Fawziya25/AGV_Project/电控代码/改动记录.md

# AGV 工程改动记录

> 工程不是 git 仓库，本文件代替提交记录。每次改完在下面按日期追加一节。
>
> 编译命令：
> ```bash
> PATH="C:/Users/Dawn/AppData/Local/stm32cube/bundles/cmake/4.3.1+st.1/bin:$PATH" \
>   "C:/Users/Dawn/AppData/Local/stm32cube/bundles/cmake/4.3.1+st.1/bin/cmake.exe" \
>   --build "d:/Projects/stm32/AGV_Project/build/Debug"
> ```

---

## 2026-09-14（晚）

编译验证：通过。FLASH 51304 B（9.79% / 512 KB），RAM 4400 B（3.36% / 128 KB）。
**以上均未上实车验证。**

### 1. CAN 等待函数统一（Emm_V5）

原来全工程有 7 处手写的等待，写法各不一样（有 5 处是 `while(can.rxFrameFlag == false){};`
死等，电机堵转就永久卡死）。统一成 3 个显式函数：

`HARDWARE/Inc/Emm_V5.h`
- `EMM_V5_ARRIVE_TMO_MS 5000`：等到位帧超时，需覆盖最长一段移动（GoStraight 1865mm@150RPM≈3s）
- `EMM_V5_ACK_TMO_MS 200`：等命令回帧超时，只用于确认命令已被电机接收
- 声明 `Emm_V5_ClearRxFrame()` / `Emm_V5_WaitArrive(tmo)` / `Emm_V5_WaitRxFrame(tmo)`

`HARDWARE/Src/Emm_V5.c`
- `Emm_V5_ClearRxFrame()`：发送命令前清掉历史回帧，保证等的是本次动作新到的帧
- `Emm_V5_WaitArrive(tmo)`：逐帧消费回帧，认 `FD 9F`（到位），1=到位 / 0=超时
- `Emm_V5_WaitRxFrame(tmo)`：保持原来"标志已置位→立即返回"的语义，加超时兜底
- **不做发送方地址校验**（`can.CAN_RxMsg.ExtId >> 8`），按需求省略

调用点替换：

| 文件 | 位置 | 换成 |
| --- | --- | --- |
| `UserCode/Src/chassis.c` | 直行 / 平移 | `ClearRxFrame()` + `WaitArrive(EMM_V5_ARRIVE_TMO_MS)` |
| `UserCode/Src/chassis.c` | 转弯 ×2 | `WaitRxFrame(EMM_V5_ACK_TMO_MS)` |
| `UserCode/Src/positionPIDcontroller.c` | 111、143 | 同上 |
| `UserCode/Src/yawPIDcontroller.c` | 374、397 | 同上 |
| `HARDWARE/Src/pick.c` | `Pick_StepperMove` | `ClearRxFrame()` + `WaitArrive(PICK_MOTOR_DONE_TMO)` |

**行为变化**：底盘直行/平移现在是真阻塞——等到位帧才返回（最长等 5s）；
原来 5 处死等有了 200ms 超时，堵转/未使能不再永久卡死。
地址 5/6（机械臂两个电机）的速度/加速度本来就是独立宏，不受影响。

### 2. 坐标宏导航移植（chassis / yawPIDcontroller）

从导入的 `chassis(1)` / `yawPIDcontroller(1)` 里把"坐标宏导航"这套搬进正式文件，然后
删掉了那两个 `(1)` 文件（另有 2 个 `(1)` 文件一并删除）。

`UserCode/Inc/chassis.h`
- 场地坐标宏块（逗号元组风格）：`#define Raw 1200, 300`，用法 `AGV_Position_Go(Raw, 0);`
  → `AGV_Position_Go(1200, 300, 0);`。只能整体当实参用，不能出现在赋值/运算里
- `Origin_X/Y`、`Vel 150`；新增 `AGV_Position_Set()` / `AGV_Position_Go()` 声明

`UserCode/Src/chassis.c`
- `AGV_Position_X/Y`：跟踪小车当前坐标，按 `AGV_Direction`（0:X+ 1:Y+ 2:X- 3:Y-）
  把 dx/dy 拆成"直行 + 平移"两段
- `AGV_Position_Set(x, y)`：重新锚定小车当前坐标
- 5 个路径函数（Depart_1 / Qcode_to_Raw / Raw_to_Rough / Rough_to_Temp / Temp_to_Raw /
  GoBack_1）改成调坐标宏；`Depart_2` / `GoBack_2` 未动（还是硬编码）

`UserCode/Src/yawPIDcontroller.c` / `.h`
- 新增 `uint8_t AGV_Direction`（初值 3），`AGV_TurnLeft` 里 `+1`、`AGV_TurnRight` 里 `+3`（模 4）
- `Yaw_MovingOffsetEnd()`：`MovingOffset = ...` 改成 `+= ...`
  （新的 Go() 每次转向之前会走两段位移，`=` 会把前一段的航向漂移丢掉；
  累加值在转弯消费时清零）

### 3. 取放顺序改成 A→B→C

原来是 C→B→A 倒序放置，改成先放 A 再 B 再 C。

- `UserCode/Src/pick_task.c` `PlaceToRing()`：索引约定改成 `0=POS_A, 1=POS_B, 2=POS_C`
- `Place_ROUGH()` 循环改成 `PlaceToRing(i, Place_Color[i])`
- `Place_TEMP()` 重排成 `POS_A / POS_B / POS_C` 顺序
- 槽位↔颜色配对关系不变（A↔`Place_Color[0]`、B↔`[1]`、C↔`[2]`），只是执行顺序反过来

### 4. 从 POS_B 取料时的绕行

**问题**：A→B→C 顺序下取 B 时，C 槽还装着料。夹着物块直接转向会扫到 C 上的物块。
根因是 `Pick_MoveTo` 是门字形——半径只发指令不等回执，同时就开始转 Z；
Z 以 0.8°/2ms 转，约 0.12s 就扫过 C 的 44°，此时半径才出去不到 1/4，必然撞。

**做法**：先将物块移到车外过渡位（半径伸出去、转过 C 的角度），再按普通门字形走到圆环。

`HARDWARE/Inc/pick.h`
- `POS_C_OUT (60.0f, 7.0f, 50.0f)`：车外过渡位。60° 已转过 C 的 44°，
  半径 50 时物块径向在 35~65，C 上的物块在半径 4 附近（-11~19），径向不重叠
- 声明 `Pick_Safe_MoveTo(float servoZ, float motorZ_mm, float motorR_mm)`

`HARDWARE/Src/pick.c`
- 新增 `Pick_Safe_MoveTo()`：**依次** 高度 → 半径 → Z 旋转，每步都等到位再走下一步
  （与 `Pick_MoveTo` 的区别就是半径"等到位"这一步）
- 新增静态 `Pick_MotorR_MoveToMM_Wait()`：带等到位的半径移动
- `Pick_MoveTo()` / `Pick_MotorR_MoveToMM_Issue()` 一行未改

`UserCode/Inc/pick_task.h`（这几个宏在下面的第 5 节里已经改成静态函数，名字见第 5 节的对照表）
- `MOVE_TO_RING_BYPASS(ring)` / `MOVE_TO_RING_HIGH_BYPASS(ring)`：
  `Pick_Safe_MoveTo POS_C_OUT;` 然后按 ring 选 `POS_x` / `POS_x_HIGE`
- `GRAB_AND_PLACE_TO_RING_EX_BYPASS(grab_pos, ring, is_high)`

调用点：只有"取 B 那一趟"用绕行版
- `PlaceToRing()` 里 `if(index == 1) MOVE_TO_RING_BYPASS(ring); else MOVE_TO_RING(ring);`
- `Place_TEMP()` 里 `GRAB_AND_PLACE_TO_RING_EX_BYPASS(POS_B, Place_Color[1], is_high);`

取 A 是反向路径（326°→230/184/138 角度递减，不经过 B、C），取 C 时 A、B 已空，
这两趟都走普通 `MOVE_TO_RING`。

耗时：绕行只多一次串行等待（高度 + 半径，合计约 0.55s），之后转向（226° 约 1.1s）
仍是单独的 Z 舵机转动，每趟总时长与非绕行路径基本一样（约 2.7s）。

### 5. 夹取逻辑的动作宏改成静态函数

`pick_task.h` 里原来有 9 个 `do{...}while(0)` 动作宏，把"移到环→夹→移到槽→松手"
这类含多次阻塞等待的动作序列藏在宏名后面：调试器没法单步进去、参数传不进函数、
`GRAB_AND_PLACE_TO_RING(grab_pos, ring)` 与 `GRAB_FROM_RING_AND_PLACE(ring, place_pos)`
参数顺序还相反。全部删掉，换成 `pick_task.c` 里的 5 个静态函数：

| 新静态函数 | 替掉的宏 |
| --- | --- |
| `GotoSlot(slot)` | 三处重复的 `switch(index)` |
| `MoveToRing(ring, high, bypass)` | `MOVE_TO_RING` / `_HIGH` / `_BYPASS` / `_HIGH_BYPASS` |
| `GrabSlotToRing(slot, ring, high)` | `GRAB_AND_PLACE_TO_RING` / `_EX` / `_EX_BYPASS` |
| `GrabRingToSlot(ring, slot)` | `GRAB_FROM_RING_AND_PLACE` |
| `GrabRawToSlot(slot, color)` | `GrabToPosition` + `Pick_RAW_PLUS` 里的 switch |

约定写进 `pick_task.h` 头注释：**槽位 slot = 0(A)/1(B)/2(C)**，与 `Place_Color[]`/`Pick_Color[]`
下标一致；**圆环 ring = 1/2/3**。绕行判断从调用点收进 `GrabSlotToRing`（`slot == 1` 自动绕行）。

调用点变成一行一件事：

```c
for (int i = 0; i < 3; i++) GrabSlotToRing(i, Place_Color[i], 0);   /* Place_ROUGH */
for (int i = 0; i < 3; i++) GrabRingToSlot(Place_Color1[i], i);     /* Pick_ROUGH  */
```

`task.c` 与底盘代码一行未动（公共函数名 `Pick_RAW`/`Place_ROUGH`/`Pick_ROUGH`/`Place_TEMP` 不变）。
编译：FLASH 50484 B（比改动前少 820 B，宏展开的重复代码没了），RAM 4400 B。

`pick.h` 里的 24 个位置宏（`POS_A` 等）**没动**——它们是"逗号元组当参数表"的写法，
`Pick_MoveTo POS_A;` 这样用是清楚的；现在 `Pick_MoveTo POS_x;` 只出现在 `GotoSlot()`/`MoveToRing()`
两个函数里，等于被隔离在一处。代价是位置不能当函数参数传（想改成
`typedef struct { float z, h, r; } PickPos;` + `Pick_Goto(&POS_A)` 的话约 50 处调用点要动，
含 `task.c`/`main.c`，暂不做）。

### 7. B 取料绕行改成两次普通 Pick_MoveTo（去掉专用函数）

用户的决定：不要专用函数，B 那一趟就是两次普通 `Pick_MoveTo`。

```c
/* pick_task.c : MoveToRing() */
if(bypass) Pick_MoveTo POS_C_OUT;   /* 先到车外过渡位 */
if(ring == 1) Pick_MoveTo POS_1;    /* 再到目标圆环 */
...
```

删掉的东西：
- `HARDWARE/Src/pick.c` 的 `Pick_Safe_MoveTo()`（"高度→半径→转向，每步等到位"那版）
- `HARDWARE/Src/pick.c` 的 `static Pick_MotorR_MoveToMM_Wait()`（带等到位的半径移动）
- `HARDWARE/Inc/pick.h` 里 `Pick_Safe_MoveTo()` 的声明

**注意两点**（改完的行为）：
1. 半径从此**没有任何等待**：`Pick_MoveTo` 走门字形，半径只发指令不等，同时就转 Z。
   `POS_C_OUT` 的"先伸半径再转向"语义没了 —— 转向开始时半径还没伸出去。
   实车若在绕行时扫到 C 槽的物块，就得回到"半径等到位再转"的做法。
2. 第 6 节那套"按运动时间估算超时"(`Pick_MoveTimeMs` + 三个裕量宏)已经被移除，
   `Pick_StepperMove()` 又用回固定的 `PICK_MOTOR_DONE_TMO 2500ms`。
   高度电机(5 号)回帧正常，帧一到就返回，所以实际不会等满；
   6 号半径电机不回帧这件事现在不影响主流程（半径不再等人）。

编译：FLASH 50240 B、RAM 4400 B。

---

## 2026-09-15 —— 修「放到 A 位时不下降、超时后放下」

> **本节改动已被用户整体回退（2026-09-16）**：下面提到的 `Pick_WaitArrive()`、超时重试、
> 四个诊断变量、`pick_motorZPos` 的"只有真到位才推进"在当前代码里都不存在了。
> 本节仅作分析记录保留，别照它去核代码。

**症状**：每次 `Pick_MoveTo POS_A`（326°, 31mm, 4mm），臂停在安全高度不下降，
烧掉 `PICK_MOTOR_DONE_TMO 2500ms` 超时后夹爪松开；B/C 正常。

**已排除**（代码层面）：A/B/C 三个宏的高度/半径完全一样（31mm / 4mm），
高度这一路的脉冲数、方向、速度、加速度字节也完全一样，
所以不是"高度代码对 A 特殊"，是 A 的**姿态**(326° 是整个程序里最大的角度，
且 A 永远是正向转过去)把某一步弄坏了。

**改动**（`HARDWARE/Src/pick.c`，正常路径不增加任何耗时）：

1. 新增 `static uint8_t Pick_WaitArrive(tmo)`，替代直接调 `Emm_V5_WaitArrive()`：
   同样是逐帧消费、**不校验地址**（没动 Emm_V5.c，四轮不受影响），
   区别是把三种回帧分开：`0xFD 0x9F`=到位 / `0xFD 0xE2`=电机拒收本命令 / 超时。
2. `Pick_StepperMove()` 返回值从"本次脉冲数"改成等待结果；**只有在被拒(0xE2)时
   隔 `PICK_RETRY_GAP_MS 50ms` 原样重发一次**。被拒说明电机没动，重发不会走过头；
   超时**不**重发 —— 相对位置模式(raF=2)下无法判断电机到底走没走，盲目重发会多走一段。
3. `Pick_MotorZ_MoveToMM()`：**只有真到位才推进 `pick_motorZPos`**。
   原来不管到没到位都写目标值，A 位超时一次跟踪值就偏 24mm
   （MCU 以为在 31mm、实际停在 7mm），下一步"升到安全高度"会多顶 24mm 撞上限，
   又是一次 2.5s 超时 —— 这是让症状"每次都出现"的放大器。
   改完 A 这一趟失败不会污染后面的 B/C。
4. 新增诊断变量（`pick.c` 定义 / `pick.h` 声明）：
   `Pick_Diag_RejectCnt`（被拒次数）、`Pick_Diag_TimeoutCnt`（超时次数）、
   `Pick_Diag_LastRx0/1`（最近一帧前两字节，正常=Fd 9F）、`Pick_Diag_LastAddr`（回帧电机地址）。
   调试器 watch 或 OLED 显示，跑一趟就能判断属于哪一类：
   - 被拒计数↑ → 命令发下去时电机还在上一次运动里（时序问题，重发已兜住）
   - 超时↑ 且回帧是 `FD 02` → 命令被接收了但没走到位 → 机械卡住/负载大
   - 超时↑ 且完全没有回帧 → 命令没到电机 → CAN 丢帧 / 供电瞬时跌落
     （326° 上 Z 舵机顶住时堵转电流拉低 5V 是重点怀疑对象）

编译：FLASH 50516 B、RAM 4408 B。

**未实车验证。**

**下一步实车测**：跑一趟 `Pick_ROUGH`/`Pick_RAW`，看上面 4 个变量。
若"超时↑ 且回帧 FD 02" → 是机械/负载问题，量一下 326° 处 Z 舵机是不是顶住了；
若"被拒计数↑ 但 A 降下去了" → 就是时序，本节的改动已经修好。

---

## 2026-09-16 —— pick_task.h 宏恢复、A 槽过渡位、暂存区码垛映射、取料顺序 A→B→C

本节四件事都做在 `UserCode/Src/pick_task.c` / `UserCode/Inc/pick_task.h` /
`HARDWARE/Inc/pick.h` 上，是 9-14 那套静态函数重构**回退之后**、在宏版本上做的。

### 1. `pick_task.h` 宏块恢复（编译修复）

回退时 `pick_task.h` 退多了一代：只剩函数声明，`MOVE_TO_RING` / `MOVE_TO_RING_HIGH` /
`GRAB_AND_PLACE_TO_RING` / `GRAB_AND_PLACE_TO_RING_EX` / `GRAB_FROM_RING_AND_PLACE`
五个宏没了，而 `pick_task.c` 还在用 → `implicit declaration of function 'MOVE_TO_RING'`。
从文件历史 v6 原样恢复这 5 个宏，`pick_task.c` 没动，编译通过。

### 2. A 槽取料的车外过渡位 `POS_A_OUT`

`pick.h` 新增 `#define POS_A_OUT (30.0f, 7.0f, 58.0f)`（30° / 7mm / 半径 58mm）：
A 槽在 4°，转去圆环(138~230°)要经过 B 槽(44°)，先把半径伸到车外再转，避开 B 槽。
只在"从 A 拿"那一趟多插一句，A 之外的 B/C 两趟完全不变：

- `PlaceToRing()`（`Place_ROUGH` 用）：`if(index == 2) { Pick_MoveTo POS_A_OUT; HAL_Delay(1000); }`
- `Place_TEMP()`：A 那趟**长写**（宏里插不进这一句，所以没走 `GRAB_AND_PLACE_TO_RING_EX`）：
  `Pick_MoveTo POS_A; Pick_Gripper_Grab(); Pick_MoveTo POS_A_OUT; HAL_Delay(1000); ...`
  —— 以后改 `GRAB_AND_PLACE_TO_RING_EX` 时别忘了这处不同步。

### 3. 暂存区第二轮：按第一轮「颜色→环位」同色同环码垛

第二轮 `Place_TEMP` 的环号不再用第二轮任务码 `Place_Color2[]`，改成按颜色反查第一轮
（例：第一轮 4 号色放在 2 号环 → 第二轮 4 号色也放 2 号环的高位）：

```c
static uint8_t Place_RingSameAsLastRound(uint8_t slot)   /* pick_task.c 里的静态小函数 */
{
    for (uint8_t j = 0; j < 3; j++)
        if (Pick_Color1[j] == Pick_Color2[slot]) return Place_Color1[j];
    return Place_Color2[slot];      /* 兜底：两轮颜色种类一致，正常不会到 */
}
/* Place_TEMP 里 */
uint8_t ring_reuse[3];
for (int i = 0; i < 3; i++) ring_reuse[i] = Place_RingSameAsLastRound(i);
uint8_t *Place_Color = (RerunFlag == 0) ? Place_Color1 : ring_reuse;
```

第一轮那支路不变；高位仍由已有的 `is_high = (RerunFlag == 1)` 管，没动；
三趟放置的调用一行没改。`Place_ROUGH`（粗加工区）第二轮照旧用 `Place_Color2`，**按用户要求不动**。
前提：两轮任务码的颜色种类一致（用户确认），且每轮三色互不相同 → `ring_reuse` 必是 1/2/3
的一个排列，不会两块物块抢同一个环。

### 4. `Place_ROUGH` / `Place_TEMP` 取料顺序改回 A→B→C

原来是 C→B→A（`Place_Color[2-i]`）。现在：

```c
/* Place_ROUGH：只有 PlaceToRing 的 index 带 2-i（2=A,1=B,0=C），环号下标 i 始终是槽位下标 */
for (int i = 0; i < 3; i++) {
    PlaceToRing(2 - i, Place_Color[i]);
}
/* Place_TEMP：A 那趟(带 POS_A_OUT)提到最前，然后 B、C */
```

配对是"槽位下标 i ↔ `Place_Color[i]`"（与 `Pick_ROUGH` / `Place_TEMP` / `Pick_Color[]` 同一套约定），
A→B→C 的遍历顺序等于把原代码 `PlaceToRing(i, Place_Color[2-i])` 里的 `2-i` 从环号挪到 index 上。
第 3 节的匹配按下标取，不受影响；每个环只落一块，环上的叠放结果与顺序无关。

> **中途返工（当天）**：第一次改时把 `2-i` 用在了环号上（`PlaceToRing(slot, Place_Color[slot])`），
> 等于 A 槽配到 `Place_Color[2]`、C 槽配到 `Place_Color[0]`，A/C 互换 —— 实车表现为
> "一次 place 再一次 pick 之后，物块装进了对方的槽位"。已改回上式，`Pick_ROUGH` 未动。

编译：FLASH 51124 B、RAM 4400 B（比上一条大是因为 `task.c` 的 `STANDALONE_TEST`
已由用户改成 0、整个状态机编入，与本节改动无关）。

**未实车验证。**

### 遗留（本次看到但没动）

- ~~`Pick_ROUGH()` 写死用 `Place_Color1[]` 当环号~~ —— **已修（2026-09-18）**，见下节。
- 反方向（`Pick_ROUGH` 从圆环放回 A 槽）同样要经过 B 槽(44°)，没加过渡位。

---

## 2026-09-18 —— `Pick_ROUGH` 按轮次选数组（修第二轮暂存区不同色）

只改 `UserCode/Src/pick_task.c` 的 `Pick_ROUGH()` 一个函数体。

### 问题链条

第二轮（`RerunFlag == 1`）三个函数用的数组原本是：

| 步骤 | 数组 | 说明 |
| --- | --- | --- |
| `Pick_RAW` | `Pick_Color2` ✓ | 槽 i = `Pick_Color2[i]`（本来就是按轮次选的） |
| `Place_ROUGH` | `Place_Color2` ✓ | 槽 j 的料 → 环 `Place_Color2[j]` |
| **`Pick_ROUGH`** | **`Place_Color1` ✗** | 环 `Place_Color1[i]` → 槽 i |
| `Place_TEMP` | `ring_reuse[i]` =「颜色 `Pick_Color2[i]` 第一轮在哪个环」 | 前提是槽 i 里真是 `Pick_Color2[i]` |

`Pick_ROUGH` 这一环错位以后，槽里的**颜色被置换**：两轮的放置数字都是 1/2/3 的一个排列时，
三个环仍都会被取空（不会夹空、也没环剩下料），但颜色和槽位对不上，
于是 `Place_TEMP` 按"槽 i 是 `Pick_Color2[i]`"算出来的 `ring_reuse[i]` 就是错的
→ 第二轮码垛和第一轮**不同色同环**。

举例（`Pick_Color1={4,5,6}`、`Place_Color1={2,3,1}`；`Pick_Color2={6,4,5}`、`Place_Color2={1,2,3}`）：
第二轮 `Place_ROUGH` 是 A 槽 6 号→环1、B 槽 4 号→环2、C 槽 5 号→环3，
可 `Pick_ROUGH` 取的是 环2→A、环3→B、环1→C，结果 A 槽拿到 4 号、B 槽 5 号、C 槽 6 号。
接着 `Place_TEMP` 让 A 槽去环1高位（6 号第一轮的位置），可 A 槽手里是 4 号
→ 放到环1，而第一轮 4 号在环2，**同色同环失败**。

### 改动

```c
void Pick_ROUGH(void)
{
    extern uint8_t Place_Color1[3];
    extern uint8_t Place_Color2[3];
    extern uint8_t RerunFlag;
    uint8_t *Place_Color = (RerunFlag == 0) ? Place_Color1 : Place_Color2;

    GRAB_FROM_RING_AND_PLACE(Place_Color[0], POS_A);
    GRAB_FROM_RING_AND_PLACE(Place_Color[1], POS_B);
    GRAB_FROM_RING_AND_PLACE(Place_Color[2], POS_C);

    Pick_MoveTo POS_RUN;
}
```

和 `Place_ROUGH` 同一套三目写法——"放置用哪个数组、拾取就用哪个数组"是取放配对的**不变量**
（一次 place + 一次 pick 后槽位内容不变，才谈得上后面按颜色同环码垛）。
配对（环 `Place_Color[i]` ↔ 槽 i）与遍历顺序（A→B→C）都没变；第一轮 `RerunFlag==0`
走 `Place_Color1`，行为与改前完全一致；`STANDALONE_TEST==1` 那条测试路径 `RerunFlag=0` 也不受影响。

改完链条闭合：第二轮 `Pick_ROUGH` 取环 `Place_Color2[i]` → 槽 i 重新等于 `Pick_Color2[i]` →
`Place_TEMP` 查到的就是槽里真实的颜色 → 同色同环、高位。

编译：FLASH 51192 B（改前 51124 B，多 68 B，是多进来一个 `Place_Color2` 的外部引用和一次三目），
RAM 4400 B。

**未实车验证。**

---

## 2026-09-18（二）—— 视觉等待窗口改成只卡 y 下界

改 `UserCode/Src/camera.c`（+ `camera.h` 注释）。**判稳逻辑一行没动**：盒子/穿盒/QUIET/
超时、`requireMotion` 的"先看到在动再停稳"边沿语义都原样，只有"接近可抓区"窗口的条件变了。

### 改动

原来是 `|dx|,|dy| <= 45` 的对称方框（`CAM_NEAR_WIN_PX 45`），现在按用户要求
改成**单边**：只要 `target_dy > -55`，**dx 不再限制**。

`camera.c`
- `#define CAM_NEAR_WIN_PX 45` → `#define CAM_NEAR_WIN_Y_MIN (-55)`
- `Cam_WaitSettle()` 第一个参数从 `int16_t winPx`（0=不限位置）改成 `uint8_t nearWin`
  （1=用上面那个窗口），判断从四边比较变成一句：

```c
if(nearWin && target_dy <= CAM_NEAR_WIN_Y_MIN)   /* 还在窗下界之外 → 不算稳, 等它进窗 */
{
    quietSince = HAL_GetTick();
    continue;
}
```

- 三个调用点：`WaitForStill(0,1)`（不变）、`WaitForMoveNearStill(1,1)`、`WaitForNearStill(1,0)`
  —— 后两个（`Pick_RAW` 和 `GrabToPosition` 用的）窗口一致。

`camera.h`：两个函数的注释从"落在中央窗口内"改成"y 进窗(target_dy > CAM_NEAR_WIN_Y_MIN)"。

### 副作用（有意为之 / 需留意）

- 抓取前那一步**不再要求 x 居中**。`Pick_RAW_PLUS`（pick_task.c:99-101）本来就是拿 `target_dx`
  的正负选 `POS_RAW` / `POS_RAW_LEFT` / `POS_RAW_RIGHT`，x 不限制与那套分支是一致的。
- `GrabToPosition()`（pick_task.c:15-30）在这之后直接去 `POS_RAW` 抓，没有按 dx 分支，
  x 偏差大时靠机械容差兜；如果实车发现偏着抓不到，说明这里要补和 `Pick_RAW_PLUS` 一样的分支。
- `target_dy == -999`（无目标）在进窗口判断之前就被"目标丢失"那一支处理掉了，不受影响。

编译：FLASH 51140 B（比上一条少 52 B，窗口判断从四条比较缩成一条），RAM 4400 B。

**未实车验证。**

---

## 2026-09-18（三）—— 重写 `Pick_RAW_PLUS`：修正基准改成"追第一块从运动到静止的物块"

只改 `UserCode/Src/pick_task.c`（`camera.c` / `camera.h` / `pick_task.h` / `pick.*` /
`task.c` 一行未动，也没加 include —— `Pick_RAW_PLUS` 的声明本来就在 `pick_task.h:71`）。

### 为什么改

`Pick_RAW`（当前主流程用的）**固定切到 `Pick_Color[2]`** 再等它"进窗+停稳"才修正：
那块要是没进窗，`Cam_WaitForMoveNearStill` 会白等（内部 30s 超时）。PLUS 的思路是
**不看颜色**，追"视野里第一块从运动到静止的物块"来做那一次位置修正 —— 反正三块料都
由同一个转盘送到同一个抓取位，用哪块做的修正等价。

### 修正阶段（两部分）

```c
t_start = now;
步骤1(快路径): target = ScanNearestColor();           /* 问一次"现在最近的是哪一色" */
              SwitchTo(target) 成功 → TrackOneColor()
                == TRK_ARRIVED → AGV_Correct() → corrected = target
步骤2(兜底):   while (没修正 && now - t_start < PICK_ARRIVE_TMO_MS) {
                   target = WaitNearestChange(target);   /* 反复扫描, 等"最近色换人" */
                   SwitchTo(target); TrackStillInWindow();  /* 新色只判"进窗+静止" */
                   成立 → AGV_Correct() → corrected = target
               }
```

- **步骤1 的判据是"边沿"**：必须"看到过在动 → 连续 300ms 没再动 → 且 `dy > -58`"才算到站
  （`TRK_ARRIVED`）。看到在动却 `dy` 掉出窗口区 = 出窗跟丢了（`TRK_LEFT_WINDOW`）；
  进来 400ms 一次都没动 = 本来就静止的旧料（`TRK_WAS_STILL`）→ 两者都进步骤2 换下一块。
- **步骤2 的新色只判稳态**（`TrackStillInWindow`，等于 camera.c 的 `Cam_WaitForNearStill`：
  "窗口区内 + 连续静置 300ms"，**不要求先看到运动**）——因为它可能已经停好了，
  要求运动边沿会让它白等，这是本次专门按用户要求做的区分。
- **总预算 `PICK_ARRIVE_TMO_MS 20000` 是硬超时**：三个等待循环（`WaitNearestChange` /
  `TrackOneColor` / `TrackStillInWindow`）都带同一个 deadline，到点必退 —— 所以没有直接
  用 `Cam_WaitForNearStill()`（它内部自带 30s 且不可打断，会把 20s 预算顶穿）。
  到点没修成也照常进抓取阶段，每块由 `GrabToPosition` 自己等。

### 抓取阶段

顺序仍是按任务码 `Pick_Color[0]→[1]→[2]` 放进 A/B/C 槽。唯一的区别：**若修正用的
正是 `Pick_Color[0]`，它此刻就在窗内静止 → 直接 `POS_RAW` 抓**，不再回观察位等一次；
其余每一块都走现成的 `GrabToPosition(i, Pick_Color[i])`（一行未改）。
老 PLUS 里那套按 `target_dx` 选 `POS_RAW`/`POS_RAW_LEFT`/`POS_RAW_RIGHT` 的分支**去掉**了
（`AGV_Correct` 的退出判据是连续 4 拍 `|dx|,|dy| <= 1px`，修完 dx 已经≈0）。

### 新增（都是 `pick_task.c` 文件内的 static，不导出）

| 名字 | 作用 |
| --- | --- |
| `Pick_Color_List()` | 返回本轮 `Pick_Color1/2` 指针（省掉 4 处 `RerunFlag` 三目） |
| `ScanNearestColor()` | 扫一次三色，返回"最近的色号"或 `PICK_COLOR_NONE` |
| `WaitNearestChange(cur, t_start)` | 反复扫描直到"有效色且 != cur" |
| `TrackOneColor(t_start)` | 追踪当前色，返回 `TRK_ARRIVED`/`TRK_LEFT_WINDOW`/`TRK_WAS_STILL` |
| `TrackStillInWindow(t_start)` | 等"当前色进窗+静止"（只判稳态），带 deadline |

文件内新宏：`PICK_ARRIVE_TMO_MS 20000` / `PICK_TRACK_TMO_MS 3000` /
`PICK_TRACK_STILLOBS_MS 400` / `PICK_TRACK_SCAN_GAP_MS 100` / `PICK_TRACK_BOX_PX 2` /
`PICK_TRACK_QUIET_MS 300` / `PICK_WIN_Y_MIN (-58)` / `PICK_COLOR_NONE` / 三个 `TRK_*`。
`PICK_TRACK_BOX_PX`、`PICK_TRACK_QUIET_MS`、`PICK_WIN_Y_MIN` 与 camera.c 里的
`CAM_STILL_BOX_PX`、`CAM_STILL_QUIET_MS`、`CAM_NEAR_WIN_Y_MIN` **取同值**
（那几个宏是 camera.c 文件内的，这里用不到），**改一边要同步另一边**。

### 几个刻意为之的坑（别当成 bug 改掉）

1. `ScanNearestColor()` 扫之前**先清 `Cam_RxFlag`，扫完还是 0 就返回"没料"** ——
   `Cam_SwitchCloseColor()` 在"三色全切换失败"时会提前返回（不做最后那次切换），
   此时 `openmv_cmd` 和 `target_dx/dy` 都是**冻结的旧值**，看着完全合法。
2. **三色都不可见时 `Cam_SwitchCloseColor()` 仍会切到 `Pick_Color[0]` 并回显它**，
   所以"回显色 0"有歧义，只有 `target_dy == -999` 能识破 → 这一步不能省。
3. `TrackOneColor` 里"出窗"的判据是 **`wasInWin && dy <= -58`**（进过窗又出去）。
   只写 `dy <= -58` 会把"从窗外正在进窗"的物块误判成出窗。
4. 停在窗口区**之外**的物块不算到站，会走满 `PICK_TRACK_TMO_MS 3000` 后按"跟丢"换新色。

### 顺带

`Cam_WaitForStill()`（只判稳态、不限位置）原本只有老 `Pick_RAW_PLUS` 调用，
现在无人调用 → 被 `--gc-sections` 回收，`camera.c` 里函数本体保留、未删。

编译：FLASH 51132 B（改前 51140 B，反而少 8 B —— 新代码多，但 `Cam_WaitForStill`
被回收 + 老 PLUS 的 `POS_RAW_LEFT/RIGHT` 分支没了）、RAM 4400 B。无警告。

**未实车验证。** 实车重点看：`ScanNearestColor` 返回的色号和 OLED 上 `openmv_cmd`
是否一致；`TRK_ARRIVED`/`TRK_WAS_STILL` 哪一条常触发（决定要不要调
`PICK_TRACK_STILLOBS_MS`）；转盘一个停顿窗口有多长（决定 20s 够不够、扫描一遍
~0.3s 的节奏跟不跟得上）。

---

## 2026-09-18（四）—— `HWT101_ManualCal()` 加 OLED 倒计时、时长 40s 改回 20s

文件：`HARDWARE/Src/hwt101.c`（另加 `#include "oled.h"`）。

### 原来的三个问题

```c
HAL_Delay(20000);
for(int i=0;i<20;i++)
{
    HAL_Delay(1000);
    OLED_ShowString(0, 0, "%d",  "零偏校准中...",i);
}
```

1. **参数错位**：`OLED_ShowString(u8 x, u8 y, u8 *chr, u8 size1, u8 mode)`。
   上面把 `"%d"` 当字符串、把汉字指针截成 `size1`、把 `i` 当 `mode`。
2. **没有刷新**：`OLED_ShowString` 只写 `OLED_GRAM` 显存，必须配 `OLED_Refresh()`
   才推到屏上；另外 `OLED_ShowString` 内部按 `*chr>=' ' && *chr<='~'` 过滤，
   **画不了汉字**（要汉字得用 `OLED_ShowChinese(字模序号)`）。
3. **时长是 40s**：`HAL_Delay(20000)` + `20×HAL_Delay(1000)`，比标定窗口多一倍。

### 改动

新增文件内宏 `HWT101_MANCAL_SEC 20U`，函数体改成：

```c
ZeroBias_Start();
HWT101_ManualCalStart();

OLED_Clear();
OLED_ShowString(0, 0, (uint8_t *)"Calibrating", 16, 1);
/* 16号字宽8px, 两位数字共16px, 居中放在第2行: x=(128-16)/2=56 */
for(uint8_t sec = HWT101_MANCAL_SEC; sec > 0U; sec--)
{
    OLED_ShowNum(56, 16, (uint32_t)sec, 2U, 16U, 1);
    OLED_Refresh();
    HAL_Delay(1000);
}
OLED_ShowNum(56, 16, 0U, 2U, 16U, 1);   /* 收尾显示 00, 表示窗口走完 */
OLED_Refresh();

HWT101_ManualCalStop();
ZeroBias_End();
```

- 第 1 行 `Calibrating`，第 2 行居中两位倒计时 20→01，结束显示 `00`。
- 静态字只画一次、每秒只重画数字，不用整屏 `OLED_Clear`（否则每秒闪一次）。
- `ZeroBias_Start/ManualCalStart` 在最前、`ManualCalStop/ZeroBias_End` 在最后不变；
  窗口 20s 在 100Hz 下约 2000 个样本，远超 `ZB_MIN_SAMPLES`。
- `OLED_Refresh()` 是软件 I2C 推 1KB，本身几十毫秒，所以这 20 秒实际会略长一点，
  对零偏窗口无害。
- 调用时机没问题：`AGV_Init()` 里 `OLED_Init()` 在最前，`HWT101_Init()` 在其后。

编译：FLASH 53008 B（10.11%）、RAM 4400 B，无警告。
（比上次 51132 B 大，主要因为 `task.c:95` 已经改成调 `Pick_RAW_PLUS()`，
PLUS 整块代码被链进来了。）

**未实车验证。**

---

## 2026-09-18（五）—— `AGV_QRcode_WaitForScan()` 加 15s 倒计时 + 保底串

文件：`HARDWARE/Src/QRcode.c`（只改这一个函数 + 顶部两个宏/常量，`QRcode_Task()` 没动）。

### 为什么

原来 `HAL_UART_Receive(&huart2, QRcode_Buffer, 15, HAL_MAX_DELAY)` 是**无限等**：
扫码枪没响应（没插、没对上、纸面脏）时主流程就永远卡在这一句，后面全部不动。
另外一次要 15 字节也没法"等一半就走人"。

### 改动

```c
#define QRC_WAIT_SEC  15U
static const uint8_t QRC_FALLBACK[16] = "123+123+123+123";
```

`AGV_QRcode_WaitForScan()` 改成逐字节收 + 每秒倒计时：

```c
for(uint8_t sec = QRC_WAIT_SEC; (sec > 0U) && (got < 15U); sec--)
{
    OLED_ShowString(0, 0, (uint8_t *)"Scan QR...", 16, 1);
    OLED_ShowNum(0, 16, (uint32_t)sec, 2U, 16U, 1);
    OLED_Refresh();

    uint32_t tSec = HAL_GetTick();
    while(((HAL_GetTick() - tSec) < 1000U) && (got < 15U))
    {
        uint32_t left = 1000U - (HAL_GetTick() - tSec);
        if(left == 0U) break;
        if(HAL_UART_Receive(&huart2, &QRcode_Buffer[got], 1U, left) == HAL_OK) got++;
    }
}
if(got < 15U) { /* 整串换成 QRC_FALLBACK */ }
QRcode_Buffer[15] = '\0';
QRcode_ParseResult();
```

- **逐字节**收而不是一次要 15 字节：这样"收到几字节"明确，秒到点能干净退出；
  收全 15 字节立刻返回，不用等满 15 秒。
- 第 1 行 `Scan QR...`，第 2 行两位倒计时 15→01；结果用 32 号字打在 y=0/y=32，
  正好整行盖掉倒计时，不会留残字。
- **超时/只收到半截**（`got < 15`）→ 整串换成保底串，再照常解析 → 四个数组都是 `{1,2,3}`，
  后面流程一定拿得到值。分隔符解析时本来就不校验（只按下标 0-2/4-6/8-10/12-14 取值），
  所以 `+` 和 `,` 等效。保底内容取 123 循环，OLED 上一眼能认出。
- 本工程 HAL 的 `HAL_UART_Receive` 不做 ORE 检查、超时后 `RxState` 回 `READY`，
  所以可以安全地反复用短超时调用。
- 已知盲区：`OLED_Refresh()` 是软件 I2C 推 1KB，每秒有几十毫秒没在收串口；
  这期间若正好来数据会少收几个字节 → 归到"半截"分支 → 用保底串，不会解析出错值。
  原代码没有这个盲区（一直挂着收），但代价是无限死等。

编译：FLASH 53224 B（10.15%）、RAM 4400 B，无警告。**未实车验证。**

---

## 2026-09-18（六）—— 窗口判据从「y > -58」改成「|y| < 55」

文件：`UserCode/Src/pick_task.c`、`UserCode/Src/camera.c`、`UserCode/Inc/camera.h`。

### 改动

原来是"只卡 y 下界"：`target_dy > -58`（dx 不限）。现在改成对称带：`|target_dy| < 55`，dx 仍不限。

宏改名成"半宽"语义，并加一个判据宏（4 个比较点不再各写一遍）：

| 文件 | 旧 | 新 |
|---|---|---|
| `pick_task.c:97` | `PICK_WIN_Y_MIN (-58)` | `PICK_WIN_HALF_PX 55` + `PICK_IN_WIN(dy)` |
| `camera.c:183` | `CAM_NEAR_WIN_Y_MIN (-58)` | `CAM_NEAR_WIN_PX 55` + `CAM_IN_WIN(dy)` |

```c
#define PICK_WIN_HALF_PX   55
#define PICK_IN_WIN(dy)  (((dy) > -PICK_WIN_HALF_PX) && ((dy) < PICK_WIN_HALF_PX))
```

替换的 4 处判据（`pick_task.c`）：

```c
TrackOneColor:
  if(PICK_IN_WIN(target_dy)) wasInWin = 1;                    /* 原 dy > -58 */
  if(wasInWin && !PICK_IN_WIN(target_dy)) return TRK_LEFT_WINDOW;   /* 原 dy <= -58 */
  if(sawMotion && PICK_IN_WIN(target_dy) && quiet >= QUIET) return TRK_ARRIVED;
TrackStillInWindow:
  if(PICK_IN_WIN(target_dy) && quiet >= QUIET) return 1;
```

`camera.c` 的 `Cam_WaitSettle()` 同步改成 `if(nearWin && !CAM_IN_WIN(target_dy))`，
`camera.h` 的注释跟着改。两个文件的阈值仍然取同值，`pick_task.c` 顶部注释里的对应关系
已更新为 `PICK_WIN_HALF_PX <-> CAM_NEAR_WIN_PX` —— **改一处要同步改另一处**。

### 行为变化（要留意的）

1. **上界从"无限"变成 55**：以前 `dy = 200`（物块在画面下方很远）也算到站，
   现在 `dy >= 55` 一律不算 → 修正的触发点被压到画面竖直中段 ±55px 内。
   更严格，但"20s 内一直没等到 |dy| < 55"的概率上升 → 更容易走 `PICK_ARRIVE_TMO_MS` 超时。
2. **`TRK_LEFT_WINDOW`（情况B 出窗跟丢）现在两个方向都会触发**：以前只在 dy 往下掉出
   窗时触发，现在物块往画面下方或上方离开 ±55 都算 → 会更早换色重新追。
3. `dx` 依旧不参与判断，左右偏差照旧交给 `AGV_Correct()` 闭环。

编译：FLASH 52960 B（10.10%）、RAM 4400 B，无警告。**未实车验证**，实车重点看第 1 条超时率。

---

## 2026-10-03 —— 扫码枪从 USART2 换到 USART3(PB10/PB11)

文件：`STM32F407_CAN_CMD.ioc`、`Core/Src/usart.c`、`Core/Inc/usart.h`、`Core/Src/main.c`、
`HARDWARE/Src/QRcode.c`。

### 本次串口分工

| 串口 | 用途 | 引脚 | 波特率 |
|---|---|---|---|
| USART1 | OpenMV 视觉 | PA9 / PA10 | 9600 |
| **USART3** | **二维码扫码枪（本次迁入）** | **PB10(TX) / PB11(RX)** | **9600** |
| UART4 | 预留（后续可能给雷达） | PC10(TX) / PC11(RX) | 115200 |
| UART5 | HWT101 陀螺仪 | PC12(TX) / PD2(RX) | 115200 |
| USART2 | 未使用（仍保留 enabled） | PA2 / PA3 | 9600 |

### 改动

前 4 项（.ioc / usart.c / usart.h / main.c）已由 **CubeMX 重新生成**完成：
USART3 与 UART4 加入 `Mcu.IP` 列表，`main.c` 末尾追加了
`MX_UART4_Init()`、`MX_USART3_UART_Init()` 两个调用，`usart.c` 里
`HAL_UART_MspInit` / `MspDeInit` 也生成了对应分支（USART3 = PB10/PB11，
`GPIO_AF7_USART3`；UART4 = PC10/PC11，`GPIO_AF8_UART4`，两个脚都在 GPIOC，
PA1 已腾出）。

> UART4 的引脚当天又改过一次：CubeMX 里从 **PA1(RX)/PC10(TX)** 改成
> **PC10(TX)/PC11(RX)**，同时把 UART4/USART3 补进了
> `ProjectManager.functionlistsort`（之前是 CubeMX 自动追加到 `main.c` 末尾的）。

手工改的只有扫码驱动 `HARDWARE/Src/QRcode.c` 的两处句柄：

| 位置 | 旧 | 新 |
|---|---|---|
| `AGV_QRcode_StartScan()` | `HAL_UART_Transmit(&huart2, ...)` | `HAL_UART_Transmit(&huart3, ...)` |
| `AGV_QRcode_WaitForScan()` | `HAL_UART_Receive(&huart2, ...)` | `HAL_UART_Receive(&huart3, ...)` |

`QRcode.c` 是阻塞轮询收发（一发一收各一处），不涉及 DMA/中断，所以 USART3
只配了 GPIO + 时钟就能用，不需要 NVIC 配置。

顺手修正了 `AGV_QRcode_WaitForScan()` 里一句与实际不符的注释：原写
"115200下字节间隔约87us"，实际波特率是 9600 → 改成"约1ms"。
结论不变（仍然远大于取 tick 的几十us开销，不会漏字节），只是注释对上事实。

### 行为变化（要留意的）

1. **USART2 仍处于 enabled 状态**：.ioc 里没删，PA2/PA3 依旧被配成 USART2 的
   AF 引脚并初始化。如果硬件上 PA2/PA3 要接别的东西，需要在 CubeMX 里把
   USART2 关掉（本次未动，因为不确定是否有意保留）。
2. **UART4 只是"占用引脚占位"**：已生成初始化代码并被 `main.c` 调用，
   但工程里没有任何读写它的代码，雷达接上去之前就是个空跑的外设。
3. 串口分工变了，**接线要跟着换**：扫码枪信号线从 PA2/PA3 挪到 PB10/PB11。

编译：FLASH 55132 B（10.52%）、RAM 4832 B，无警告。
（比上一节大是因为多编进了 UART4 + USART3 两个外设。）**未实车验证。**

---

## 2026-10-03 —— 视觉通信换成二进制定长帧协议（只改收发层，流程待定）

文件：`UserCode/Src/camera.c`、`UserCode/Inc/camera.h`、`UserCode/Src/pick_task.c`、
`UserCode/Src/positionPIDcontroller.c`。

### 新协议

帧格式 `AA <cmd> <payload...> BB`，**定长**，靠命令码查帧长切帧。

电控 → 相机：

| 命令 | 帧 | 含义 |
|---|---|---|
| `0x00` | `AA 00 BB` | 空闲 |
| `0x01` | `AA 01 c1 c2 c3 BB` | 下发任务码（任务码前三个数字） |
| `0x02` | `AA 02 BB` | 请求圆盘中心偏差 |
| `0x03` | `AA 03 BB` | 请求三框内颜色 |
| `0x04` | `AA 04 BB` | 请求圆环 |

相机 → 电控（循环回，`flag=0` 未完成 / `flag!=0` 完成）：

| 命令 | 帧 | 完成判据 |
|---|---|---|
| `0x00` | `AA 00 flag BB` | flag 随意 |
| `0x01` | `AA 01 flag BB` | `flag=1` 任务码已收 |
| `0x02` | `AA 02 flag dxH dxL dyH dyL BB` | `flag=1` 圆盘中心已识别 |
| `0x03` | `AA 03 flag c1 c2 c3 BB` | `flag=1` 三框从无到有 |
| `0x04` | `AA 04 flag dxH dxL dyH dyL BB` | `flag=圆环编号(1/2/3)`，0=未识别 |

`dx/dy` 为**有符号 int16、高字节在前**。

### 解析结果变量（新旧合并成一套）

原来的 `target_dx` / `target_dy` / `openmv_cmd` / `Cam_RxFlag` 与一堆 `Cam_Last*`、
`Cam_Done*` 全部废弃，统一成：

| 变量 | 含义 |
|---|---|
| `dx`, `dy` | 最近一帧偏差(px)，初值 **0**；仅 0x02/0x04 帧更新。**没有"无效值"哨兵** —— 有没有识别到目标一律看 `cam_flag` |
| `cam_flag` | 最近一帧的 flag 字段（0x04 时即圆环编号） |
| `cam_mode` | 最近一帧的命令码，0xFF = 还没收到过帧 |
| `cam_receive_flag` | 1 = 有帧待读，读取方清零（相当于旧的 `Cam_RxFlag`） |
| `box_color[3]` | 0x03 回报的三个框内颜色 |

`cam_start` 保留不变（`menu.c` 在用）。

### camera.c 的重写要点

1. **解析器重写**：删掉逗号分隔 ASCII 的 `Cam_ParseData()`，换成定长帧状态机。
   新增 `RxAcc[]` 字节流累积缓冲 —— 空闲中断一次可能只收到半帧、也可能一次收到
   好几帧，必须累积后切分（旧协议把整批当一个完整帧，二进制下会错位）。
   失步（非帧头 / 未知命令码 / 帧尾不符）时**只丢 1 字节**再重找，这样噪声里的
   `0xAA` 也能被跳过。
2. **完成事件锁存**：`flag!=0` 的那一帧必须单独记到文件的 static `s_doneCmd` /
   `s_doneFlag`，不能只读 `cam_flag` —— 否则会被紧随其后的 `flag=0` 帧覆盖，
   等待循环永远等不到"干完了"。
3. **`Cam_WaitSettle(cmd, tmo)` 改了语义**：原来是"等目标从运动到静止"（穿盒
   算法），现在是"发命令 + 循环等该命令返回 flag!=0"。发命令前先清完成锁存
   —— 清的是**本地的 `s_doneCmd`**，不是去动相机的 flag：电控侧从不回写相机的 flag，
   只解析收到的帧；协议里"每次接收后将 flag 置于 0"是视觉侧自己的循环行为。
   清本地锁存的目的是让自己等的是"这条新命令之后新来的"完成事件，不是上一条残留的。
   相机没动静时按 300ms 补发，命令幂等。
4. **`Cam_Init()` 的就绪判据变了**：新协议是请求-应答式的，相机上电不会主动
   说话，所以改成"发一次 `AA 00 BB` 探链路、收到任意合法帧即算通"（5s 超时，
   超时前反复补发），不再是旧协议那种"等相机空闲时自己回显"。
5. **删除**：`CAM_STILL_BOX_PX` / `CAM_STILL_QUIET_MS` / `CAM_STILL_TIMEOUT_MS`
   / `CAM_NEAR_WIN_PX` / `CAM_IN_WIN()` 整套穿盒判据，以及
   `Cam_WaitForStill` / `WaitForMoveNearStill` / `WaitForNearStill` 的实现。
6. **新增对外 API**：`Cam_SendIdle()`、`Cam_SendTaskCode(c1,c2,c3)`、
   `Cam_RequestDisc(&x,&y,tmo)`、`Cam_RequestBoxColor(&c1,&c2,&c3,tmo)`、
   `Cam_RequestRing(&x,&y,&ring,tmo)`。

### 兼容层（临时，流程定了就删）

任务流程（取料改成什么形态、0x02/0x04 各用在哪一步）**这次没定**，所以
`pick_task.c` / `positionPIDcontroller.c` 的整体逻辑没动，只在 camera.c 里加了一小段
同名兼容符号让它编译得过：

- **真值传递**：`dx`/`dy`/`cam_flag`/`cam_receive_flag`/`cam_mode` 由新解析器持续更新，
  所以 `AGV_Correct()` 的视觉闭环**仍然成立** —— 前提是调用方先发过 0x02/0x04 请求。
- **尽力映射**：`Cam_SwitchTo(color)` → color==0 发 0x02、否则发 0x03；
  `Cam_SwitchCloseColor()` → 发 0x03。都是"发完就走"，恒返回 1。
- **空桩**：`Cam_WaitForStill` / `WaitForMoveNearStill` / `WaitForNearStill`
  什么都不做（新协议把静止判据交给相机侧了）。

调用方只做了**机械改名**（`target_dx`→`dx` 等），流程一行没动。

### 要留意的

1. ⚠ **这版不能直接上实车**。空桩不发任何字节、`Cam_SwitchTo()` 恒返回 1，
   整个"追物块取料"链路是空转的，会走到盲抓。它是给下一轮改流程用的骨架。
2. ⚠ **`ScanNearestColor()` 有已知误判**：它拿 `cam_mode`（现在是命令码 0x00~0x04）
   跟颜色号 0~3 比，命令码 0~3 会撞上颜色号 0~3。目前只被"`cam_flag==0` 就返回没料"
   挡住（`cam_flag` 只在 0x02/0x04 识别到目标时才非 0），一旦收到过 0x02/0x04 帧
   就会漏过去。改流程时必须一并处理。
3. ⚠ **`flag=0` 时 dx/dy 有没有意义，取决于相机侧实现**（协议只写了 `flag=1` 表示
   识别到）。现在解析器对 0x02/0x04 的**每一帧**都刷新 dx/dy，这样 `AGV_Correct()`
   的闭环才有连续输入；如果相机在 `flag=0` 时发的是 0 或垃圾值，对准会被带偏。
   **下一轮要跟视觉侧确认这一条。**
4. `positionPIDcontroller.c:118` 的 `AGV_Position_Correct(int16_t dx, int16_t dy)`
   形参与新全局同名，函数体内会遮蔽全局。传参是显式的（`AGV_Position_Correct(dx, dy)`），
   行为正确，但读代码时容易误会，后续可改名 `dx_px`/`dy_px`。
5. `pick_task.c` 的 `PICK_IN_WIN(dy)` 宏形参原本也叫 `dy`，已改成 `PICK_IN_WIN(v)`
   避免自遮蔽。

### 当天的两处后续调整

1. **`cam_new` 改名 `cam_receive_flag`**（camera.c/h + 两个调用方），语义不变。
2. **`dx`/`dy` 初值由 -999 改成 0**，并**取消"无效值哨兵"**：有没有识别到目标
   一律看 `cam_flag`（0 = 没识别到）。相应地原来三处 `dx == -999 || dy == -999`
   判断全部换成 `cam_flag == 0U`：
   - `positionPIDcontroller.c` 的 `AGV_Correct()`（无目标不下发，保持上次轮速）
   - `pick_task.c` 的 `ScanNearestColor()`、`TrackOneColor()`、`TrackStillInWindow()`
   `Cam_Init()` 里同步把 `cam_flag` 也清 0。

编译：FLASH 54644 B（10.42%）、RAM 4896 B，全量重编无警告。**未实车验证。**

---

## 2026-10-03 —— 视觉流程按新协议落地：Pick_RAW 重写 + 兼容层删除

上一节只换了收发层，流程靠兼容层顶着。这节把流程接上，兼容层整体删掉。

### 1. 删除兼容层

`camera.h` / `camera.c` 里的 `Cam_SwitchTo` / `Cam_SwitchCloseColor` /
`Cam_WaitForStill` / `Cam_WaitForMoveNearStill` / `Cam_WaitForNearStill`
的实现、声明、注释块全部删除。调用方一律改用请求式 API：

| 旧写法 | 新写法 |
|---|---|
| `Cam_SwitchTo(0)`（对准圆盘/圆环） | `Cam_RequestDisc()` / `Cam_RequestRing()` |
| `Cam_SwitchCloseColor()`（扫三色） | `Cam_RequestBoxColor()` |
| `Cam_WaitFor*`（电控自己判静止） | 删除；静止判据交给相机侧，靠 `flag` 回报 |

### 2. `Pick_RAW()` 重写（`task.c` 的 `case Pick1` 走它，不再分 Route_id）

```
MoveTo POS_OBSERVE_RAW
Pick_Gripper_Observe()
Cam_RequestDisc(NULL, NULL, 3000)          ← 偏差落全局 dx/dy
AGV_Correct(3000)
Cam_RequestBoxColor(&c0,&c1,&c2, 3000)     ← box_color[0..2] = A/B/C 三个框的颜色
按任务码顺序 Pick_Color[0]→[1]→[2]：
    在 box[] 里找同色的框 j；找到就去 POS_RAW_{A,B,C}[j] 抓 → POS_CAR
    找不到（相机没识别到 / 颜色不符）就跳过这一块
MoveTo POS_RUN
```

- 传 `NULL` 是因为 `AGV_Correct()` 永远读全局 `dx/dy`，不必在调用点接值。
- `RequestBoxColor` 超时则**整段不抓**：此时 `box[]` 可能是上一轮的旧值，拿来抓是错的。
- `POS_RAW_A/B/C` 三个宏当前取值相同（`184,62,29`），是占位，标定后才是三个框各自的位姿。

### 3. `Pick_RAW_PLUS()` 删除

它原来的卖点是"追第一块从运动到静止的物块"，新协议把这个判据整体交给相机侧
（靠 `0x02` 帧的 `flag` 表示"圆盘中心已识别"），电控侧再自己算没意义。连带删掉的还有
`ScanNearestColor()` / `WaitNearestChange()` / `TrackOneColor()` / `TrackStillInWindow()`
和 `PICK_TRACK_*` / `PICK_WIN_HALF_PX` / `PICK_IN_WIN` / `PICK_COLOR_NONE` / `TRK_*` 这批宏。
`task.c` 的 `case Pick1` 改为无条件 `Pick_RAW()`。

### 4. `Place_ROUGH()` 的视觉修正换成 0x04

`Cam_SwitchTo(0)` → `Cam_RequestRing(NULL,NULL,NULL,3000)` + `AGV_Correct(8000)`。
**请求挪到了 `Pick_MoveTo POS_OBSERVE_CIRCLE` 之后** —— 旧代码是先发颜色命令再移臂，
新协议是请求-应答式，相机得先看见圆环才有东西可识别。环号在这段用不上
（环号由二维码的 `Place_Color[]` 给出），三个出参都传 `NULL`。

### 5. `case QRcode` 增加任务码下发

`QRcode_Task()` 之后加 `Cam_SendTaskCode(Pick_Color1[0], Pick_Color1[1], Pick_Color1[2])`。
**只发了第一轮的 `Pick_Color1`**：`case QRcode` 只在第一轮走一次，二周目是从 `Move4`
直接回到 `Pick1`，不会再扫码。第二轮的 `Pick_Color2` 相机侧目前拿不到，要用得补一条。

### 6. 车槽位宏改名

`pick.h` 里 `POS_A/B/C` 已被换成 `POS_CAR`，但 `POS_A_OUT` 从来没进过头文件。
这次补齐并统一命名：

| 宏 | 值(角度z, 高度z, 半径r) | 说明 |
|---|---|---|
| `POS_CAR` | `4, 31, 28` | 车上放置位置，`Pick_RAW` 三次抓取都放这一点 |
| `POS_CAR_A` | `4, 31, 28` | 车上 A 槽（= 原 `POS_A`） |
| `POS_CAR_B` | `44, 31, 28` | 车上 B 槽 ← **值待标定** |
| `POS_CAR_C` | `84, 31, 28` | 车上 C 槽 ← **值待标定** |
| `POS_CAR_A_OUT` | `30, 7, 58` | A 槽车外过渡位（= 原 `POS_A_OUT`） |

`pick.c` / `pick_task.c` / `pick_task.h` 里的调用点一并改名；`pick.c`
调试函数里失效的 `POS_OBSERVE` / `POS_RAW` 也改成了 `POS_OBSERVE_RAW` / `POS_RAW_A`。

### 7. `Place_TEMP()` 的视觉修正挂起（等 0x05）——**已被第 9 节取代**

（当时 `0x05` 还没定，所以把 `AGV_Correct(8000)` 注释掉了。用户随后给出了 `0x05`
的帧格式，现已按下述第 9 节落地，本节的挂起状态已解除。）

### 8. 车上槽位改由转盘舵机选（硬件变更）

**背景更正**：车上不再是"三个独立臂位置"，而是**一个位姿 `POS_CAR` + 转盘舵机转角**。
新舵机 270°，设计与夹爪舵机同源：0°=A 槽、120°=B 槽、240°=C 槽，上电初值 0°=A。
抓取时依次放 A→B→C，放置时也按 A→B→C 取。

- `servo.h` / `servo.c` 新增第三路 `SERVO_TURN`：**TIM1_CH1 = PE9**。
- `pick.h` 删掉上一节刚加的 `POS_CAR_A/B/C` 和 `POS_CAR_A_OUT`，
  换成 `PICK_TURN_ANG_A/B/C`（0/120/240）；新增 `Pick_TurnTable_Set(uint8_t slot)`。
- `Pick_TurnTable_Set()` 走 `Servo_SetAngleSmooth` + `SERVO_T_SETTLE_MS`(300ms) 到位裕量，
  与 `Pick_MoveTo` 对 Z 舵机的处理一致。
- `pick_task.h` 三个宏改成带槽号的版本，都遵守"**先转转盘、再摆臂**"
  （转盘转动时臂不在车体上方）：
  `GRAB_AND_PLACE_TO_RING_SLOT` / `GRAB_AND_PLACE_TO_RING_SLOT_EX` /
  `GRAB_FROM_RING_AND_PLACE_SLOT`。
- `pick_task.c`：`GrabRawBoxToCar(box, slot)` 多了槽号参数（第 i 个颜色 → 第 i 个槽）；
  `PlaceToRing(slot, ring)` 槽号就是原来的 `index`，`Place_ROUGH` 的 `2 - i` 反转取消
  （`2-i` 是旧"0=C 槽"约定留下的）；原先的 `POS_CAR_A_OUT` 绕行过渡连同 `HAL_Delay(1000)` 一并删除
  —— 转盘方案下三次臂位姿相同，不再存在"从 A 转向经过 B"的问题。

#### ⚠ 一个容易踩的坑：TIM1 的预分频和 TIM2/3/4 不一样

`TIMxCLK` 在 APBx 分频系数 ≠ 1 时取 `2 × PCLKx`：

| 定时器 | 总线 | 总线频率 | 定时器时钟 | 预分频(得 1MHz) |
|---|---|---|---|---|
| TIM2/3/4 | APB1 (DIV4) | 42 MHz | 84 MHz | **83** |
| TIM1 | APB2 (DIV2) | 84 MHz | **168 MHz** | **167** |

原来 `servo.c` 把 83 写死在 `Servo_TimInit()` 里。按 83 配 TIM1 会得到 100Hz 的 PWM，
舵机会抖动或不动作。这次给 `ServoCfg` 加了逐路的 `prescaler` 字段，TIM1 用 167。
**改主频或改 APBx 分频时，这几路预分频必须跟着重算。**

### 9. 0x05 协议落地（Place_TEMP 第二轮）

新增 `0x05`：

| 方向 | 帧 | 含义 |
|---|---|---|
| 电控→相机 | `AA 05 color BB` | 请求指定颜色 color |
| 相机→电控 | `AA 05 flag dxH dxL dyH dyL BB` | flag=1 识别到该颜色，dx/dy 用于修正 |

- `camera.h`：加 `CAM_CMD_COLOR`、协议注释、`Cam_RequestColor(color, px, py, tmo)`。
- `camera.c`：帧长表加 `CAM_LEN_COLOR = 8`；`Cam_DecodeFrame()` 里 `0x05` 与 `0x02` 同构解 dx/dy；
  新增 `Cam_SendCmdArg()` 发 `AA cmd arg BB`；`Cam_WaitSettle()` 多两个参数
  (`hasArg`, `arg`)，补发逻辑同步走带参版本。
- `pick_task.c Place_TEMP()`：
  - **第二轮**：沿用原来的选色逻辑（从 `Place_Color1` 里找哪一槽放到了 2 号环，
    取那一槽的颜色 `Pick_Color1[x]`），改成 `Cam_RequestColor(color_to_send, ...)`。
  - **第一轮**：观察位是圆环区，和 `Place_ROUGH` 同一处，同样用 **0x04 请求圆环**。
    ← **这条是我按一致性推的**（原代码发的是 ASCII `'0'`，旧兼容层把它映到 0x02），
      两轮语义若不同请指出。
  - 之前注掉的 `AGV_Correct(8000)` 已打开。

### 要留意的

- **`POS_CAR` 仍是 `(4, 31, 28)`（原 `POS_A`）**，转盘方案下这是唯一的车上臂位姿，必须实测确认。
- **转盘三个角度 0/120/240 和方向（正转/反转）未实车验证**；如果装反了，
  `PICK_TURN_ANG_*` 改一下即可，不用动逻辑。
- **`SERVO_T_SETTLE_MS = 300` 是我定的**，转盘带料停稳时间要实测。
- **`0x05` 的 `color` 取值域未确认**：任务码里是 `QRcode_Buffer[i] - '0'` 的数字，
  相机侧认不认这个编码需要和视觉确认。
- **`Place_TEMP()` 第一轮用 0x04** 见上，待确认。
- **`flag=0` 时 dx/dy 是否有效**仍未与视觉侧确认（见上一节"要留意的"第 3 条）。
- **第二轮 `Pick_Color2` 没下发给相机**（见第 5 节）。
- 各请求超时 `PICK_REQ_TMO_MS = 3000` 是按相机回帧速度定的，可调。

编译：FLASH 54268 B（10.35%）、RAM 4968 B，全量重编无警告。**未实车验证。**

### 10. 机械臂两个动作函数改名（语义化，行为不变）

原来两个函数的名字和它干的事对不上：叫 `Pick_MoveTo` 的那个其实是"抬到安全高度跨过去"，
叫 `Pick_Direct_MoveTo` 的那个才是"直接到位"。现在对调过来：

| 改名后 | 原名 | 动作 |
|---|---|---|
| `Pick_JumpTo` | `Pick_MoveTo` | 门字形(Π形)：先升到 `PICK_SAFE_HEIGHT_MM` 再转向+走半径，最后降高度。**慢但能跨障碍** |
| `Pick_MoveTo` | `Pick_Direct_MoveTo` | 直接到位：不抬升，贴当前高度直接转+走，最后改高度。**快但路上有东西会蹭** |

- `Pick_Direct_MoveTo` 原来整个函数体是被注释掉的、且**没有任何调用点**；本次取消注释，
  它成为 `Pick_MoveTo` 的定义（当前仍无调用者，被 `--gc-sections` 回收，不占 FLASH）。
- 原有约 30 处 `Pick_MoveTo POS_XXX` 调用点**全部跟着改成 `Pick_JumpTo`**，
  所以机械臂动作行为与改动前完全一致（map 里 `.text.Pick_JumpTo` 仍在 `0x0800883c`，
  与改写前 `.text.Pick_MoveTo` 同址，可确认是同一份代码）。
- 涉及文件：`pick.h`（声明+文档）、`pick.c`（定义+内部调用+注释）、
  `pick_task.h`（`MOVE_TO_RING*` / `GRAB_*` 宏）、`pick_task.c`、`task.c`、`main.c`。
- 以后写新动作时按"路上有没有障碍"选：默认 `Pick_JumpTo`，确认是空地才用 `Pick_MoveTo`。

编译：FLASH 54256 B（10.35%）、RAM 4968 B，无警告。**未实车验证。**

### 11. 视觉请求改成两段式等待（第一段按命令码握手）

原来的 `Cam_WaitSettle()` 是一段式：发命令 → 一直等到某帧 `flag!=0` → 返回。
问题在于**相机在任何模式下都会持续往回发数据**，所以旧代码里"收到帧"这个动作本身
并不能说明相机收到了我们发的命令；旧代码只判了 flag，没有"命令是否被采用"这一层。

现在拆成两段（`camera.c`）：

| | 判据 | 补发 | 超时 |
|---|---|---|---|
| 第一段 | 收到一帧「**第二字节(命令码) == 刚发出去的那条**」 | 每 300ms 补发一次 | `CAM_ACK_TMO_MS` = 5s |
| 第二段 | 这同一条命令回 `flag != 0` | **不补发** | 调用方传的 `settle_ms` |

- 新增锁存 `s_ackCmd`：在 `Cam_DecodeFrame()` 里**无条件**记录命令码
  （现有的 `s_doneCmd` 仍然只在 `flag!=0` 时锁存，两者各管一段）。
  用锁存而不是直接读 `cam_mode`，是免得被后面到达的别种帧冲掉。
- 两段锁存都在**发命令之前一起清**；因此若第一段期间相机就已经回了 `flag!=0`，
  第二段进来立刻命中返回，不会漏掉那次完成事件。
- 第二段不补发：相机已在本模式下持续回帧，重复下发可能让它重开一轮识别。
- `Cam_RequestDisc/BoxColor/Ring/Color` 四个 API **签名不变**，
  只是把形参 `timeout_ms` 改名为 `settle_ms`，语义明确为「只作用于第二段」。
- `pick_task.c` 的 `PICK_REQ_TMO_MS` 从 3000 改成 **5000**，
  所以现在每一处的第二段超时也都是 5 秒（与第一段一致）。

**最坏耗时**：单条视觉请求最多 5s(握手) + 5s(等识别) = 10s。
`Pick_RAW` 里有 2 条请求、`Place_*` 各 1 条，链路正常时远达不到，但链路断了会明显变慢。

**还没做**：四个请求的返回值仍然在 `Pick_RAW` / `Place_ROUGH` / `Place_TEMP` 里被忽略，
超时后照样用旧的 `dx`/`dy` 往下走 —— 见下面待办。

编译：FLASH 54344 B（10.37%）、RAM 4976 B，无警告。**未实车验证。**

### 12. `Pick_RAW()` 按转盘走格修正取料位置

原料区是个会转的转盘：**每抓走一块，剩下的料整体挪一格（A→B、B→C、C→A）**，
机械自动触发，不拿走就不转。所以开头 `Cam_RequestBoxColor()` 读到的 `box[0..2]`
在抓第二块时就已经过期 —— 旧代码直接拿 `box[]` 的原下标去抓，第二次起每次都抓错格。

改法（`pick_task.c`）：

```c
uint8_t grabbed = 0;                    /* 已抓走的块数 = 转盘已经转过的格数 */
...
int8_t j0 = 找 Pick_Color[i] 在 box[] 里的初始格号;
if(j0 < 0) continue;                    /* 相机没报这一色 → 跳过，槽位留空，且不计转格 */
uint8_t j = (uint8_t)((j0 + grabbed) % 3);   /* 初始在第 j0 格的料现在在第 j 格 */
GrabRawBoxToCar(j, i);
grabbed++;
```

- 方向按「内容索引 +1 mod 3」：初始在 0 格的料，抓 1 块后到 1 格，抓 2 块后到 2 格。
- **跳过的块不计入 `grabbed`**：转盘是被"拿走一块"触发的，没拿走就不会转，
  所以用 `grabbed`（真抓成功才 ++）而不是循环下标 `i`。
- `box[]` 只在开局读一次，之后作废；`GrabRawBoxToCar()` 的 `@param box` 注释
  已标明传进去的是「此刻料所在的格」而不是相机读数的原下标。

编译：FLASH 54388 B（10.37%）、RAM 4976 B，无警告。**未实车验证。**

### 13. 新增 `Pick_RAW_PLUS()`（未调用）—— 不推算走格，改成每次重问相机

`Pick_RAW` 靠 `(j0 + grabbed) % 3` 推算转盘走格；PLUS 版换成**每抓一块之前回
`POS_OBSERVE_RAW` 重发一次 `0x03`**，以相机重新报出的 flag=1 作为"可以下手了"的信号，
再按任务码顺序抓。两者的对正圆盘中心那段完全一样。

| | 位置从哪来 | 对转盘方向的依赖 | 代价 |
|---|---|---|---|
| `Pick_RAW` | 开局读一次，之后自己推算 | 强依赖（转反/多转一格就全错） | 快，无额外视觉交互 |
| `Pick_RAW_PLUS` | 每块前重问一次相机 | 不依赖 | 每块多一次「回观察位 + 等识别」 |

- "等 flag **再次**等于 1"不用额外写：`Cam_RequestBoxColor()` 内部第二段等的就是
  `flag!=0`，且它**发命令前会清完成锁存**，所以等的必然是这条新命令之后新来的
  flag=1，不是上一条命令残留的那个。
- 跳过某一块不影响后面：下一轮照样重问，不会像推算版那样一错全错。
  （推算版跳过时不 `grabbed++`，就是靠这个避免错位。）
- 某次问不到颜色（`Cam_RequestBoxColor` 返回 0）就 `break` 收工，不再往下抓。
- **当前无人调用**：`task.c` 的 `case Pick1` 走的仍是 `Pick_RAW`，切换时改那一行即可。
  因无人调用被 `--gc-sections` 回收，FLASH 没增加。

### 14. 视觉超时不再硬着头皮往下走 + 夹爪 Observe/Release 时序统一

**（a）视觉请求超时就跳过 `AGV_Correct()`。** 之前五个请求的返回值全被忽略，
超时后 `dx`/`dy` 还是上一段留下的旧值，`AGV_Correct()` 会拿它驱轮子把车带偏。
现在四处都改成"拿不到偏差就不修正"：

| 位置 | 改动 |
|---|---|
| `Pick_RAW()` | `Cam_RequestDisc()` 返回 1 才 `AGV_Correct(5000)` |
| `Pick_RAW_PLUS()` | 同上 |
| `Place_ROUGH()` | `Cam_RequestRing()` 返回 1 才 `AGV_Correct(5000)` |
| `Place_TEMP()` | 两轮都收进 `vision_ok`，最后 `if(vision_ok) AGV_Correct(5000)` |

车本来就停在目标区，不修正只是少一次对正，比朝错误方向走一段安全。
`Pick_RAW` 的 `RequestBoxColor` 超时仍然是整个抓取循环都不进（原有行为）。

**（b）夹爪时序统一为「观察/修正时 `Observe`，下去抓之前 `Release`」：**

- `Pick_RAW()`：进循环前补了 `Pick_Gripper_Release()`。之前第 2、3 块是
  **带着 75°(Release) 的爪直接下降**的（`GrabRawBoxToCar()` 结尾就是 Release），
  而第 1 块是 15°(Observe) 下去的 —— 两块状态不一样。现在统一成 Release 下去。
  （另：`Pick_Gripper_Observe()` 只在进循环前调一次，之后靠 `GrabRawBoxToCar()`
  结尾的 Release 自然接力，不需要每轮补。）
- `Pick_RAW_PLUS()`：循环里问完颜色、**`GrabRawBoxToCar()` 之前**加了
  `Pick_Gripper_Release()`；问颜色期间仍是 `Observe`（别挡相机）。

**（c）`Place_TEMP()` 第二轮加 `color_to_send != 0` 判断。**
颜色号是 **1~6**，所以 `color_to_send == 0` 只可能是"第一轮没有哪一槽放进 2 号环"。
这种情况没有颜色可问，发 `AA 05 00 BB` 相机也不认，现在直接当失败处理、不做修正。

编译：FLASH 54428 B（10.38%）、RAM 4976 B，无警告。**未实车验证。**

### 15. 0x01 也走两段等待 + 五个请求超时统一 10s

**（a）`Cam_SendTaskCode()` → `Cam_RequestTaskCode()`。**
之前 0x01 是**唯一一条发了不管确认**的命令：只管把 6 字节帧塞进串口就走
（只清了一下 `s_doneCmd`）。协议里 0x01 是要回 `AA 01 flag BB`、`flag=1 任务码接收成功` 的，
现在它和 0x02~0x05 走同一个 `Cam_WaitSettle()`：

| | 原来 | 现在 |
|---|---|---|
| 声明 | `void Cam_SendTaskCode(c1,c2,c3)` | `uint8_t Cam_RequestTaskCode(c1,c2,c3,settle_ms)` |
| 行为 | 发完立刻返回 | 发→等 0x01 回帧握手→等该帧 `flag!=0` |
| 调用点 | `task.c` 的 `case QRcode` | 移到 `QRcode_Task()` 内部（见下） |

`Cam_SendIdle()` **保持不发不等** —— 它是 `Cam_Init()` 上电探链路用的，
那会儿链路还没通，等了也是白等。

**（b）收发函数泛化。** `Cam_WaitSettle(cmd, hasArg, arg, settle_ms)` 改成
`(cmd, payload, plen, settle_ms)`，底层新抽一个：

```c
static void Cam_SendCmdPayload(uint8_t cmd, const uint8_t *payload, uint8_t plen)
```

`AA + cmd + 最多 3 字节参数 + BB`，`plen` 传 0 就是无参命令。
0x01 的 3 字节、0x05 的 1 字节、0x02/0x03/0x04 的 0 字节从此走同一条路，
不用再为哪种参数形态单独开分支。`Cam_SendCmdArg()` 因此没人用，已删
（`Cam_RequestColor` 里只包了一层，直接给 `WaitSettle` 传 `&color, 1`）。

**（c）两段超时都是 10s，常量收到 `camera.h`。**
- `CAM_ACK_TMO_MS`（第一段，`camera.c`）：5000 → **10000**
- 第二段原来叫 `PICK_REQ_TMO_MS` 且在 `pick_task.c` 里，现在改成
  **`CAM_REQ_TMO_MS` 定义在 `camera.h`** —— 用它的人已经有三个
  （`task.c` / `pick_task.c` / `QRcode.c`），而且后两个分属任务层和硬件层，
  常量再留在任务层会让 `HARDWARE/Src/QRcode.c` 反过来 include 任务头文件。
  请求超时本来就是"等相机多久"的视觉层参数，放 `camera.h` 名副其实。
- 补发间隔 `CAM_RESEND_MS` 不变，仍是 **100ms**（"发完很短时间没动静就重发"）。

各请求超时现在都是 10s，最坏情况一轮流程里视觉会等：
`Pick_RAW` 10+10、`Place_ROUGH` 10、`Place_TEMP` 10 = **40s**（相机死了的话）。

**（d）调用点移进 `QRcode_Task()`。**
原来在 `task.c` 的 `case QRcode` 里单独发一次，现在收进 `HARDWARE/Src/QRcode.c`
的 `QRcode_Task()` 末尾：扫码 → 显示 → 下发任务码。
`case QRcode` 于是只剩一句 `QRcode_Task();`。
理由是"扫码"和"把扫到的任务码告诉相机"本来就是一件事，分开写容易漏；
`QRcode_Task()` 的文档注释里也写清了它现在会阻塞等 0x01 的 flag=1（最多 10s）。

**（e）返回值仍然没判** —— 见下面待办 17。`Cam_WaitSettle()` 内部**是判了
mode（第一段）和 flag（第二段）的**，那是"什么时候停止等待"的判据；返回值 0/1 说的是
"这次判下来是成功还是超时"，是"超时了怎么办"的输入。两者不是一回事。

编译：FLASH 54448 B（10.39%）、RAM 4976 B，无警告。**未实车验证。**

### 16. `Pick_RAW_PLUS()` 按流程设计改：下料位改用 `Pick_MoveTo` + 新增流程设计书

**（a）`GrabRawBoxToCar()` 加 `direct` 参数。** 原来它内部固定用 `Pick_JumpTo`
下到料位；现在：

| | 下到 `POS_RAW_x` | 从料位回 `POS_CAR` |
|---|---|---|
| `direct = 0`（`Pick_RAW` 用） | `Pick_JumpTo` 门字形 | `Pick_JumpTo` |
| `direct = 1`（`Pick_RAW_PLUS` 用） | `Pick_MoveTo` 直接到位 | `Pick_JumpTo` |

**只有"下到料位"这一步分两版**。从料位往车上那一趟**一律 `Pick_JumpTo`** ——
那是往车体上方去，路上就是转盘和已放的料，不能贴着扫。

`Pick_RAW` 的调用点跟着变成 `GrabRawBoxToCar(j, i, 0)`，行为不变。

**（b）`Pick_RAW_PLUS()` 现在是**：观察位 → 开爪 → 0x02 → 修正 → 收爪 →
循环 { 回观察位 → 开爪 → 0x03 → 按当轮读数找格 → 收爪 → `GrabRawBoxToCar(j,i,1)` }。

和 `Pick_RAW` 的两点区别是"不推算走格、每块重问"+"下料位用 `Pick_MoveTo`"，
其余（0x02 修正、夹爪时序、跳过没报到的颜色）完全一致。

**（c）`Pick_MoveTo` 从"没人调用"变成真被调用**，不再被 `--gc-sections` 回收 ——
FLASH 54448 → 54784（+336 B）。

**（d）新增 [`流程设计书.md`](流程设计书.md)。** 把整个流程按"启动 / 运行"两段写成文档：
状态机表、每个阶段的动作时序、视觉协议与两段式等待、位姿宏表、超时常量汇总、
以及末尾一节"未定项 / 待实车验证"。描述的是**代码实际在跑的东西**，不是设想。

编译：FLASH 54784 B（10.45%）、RAM 4976 B，无警告。**未实车验证。**

### 17. 视觉模块改名：`openmv.c/h` → `camera.c/h`，`OpenMV_*` → `Cam_*`

**（a）文件**

| 原 | 现 |
|---|---|
| `UserCode/Src/openmv.c` | `UserCode/Src/camera.c` |
| `UserCode/Inc/openmv.h` | `UserCode/Inc/camera.h` |

`CMakeLists.txt` 第 59 行的源文件列表、7 处 `#include "openmv.h"`、头文件守卫
（`__OPENMV_H` → `__CAM_H`）都已跟着改。

**（b）符号前缀统一成 `Cam` / `CAM`**

| 类别 | 原 | 现 |
|---|---|---|
| 对外 API | `OpenMV_Init` / `OpenMV_Service` / `OpenMV_SendIdle` / `OpenMV_RequestXxx` | `Cam_Init` / `Cam_Service` / `Cam_SendIdle` / `Cam_RequestXxx` |
| 内部 static | `OpenMV_WaitSettle` / `OpenMV_SendRaw` / `OpenMV_SendCmdPayload` / `OpenMV_DecodeFrame` / `OpenMV_ParseAcc` / `OpenMV_FrameLen` / `OpenMV_StartRx` / `OpenMV_AccDrop` | 同前缀换 `Cam_` |
| OLED | `Openmv_OLED_Show`（原来大小写不统一） | `Cam_OLED_Show` |
| 宏 | `OPENMV_HEAD` / `OPENMV_TAIL` / `OPENMV_REQ_TMO_MS` / `OPENMV_INIT_TMO_MS` / `OPENMV_RESEND_MS` / `OPENMV_ACK_TMO_MS` / `OPENMV_RAW_LEN` / `OPENMV_ACC_LEN` | `CAM_*` |
| 协议常量 | `MV_CMD_*` / `MV_LEN_*`（MV = OpenMV 的牌子缩写） | `CAM_CMD_*` / `CAM_LEN_*` |
| 全局量 | `openmv_start` | `cam_start`（和已有的 `cam_flag` / `cam_mode` / `cam_receive_flag` 归成一族）|

**没改**：`cam_flag` / `cam_mode` / `cam_receive_flag` / `box_color` / `dx` / `dy` ——
它们本来就是 `cam_` 前缀，且语义是"最近一帧的解析结果"而不是"这个模块"。

**（c）OLED 上的两处文案也跟着改了**（这是显示内容，不只是标识符）：
`openmv OK` / `openmv error` → **`camera OK` / `camera error`**
（[menu.c:76](UserCode/Src/menu.c#L76) 的菜单第二行、[camera.c:415](UserCode/Src/camera.c#L415) 的初始化超时提示）。
两串长度没变，OLED 一行放得下。

**（d）本文件里历史条目中的 `OpenMV_*` / `openmv.c` 也一并做了替换**，
这样文中的文件链接不会失效；读旧条目时按新名字理解即可。
只有 `openmv_cmd`（旧 ASCII 协议时代的一个变量名，代码里早已不存在）保持原样。

纯改名，**行为零变化**：编译零警告，FLASH 54784 B / RAM 4976 B 与改名前完全一致，
map 里能看到 `.text.Cam_Init` / `.text.Cam_RequestDisc` / `.text.Cam_WaitSettle` 等新名字。

### 18. 机械臂模块改名 + 挪位置：`UserCode/pick_ctrl.*` → `HARDWARE/pick.*`

| 原 | 现 |
|---|---|
| `UserCode/Src/pick_ctrl.c` | `HARDWARE/Src/pick.c` |
| `UserCode/Inc/pick_ctrl.h` | `HARDWARE/Inc/pick.h` |

- 三处 `#include "pick_ctrl.h"` → `#include "pick.h"`（`pick_task.h` / `task.h` / `pick.c`）；
  `pick_task.c` 一句注释里的文件名也跟着改了。
- `CMakeLists.txt` 的源文件列表 `UserCode/Src/pick_ctrl.c` → `HARDWARE/Src/pick.c`。
  **include 路径没动** —— `HARDWARE/Inc` 本来就在 `target_include_directories` 里。
- 头文件守卫 `__PICK_CTRL_H` → `__PICK_H`。
- **顺手删了 `pick.h` 里一句 `#include "pick_ctrl.h"` 自包含**：它在自己的头文件里
  include 自己，靠守卫变成空操作，是当初复制粘贴留下的，没有任何作用。

**函数名一个都没动**（`Pick_JumpTo` / `Pick_Init` / `POS_*` / `PICK_*` 全部保持原样），
所以调用方除了 include 那一行之外不用改任何东西。

**本文档里历史条目的 `pick_ctrl.c/.h` 路径也一并替换成新路径**，
理由和上一节改名一样：让链接不失效。读旧条目时按新路径理解。

编译零警告，FLASH 54784 B / RAM 4976 B 与改名前完全一致。

> **留个话在这里（没动）**：`pick.h` 里 include 了 `positionPIDcontroller.h` /
> `chassis.h`（都在 `UserCode/Inc`）以及 `camera.h` / `QRcode.h` / `usart.h` / `main.h`。
> 换句话说 `HARDWARE/` 反过来依赖 `UserCode/`。这次挪文件**没有加重**这个问题
> （`QRcode.c` include `camera.h` 早就这样了），但真要理干净，得把这些 include
> 按"谁真的用到"逐条筛一遍再挪到 `pick.c` 里 —— 那是另一件事，没做。

---

## 2026-10-04 —— 桌面测试从 task.c 拆出去，独立成 `UserCode/test.*`

### 19. 新增 `Test_Switch()` 测试框架

**动机**：`task.c` 里塞着 `#define STANDALONE_TEST 0` 和两段 `#if` 测试块，和正式流程
状态机混在一个函数里；每加一个测试就要动正式流程的文件。拆出去以后测试和正式流程互不干扰。

| 文件 | 改动 |
|---|---|
| `UserCode/Inc/test.h` | **新增**。`TEST_MODE` 宏 + `Test_Switch()` 声明 + 模式表 |
| `UserCode/Src/test.c` | **新增**。`Test_Switch()` 分发 + 各测试函数实现 |
| `Core/Src/main.c` | include `test.h`；`AGV_Init()` **上面**加一行 `Test_Switch();` |
| `UserCode/Src/task.c` | 删掉 `STANDALONE_TEST` 宏和两段 `#if/#elif/#else/#endif`，`TaskProc()` 只剩纯 switch |
| `CMakeLists.txt` | `target_sources` 加一行 `UserCode/Src/test.c` |

**调用时序**（`main()` 里）：

```c
MX_XXX_Init();      /* CubeMX 生成的外设初始化，照旧 */
Test_Switch();      /* ← 新增。TEST_MODE==0 时立刻返回 */
AGV_Init();         /* 末尾阻塞在 Menu_Init() 等 A8 */
while(1) TaskProc();
```

`TEST_MODE != 0` 时 `Test_Switch()` **不返回**（跑完进 `for(;;){}`），所以程序不会走到
`AGV_Init()`，也不会进正式流程 —— 这是有意的。

**模式表**（定义在 `test.h`）：

| 号 | 函数 | 内容 |
|---|---|---|
| 0 | —— | 跳过，直接返回跑正式流程 |
| 1 | `Test_AGV` | 路径测试：依次跑整条路线的 5 段，段间停 2s |
| 2 | `Test_Vision` | 视觉修正测试：夹爪张开 + 摆到 `POS_OBSERVE_CIRCLE`，`Cam_RequestDisc()` 拿偏差后 `AGV_Correct(5000)` |
| 3 | `Test_Pick` | 抓物块测试：`QRcode_Task()` → `Place_ROUGH()` → `Place_TEMP()`（RerunFlag=1 走第二轮） |

模式 1、3 是原来 `STANDALONE_TEST==1/2` 那两段原样搬过来的；模式 2 是新写的。

**`test.c` 自己带一份硬件初始化 `Test_HwInit()`**：因为 `Test_Switch()` 在 `AGV_Init()`
之前被调用，那时 OLED / 相机 / CAN / HWT101 / DWT 都还没起来。这份初始化就是
`AGV_Init()` 前半截照搬，**只去掉末尾阻塞等 A8 的 `Menu_Init()`** 和 `TaskCode = Depart`。
→ **代价：初始化代码在工程里有两份，改 `AGV_Init()` 的顺序要记得同步 `Test_HwInit()`。**

**加新测试的三步**（`test.h` / `test.c` 顶部注释里也各写了一遍）：
test.h 模式表占号 → test.c 写一个 `static` 测试函数 → `Test_Switch()` 的 `switch` 里加 `case`。

**`TEST_MODE == 0` 时的写法**：`test.c` 用一个 `#if TEST_MODE == 0 / #else / #endif`
只留 `Test_Switch(){ return; }`，其余整块实现不参与编译。不这么写的话每个 `static`
测试函数都没人引用，`-Wall` 会对每个函数报一条 `-Wunused-function`。
反过来 `TEST_MODE != 0` 时不会报 —— `switch` 里所有 `case` 都有调用表达式，
即使常量折叠把没选中的分支优化掉，语法上的引用仍然存在。

**顺带**：`AGV_Init()` 里的 `Pick_Init();` 从注释状态**恢复成实际调用**（机械臂上电+收臂到
`POS_START`）。`test.c` 的 `Test_HwInit()` 里同步是调用的。

**编译验证**：
- `TEST_MODE=0`：`[3/3]` 通过，FLASH **54800 B** / RAM 4976 B，零警告（比拆之前的
  54784 B 多 16 B，就是 `Test_Switch()` 这个空函数本体）。
- `TEST_MODE=1`：`[3/3]` 通过，FLASH **54916 B** / RAM 4976 B，零警告（多出来的
  116 B 是 `Test_HwInit()` + `Test_AGV()`；`Test_Vision`/`Test_Pick` 被常量折叠掉了）。
- 全工程搜 `STANDALONE_TEST` 只剩注释里的说明文字，没有活代码。

**未上实车验证。**

---

## 2026-10-04（二）—— 新增运行时调试服务：TIM7 周期刷相机数据 + A8 短按暂停

### 20. `UserCode/dbg.*`

**要的东西**：一个定时器，周期用 OLED 整屏覆盖显示相机最近一帧的 `mode/flag/dx/dy`；
同时扫一个按键，短按一下程序全部暂停卡住，再按一下继续。**test 模式和正式流程都要能用。**

| 文件 | 改动 |
|---|---|
| `UserCode/Inc/dbg.h` | **新增**。`Dbg_Init()` / `Dbg_Service()` 声明 + 设计取舍说明 |
| `UserCode/Src/dbg.c` | **新增**。TIM7 中断 + 服务函数 + `HAL_Delay` 接管 |
| `Core/Src/main.c` 之外的调用点 | `task.c` 的 `AGV_Init()`、`test.c` 的 `Test_HwInit()` 各加一行 `Dbg_Init();`（都在 `OLED_Init()` 之后） |
| `positionPIDcontroller.c` | `AGV_Correct()` 循环里加 `Dbg_Service();` |
| `Emm_V5.c` | `Emm_V5_WaitArrive()` / `Emm_V5_WaitRxFrame()` 循环里各加 `Dbg_Service();` |
| `CMakeLists.txt` | 加一行 `UserCode/Src/dbg.c` |

**为什么中断里不刷屏**（这是整个设计的支点）：
OLED 是软件 I2C，`delay_us(1)` 一位，整屏 1024 B ≈ **30 ms 阻塞**。而 TIM7 的 NVIC
优先级是 **0（最高）**，在中断里干 30 ms 会把 CAN 和相机 USART1 的接收中断全压住 ——
相机那条尤其危险，DMA 处理晚了、下一次 `HAL_UARTEx_ReceiveToIdle_DMA` 没及时重挂，
直接丢帧。
所以 **TIM7 中断只做两件几微秒的活：扫键 + 置刷屏标志**（`HAL_TIM_PeriodElapsedCallback`）。

**`Dbg_Service()` 怎么才能到处都调到** —— 主程序经常一卡好几秒（等相机 10 s、等对准 5 s、
等电机 5 s、菜单无限久），主循环那点时间指望不上。两个手段：

1. **接管 `HAL_Delay`**：`HAL_Delay` 在 HAL 里是 `__weak` 的，dbg.c 里写了个同名的，
   等时间的同时调 `Dbg_Service()`。→ **全工程所有 `HAL_Delay` 一处不改就都成了服务点。**
   对外的"阻塞等这么久"语义不变，精度仍是 1 ms 级 SysTick。
2. **手工补**：`AGV_Correct()` 和 `Emm_V5_WaitArrive/WaitRxFrame()` 是纯 `HAL_GetTick()`
   自旋、不经过 `HAL_Delay`，在这三个循环里各插了一句。

**重入保护**是必需的，有两个来源：`Dbg_Service()` → `AGV_Position_Stop()` →
`Emm_V5_WaitRxFrame()` → 又调 `Dbg_Service()`；以及嵌套 `HAL_Delay`。
用 `s_in_service` 挡住。另外 `__get_IPSR() != 0` 时直接返回 —— 不该在 ISR 里进暂停死循环。

**按键**：复用启动键 **A8**（`menu.c` 里那个，不占新引脚），**短按切换**暂停/继续。
消抖照抄 `menu.c`：TIM7 10 ms 一拍，连续 3 拍同电平算稳定。多一条 **"见过一次松开才认
这次按下"**（`s_key_armed`）—— 否则菜单里那个按着的 A8 会被上电后的第一拍当成一次新按键，
程序刚启动就被暂停。

**暂停语义（选的是"甲：不管，超时继续"）**：暂停时 `Dbg_Service()` 会先发一次
`AGV_Position_Stop()` —— 步进电机收到的是"走 Xmm @ Yrpm"，轨迹是电机自己跑的，
**MCU 冻住车照走**，必须显式发停车。恢复后被打断的那段运动不会重发，那个
`Emm_V5_WaitArrive` 会因为超时窗口已经过去而返回 0，调用方当成"走到了"继续 ——
**暂停过之后这一趟位置不准，要手动把车挪回去。** 这是当时定下的取舍。

**已知副作用**：偶尔一次 `HAL_Delay(1)` 会因为赶上刷屏节拍而变长约 30 ms（服务函数要
整屏推一次 OLED）。只是变慢，不改变对外语义。

**顺带修的**：`test.c` 里 `#if TEST_MODE == 0` 被人改成了 `== 1`。改之后 `TEST_MODE=0`
反而会去跑测试、卡在 `for(;;)`，永远走不到 `AGV_Init()` —— 和它自己下面那段"不测试：
立刻返回"的注释正好相反。已经改回 `== 0`。

**编译验证**：
- `TEST_MODE=0`：通过，FLASH **55584 B** / RAM 4984 B，零警告（比上一节多 784 B）。
- `TEST_MODE=1`：通过，FLASH 55704 B / RAM 4984 B，零警告。
- map 里确认 `HAL_Delay` / `HAL_TIM_PeriodElapsedCallback` / `Dbg_Service` 都落在
  `dbg.c.obj`，`__weak` 覆盖生效。

**未上实车验证。** 特别是这几点上板要留意：TIM7 中断里刷屏的替代方案是否真的够快、
A8 短按触发是否会被菜单那一下带偏、暂停后 `AGV_Position_Stop()` 有没有把车真正停住。

---

## 2026-10-04（三）—— dbg 并进 test + `DBG_ENABLE` 开关 + OLED 加显任务码

### 21. 消除"比赛前要手工删调用点"这个坑

**为什么动**：上一节把调试服务的调用点撒进了 `task.c` / `positionPIDcontroller.c` /
`Emm_V5.c` 三个文件。正式比赛不需要暂停和 OLED 刷新，但那时候要停掉它，就得回头把这
三处的调用一个个删掉 —— 删漏一处就是一个隐性依赖，而且是**比赛前**动核心流程文件。
所以把开关做进编译期。

| 文件 | 改动 |
|---|---|
| `UserCode/Src/dbg.c`、`UserCode/Inc/dbg.h` | **删除**，内容整体并入 `test.c` / `test.h` |
| `UserCode/Inc/test.h` | 加 `DBG_ENABLE` 开关；`DBG_ENABLE=0` 时 `Dbg_Init()`/`Dbg_Service()` 退化成宏 `((void)0)` |
| `UserCode/Src/test.c` | 新增第一部分「运行时调试服务」，和第二部分「测试模式分发」并列 |
| `task.c` / `positionPIDcontroller.c` / `Emm_V5.c` | `#include "dbg.h"` → `#include "test.h"`，**调用语句一行没动** |
| `CMakeLists.txt` | 去掉 `UserCode/Src/dbg.c` 一行 |

**投放位置的理由**：调试服务和桌面测试本来就是同一伙东西 —— 上正式流程时两个一起关。
放一个文件里，比赛前只需要看一处。

**两个开关互相独立**，可以任意组合（下面四种组合都编过）：

| 开关 | 默认 | =0 时的行为 |
|---|---|---|
| `TEST_MODE` | 0 | `Test_Switch()` 立刻返回，走 `AGV_Init()` + `TaskProc()` |
| `DBG_ENABLE` | **1** | 调试服务整体不编译；所有调用点变空语句；`HAL_Delay` 不再被接管 |

两个都支持从命令行覆盖（`test.h` 里用 `#ifndef` 挡住默认值），临时编一版不用改文件：

```
cmake ... -DCMAKE_C_FLAGS="-DTEST_MODE=1"             # 测路径
cmake ... -DCMAKE_C_FLAGS="-DTEST_MODE=1 -DDBG_ENABLE=0"
cmake ... -DCMAKE_C_FLAGS="-DDBG_ENABLE=0"            # 比赛正式版
```

### 22. OLED 增加任务码 12 位显示

原来刷的是 `camera.c` 的 `Cam_OLED_Show()`（mode/flag/dx/dy 两行）。现在刷屏换成
`test.c` 自己的 `Dbg_ShowScreen()`，16 号字四行正好铺满 128×64：

```
C:02 F:1            相机帧模式 + 是否识别到目标
x:-13 y:4           偏差(px)
542+312+452+123     任务码：一轮取/放 + 二轮取/放，各 3 位
A8:pause            暂停时变成 --PAUSE-- A8:GO
```

**没有复用 `Cam_OLED_Show()`**：它自己会清屏 + 画 + `OLED_Refresh()`，要再往上加任务码
这行就得再 Refresh 一次，白多约 30 ms 阻塞。改成一次 `OLED_Clear()`、一次画完、
一次 `OLED_Refresh()`。扫码前四个数组还是 BSS 初值 0，所以显示 `000+000+000+000`
是正常现象。

任务码那一行是**手拼**的（不是 `sprintf("%d%d%d+...")`）：12 个值都该是 0~9 的一位数，
拼出来固定 15 字符（120 px < 128）；用 `%d` 编译器不知道值域，会按最长 3 位算长度，
报 `-Wformat-overflow` 说可能溢出。

**编译验证**（四种组合全部零警告零错误）：

| TEST_MODE | DBG_ENABLE | FLASH |
|---|---|---|
| 0 | 1（默认） | 55884 B |
| 1 | 1 | 56020 B |
| 1 | 0 | 55316 B |
| 0 | 0（比赛版） | 55184 B |

（这组数字是第 23 节删掉 `Cam_OLED_Show()` 之后重测的，比该节刚做完时各少约 144 B。）

map 里对过符号落点：
- `DBG_ENABLE=1`：`Dbg_Init` / `Dbg_Service` / `HAL_Delay` 三个都落在 **`test.c.obj`**
  → `__weak` 覆盖生效。
- `DBG_ENABLE=0`：`HAL_Delay` 回到 **`stm32f4xx_hal.c.obj`**（HAL 原版），且全 map 里
  搜不到任何 `Dbg_` 符号 → 确认一行代码没占。

**未上实车验证。**

---

## 2026-10-04（四）—— 删掉 `Cam_OLED_Show()`，全工程只留一份整屏显示

### 23. `Cam_OLED_Show()` 不是死代码，是重复代码

本来是想"用不到就删掉"，但查下来它**还有活引用** —— `Cam_Init()` 里两处：

```c
Cam_OLED_Show();                 /* 探链路循环里反复刷当前帧数据 */
...
if(cam_receive_flag) { cam_start = 1; Cam_OLED_Show(); break; }   /* 链路通了刷首帧 */
```

所以不是删掉就完了，真正的问题是**同一个四行屏有两份实现**（camera.c 那份画 2 行，
test.c 那份画 4 行）。合并成一份：

| 文件 | 改动 |
|---|---|
| `UserCode/Src/camera.c` | 删 `Cam_OLED_Show()` 定义；`Cam_Init()` 里两处调用改 `Dbg_ShowScreen(0)`；加 `#include "test.h"`；删掉不再用的 `#include <stdio.h>` |
| `UserCode/Inc/camera.h` | 删 `void Cam_OLED_Show(void);` 声明 |
| `UserCode/Src/test.c` | `Dbg_ShowScreen()` **移出 `#if DBG_ENABLE`**，并去掉 `static` |
| `UserCode/Inc/test.h` | 加 `#include <stdint.h>`；无条件声明 `void Dbg_ShowScreen(uint8_t paused);` |
| `positionPIDcontroller.c` | 那行注释掉的 `//Cam_OLED_Show();` 改成 `//Dbg_ShowScreen(0);` |

**`Dbg_ShowScreen()` 为什么不跟着 `DBG_ENABLE` 一起关**：
`Cam_Init()` 要显示"链路通了 / camera error"是**上电诊断**，正式流程一样需要，跟
"要不要周期刷新、要不要暂停"是两件事。开关关掉的只是 **TIM7 周期刷新 + A8 暂停**；
渲染函数本身留着，`DBG_ENABLE=0` 时只是没人周期调它，`Cam_Init()` 那两次调用照旧。
代价是比赛版多带这份屏（约 1 KB），换来的是"跑比赛时相机没起来能一眼看见"。

**顺带修的一个看不见的 bug**：超时分支里

```c
OLED_ShowString(8, 32, (uint8_t *)("camera error"), 16, 1);
break;
```

之前**后面没有 `OLED_Refresh()`** —— `OLED_ShowString` 只写显存，不推屏。而上一句
`Cam_OLED_Show()` 内部那次 Refresh 早把屏推完了，所以这行 "camera error" 从来没显示过，
一直躺在显存里直到被 Menu 覆盖。已经补上 `OLED_Refresh()`。

**编译验证**（四种组合，全部零警告零错误）：

| TEST_MODE | DBG_ENABLE | FLASH |
|---|---|---|
| 0 | 1（默认） | 55884 B |
| 1 | 1 | 56020 B |
| 1 | 0 | 55316 B |
| 0 | 0（比赛版） | 55184 B |

map 里 `Dbg_ShowScreen` 两种配置下都落在 `test.c.obj`（确认没被 `--gc-sections` 丢掉）。
全工程搜 `Cam_OLED_Show` 只剩注释里的沿革说明，没有活引用。

**未上实车验证。** 上板要看一眼：`Cam_Init()` 里 `Dbg_ShowScreen()` 现在是整屏 4 行 +
约 30 ms，而它在一个 50 ms 周期的循环里，探链路阶段的实际节拍会比原来慢一点。

---

## 2026-10-04（五）—— 测试框架扩到 6 个模式，初始化下放到各测试自己

### 24. 测试模式表重排

上一节留下的 `test.c` 是坏的：`Test_Switch()` 里调了 `Test_Pick_Scale` /
`Test_Pick_Raw` / `Test_Pick_Place` / `Test_Func` 四个还没写的函数（GCC 14 把
隐式函数声明当 error），另外 `Test_Vision` 改名成 `Test_Correct`、`Test_Pick`
改名成 `Test_Pick_Scale` 之后，上面那两条 `static` 前向声明还挂着旧名字，
编译器各报一条 `-Wunused-function`。

| 模式 | 函数 | 干什么 | 自己初始化什么 |
|---|---|---|---|
| 0 | — | `Test_Switch()` 直接返回，跑正式流程 | — |
| 1 | `Test_AGV` | 依次跑整条路线的各段 | CAN + HWT101 |
| 2 | `Test_Correct` | 夹爪摆观察位 + 问圆盘中心(0x02) + `AGV_Correct` 闭环 | 机械臂 + 相机 + CAN + HWT101 |
| 3 | `Test_Pick_Scale` | `POS_RUN` 上夹爪开合死循环，**不返回** | 机械臂 + CAN |
| 4 | `Test_Pick_Raw` | 原料 A/B/C 框 → 车上 1/2/3 槽（纯动作） | 机械臂 + CAN |
| 5 | `Test_Pick_Place` | 车上 1/2/3 槽 → 圆环 1/2/3 号（纯动作） | 机械臂 + CAN |
| 6 | `Test_Func` | 空壳，留给以后单步测带视觉的完整流程 | 机械臂 + CAN |

### 25. `Test_HwInit()` 缩小成"只做共用的那几样"

原来它把 `AGV_Init()` 前半截整段搬过来（OLED / Dbg / Pick / Cam / DWT / CAN /
YawPID / HWT101 全init一遍）。但各测试需要的硬件其实很不一样 —— 只测臂的
（模式 3~6）不该白等 `Cam_Init()` 那 5 秒超时，只测路径的（模式 1）也不该去
初始化机械臂。现在改成：

```
Test_HwInit()          只做 OLED_Init / Dbg_Init / DWT_Init / YawPID_Init
Test_AGV()             自己开头加 AGV_Can_Init / HWT101_Init
Test_Correct()         自己开头加 Pick_Init / Cam_Init / AGV_Can_Init / HWT101_Init
Test_Pick_Scale/Raw/Place/Func()   自己开头加 Pick_Init / AGV_Can_Init
```

**所以选模式 3~6 时相机和陀螺仪是没起来的，OLED 上 `C:00 F:0` 不是坏了。**
每个测试自己那几行初始化就写在它函数开头，看得见、好改，不用在两处之间来回对。

### 26. 各测试的动作时序

**模式 3 `Test_Pick_Scale`** —— `Pick_JumpTo POS_RUN` 之后 `for(;;)` 里
`Pick_Gripper_Grab()` → `HAL_Delay(3000)` → `Pick_Gripper_Observe()` →
`HAL_Delay(3000)`。用途是对着看夹爪转到位没有、会不会顶到料；改 `pick.h` 里的
`PICK_GRAB` / `PICK_OBSERVE` 烧一次就能一直看。**这个函数永不返回**，所以
`Test_Switch()` 末尾那句 `for(;;){}` 到不了，是有意的。期间 A8 暂停照常可用。

**模式 4 `Test_Pick_Raw`** —— 新增了一个文件内静态helper
`Test_GrabRawToCar(box, slot)`，照 `pick_task.c` 的 `GrabRawBoxToCar()` 抄的，
只去掉 `direct` 分支（固定走门字形 `Pick_JumpTo`）。时序：
`Pick_JumpTo POS_RAW_x` → `Pick_TurnTable_Set(slot)` → `Pick_Gripper_Grab()` →
`Pick_JumpTo POS_CAR` → `Pick_Gripper_Release()`。
**这段时序在工程里是第二份** —— 选的是"test.c 里直接写"，不动 `pick_task.h`。
改 `pick_task.c` 那段时记得同步，函数注释里写了这句提醒。

**模式 5 `Test_Pick_Place`** —— 直接用 `pick_task.h` 现成的宏，没有抄第二份：
```c
GRAB_AND_PLACE_TO_RING_SLOT(0, 1);   /* 车上 1 槽 → 圆环 1 号 */
GRAB_AND_PLACE_TO_RING_SLOT(1, 2);
GRAB_AND_PLACE_TO_RING_SLOT(2, 3);
```
这个宏展开出来就是 `pick_task.c` 那个静态函数 `PlaceToRing()`，和正式流程
`Place_ROUGH()` 是同一段时序，只是环号写死 1/2/3。

**模式 6 `Test_Func`** —— 只起硬件就停住。注释里写明了往里加内容时的坑：
`Pick_RAW` / `Place_ROUGH` 这些依赖任务码数组，不先跑 `QRcode_Task()` 灌进去
的话 `Pick_Color_List()` 读到的全是 0，颜色匹配永远不中，表现是"臂动了两下就收工"；
第二轮那几个还要先把 `RerunFlag` 置 1。

**顺带删掉**：`test.c` 里那条 `extern uint8_t RerunFlag;` —— 原来只有 `Test_Pick`
用它，那个函数已经拆掉了，留着是死声明。

**编译验证**（四种开关组合全部零警告零错误）：

| TEST_MODE | DBG_ENABLE | FLASH |
|---|---|---|
| 1（当前默认） | 1 | 56012 B |
| 0 | 1 | 55884 B |
| 1 | 0 | 55308 B |
| 0 | 0（比赛版） | 55184 B |

**未上实车验证。** 模式 4 的 A→1 / B→2 / C→3 转盘映射（0°/120°/240°）没在实机上
核对过 —— 如果装上发现槽位对不上，先看 `Pick_TurnTable_Set()` 的转角定义再说。

---

## 2026-10-05 —— 模式 7：相机指令轮询（0x00~0x05 每 5 秒一条）

### 27. 为什么不能直接用 `Cam_RequestXxx()`

最初的想法是"每 5 秒轮流发一遍所有命令"。但 `camera.c` 的 `Cam_WaitSettle()` 是
**两段阻塞等待**：第一段等"相机回帧的命令码 == 刚发出去的那条"（每 100ms 补发，
固定 10s 超时），第二段等这条命令回 `flag!=0`（`settle_ms`，调用方一般也传 10s）。
相机没接或某条命令相机不认的时候，**一条命令能卡 20 秒** —— "每 5 秒换一条"根本
做不到。更别扭的是卡住期间 `cam_mode` 不刷新，OLED 上 `C:` 还是上一条的值，
看起来像死机而不是在等。

**改成"只发不等"。** 协议本身支持这么做：`Cam_Init()` 的 0x00 把相机唤醒之后，
相机会**持续**往回发它当前模式的数据（[camera.h:33](UserCode/Inc/camera.h#L33)
"相机在任何模式下都会持续回数据"）。所以发一条 `AA 02 BB` 出去就不用管了，
结果自己去看 `cam_mode` / `cam_flag` / `dx` / `dy`。

### 28. `Cam_SendCommand()` 新增（camera.c / camera.h）

对外暴露一个非阻塞发送。原来只有 `Cam_SendIdle()` 是对外的，而它内部用的
`static Cam_SendCmd()` 只支持无参数帧（0x01 要带三色、0x05 要带一色，都不够用）。

| 文件 | 改动 |
|---|---|
| `UserCode/Inc/camera.h` | 新增 `void Cam_SendCommand(uint8_t cmd, const uint8_t *payload, uint8_t plen);` |
| `UserCode/Src/camera.c` | 新增同名实现（包一层原来的 `Cam_SendCmdPayload`）；**删掉** `static Cam_SendCmd()`，`Cam_SendIdle()` 改成调 `Cam_SendCommand(CAM_CMD_IDLE, NULL, 0)` |

### 29. `Test_Camera()`（模式 7）

```c
Cam_Init();          /* 等相机启动(5s超时) + 起 DMA 接收 */
/* AGV_Can_Init() 原在这里，只为 A8 暂停；现已上移到 Test_HwInit()，见第 30 节 */

for(;;)
    for(i = 0..5)
    {
        Cam_SendCommand(cmd_tbl[i], arg_tbl[i], plen_tbl[i]);
        分 50 片 × HAL_Delay(100) 等 5 秒，每片插一次 Cam_Service();
    }
```

命令表：`0x00~0x05` 六条全发。带参数的只有 `0x01`（三色填 `1 2 3`）和
`0x05`（颜色号填 `2`），其余 `plen=0`。

**等待切成 100ms 一片是为了中间插 `Cam_Service()`** —— 串口一旦出错，HAL 会把 DMA
接收中止且不自动重挂，不补这一句的话一次错误就让 OLED 上的数据永远定住，
看着像相机坏了。100ms 是 `camera.h` 里写的调用周期。

**0x00 保留在轮询里**是有意的：它会让相机 sleep，正好能看出来"被唤醒之后还会不会
继续回"。

**屏幕没改**（底行仍是 `A8:pause`）。所以读屏的判据是 `C:` 那行的**回帧命令码**要在
每次换命令后跟着变；一直停在某个值不动 = 相机不认新命令。这个不直观，是因为
屏幕四行已经排满、没法再加一行"我发的是哪条"，权衡下来先不动布局。

**编译验证**（零警告零错误）：

| TEST_MODE | DBG_ENABLE | FLASH |
|---|---|---|
| 1（当前默认） | 1 | 56024 B |
| 7 | 1 | 56080 B |
| 0 | 1 | 55896 B |
| 7 | 0 | 55376 B |

**未上实机验证。** 上板第一件事是看 `C:` 会不会按 5 秒节奏在 00~05 之间走 ——
不走的话要么是相机没接、要么是它不认某条命令。

### 30. `AGV_Can_Init()` 上移到 `Test_HwInit()`

**起因**：模式 7 里为了 A8 暂停能正常发停车帧，单独补了一句 `AGV_Can_Init()`。
顺着往下一想 —— 这个理由对**每个**模式都成立，不该只在模式 7 里补。

A8 暂停是 `Dbg_Service()` 干的，在 `Dbg_Init()` 开了 TIM7 之后，**任何一个测试
模式按下 A8 都会生效**。而暂停第一件事就是 `AGV_Position_Stop()`，它往 CAN 上
发四轮停车帧、每发一句等 `EMM_V5_ACK_TMO_MS`(200ms) 的应答。CAN 没初始化时
这些帧全是空等，按下去要愣一下才停 —— 卡顿大小随模式而变，很难查。

**改法**：`AGV_Can_Init()` 从 7 个测试函数里删掉（模式 1~7，共 7 处），
统一挪到 `Test_HwInit()`，紧跟 `Dbg_Init()` 之后：

```c
OLED_Init();
Dbg_Init();           /* TIM7 调试服务 */
AGV_Can_Init();       /* ← 新位置 */
DWT_Init();
YawPID_Init();
```

`Core/Src/can.c:203` 的 `AGV_Can_Init()` = `USER_CAN1_Filter_Init()`
+ `HAL_CAN_Start()` + `HAL_CAN_ActivateNotification()` + `HAL_Delay(500)`，
**没有任何前置依赖**，所以插在哪都行。它自带的 500ms 延时正好借来等 CAN 稳定，
放在最前面不额外浪费。

**为什么不是"每个测试按需初始化"**：原则是"只测臂的不用白等相机"。CAN 不属于
这一类 —— 它不白等，`HAL_Delay(500)` 是实测需要的一次性开销；而且除了模式 7
（只发串口）和模式 1、2，剩下几个模式本来都要 CAN 驱动机械臂的步进电机。
多花的只有模式 7 的 500ms，换来"任何模式下按暂停都立即响应"。

**正式流程不受影响**：`task.c:32` 的 `AGV_Init()` 里那句 `AGV_Can_Init()` 保留
不动 —— TEST_MODE=0 时 `Test_Switch()` 直接返回，两条路径不会重复初始化。

**编译验证**（零警告零错误）：

| TEST_MODE | DBG_ENABLE | FLASH |
|---|---|---|
| 1（当前默认） | 1 | 56024 B |
| 0 | 1 | 55896 B |
| 7 | 1 | 56080 B |
| 7 | 0 | 55376 B |
| 0 | 0 | 55196 B |

`UserCode/Inc/test.h` 的初始化说明同步改了：原先写"Test_HwInit() 只做共用的
那几样（OLED / DWT / 航向PID）"，补上 CAN 和它进来的理由。

### 31. 新增 `Dbg_Suspend()` / `Dbg_Resume()`：启动菜单期间不被刷屏

**问题**：`AGV_Init()` 的顺序是 `OLED_Init → Dbg_Init → ... → Menu_Init`
（[task.c:27-35](UserCode/Src/task.c#L27-L35)），所以**菜单起来时 TIM7 已经在跑**。
而 `Menu_Init()` 里那个 `HAL_Delay(15)` 在 DBG_ENABLE=1 时被
[test.c:200](UserCode/Src/test.c#L200) 盖掉、内部会调 `Dbg_Service()` ——
200ms 的刷屏节拍一到，`Dbg_ShowScreen(0)` 就把菜单画面整个覆盖成相机数据。

`Menu_Display()` 只在**首次**和**按 C6/C8 时**调，被刷掉后不会自动回来。
实际现象：调试模式下菜单闪一下就消失，看不到 `Route:`，按 C6/C8 也只闪一下。
比赛时（DBG_ENABLE=0）无此问题 —— `Dbg_Service()` 是空语句、TIM7 也不开。

**改法**：`Dbg_Service()` 开头加一个挂起判断，整个服务让路。

| 文件 | 改动 |
|---|---|
| `UserCode/Src/test.c` | 新增 `static volatile uint8_t s_suspended`；`Dbg_Service()` 的早退条件从 `s_in_service \|\| __get_IPSR() != 0U` 扩成再或上 `s_suspended`；新增 `Dbg_Suspend()` / `Dbg_Resume()` |
| `UserCode/Inc/test.h` | 声明这两个函数；`#else` 分支里加两条 `((void)0)` 宏，DBG_ENABLE=0 时调用点自动消失 |
| `UserCode/Src/menu.c` | `#include "test.h"`；`Menu_Init()` 进函数先 `Dbg_Suspend()`，A8 退出前 `Dbg_Resume()` |

**挂起期间为什么连"暂停"也一起挡掉**：菜单里 A8 是**启动键**，不该同时是暂停键。
（就算不挡也触发不了 —— `s_key_armed` 要见过一次"松开"才置 1，而它置 1 的那一刻
正是 A8 被松开、菜单已经把控制权交出去的时候。但让语义明确更好。）

`Dbg_Resume()` 里额外置 `s_refresh_req = 1`：`Menu_Init()` 退出时 `OLED_Clear()`
过，别等下一个 200ms 节拍再刷，返回后第一处 `HAL_Delay` 就画出来。

**顺带确认过的一个疑问**：A8 是"按下沿"触发（稳定 3 拍 ≈30ms 即生效，**不必等
松手**），不是长按；按住不放只触发一次。`menu.c` 的 `Key_Scan()` 和 `test.c` 的
扫描逻辑是同一套。菜单的"启动"与运行期的"暂停"不冲突，因为 `Menu_Init()` 是
开机一次性阻塞、退出后永不返回，两者不会同时活跃。

**编译验证**（零警告零错误）：

| TEST_MODE | DBG_ENABLE | FLASH |
|---|---|---|
| 1（当前默认） | 1 | 56116 B |
| 0 | 1 | 55988 B |
| 7 | 1 | 56172 B |
| 7 | 0 | 55376 B |
| 0 | 0 | 55196 B |

后两行和上一版**逐字节相同** —— DBG_ENABLE=0 时 `Dbg_Suspend/Resume` 是空宏，
菜单那句调用编译后不存在，证实了开关确实没漏。另用 `nm` 确认两个 DBG_ENABLE=0
的 elf 里都没有任何 `Dbg_` 符号。

**未上实机验证。** 上板看：调试模式下菜单应能一直停在屏上，按 C6/C8 正常切换
Route；按 A8 启动后画面才切成相机数据。

### 32. 新增 `TEST_CAN_ENABLE`：台架没接电机时跳过 CAN

**问题**：桌面上只测视觉、没接步进电机时，程序卡死在 `AGV_Can_Init()`。
根因不在初始化代码本身，而在 CAN 的**总线同步**：

`MX_CAN1_Init()` 里 `hcan1.Init.Mode = CAN_MODE_NORMAL`。`HAL_CAN_Start()`
要等 INAK 清零，而这一步得先在总线上同步到 **11 个隐性位** —— 总线上没有第二个
节点时永远等不到。HAL 自己有超时，超时后返回 `HAL_ERROR`，接着：

```c
if(HAL_CAN_Start(&hcan1) != HAL_OK) { Error_Handler(); }   /* Error_Handler = while(1); */
```

就停在 [`Error_Handler()`](Core/Src/main.c#L181) 里了。

**只跳过 `AGV_Can_Init()` 会更糟。** A8 暂停第一件事是 `AGV_Position_Stop()`：

```
AGV_Position_Stop() → Emm_V5_Stop_Now() → can_SendCmd()
                                       → can.c  while(HAL_CAN_AddTxMessage(...) != HAL_OK);
```

CAN 没 Start 过时 `HAL_CAN_AddTxMessage` 恒返回错误，这个 `while` **永远出不来**。
于是按一下 A8 就死机，而且再按一次也救不回来（已经不在 `while(s_paused)` 里）。
所以两处必须**同进同出**。

**改法**：`test.h` 加第三个开关 `TEST_CAN_ENABLE`，test.c 里包住两处。
**当前默认值设为 0**（2026-10-05 当天改的，对应当前 `TEST_MODE 7` 只测视觉的台架）；
接上电机、或比赛前要改回 1。

| 文件 | 改动 |
|---|---|
| `UserCode/Inc/test.h` | 新增第三个开关 `TEST_CAN_ENABLE`（`#ifndef` 包着，默认 1），带一段说明为什么两处要一起关 |
| `UserCode/Src/test.c` | `Test_HwInit()` 的 `AGV_Can_Init()` 包 `#if TEST_CAN_ENABLE`；`Dbg_Service()` 暂停分支的 `AGV_Position_Stop()` 同样包起来 |

**用法**：台架没接电机时 `-DTEST_CAN_ENABLE=0`，或直接在 test.h 里把那行改成 0。
**此时不要去选模式 1~5**（都要 CAN 驱动电机），会卡在 `can_SendCmd()` 的 while 上
而不是初始化阶段。纯视觉只跑模式 7；模式 6 目前是空壳。

**正式比赛保持 1** —— 比赛时 CAN 必须起来，起不来就该 `Error_Handler()` 停住报警，
不该静默降级继续跑。（`AGV_Can_Init()` 超时不再 `Error_Handler()`、改成返回失败 +
`g_can_ready` 标志，是另一个更彻底的改法，能顺带修掉"比赛时 CAN 线接触不良就
`while(1)` 变砖"这个隐患；这次没动，后面单独做。）

**编译验证**（零警告零错误）：

| TEST_MODE | DBG_ENABLE | TEST_CAN_ENABLE | FLASH |
|---|---|---|---|
| 7 | 1 | 1 | 56172 B |
| **7（当前默认）** | **1** | **0** | **56164 B** |
| 1 | 1 | 0 | 56108 B |
| 0 | 1 | 1 | 55988 B |

开关生效的证据（`objdump` 数 `bl` 到目标函数的行数，含符号标签那行）：

| | `AGV_Can_Init` | `AGV_Position_Stop` |
|---|---|---|
| TEST_CAN_ENABLE=1 | 3 行 = 标签 + Test_HwInit + task.c 正式流程 | 3 行 = 标签 + Dbg_Service + AGV_Correct |
| TEST_CAN_ENABLE=0 | 2 行 = 标签 + task.c 正式流程 | 2 行 = 标签 + AGV_Correct |

各少一处，正是 test.c 里的那两处；`AGV_Correct()` 和 `AGV_Init()` 的调用保留
（前者只在模式 2 用到，后者是正式流程）。

**未上实机验证。** 上板看：没接电机时程序应能过 `Test_HwInit()` 进到模式 7 的
相机轮询，A8 暂停仍能进出（只是不发停车帧）。

### 33. 新增模式 8 `Test_OLED()`：屏幕自检（硬件问题 vs TIM7 刷屏问题）

**背景**：视觉通信修完之后，OLED 整块屏幕完全没反应。要区分的是两件完全不同的事：
屏/接线坏了，还是 TIM7 那个 200ms 刷屏把屏冲没了。

**思路：把甲段做成"没有 TIM7 的干净环境"**。模式 8 在 `Test_HwInit()` 里
**跳过 `Dbg_Init()`**（这是关键——TIM7 正是本测试的变量，不能提前起），
甲段全是手写画面；乙段再由 `Test_OLED()` 自己手工 `Dbg_Init()` 把 TIM7 起起来。
两段段首都在屏上打标记字，一眼能看出卡在哪一段。

| | 段首标记 | 内容 | 判读 |
|---|---|---|---|
| 甲段 | `A1 OLED OK` | 全黑↔全白闪 3 下，再打 4 行字停 5s | 闪了/出字了 → 屏、软件 I2C、PB6/PB7 全好，问题在乙段；一动不动 → 查硬件（VCC/GND、SCL/SDA 接反、3.3V、上拉） |
| 乙段 | `B1 TIM7 ON` | 手工 `Dbg_Init()` 后打标记屏，`HAL_Delay(5s)` 期间每 200ms 会被调试画面覆盖 | 变成调试画面 → TIM7 刷屏链路正常；还是 `B1` → 中断没进来；全黑/雪花 → 刷屏这条路有问题 |
| 尾段 | `B5 my screen` | `Dbg_ShowScreen` ↔ 手写画面 每 2s 来回切，死循环 | 长时间盯着看会不会自己坏掉 |

**顺带排除掉的一个变量：DWT**。`oled.c` 是软件 I2C，每一位靠 `delay_us(1)` 撑时序，
而 `delay_us` 读的是 `DWT->CYCCNT`。DWT 没初始化时 `usTick == 0`，`delayTicks`
算出来是 0，那个 while 一次都不转 —— 等于没有延时，SCL/SDA 会飙到几 MHz，
SSD1306 收不到就整屏不亮。而 `Test_HwInit()` 里 `OLED_Init()` 排在 `DWT_Init()`
**前面**，所以 `Test_OLED()` 开头 `DWT_Init()`（幂等）+ 再 `OLED_Init()` 一次，
把初值顺序这个变量彻底排除。

**排除掉的一个伪线索**：`Dbg_ShowScreen()` 的文字全用 `mode 0`，而
`OLED_ShowChar()` 里 `mode` 是"画笔值"（`(temp & bit) ? mode : !mode`），所以
mode 0 是**反色**（白底黑字），不是"画到黑底上看不见"。查了 `oled.c` 确认，
不是 bug，不用改。

**改动**：

| 文件 | 改动 |
|---|---|
| `UserCode/Inc/test.h` | 模式表加第 8 行；`TEST_MODE` 默认 7 → 8（查完 OLED 记得改回去）；`TEST_CAN_ENABLE` 那段补一句"模式 8 只碰 OLED 不用 CAN" |
| `UserCode/Src/test.c` | 加 `static void Test_OLED(void);` 声明；`Test_HwInit()` 里 `Dbg_Init()` 包 `#if TEST_MODE == 8`；新增 `OLED_TestFill()` + `Test_OLED()`；`Test_Switch()` 加 `case 8` |

**用法**：默认就是 8，直接烧。查完把 `TEST_MODE` 改回 7（纯视觉）或 0（正式流程）。

**编译验证**（零警告零错误）：

| TEST_MODE | DBG_ENABLE | TEST_CAN_ENABLE | .text+.data |
|---|---|---|---|
| **8（当前默认）** | **1** | **0** | **56436 B** |
| 7 | 1 | 0 | 56152 B |
| 6 | 1 | 1 | 56036 B |
| 3 | 1 | 1 | 56092 B |
| 0 | 1 | 1 | 55828 B |

模式 8 比模式 7 多 284 B，就是 `Test_OLED()` + `OLED_TestFill()`。

开关生效的证据（`objdump` 数 `bl` 目标）：

```
Test_HwInit  → OLED_Init, DWT_Init, YawPID_Init        ← 没有 Dbg_Init，跳过生效
                                                           也没有 AGV_Can_Init（CAN 那个开关=0）
Test_OLED    → DWT_Init×1, OLED_Init×1, OLED_TestFill×3,
               Dbg_Init×1, Dbg_ShowScreen×1, HAL_Delay×6,
               OLED_ShowString×11, OLED_Clear×3, OLED_Refresh×3
Test_Switch  → Test_HwInit + Test_OLED
```

**未上实机验证。** 上板先看甲段：黑白闪没闪、`A1~A4` 那四行字出没出 —— 这一步
就能把"硬件"和"TIM7"分开。甲段正常但乙段 5 秒后屏上不是调试画面，再照上面那张
表往下查。

---

## 2026-10-11 —— 视觉串口从 A16/A17 换到 A18/A19（MaixCAM 开机被打断的根因）

### 34. 别用 A16/A17 接 STM32：那是 MaixCAM 的引导控制台

**现象**：MaixCAM 启动时如果 STM32 的 TX 已经接上，MaixCAM **自己的程序起不来**；
先让 MaixCAM 启动完再接上，就一切正常。

**根因**：接的是 **A16/A17 = UART0 = `/dev/ttyS0`**，这是 MaixCAM 的
**系统串口 / 引导控制台**，不是给用户外设用的：

- bootloader（U-Boot）盯着这根线打日志，**开机时线上有数据就可能打断自动启动**，
  掉进命令行，App 自然起不来；
- 这类 SoC（SOPHGO/全志系）的 **BROM 本身就支持在 UART0 上做串口下载**，
  开机瞬间 UART0 一有动静就可能被拖住，连引导阶段都过不去。

还有一个副作用能解释为什么"启动后接就没事"：控制台开机时跑 **115200**，而
`camera.c` 是 **9600**，MaixCAM 启动阶段的日志对 STM32 是乱码、STM32 发的数据对
bootloader 也是乱码 —— **但乱码也是字节，照样能打断自动启动**。等 App 起来、
口归 App 管了（baud 被改成 9600），就互不干扰了。

**改法（只改 MaixCAM 侧，STM32 一个字没动）**：换成
**A18/A19 = UART1 = `/dev/ttyS1`**，MaixPy 文档推荐的用户通信口，跟系统日志
完全分开。改的是**相机上跑的那份 `视觉代码.py`**（不是仓库这份，见待办第 10 条）：

```python
UART_DEV    = "/dev/ttyS1"
UART_PIN_RX = ("A18", "UART1_RX")
UART_PIN_TX = ("A19", "UART1_TX")
```

接线（**别接反**）：

| MaixCAM | 方向 | STM32 |
|---|---|---|
| A19（UART1_TX） | → | PA10（USART1_RX） |
| A18（UART1_RX） | ← | PA9（USART1_TX） |
| GND | ↔ | GND |

改完已确认正常。

**排查时顺带确认的**（免得以后再查一遍）：

- USART1 的引脚是 `GPIO_NOPULL`（PA9/PA10，AF7，[usart.c](Core/Src/usart.c) 的
  `USART1_MspInit`）—— 这是 CubeMX 默认值，**不是 bug**。
- 万用表量 TX/RX 都是 3.3V 也**不代表有上拉**：TX 是 AF 推挽**主动驱动**的，
  UART 空闲电平本来就是高，3.3V 是推出来的；RX 是 `NOPULL` 输入，量到**稳定**
  3.3V 只能说明对面 MaixCAM 的 TX 在驱动它（空闲也是高）—— 反而是"线是通的"的证据。
- **所以加上拉解决不了这个启动问题**，别往那个方向改。

**遗留风险（这次没解决）**：`Cam_Init()` 只等 **5 秒**
（[camera.c:27](UserCode/Src/camera.c#L27) `CAM_INIT_TMO_MS`）。MaixCAM 启动 +
加载模型要十几秒，如果 STM32 先上电或两边同时上电，5 秒一到就超时、屏上
`camera error`，**整条视觉流程当场废掉**。换口解决的是"MaixCAM 起不来"，
**没有**解决这个超时 —— 现在能跑说明上电顺序是对的（MaixCAM 先起）。比赛时整机
一个电源开关，这条要留意：要么保住上电顺序，要么把超时放宽 / 改成上电后先静默几秒。

### 35. OLED 全黑排查进展（**未结**）

模式 8 已经跑过：甲段（TIM7 没起）和乙段（起了 TIM7）**都没有任何反应**。据此
把代码这条路排除掉了：

| 查了 | 结果 |
|---|---|
| PB6/PB7 引脚配置 | [gpio.c:70-75](Core/Src/gpio.c#L70-L75) `OUTPUT_PP` / `HIGH`，配好了 |
| 引脚被别的外设抢 | TIM4→PD12、全工程**没有硬件 I2C**、只有 gpio.c 碰这两个脚 |
| 软件 I2C 时序 | SCL=PB6 / SDA=PB7、地址 0x78、CMD 0x00 / DATA 0x40 都对 |
| `delay_us` 空转（DWT 没起） | `Test_OLED()` 里 `DWT_Init()` 在先，已排除 |
| `mode 0` 画不出来 | 不是 bug：`mode` 是画笔值，0 = 反色，看得见 |
| TIM7 / 陀螺仪 | 模式 8 都不碰（`HWT101_Init` 只在 task.c / 模式 1 / 模式 2） |

**中途撤回过一个推测**：`OLED_Init()` 里确实没有 `0x8D/0x14`（开电荷泵），
而 `OLED_DisPlay_On()` 里有、且全工程无人调用 —— 但**冷启动一直能亮**，说明这块屏
不吃那条命令，init 命令表本身没问题，推测不成立。

**结论：指向 MCU / 线 / 屏 三者之一，没量电分不出来。** 下一步要么**直接换一块
好的 OLED 模块**，要么在模式 8 开头加一段 **PB6/PB7 慢速翻转（1 Hz）** 用万用表
顺着量：STM32 脚 → 模块排针 → 模块 VCC。

---

### 36. 高度步进电机的机械比例从 8mm/圈 更正为 60mm/圈 + 新增模式 9 `Test_Pick_HR`

**问题**：`pick.c` 一直写着"高度电机逆时针一圈 = 8mm"（`PICK_MOTOR_Z_MM_PER_REV 8.0f`，
即 3200/8 = **400 脉冲/mm**），但机械上实测**一圈 = 60mm**，差了 **7.5 倍**。

后果：任何一次 `Pick_MotorZ_MoveToMM(30)` 想走 3cm，会发 30×400 = 12000 脉冲
= 3.75 圈 = 实走 **225mm = 22.5cm**。

**顺带从 `POS_*` 那批位置宏也能看出旧数字是错的**：`POS_OBSERVE_CIRCLE` 的高度
写 140mm，按 8mm/圈 要 56400 脉冲 = **17.6 圈**（机械上不可能），按 60mm/圈 是
**2.3 圈**（合理）。所以 60 才对，8 是笔误。

**改了什么**（`HARDWARE/Src/pick.c`）：

| 常量 | 改前 | 改后 |
|---|---|---|
| `PICK_MOTOR_Z_MM_PER_REV` | `8.0f` | `60.0f` |
| `PICK_MOTOR_Z_MM_PUL`（推导） | 400 脉冲/mm | **53** 脉冲/mm |

注意 3200/60 = 53.33 被 `(int32_t)` 截断成 **53**，换算偏小约 **0.6%**
（走 140mm 差 0.8mm）。要更准得把宏和两处乘法的中间量改成浮点，**留到行程实测
确认后再定**，这次只改比例本身。

**新增模式 9 `Test_Pick_HR`** —— 用来实测高度电机的**方向**和**比例**：

- `pick.c`：实现 `Pick_Test_MotorZ()`（该函数在 `pick.h:100` 一直只有声明、没有实现）
  ```c
  for(;;) {
      Pick_MotorZ_MoveToMM(30.0f);   /* → 30mm，1590 脉冲 ≈ 半圈 */
      HAL_Delay(3000);
      Pick_MotorZ_MoveToMM(0.0f);    /* → 回 0mm(上电位置) */
      HAL_Delay(3000);
  }
  ```
  用 **mm 绝对位置接口**（零点 = 上电位置），先 +30 再回 0，一正一反都在同一坐标里，
  不会越走越偏；不像"发相对脉冲"那样每轮都要重新对齐。
- `test.c`：`Test_Pick_HR()` = `Pick_Init()` → `Pick_Test_MotorZ()`；`Test_Switch()`
  加 `case 9`。（走 `Pick_Init()` 是和模式 3/4/5 一个路子，它内部那句
  `Pick_JumpTo POS_START` 只动高度到 10mm、半径目标 0mm 等于不动，不干扰本测试。）
- `test.h`：模式表加第 9 行；`TEST_MODE` 默认 7 → **9**；
  `TEST_CAN_ENABLE` 默认 0 → **1**（模式 9 要 CAN，且高度电机得真接在总线上，
  否则卡在 `can_SendCmd()` 的 while）。
- `pick.h`：顺手给 `Pick_Test_ZServo` / `Pick_Test_Gripper` / `Pick_Test_MotorR`
  三个声明标上"**尚未实现**，只有声明"（之前看不出来）。

**判读方法**（屏现在是坏的，靠看臂 + 卡尺）：

| 看什么 | 现象 → 结论 |
|---|---|
| 方向 | 0→30mm 时臂**上升** = 方向对；**下降** = `PICK_MOTOR_Z_POS_DIR` 改成 1 |
| 比例 | 量到 30mm = 60mm/圈 对了；量到 4mm ≈ 还是 8mm/圈；别的数按比例回推 |
| 响应 | 每步卡满 5s（`PICK_MOTOR_DONE_TMO`）才动 = 电机没在线 / 没使能 / 地址不对 |

**两条安全提醒**：
1. **跑之前把臂放到行程中段**（上下各留 5cm 以上）再上电 —— 方向没确认前，
   30mm 万一往限位那侧走，贴着边起跑就直接顶死。
2. **A8 暂停在这个测试里救不了** —— `Dbg_Service` 的暂停只给四个轮发停车
   （[test.h:99](UserCode/Inc/test.h#L99) 那段），**不停臂的高度/半径电机**。要停只能断电。

**验证**（`arm-none-eabi-objdump` / `size`）：

- 调用图符合设计：`Test_Pick_HR` → `Pick_Init` + `Pick_Test_MotorZ`；
  `Pick_Test_MotorZ` → 2×`HAL_Delay` + 2×`Pick_MotorZ_MoveToMM`；
  `Pick_MotorZ_MoveToMM` → `Pick_StepperMove` → `Emm_V5_ClearRxFrame` /
  `Emm_V5_Pos_Control` / `Emm_V5_WaitArrive`。
- 常量池里是 `0x42540000 = 53.0f`（新的 3200/60）和 `0x43160000 = 150.0f`（钳位），
  `60.0f` 已被编译期折叠掉 —— 即 30mm 真的下发 **1590 脉冲**。
- 回归：模式 0/3/5/7/8/9 全部 **0 警告**通过；text 大小
  模式 9 = **56084 B**，模式 0（正式流程）= 55832 B。

**未做**：半径电机(`Pick_Test_MotorR`)没实现 —— 用户说"先测试高度"，等高度方向和
比例定下来再按同一套路补。半径电机的比例(`PICK_MOTOR_R_MM_PER_REV 100.0f` → 32 脉冲/mm)
**同样没实测过**，跑之前得先用同样的办法验。

另外 `pick.c:34` 那句 `PICK_MOTOR_Z_MAX_MM 150.0f /* 高度行程上限 0~100mm */`
注释自相矛盾（150 vs 0~100），没动 —— 真实行程是多少要等实测。

---

### 37. 半径电机测试 `Pick_Test_MotorR()`：补一个**阻塞版**接口

用户要求"和 z 轴测试功能一样"。照抄之前先解决一个接口不对等的问题：

| | 高度轴(地址5) | 半径轴(地址6) |
|---|---|---|
| mm 绝对位置接口 | `Pick_MotorZ_MoveToMM()` —— **阻塞**，等到位回执 | 只有 `Pick_MotorR_MoveToMM_Issue()` —— **不等回执**（正式流程要它跟舵机并行） |

直接用 Issue 版照抄会丢掉两个东西：① 走没走到位不确定，3 秒停顿量出来的尺寸不算数；
② **"每步卡满 5 秒 = 电机没在线"这个掉线诊断就没了**（Issue 版发完就走）。

所以新增 `static void Pick_MotorR_MoveToMM(float mm)`（[pick.c](HARDWARE/Src/pick.c)，
紧跟在 Issue 版后面）——钳位/增量/跟踪逻辑和 Issue 版一字不差，只把
`Pick_StepperMove_Issue()` 换成阻塞的 `Pick_StepperMove()`。**只有测试用它，
正式流程一个字没动。**

`Pick_Test_MotorR()` 与 `Pick_Test_MotorZ()` 完全对称：

```c
for(;;) {
    Pick_MotorR_MoveToMM(30.0f);   /* 30mm = 960 脉冲 = 0.3 圈(按 100mm/圈) */
    HAL_Delay(3000);
    Pick_MotorR_MoveToMM(0.0f);
    HAL_Delay(3000);
}
```

**怎么切轴**：两个都是一次不返回的死循环，所以 `test.c` 的 `Test_Pick_HR()` 里
一次只激活一个，写成了注释互换（和 `Pick_Init` / `Pick_DebugTest` 一个路子）：
```c
Pick_Test_MotorZ();               /* 高度轴 */
//Pick_Test_MotorR();             /* 半径轴：测完高度把那两行换个注释 */
```

**顺手修的两处错注释**（都是直接和代码矛盾的）：
- `pick.c:19` 原写"实测**两电机均需** dir=1"，但 `PICK_MOTOR_Z_POS_DIR` 明明是 **0**
  —— 改成"两个轴方向可以不同，当前 Z=0 / R=1，**两个数都还没实测过**"。
- `pick.h` 里 `Pick_Test_MotorR` 的"尚未实现"标签去掉，补上实际行为。

**验证**：
- **`--gc-sections` 会把没人调用的测试整个回收掉**（符号表里查不到 `Pick_Test_MotorR`），
  所以照常编译看不到它 —— 为了验用户"取消注释就能跑"那条路，临时把 `test.c` 里的
  调用点互换、重编、验完再换回来（换回后 md5 校验一致）。结果：
  `Test_Pick_HR` → `Pick_Init` + `Pick_Test_MotorR`；`Pick_Test_MotorR` →
  2×`HAL_Delay` + 2×`Pick_MotorR_MoveToMM`；`Pick_MotorR_MoveToMM` → `Pick_StepperMove`。
  半径版常量池里是 `0x42000000 = 32.0f`（100mm/圈）和 `0x42AA0000 = 85.0f`（钳位）。
- 回归：模式 0/3/5/7/8/9 全部 **0 警告**；text 模式 9 = 56060 B，模式 0 = 55808 B。

---

## 2026-10-14 —— 舵机接线调整：Z轴 与 车上转盘 两路对调

### 38. `SERVO_Z` / `SERVO_TURN` 的定时器和引脚互换（`servo.c` / `servo.h`）

接线动了两路：**Z轴旋转** 和 **车上转盘** 对调，夹爪没动。

| | 改前 | 改后 |
|---|---|---|
| Z轴旋转 (`SERVO_Z`) | PA5 = TIM2_CH1，预分频 83 | **PE9 = TIM1_CH1，预分频 167** |
| 夹爪 (`SERVO_GRIP`) | PA6 = TIM3_CH1，预分频 83 | 不变 |
| 车上转盘 (`SERVO_TURN`) | PE9 = TIM1_CH1，预分频 167 | **PA5 = TIM2_CH1，预分频 83** |

**关键点：对调的是"定时器+通道+引脚+AF+预分频"这一组，不是整个配置块。**
两类的归属完全不同：

- **跟着定时器走的**：`TIM` / `CH` / `PORT` / `PIN` / `AF` / **`PRESCALER`**。
  预分频是给定时器用的 —— TIM1 挂在 APB2（168MHz）要 **167**，TIM2 挂在 APB1
  （84MHz）要 **83**。要是预分频跟着**引脚**走忘了换，TIM1 会被配成 83，
  PWM 周期变成 10ms/100Hz，舵机抖动或不动作（`servo.c` 顶部配置区那段说明
  就是专门讲这个的）。
- **跟着"哪一路舵机"走的（一点没变）**：角度量程、脉宽、上电初始角、加减速参数。
  Z轴还是 0°~360° / 上电 86°，转盘还是 0°~270° / 上电 0°=A 槽。
  `ServoId` 枚举和 `servoCfg[3]` 的行序也都没动（`SERVO_Z=0 / GRIP=1 / TURN=2`）。

**动之前先确认了没有别的地方也在配这三个脚**（结论：没有，所以只改 `servo.c`）：

| 查了 | 结果 |
|---|---|
| 生成的 `stm32f4xx_hal_msp.c` | **只有 `HAL_MspInit()`**，TIM1/2/3 的 MspInit 一个都没有 —— CubeMX 配引脚那部分早被剥掉了 |
| `htim1` / `htim2` / `htim3` | `Core/Inc/tim.h` 里只有 `extern` 声明，**全工程无人使用** |
| 别处引用 PA5 / PE9 | 全工程 0 处（`oled.c` 里那句 PA0/PA1 的 `GPIO_Init` 本来就是注释掉的） |
| `.ioc` | `PE9.Signal=S_TIM1_CH1`、`PA6=S_TIM3_CH1`；**PA5 根本没在里面**，TIM2_CH1 反而挂在 PA0 上 —— .ioc 和实际接线早就不一致了，但因为它生成不了 MspInit，对固件没有影响。**没有改 .ioc** |

**验证**（直接从 ELF 的 `.rodata` 把 `servoCfg[3]` 表读回来解，比看源码可靠）：

| 表项 | 定时器 | 引脚 | 预分频 | 角度/初始角 |
|---|---|---|---|---|
| `[0] SERVO_Z` | `0x40010000` = TIM1 | `GPIOE`+`GPIO_PIN_9` = **PE9** | **167** | 0~360 / 86° ✅没变 |
| `[1] SERVO_GRIP` | `0x40000400` = TIM3 | `GPIOA`+`GPIO_PIN_6` = PA6 | 83 | 0~270 / 110° ✅没变 |
| `[2] SERVO_TURN` | `0x40000000` = TIM2 | `GPIOA`+`GPIO_PIN_5` = **PA5** | **83** | 0~270 / 0° ✅没变 |

回归：模式 0/3/5/7/8 全部 **0 警告**。

**没做**：`.ioc` 没同步（见上表）。要是以后从 CubeMX 重新生成，注意 TIM2_CH1
在它眼里还是 PA0 —— 不过 `servo.c` 会自己把 PA5/PE9 配回来，实际不受影响。

---

### 39. 模式 9 改名 `Test_Motor` + 加转盘舵机子测试 `Pick_Test_TurnTable()`

**改名**：`Test_Pick_HR` → **`Test_Motor`**（`test.c` 声明/定义/`case 9`、`test.h`
模式表都改了；全工程 grep 旧名字 0 处）。名字不再叫 "Pick_HR" 是因为它已经不只
测高度和半径了。

**新增 `Pick_Test_TurnTable()`**（`pick.c`，紧跟 `Pick_Test_MotorR()`）：
A槽(0°) → B槽(120°) → C槽(240°) → 循环，每处停 3 秒。走的还是现成的
`Pick_TurnTable_Set(slot)`，所以自带 `SERVO_T_SETTLE_MS` 到位裕量。

一次验三件事：
1. **换线对不对** —— 转盘是唯一挂在 **PA5/TIM2** 上的舵机（2026-10-14 刚从
   PE9/TIM1 换过来，见第 38 节）。它转起来 = 这条链通了；纹丝不动而别的舵机正常，
   先回去查 PA5 的线和 TIM2 的预分频（要 **83**）。
2. **三个槽的角度** —— `PICK_TURN_ANG_A/B/C` = 0/120/240（`pick.h`），看是不是
   正好停在三个料位上，要微调改那三个宏。
3. **方向和一圈走不走得完** —— 从 A 槽出发转一圈回 A 槽，看有没有卡住/丢步。

现在模式 9 下面是**三个平级的死循环子测试**，在 `Test_Motor()` 里换注释切换：

```c
Pick_Test_MotorZ();               /* 高度轴：死循环，不返回 */
//Pick_Test_MotorR();             /* 半径轴：把上面那行注释掉、这行打开 */
//Pick_Test_TurnTable();          /* 转盘舵机：A(0°)/B(120°)/C(240°)，不需要 CAN */
```

**两条安全/依赖说明**（都写进注释了）：
- 转盘子测试**不需要 CAN** —— 纯舵机，走 `Servo_SetAngleSmooth`，只要
  `Servo_Init()` 起着就行（`Test_Motor()` 开头的 `Pick_Init()` 已经起了）。
  步进电机那两个仍然必须 `TEST_CAN_ENABLE=1`。
- **转盘转的时候臂不能在车体上方** —— `Pick_TurnTable_Set()` 的时序约定本来就是
  "先选槽，再 `Pick_JumpTo POS_CAR`"，转盘带料转时臂压着会把料扫飞。本测试靠
  `Pick_Init()` 已经把臂收到 `POS_START`(运输位) 来保证安全。

**验证**：
- **`--gc-sections` 又来了** —— 转盘子测试没被激活时整个被回收，所以照旧用
  "临时换注释 → 重编 → 验 → 换回（md5 校验一致）" 的办法验：
  `Test_Motor` → `Pick_Init` + `Pick_Test_TurnTable`；`Pick_Test_TurnTable` →
  `HAL_Delay` + `Pick_TurnTable_Set`；`Pick_TurnTable_Set` → `HAL_Delay` +
  `Servo_SetAngleSmooth`。
- `Pick_TurnTable_Set()` 里那个 `static const ang[3]` 从 `.rodata`
  (`0x0800c0a8`) 读回来是 **0.0 / 120.0 / 240.0** —— 和 `PICK_TURN_ANG_A/B/C` 一致。
- 回归：模式 **0/3/4/5/7/8/9** 全部 **0 警告**（这次把模式 4 也加进来了，它走
  `Pick_TurnTable_Set`，是改动影响面里最该回归的那个）。

---

### 40. 模式 9 再加 Z轴舵机子测试 `Pick_Test_ZServo()`（0°/100°/50°）

`Pick_Test_ZServo()` 在 `pick.h` 里从很早就只有声明、没有实现，这次按"和第 39 节
转盘那套一个路子"补上：0° → 100° → 50° → 循环，每处停 3 秒。走的还是
`Servo_SetAngleSmooth(SERVO_Z, ...)` + `HAL_Delay(SERVO_Z_SETTLE_MS)`。

一次验三件事：
1. **换线对不对** —— Z轴是第 38 节里和转盘对调的另一半，从 PA5/TIM2 换到了
   **PE9/TIM1**。它摆起来 = 这条链通了；不动而别的舵机正常，先查 PE9 的线和
   TIM1 的预分频（要 **167**，配成 83 会得到 100Hz、抖动或不动作）。
   **转盘和 Z轴是一起对调的，验的时候两个都要看**，别只动了一个就下结论。
2. **三个角对不对** —— 看 0°/100°/50° 停到位时的姿态是不是你要的。要调就改
   `Pick_Test_ZServo()` 里 `ang[3]` 那三个数，或者改 `pick.h` 里 `POS_*` 那批宏的
   第一个值(角度z)，两者是同一个坐标系。
3. **方向和行程** —— 每步跨的角度都不小，看有没有反向、卡住、舵机拉不动
   （拉不动会有持续堵转声）。

模式 9 下面现在是**四个平级的死循环子测试**：

```c
Pick_Test_MotorZ();               /* 高度轴：死循环，不返回 */
//Pick_Test_MotorR();             /* 半径轴：把上面那行注释掉、这行打开 */
//Pick_Test_TurnTable();          /* 转盘舵机：A(0°)/B(120°)/C(240°)，不需要 CAN */
//Pick_Test_ZServo();             /* Z轴舵机：0°/100°/50°，不需要 CAN（臂先抬高）*/
```

**安全**：摆 Z 轴之前**臂必须先抬起来** —— `Pick_Init()` 留下的运输位
`POS_START` 高度只有 **10mm**，0°/100°/50° 这么大范围摆很容易蹭桌面或车体。
`Pick_Test_ZServo()` 故意**不自己抬臂**（一调 `Pick_JumpTo` 就又要 CAN 了，
而纯舵机测试本来应该 CAN 没接也能跑），所以抬臂这件事留在外面自己做。

**顺带记一笔**：`SERVO_Z_START_ANG` 已从 `86.0f` 改成 **`0.0f`**（上电停在
0°，即量程起点）。第 38 节那张"角度/初始角没变"的表里写的 86° 是当时的状态，
现在以 `servo.c` 里的 `0.0f` 为准 —— 那节想说明的是"这些参数跟着哪一路舵机走、
没跟着引脚跑"，这一点不受影响。

**验证**（还是"临时换注释 → 重编 → 验 → 换回(md5 校验一致)"，因为
`--gc-sections` 会回收没激活的那个）：
- `Test_Motor` → `Pick_Init` + `Pick_Test_ZServo`；
  `Pick_Test_ZServo` → 2×`HAL_Delay` + `Servo_SetAngleSmooth`。
- `Pick_Test_ZServo()` 里 `static const ang[3]` 从 `.rodata`(`0x0800c0d8`) 读回来是
  **0.0 / 100.0 / 50.0**；函数里的 `0x3f4ccccd = 0.8f` 是 `SERVO_Z_STEP_DEG`。
- 回归：模式 0/3/4/5/7/8 全部 **0 警告**。

---

### 41. 转盘选槽改成**直给角度**，不再走平滑

`Pick_TurnTable_Set()` 原来是

```c
Servo_SetAngleSmooth(SERVO_TURN, ang[slot], SERVO_T_STEP_DEG, SERVO_T_STEP_MS);
HAL_Delay(SERVO_T_SETTLE_MS);
```

改成

```c
Servo_SetAngle(SERVO_TURN, ang[slot]);   /* 直给，不分步 */
HAL_Delay(PICK_TURN_SETTLE_MS);          /* 等舵机物理转到位 */
```

**为什么**：转盘带料一转 120°，平滑那套按 `SERVO_T_STEP_DEG=0.8°`/`SERVO_T_STEP_MS=1ms`
要分 150 步、150ms 才把命令发完，把事情白拖长；而 `Servo_SetAngleSmooth` 只管"命令
发出去了"，本来就保证不了物理停稳。直给是一句话把比较寄存器改掉，舵机立刻按自己
的最高速转，更快也更干脆。

**新增一个宏**（pick.c 可移植配置区）：

```c
#define PICK_TURN_SETTLE_MS 500   /* 转盘选槽后等它物理停稳的时间(ms) */
```

500ms 的算法：常见舵机约 0.15~0.2s/60°，120° 约 300~400ms，带料再加余量。
**这个宏和 servo.h 里的 `SERVO_T_SETTLE_MS` 不是一回事**，后者是平滑版收尾的裕量，
现在平滑版已经不用了，所以另外立一个，别改错地方。

**没删的那个 Delay 是承重的**：直给只保证命令发出去，转盘没停稳臂就下去会撞料。
函数头、`pick.h` 的声明注释里都写了这句"不能删"。另外各调用点（`pick_task.c` 的
`GrabRawBoxToCar`/`PlaceToRing`、四个 `*_SLOT` 宏、两个测试）都是
`Pick_TurnTable_Set(slot); Pick_JumpTo POS_CAR;`，后面那个摆臂动作本身要好几秒，
转速再慢也早转到位了 —— 所以 500ms 是个兜底，真实风险不大。

**servo.h 里那组 `SERVO_T_*` 平滑参数现在没有调用点了**，标注了"已停用"，没删
（留着当想用平滑时的现成一组值）。**改它们对选槽行为不再有任何影响** ——
要调停稳时间去改 `PICK_TURN_SETTLE_MS`。

**验证**：
- `Pick_TurnTable_Set` 反汇编：`movs r0, #2` + `bl <Servo_SetAngle>`，
  **没有** `Servo_SetAngleSmooth` 的调用；紧跟 `mov.w r0, #500` + `bl <HAL_Delay>`，
  即 `PICK_TURN_SETTLE_MS` 生效。
- 全工程 `Servo_SetAngleSmooth` 的调用点只剩 Z轴（`Pick_JumpTo`/`Pick_MoveTo`/
  `Pick_Test_ZServo`）和夹爪三处，转盘已经出列。
- 回归：模式 **0/4/7/8 + 默认 9** 全部 **0 警告**。

---

### 42. Z轴舵机量程 360° → 270°（换舵机）

`servo.c` 配置区一行：

```c
#define SERVO_Z_MAX_ANG   270.0f      /* 原来是 360.0f */
```

脉宽没动，还是 500~2500us。**这不是把行程限窄了，是换舵机带来的换算基准变化**：
同样 2000us 的脉宽跨度，按 360° 算是 **5.56us/°**，按 270° 算是 **7.41us/°** ——
差 33%。也就是说**同一个"命令角"现在物理转得更远**。

`Servo_SetAngle` 是 `pulse = minPulse + (angle-minAngle) × (maxPulse-minPulse)/(maxAngle-minAngle)`，
所以 maxAngle 一改，整条角度→脉宽曲线就跟着变了；`Servo_GetAngle` 的反推和
超量程钳位也是同一条曲线，自动跟着走，不用另外改。

**⚠ 要重新对位的东西**：`pick.h` 里 `POS_*` 那批宏的第一列(角度z)。数值本身不用动
（还是"命令角"），但**每一个姿态的实际物理位置都偏了**。按 270° 舵机算，这次改完
才是"命令角 = 物理角"，改之前那批角度其实是被 360° 的换算压小的（比如命令 90°，
在 270° 舵机上只走到 67.5°）—— 所以这次是往"对"的方向修，但姿态是照旧映射调出来
的，**正式跑之前每个都要重新对一遍**。对位时可以从"旧值 × 0.75"起步再微调
（不过要注意这不是线性等价，只是给个起点）。

本工程现有的角度 z 值最大是 230°（`POS_1`/`POS_1_HIGE`），**没有任何一个超过 270**，
所以不会触发钳位、没有哪一处被静默削掉。

**验证**（从 ELF 的 `.rodata` 把 `servoCfg[3]` 整表解出来，段首 `0x154`、步长 44 字节）：

| 路 | tim | port | pin | AF | psc | 量程 | 脉宽 | 起始角 |
|---|---|---|---|---|---|---|---|---|
| Z | TIM1 0x40010000 | GPIOE | PIN_9 | 1 | **167** | **0.0~270.0** | 500~2500 | 0.0 |
| G | TIM3 0x40000400 | GPIOA | PIN_6 | 2 | 83  | 0.0~270.0 | 500~2500 | 0.0 |
| T | TIM2 0x40000000 | GPIOA | PIN_5 | 1 | 83  | 0.0~270.0 | 500~2500 | 0.0 |

- `360.0f` 在整个 `.rodata` 里**已经一次都不出现**了。
- 三路的 port/pin/AF/psc 还是第 38 节对调后的状态，没被这次改动带偏。
- 回归：模式 **0/3/4/5/7/8/9** 全部 **0 警告**。

**注释同步**：`servo.c` 文件头与配置区、`servo.h` 文件头与 `ServoId` 注释、
`pick.h` 的 `POS_*` 段和 `Pick_JumpTo/Pick_MoveTo` 的 `servoZ` 说明、`pick.c` 两处
`@param servoZ`，全部由 360° 改成 270°，并写明了"要重新对位"。
顺带在 `servo.c` 注明：**这一天改了两件事别混淆** —— ①两路引脚对调 ②Z轴量程换舵机。

---

### 43. 转盘选槽**撤回直给，改回平滑**（第 41 节的回退）

第 41 节把 `Pick_TurnTable_Set()` 改成了 `Servo_SetAngle` 直给 + 自立的
`PICK_TURN_SETTLE_MS(500)`；这次按设计撤回去，恢复成和 §8 一致的样子：

```c
Servo_SetAngleSmooth(SERVO_TURN, ang[slot], SERVO_T_STEP_DEG, SERVO_T_STEP_MS);
HAL_Delay(SERVO_T_SETTLE_MS);
```

- **删掉 `PICK_TURN_SETTLE_MS`**（pick.c 那个宏没有了，全工程已无引用），
  停稳裕量重新归 `servo.h` 的 `SERVO_T_SETTLE_MS` 管 —— 一处配置，不用两头找。
- **`SERVO_T_SETTLE_MS` 由 0 恢复成 300**（§8 当初定的值）。置 0 等于"命令发完立刻
  返回"，而 `Servo_SetAngleSmooth` 只保证命令角发完了、舵机追命令还有滞后，
  这时"阻塞到停稳"这句合同就是假的，臂可能压在没停稳的转盘上。
  **如果当初是特意设成 0 的，说一声改回去**（一个数）。
- `SERVO_T_RAMP_STEPS` 保持 **0**（不是我改的，我也不动）。含义：分步是匀速的，
  没有加减速段 —— 仍是"平滑分步"，只是起步不缓、收尾不减速。
  §8 的设计里 Z 轴那路是 `RAMP_STEPS=30`；转盘要不要也来一段加减速，你定。
- `servo.h` 里第 41 节标的"已停用"全部去掉，那几个参数**重新生效**。

**验证**：
- `Pick_TurnTable_Set` 反汇编：`movs r0,#2` + `bl <Servo_SetAngleSmooth>`
  （**没有** `Servo_SetAngle`），入参 `r1=1`(STEP_MS)、`s1=0.8f`(STEP_DEG，
  字面量池 `0x8008fc0` = `0x3f4ccccd`)；随后 `mov.w r0,#300` + `bl <HAL_Delay>`，
  即 `SERVO_T_SETTLE_MS` 生效。
- 全工程 `PICK_TURN_SETTLE_MS` 已经没有任何引用。
- 回归：模式 **0/3/4/5/7/8/9** 全部 **0 警告**。

---

### 44. 修编译：`POS_RUN` 被误删，全工程 8 处调用点全报错

**症状**：`pick_task.c` / `task.c` / `test.c` / `pick.c` 里每个 `Pick_JumpTo POS_RUN;`
都报两条：`statement with no effect [-Wunused-value]` + `expected ';' before 'POS_RUN'`。

**原因**：不是那 8 处有问题，问题全在 [pick.h] —— 调姿时改上面几个宏，
`#define POS_RUN (90.0f, 10.0f, 10.0f)` 这**一整行连带被删掉了**。
宏没了，`POS_RUN` 就成了一个未声明的标识符，于是每个调用点
`Pick_JumpTo POS_RUN;` 被解析成"两个相邻的表达式"，才同时冒出
"缺分号"和"语句无效果"这两条看着毫不相关的错。

**修法**：按原样把那一行补回来（值 `(90.0f, 10.0f, 10.0f)`），并在旁边标明
**这个值没跟着这次的调姿重新对过** —— 只负责让它编过。

**排查方法记一笔**（以后再遇到"一片地方同时报缺分号"）：这类错误 99% 不在报错的那一行，
而是某个**宏/声明在你没看的那一侧被改了**。看 `file:line` 是没用的，要看
`预期出现的那个符号（这里 POS_RUN）在哪儿定义的`。

**同时修正两处被改值带旧的注释**（都是纯注释，不改行为）：
- `pick.h` 顶部的例子还写着 `POS_CAR` 展开成 `(4.0f, 31.0f, 28.0f)`，
  实际已经改成 `(30.0f, 45.0f, 5.0f)`。
- `PICK_TURN_ANG_A/B/C` 那段的注释还写着 `0°/120°/240°`，实际是 **30/150/270**。
  顺带记了个坑：**C 槽的 270.0f 正好压在 `SERVO_T_MAX_ANG` 上限**，
  钳位是 `> maxAngle` 才生效所以现在合法、能到，但**一点余量都没有** ——
  以后谁把 `SERVO_T_MAX_ANG` 调小一点，C 槽会被静默钳到别处去。

**验证**：
- **清空 `build/Debug` 全量重编**：45/45 通过，**0 警告 0 错误**，FLASH 56168 B。
- 8 个 `POS_RUN` 调用点全部解析到（pick.c ×1、pick_task.c ×4、task.c ×1、test.c ×3）。
- 回归：模式 **0/3/4/5/7/8/9** 全部 **0 警告**。

---

### 45. 非 0 模式加"一键启动"：`Test_Switch()` 先阻塞等 A8 短按

`Test_Switch()` 在 `Test_HwInit()` **之后**、`switch(TEST_MODE)` **之前**插入一句：

```c
Test_HwInit();
Test_WaitStartKey();    /* 阻塞等 A8 短按 */
switch(TEST_MODE) { ... }
```

**为什么要放 Test_HwInit() 之后而不是真正的第一行**：那会儿 OLED 已经亮着，
能显示 `MODE n / press A8 / to start`；CAN 也起完了（自带 500ms 等稳定）。
放最前面的话屏是黑的，只能盲按。目的是"手上还没准备好时不用赶着上电" ——
先把臂挪到行程中段、把车摆正、尺子拿在手上，再从从容容按一下。

**按键**：就是 menu.c 的启动键 **A8**（`GPIOA` PIN_8，上拉输入，按下低电平）。
`MX_GPIO_Init()` 在 `main()` 里（早于 `Test_Switch`）已经配好，不用再初始化。

**两个必须做的事**（第一个不做会出问题，第二个不做留个隐患）：

1. **`Dbg_Suspend()` / `Dbg_Resume()` 包住**。DBG_ENABLE=1 时 TIM7 早在
   `Test_HwInit()` 里就跑起来了，而 A8 在调试服务里是**暂停键**。不挂起的话：
   - 本函数里的 `HAL_Delay` 被 test.c 盖过、内部会调 `Dbg_Service()`，
     200ms 一到就把"按 A8 启动"整屏刷成相机数据画面，提示消失且不再回来；
   - 按 A8 这一下会先被当成"暂停"，启动和暂停打架。
   挂起期间 `Dbg_Service` 整个让路（它开头那句 `s_suspended` 判断）。
   DBG_ENABLE=0 时这两个是空语句。
   —— 这套和 `Menu_Init()` 的做法**一模一样**，抄的就是它。

2. **消抖 + "先松后按"**。扫描 15ms 一拍、连续 3 次同电平算稳定（≈45ms），
   和 menu.c 的 `Key_Scan` 同一套参数。多出来的 `armed` 是**故意和 menu.c 不一样**
   的地方：`Menu_Init()` 在"上电时就按着 A8"的情况下 45ms 后会直接启动；这里
   要求**先见过一次松手**这次按下才算数，否则等于没有这道关卡。

**没动的东西**：
- `TEST_MODE == 0` 那条分支（`{ return; }`）**不经过**这个函数 —— 正式流程一个字没变，
  正式流程的等待仍然是 `AGV_Init()` 末尾的 `Menu_Init()`。
- A8 在测试跑起来之后**还是暂停键**，行为不变；只是启动那一瞬间它归本函数管。
- 没给"按 C6 切路线"：等待期间只认 A8。（模式 1 要测另一条路线就改 `Route_id` 初值重烧。）

**验证**：
- `Test_Switch` 反汇编调用序列：`Test_HwInit` → **`Test_WaitStartKey`** → `Test_Pick_Raw`
  （switch 分发），顺序正确。
- `Test_WaitStartKey` 的调用点：`Dbg_Suspend` / `Dbg_Resume` 各 1、
  `OLED_Clear` 2、`OLED_ShowString` 3、`OLED_Refresh` 1、`HAL_GPIO_ReadPin` 1、`HAL_Delay` 1。
- 提示串 `"MODE %d"` / `"press A8"` / `"to start"` 都在 `.rodata` 里；
  三行画在 `x=8, y=16/32/48`，字号 16。
- 消抖常量：`movs r0,#15` + `bl HAL_Delay`（扫描周期）；`cmp r3,#2 / bhi` 即
  "cnt<3 才自增"、`cmp r3,#2 / bls` 即 "cnt>2 才算稳定"；按键引脚 `r1=0x100`(PIN_8)。
  "先松后按"也在：`raw==0` 时置 armed，`raw!=0 && armed` 时 break。
- **模式 0 的 ELF 里没有 `Test_WaitStartKey` 符号** —— 正式流程编出来完全不含这段。
- 回归：模式 **0/1/2/3/4/5/7/8/9** 全部 **0 警告**。

**顺带清掉一批被改值带旧的注释**（纯注释，17 处，不改行为）：转盘三个槽的角度
`0°/120°/240°` → **`30°/150°/270°`**，散落在 `pick.h` / `servo.h` / `servo.c` /
`pick.c` / `pick_task.h` / `pick_task.c` / `test.h` / `test.c`。另外 `test.h` 里
`TEST_MODE` 的注释还写着"模式 9"，而值早就是 **4** 了，一起改成 4。

### 46. 模式 9 再加夹爪子测试 `Pick_Test_Gripper()`（走 3 轮，停在抓紧）

**要解决的问题**：夹爪那三个角度（`PICK_OBSERVE 15°` / `PICK_GRAB 129°` /
`PICK_RELEASE 75°`）**从来没有被单独验过**。以前只在整条取放动作里顺带出现过，
爪口有没有张开到该有的位置、抓紧时是不是真的夹住、放开时松不松得开，都没拿
眼睛在台架上对着看过一遍。而且 **2026-10-14 那次 Z轴↔转盘 对调没碰夹爪**
（夹爪是唯一在 PA6 / TIM3 上的舵机），这条通路是不是通的，也一直是个假设。

**函数写在 `HARDWARE/Src/pick.c`，紧挨着 `Pick_Test_ZServo()`**，签名和另外几个
`Pick_Test_*` 一致（`void` / 死循环 / 不需要 CAN）：

```
3 轮 × ( Pick_Gripper_Observe()  → 15°   张最开
         HAL_Delay(1000)
         Pick_Gripper_Grab()     → 129°  收紧夹住
         HAL_Delay(1000)
         Pick_Gripper_Release()  → 75°   松到放开
         HAL_Delay(1000) )
Pick_Gripper_Grab()              → 129°  第 3 轮停在"放开"，补一次"抓紧"收工
HAL_Delay(1000)
for(;;) { Dbg_Service(); }
```

**按 15 → 129 → 75 走，不是按 15 → 75 → 129 走**：三个角度在角度轴上是
`15 < 75 < 129`，现在这个顺序每轮都从一头扫到另一头再回来，**整个行程每轮都
过一遍**——行程不够或者半路卡住，第一轮就看得出来。走升序的话每轮只走半个
行程，卡在中间反而看不出来。

**跑完停在"抓紧"**：舵机靠 PWM 保持角度，程序停在空转里爪口也不会松，正好
拿最后这个姿态去量夹持力/对物料尺寸。

**`pick.c` 新加了 `#include "test.h"`**，只为了末尾那个 `Dbg_Service()`。
原因和 `Emm_V5.c` / `positionPIDcontroller.c` 一样：这个空转是**纯自旋**，
不经过被 `test.c` 盖掉的 `HAL_Delay`，不手工调一下就没人调 —— 于是 A8 暂停和
OLED 刷新会整个失效，跑起来像死机（其实是没死，只是没人刷屏、按 A8 也没反应）。
`DBG_ENABLE=0` 时 `Dbg_Service()` 是个空宏，这个循环就退化成纯空转，正合适。

**三个测试入口/文档同步改的地方**：
- `pick.h`：`Pick_Test_Gripper()` 的声明注释从"**尚未实现**，只有声明"改成实际行为。
- `pick.c`：函数头一整段判读说明（见上）；`Pick_Test_TurnTable` 等既有注释里
  残留的 `0°/120°/240°` 换成 `30°/150°/270°`。
- `test.c`：`Test_Motor()` 的横幅从"两个舵机"扩成**五个子测试**，补上夹爪
  那一行和"为什么非测不可"，并注明**这是五个里唯一会返回的子测试**；
  调用点加了 `//Pick_Test_Gripper();`（和另外几个一样，一次只留一行没注释）。
- `test.h`：模式 9 那一行的说明扩成五条，注明**三个舵机都不用 CAN**。

**验证**（`--gc-sections` 开着，没被调用的测试函数连符号都会被收掉，所以必须
**临时把调用点的注释去掉、用 `TEST_MODE=9` 单独编一版**再看）：

- `TEST_MODE=9` 编译 **0 警告 0 错误**，FLASH 56516 B。
- `Test_Motor` → `Pick_Init` ×1 + `Pick_Test_Gripper` ×1（`bl` 反查）。
- `Pick_Test_Gripper` → `Pick_Gripper_Observe` ×1 / `Pick_Gripper_Grab` ×**2** /
  `Pick_Gripper_Release` ×1 / `HAL_Delay` ×**4** / `Dbg_Service` ×1。
  Grab 两次 = 循环里 1 次 + 循环后补的 1 次；Delay 四次 = 循环里 3 次 + 补的那次。
- **轮数真的是 3**：`movs r3,#0` 起头，循环体末尾 `cmp r3,#2` + `bls` 回跳
  → r3 = 0/1/2，正好三轮。
- **末尾是真的死循环**：最后 `bl <Dbg_Service>` 后面跟 `b.n` 跳回自己，
  不是跳出函数。
- **三个角度都对**：`Pick_Gripper_Observe` 里直接是 `vmov.f32 s0,#46`
  → `0x41700000` = **15.0**；`Grab` / `Release` 走字面量池，取出 `00 00 01 43`
  → `0x43010000` = **129.0**、`00 00 96 42` → `0x42960000` = **75.0**。
  三处的 `r0=1`（`SERVO_GRIP`）、`s1=1.0`（`SERVO_G_STEP_DEG`）、`r1=2`
  （`SERVO_G_STEP_MS`）也都对，说明走的是平滑版 `Servo_SetAngleSmooth`。
- 验证前 `test.c` md5 `44933593…`，`sed` 改 → 编 → 验 → `trap` 还原后
  md5 一致，无 `.md5bak` 残留，临时构建目录 `build/tmpG` 已删。

**一个容易踩的坑（记下来省得下次再懵）**：`TEST_MODE` 是编译期常量，
`Test_Switch()` 那个 `switch` 会被**整个折叠**，非当前模式的所有测试函数
都变成不可达代码、被 `--gc-sections` 连符号一起收掉。所以
**`TEST_MODE=4` 编出来的 ELF 里根本搜不到 `Test_Motor` 这个符号**，
不代表函数写坏了 —— 查符号必须用对应模式的 ELF。

### 47. 夹爪舵机换 180° 量程（`SERVO_G_MAX_ANG` 270 → 180）

**需求**：夹爪舵机物理上换成 180° 的了，固件里的量程跟着改。

**改的就是一个数**（[servo.c](../../HARDWARE/Src/servo.c) 顶部配置区）：

```c
#define SERVO_G_MAX_ANG   180.0f   /* 原 270.0f */
```

引脚/定时器/通道/预分频/脉宽全部不动 —— 只换舵机，没动接线。夹爪仍然是
`PA6 = TIM3_CH1`，预分频仍然是 **83**（TIM3 在 APB1，84MHz）。（`83` 是跟着
**定时器**取的，不是跟着引脚 —— 这个坑 2026-10-14 对调那会儿踩过一次。）

**实际影响**：脉宽跨度还是 500~2500us 那 2000us，量程从 270° 缩到 180° 之后

| | 每度脉宽 |
|---|---|
| 旧 (270°) | 2000/270 = **7.41 us/°** |
| 新 (180°) | 2000/180 = **11.11 us/°** |

**同一个"命令角"现在物理转 1.5 倍远** —— 跟 Z 轴那次 360→270 是同一类问题。

**`pick.h` 的三个夹爪角度这次故意没动**（按用户选择，留着原值当参照），
所以 `PICK_OBSERVE / PICK_GRAB / PICK_RELEASE` 指向的爪口位置全都偏了，
**烧之前必须重对**。等比缩（× 180/270 = 0.667）的起点：旧的 15/129/75 →
**10 / 86 / 50**，可以当另一组参照。对位用**模式 9 的 `Pick_Test_Gripper()`**
（正好 2026-10-14 刚加的，观察/抓紧/放开 走 3 轮）或**模式 3 的
`Test_Pick_Scale()`**（开合死循环）。

好消息：三个数都远小于 180，**不会触发 `Servo_SetAngle` 里 `> maxAngle`
那句钳位**，不存在被静默削角的坑（这点跟 `PICK_TURN_ANG_C = 270.0f` 顶在量程
上限的情况不一样）。

**⚠ 挂了一个必须上台架确认的假设**：这里沿用"500~2500us 对应 0~180°"，跟原来
270° 那款一致。但 **180° 舵机里有不少是 1000~2000us 对应 0~180° 的**
（MG996R 一类）。要是新舵机属于后者，现在这套参数会把行程两端顶死 →
持续堵转、嗡嗡响、发烫。**验法**：单独给 `0.0f` 和 `180.0f`，看舵机是不是
刚好停在机械两端。不对就把 `SERVO_G_MIN/MAX_PULSE` 一起改，改完三个角度又要
重对一遍。这一段已经写进 servo.c 的夹爪配置区注释了。

**顺带把"抄死的度数"全换成引用宏名**（因为这三个数正在重对，抄一份就会旧一份）：
`pick.h` / `pick.c` / `test.c` / `test.h` 里凡是写着 `15°/129°/75°` 或
`观察15°/抓紧129°/放开75°` 的地方，改成 `PICK_OBSERVE/PICK_GRAB/PICK_RELEASE`
或"观察/抓紧/放开"，具体度数统一指向 `pick.h`。涉及
`Pick_Test_Gripper()` 的函数头 + 内联注释、`Test_Motor()` 横幅、
`test.h` 模式 9 那一行、`Pick_Test_Gripper()` 的声明注释。

**顺手修的两处旧注释错误**（`test.c` 的 `Test_Pick_Scale()`）：
1. 第 494 行 `/* 释放：对着看 PICK_GRAB 角度 */` —— 释放那行写的是 `GRAB`，
   是复制粘贴没改，应该是 `PICK_RELEASE`。
2. 函数头写"只让夹爪在**两个**角度之间来回"，实际循环体是
   `Grab → Release → Observe` **三个**状态。

**验证**：`ninja -C build/Debug` → **0 警告 0 错误**。
从 ELF 的 `.rodata` 里把 `servoCfg[3]` 解出来（stride 44，注意结构体里
`af` 后面补 2 字节、`rampSteps` 后面补 3 字节，所以 `minAngle` 在 **+20**、
`maxAngle` 在 **+24**，不是顺排）：

```
servoCfg @ .rodata+0x174
  Z   (PE9)  pin=512  minAng=0.0  maxAng=270.0  pulse=500~2500  rampSteps=30
  GRIP(PA6)  pin=64   minAng=0.0  maxAng=180.0  pulse=500~2500  rampSteps=30   ← 改到了
  TURN(PA5)  pin=32   minAng=0.0  maxAng=270.0  pulse=500~2500  rampSteps=0
```

Z 轴和转盘仍是 270，没被带改；夹爪的引脚(64=`GPIO_PIN_6`)和脉宽没动。

### 48. 按键分工重排：A8 启动 / C8 暂停 / C6 换路线

**要解决的问题**：A8 原来是"启动键 + 运行时暂停键"一个人兼。上电按 A8 启动，
而 TIM7 中断同时也在扫 A8 当暂停 —— 启动那一下会先被当成一次暂停，两个角色打架。
`menu.c` 里 C8 又和 C6 一样都能换路线，C8 再兼暂停就更乱了。

**改完之后的三个键，各管各的**：

| 键 | 引脚 | 唯一用途 | 在哪扫 |
|---|---|---|---|
| A8 | `GPIOA PIN_8` | 启动（菜单确认 / 测试"一键启动"） | `menu.c` 的 `Menu_Init`、`test.c` 的 `Test_WaitStartKey` |
| C6 | `GPIOC PIN_6` | 换路线（菜单里 `Route_id ^= 1`） | `menu.c` 的 `Menu_Init` |
| C8 | `GPIOC PIN_8` | 运行时暂停/继续 | `test.c` 的 `HAL_TIM_PeriodElapsedCallback`（TIM7） |

### 具体改动

**`UserCode/Src/menu.c`**
- 删掉 `key_res`（C8）整个键：`KEY_RES_GPIO/PIN` 两个宏、`key_res` 状态量、
  以及 `if(Key_Scan(&key_route) || Key_Scan(&key_res))` 里的 `||` 那一半。
  现在是 `if(Key_Scan(&key_route))`。
- ⚠ **必须连变量一起删，不能只删判断**：`key_res` 变成没人用的 `static` 之后
  `-Wall` 会报 `-Wunused-variable`。（`Key_Scan` 本身是通用的，留着。）
- 文件头 / `Menu_Init` 的 docblock 跟着改，顺手把里面两个旧数字对正：
  原来写"扫描周期固定 **20ms**，连续 **2** 次相同判定为稳定(40ms消抖)"，
  实际 `KEY_SCAN_PERIOD_MS` 是 **15**、`KEY_DEBOUNCE_CNT` 是 **3**（≈45ms）。

**`UserCode/Src/test.c`**
- 暂停键 `DBG_KEY_*` 从 `GPIOA/PIN_8` 改成 **`GPIOC/PIN_8`**。
- 新增 `START_KEY_GPIO/PIN` = `GPIOA/PIN_8`，`Test_WaitStartKey()` 改用它。
  原来那个函数读的也是 `DBG_KEY_*` —— 一个宏给两个角色用，正是这次要拆开的东西。
- **两个宏都挪到了 `#if DBG_ENABLE` 外面**（原来 `DBG_KEY_*` 定义在开关里面）。
  这是个**真的会编不过的坑**，不是洁癖：`Test_WaitStartKey()` 在
  `TEST_MODE != 0` 时无条件编进去，而它引用那个宏 —— 只要
  `-DDBG_ENABLE=0` 编任何一个非 0 模式就会炸。已验证（见下面"验证"第 4 条）。
- OLED 上的按键提示串 `"A8:pause"` → `"C8:pause"`、
  `"--PAUSE-- A8:GO"` → `"--PAUSE-- C8:GO"`；`Test_OLED()` 乙段的标记字
  `"B4 A8 pause"` → `"B4 C8 pause"`。**`"press A8"` 不动**（那本来就是启动键）。
- 注释里凡是把 A8 当暂停键讲的地方全部改成 C8（`Dbg_Suspend` 的说明、
  中断扫键段、`Dbg_Service` 的停车分支、`Dbg_ShowScreen` 的版式说明、
  `Test_HwInit` 里 CAN 为什么算共用、`Test_Motor` 的两处），约 20 处。

**`UserCode/Inc/test.h`**
- 三个开关的说明、第一节的模式表说明、第二节的调试服务说明里的 A8→C8
  （A8 作为启动键的说明保留）。

### ⚠ 顺带记一个**没修**的隐患

`Dbg_Suspend()`（菜单占用屏幕期间）只挡住了 `Dbg_Service()` 这个"消费端"，
**没有挡住中断里那个"生产端"**：TIM7 的扫键段开头并没有看 `s_suspended`，
所以挂起期间按 C8 照样会把 `s_paused` 翻成 1，只是当时看不出来。等
`Menu_Init` 返回、`Dbg_Resume()` 之后，第一个服务点就会立刻进暂停画面 ——
现象是**"菜单一退出，车就停住不动"**。

这次把菜单里的 C8 摘掉，已经把最容易碰到的那次堵住了（以前在菜单里按 C8
换路线会顺带翻掉 `s_paused`）。但**根治要在中断的扫键段前面也加一句
`s_suspended` 判断**，让它名副其实。没动是因为那是行为改动，先记在这儿。

### 验证

1. **12 组编译配置全部 0 编译器警告**（唯一的一条命中是 CMake 自己的
   `CMake Warning`，跟源码无关）：
   `TEST_MODE=0/1/2/3/4/5/7/8/9 × DBG_ENABLE=1`，外加
   `MODE=9/DBG=0`、`MODE=0/DBG=0`、`MODE=9/CAN=0`。
   FLASH 55144~56812 B（`MODE=0` 最小 55936 B，`MODE=8` 最大 56812 B）。
2. **暂停键真的读到 GPIOC**：反汇编 `HAL_TIM_PeriodElapsedCallback` 里那次
   `HAL_GPIO_ReadPin` 是 `mov.w r1,#256`(PIN_8) + `ldr r0` 取自字面量池
   `0x8008738`，那 4 字节是 `00 08 02 40` → 小端 `0x40020800` = **GPIOC** ✓
3. **启动键真的还读 GPIOA**：`Test_WaitStartKey` 里同样 `r1=0x100`，
   `ldr r0` 取自 `0x8008b08` = `00 00 02 40` → `0x40020000` = **GPIOA** ✓
   两个都还是 PIN_8，只是端口分开了。
4. **`DBG_ENABLE=0` 那个坑是真的**：把两个 `DBG_KEY_*` 宏挪回
   `#if DBG_ENABLE` 里面、`Test_WaitStartKey` 改回读 `DBG_KEY_*`（复现改动前的
   写法）之后，`-DTEST_MODE=9 -DDBG_ENABLE=0` 报
   `test.c:444: error: 'DBG_KEY_GPIO' undeclared`；改回来就编得过。
5. **`menu.c` 已无 C8 痕迹**：`grep key_res\|KEY_RES\|GPIO_PIN_8` 只剩
   `KEY_START_PIN GPIO_PIN_8`（A8）和 `Key_Scan(&key_start)` /
   `Key_Scan(&key_route)` 两个调用点。
6. **屏上串都对**：ELF 里有 `C8:pause` / `--PAUSE-- C8:GO` / `press A8` /
   `B4 C8 pause`，没有残留的 `A8:pause`、`--PAUSE-- A8`、`B4 A8`。
7. 为复现第 4 条临时改过 `test.c`，`trap` 还原后无 `.bak` 残留，临时构建目录已删。

### 待确认

**C8 上到底有没有实体按键？** `menu.c` 原来的注释把 C8 写成"预留"，说明它
至少在软件里是个占位。现在把它提成正式的暂停键，得确认台架上 C8 真的接了
按钮（`MX_GPIO_Init()` 里已配成上拉输入，硬件侧只需要按键到 GND）。
没接的话暂停功能等于没有，得先接线。

---

## 待办 / 已知问题

1. **`AGV_Position_Depart_2` 没有锚定坐标**
   `AGV_Position_Depart_2()` 从头到尾没调 `AGV_Position_Set()`，路线 2 的跟踪坐标
   一直停在 (0,0)，而小车实际移动了约 1010mm → 之后每次 `AGV_Position_Go()`
   算出来的距离都是错的。需要路线 2 的起点/终点坐标才能修。
   `AGV_Position_GoBack_2()` 同样是硬编码，未锚定。

2. **零距离分段会白等**
   `AGV_Position_Go()` 在 dx 或 dy 为 0 时仍会调 `GoStraight(0,...)` / `Translate(0,...)`。
   0 脉冲的命令电机可能不回 `FD 9F`，会白等 `EMM_V5_ARRIVE_TMO_MS`（5s）。
   建议在 `AGV_Position_GoStraight()` / `AGV_Position_Translate()` 开头加
   `if(distance == 0) return;`。

3. **`Yaw_MovingOffsetEnd()` 的 `+=`**
   这次从 `(1)` 文件移植成 `+=`。如果原意是 `=`（每次只取本次直行偏差），改回去即可。

4. **`PICK_SAFE_HEIGHT_MM` 未实车验证**
   门字形轨迹抬到 7.0f mm 的那个"安全高度"只是推算值（定义在 `pick.c`）。
   首次试跑建议把台上的料换成高一点的，或空跑观察抬升时机；
   实际会蹭到就把这个值加大。
   （原第 4 条讲的是车外过渡位 `POS_A_OUT` / `POS_C_OUT`，两个宏现在都已不存在：
   转盘方案下三个槽共用 `POS_CAR` 一个臂位姿，绕行过渡位不再需要，见 2026-10-03 一节。）

5. ~~`pick.c` 里还留着两个没人调用的函数~~ —— **已作废（2026-09-16）**：
   回退后的 `pick.c` 里 `Pick_Safe_MoveTo()` / `Pick_MotorR_MoveToMM_Wait()`
   已经不存在了，这条不用再管。

6. ~~超时后跟踪值的取舍（2026-09-15 改动留下的）~~ —— **已作废（2026-09-16）**：
   2026-09-15 那节的改动被用户整体回退，`pick_motorZPos` 又变回"不管到没到位都写目标值"，
   即"A 位超时一次跟踪值就偏 24mm、下一步升安全高度多顶 24mm 撞上限"的放大效应回来了。
   要修的话仍是 2026-09-15 那节的第 3 条。

7. ~~**USART1(OpenMV) 波特率存疑**（2026-10-03 发现，当天已查清）~~ —— **已作废**：
   仓库里的 `视觉代码.py` 是 `UART(3, 9600)`，相机侧就是 **9600**，和 `.ioc`／
   `Core/Src/usart.c` 一致。之前"115200"是记错了，无需改动。
   （注意这份 py 已和相机上跑的不是同一版，见下方第 9 条。）

8. **扫码枪换串口后需实车确认接线**
   `QRcode.c` 已指向 `huart3`，但信号线要从 PA2/PA3 挪到 **PB10(TX) / PB11(RX)**。
   注意 PB10 是 MCU 的 TX → 接扫码枪的 RX，PB11 反过来。另外 USART2 仍 enabled，
   若 PA2/PA3 要改接别的外设，得回 CubeMX 把 USART2 关掉。

9. **视觉新协议：流程已接上，剩一个尾巴**
   收发层、流程、`0x05` 都已按新协议落地，兼容层已删（见当天第二、三、九节）。剩下：
   - **第二轮 `Pick_Color2` 没下发给相机**：`case QRcode` 只在第一轮走一次，二周目
     从 `Move4` 直接回 `Pick1`。相机侧要用第二轮任务码就得在 `Move4` 之前补一条
     `Cam_RequestTaskCode(Pick_Color2[0], Pick_Color2[1], Pick_Color2[2], PICK_REQ_TMO_MS)`。

   ~~`flag=0` 时 dx/dy 是否有效~~ —— **已经不用管了（2026-10-04）**：两段式等待落地后，
   `dx`/`dy`/框内颜色只在 `Cam_WaitSettle()` 返回 1 之后才被读，而那要求收到过一帧
   `flag!=0` 的同命令回帧。flag=0 的帧写进全局也不会被取用，相机侧怎么写都无所谓。

10. **仓库里的 `视觉代码.py` 与相机上的版本已不一致**
   它发的是 5 个逗号分隔字段 `blk_dx,blk_dy,ring_dx,ring_dy,tag\n`，而旧 camera.c
    只解析 3 个（把 `ring_dx` 当成了 `openmv_cmd`），说明这份文件早于相机上实际跑的
    版本。要改视觉侧的话，**先拿到相机里的当前版本**，别直接改仓库这份。

11. **转盘舵机（`SERVO_TURN`, TIM1_CH1/PE9）需实测验证**
    - **接线**：PE9 接转盘舵机信号线，共地，舵机电源够不够带得动要确认。
    - **角度/方向**：0°/120°/240° = A/B/C 是我按你说的填的，方向和零点要实测；
      装反了只改 `pick.h` 的 `PICK_TURN_ANG_*`，逻辑不用动。
    - **`SERVO_T_SETTLE_MS = 300`** 是估的：`Servo_SetAngleSmooth` 只保证命令角发完，
      舵机物理停稳还要时间，转盘带着料没停稳臂就下去会撞。
    - **TIM1 预分频必须是 167**（不是 TIM2/3/4 的 83），原因见当天第 8 节；
      按 83 配会得到 100Hz PWM，舵机抖动或不动作。
    - `POS_CAR` 仍是原 `POS_A` 的 `(4, 31, 28)`，转盘方案下它是车上唯一的臂位姿，
      也必须实测确认。

12. ~~原料区三个框 `POS_RAW_A/B/C` 还是同一个值~~ —— **已解决（2026-10-04）**：
    已标定为 `A(214,62,79) 左前` / `B(184,62,29) 下` / `C(154,62,79) 右前`，
    角度 184±30 对称、半径 79/29/79，"下"正对前方且最近。
    与相机 `0x03` 回报的 c1/c2/c3 = **左上/下/右上** 按顺序一一对应，
    `GrabRawBoxToCar()` 里 `case 0→A / 1→B / default→C` 正好是这个顺序，不用改。

12b. **转盘走格方向/格数未实车验证**
    第 12 节按「每抓走一块，内容索引 +1 mod 3」（A→B→C→A）实现，且假设
    "只有真把料拿走才转"。方向与 A(214°)→B(184°)→C(154°) 的角度递减一致。
    若实车发现反了，把 `(j0 + grabbed) % 3` 改成 `(j0 + 3 - grabbed) % 3` 即可，
    逻辑其余不动；先空跑一轮、盯住第二块是不是抓在该在的格上。

13. **`Place_TEMP()` 第一轮用 0x04 是我推的** —— ~~`0x05` 的颜色取值域~~ 已确认（2026-10-04）：
    任务码里的颜色就是 **1~6**，相机侧认同一套编码，`- '0'` 后的值直接下发即可。
    剩下一条：第一轮发的 `0x04` 仍是推的（观察位与 `Place_ROUGH` 同一处，
    所以复用了同一个请求），待实车确认。

14. ~~视觉请求超时后返回值被忽略~~ —— **已解决（2026-10-04，见当天第 14 节）**：
    四处 `AGV_Correct()` 都改成"视觉请求成功才修正"，超时就不动。
    `Place_TEMP()` 第二轮另外加了 `color_to_send != 0` 判断。

15. **`Pick_RAW()` 与 `Pick_RAW_PLUS()` 二选一**
    目前 `task.c` 的 `case Pick1` 走 `Pick_RAW()`（推算转盘走格）。
    `Pick_RAW_PLUS()`（每块前回观察位重问）已写好但无人调用，
    切换就改那一行。PLUS 不依赖走格方向，但每块多一次视觉往返。

16. **`AGV_Correct()` 只看 `cam_flag` 不看 `cam_mode`**
    `cam_flag` 是**任何**命令帧都会刷新的，而 `dx`/`dy` 只有 0x02/0x04/0x05 会写。
    若 `AGV_Correct()` 期间相机回的正好是别的命令帧且 flag!=0，就会拿旧 `dx`/`dy`
    下发一轮。正常时序下相机应停在 0x02 模式，碰不上；要收紧就得给它加"期望命令码"。

17. **任务码下发超时后没人管**（2026-10-04 新增）
    `QRcode_Task()` 里 `Cam_RequestTaskCode(...)` 现在会阻塞等相机确认
    （等 0x01 回帧 + 该帧 flag!=0，最多 10s），**这一层已经判了**。
    没判的是**它的返回值**：超时后照样返回、流程照样 `TaskCode = Move1` 往下走。
    后果是相机侧没有任务码 → 后面 `Pick_RAW`/`Place_*` 拿到的颜色全是错的，
    而且不会有任何报错。
    超时该报错停 / 重试一次 / 硬着头皮走，属流程决策，定了就在 `QRcode_Task()` 里加 `if`。

18. **臂的两个步进电机比例都只有"纸面值"**（2026-10-11 新增，见当天第 36、37 节）
    高度电机已由 8mm/圈 更正为 **60mm/圈**（待模式 9 实测确认）；**半径电机的
    `PICK_MOTOR_R_MM_PER_REV = 100.0f`（32 脉冲/mm）一次都没实测过**，跑之前
    要用同样的办法（定长往返 + 卡尺）验一遍 —— 测试函数已经写好了，
    模式 9 里把调用点从高度换成半径即可（见第 37 节）。
    **两个电机的 `POS_DIR` 也都还没实测过**（当前 Z=0 / R=1）。
    另外高度那条 3200/60 = 53.33 被整数截断成 53，换算偏小 **0.6%**
    （走 140mm 差 0.8mm）—— 要修就得把 `PICK_MOTOR_Z_MM_PUL` 和两处乘法的
    中间量改成浮点。
    还有 `PICK_MOTOR_Z_MAX_MM 150.0f` 的注释写"0~100mm"，自相矛盾，真实行程待实测。

---

## 2026-10-14 —— 修编译（pick.h 遮蔽）；接入雷达：UART4 客户端 + 启动四段路径规划

> 本节 4 条：**49** 修编译、**50** 新增 `Radar/` 模块、**51** 菜单加起点方格、**52** `AGV_Init` 接入。
> 雷达协议与客户端直接用厂商例程（`radar_client` / `link_protocol` 一个字没改），
> 新写的是板级适配与整车胶水。**雷达还没接、未实车验证**。

### 49. 修编译：移走 `UserCode/Inc/pick.h`（旧副本把新头文件遮蔽了）

**现象**：全量重建必失败，`main.c:124` / `task.c:54` / `test.c:489` / `pick_task.c:51` 等处报
`error: 'Pick_JumpTo' 未声明`、`'Pick_Color1' 未声明`、`expected ';' before 'POS_RAW_A'`。

**原因**：工程里有**两个 `pick.h`，include guard 都是 `__PICK_H`** ——
`HARDWARE/Inc/pick.h`（新：`Pick_JumpTo()` + `POS_*` 括号宏 + `Pick_TurnTable_Set` + `Pick_Gripper_Observe`）
和 `UserCode/Inc/pick.h`（旧：`Pick_MoveTo()` + 另一套 `POS_A/B/C` 宏）。
`#include "pick.h"` 是**先搜包含它的文件所在目录**，而 `task.h` / `pick_task.h` 都在 `UserCode/Inc`，
所以拿到的是旧文件 → 新 API 全成未声明；`-I` 的顺序在这里不起作用。
`Pick_Color1/2` 是同一个原因：新 `pick.h` 里 include 了 `QRcode.h`，旧文件没有。

**改动**：`UserCode/Inc/pick.h` → 移到新建的 `UserCode/_obsolete/`（**没删**，随时能拿回），
并加 `UserCode/_obsolete/README.md` 写明原因。

**涉及文件**：`UserCode/Inc/pick.h`（移动）、`UserCode/_obsolete/README.md`（新增）。

**验证**：`cmake --build build/Debug --clean-first` → 0 错误 0 警告，链接通过；
基线 RAM 4976B / FLASH 56620B。

**未做**：`UserCode/Inc/pick_ctrl.h`、`UserCode/Src/pick.c`、`UserCode/Src/pick_ctrl.c`、
`UserCode/Src/openmv.c`、`UserCode/Inc/openmv.h` 也是改名搬迁后的旧副本（不在 CMakeLists 里、
不参与编译），本节没动。它们会继续误导 grep，建议一并清到 `_obsolete/`。

### 50. 新增 `Radar/` 模块：雷达 v6 客户端 + 四段路径规划（UART4）

**为什么**：UART4/PC10-PC11 从 2026-10-03 起就是"预留（后续可能给雷达）"（第 26 节），
但工程里没有任何读写它的代码。本次把雷达厂商的协议层与客户端搬进来（**不改一行**），
只重写板级适配，再加一层与整车流程的胶水。

| 文件 | 作用 | 来源 |
|---|---|---|
| `Radar/{Inc,Src}/link_protocol.*` | COBS + CRC16-CCITT + v6 帧编解码 | 厂商例程，未改动 |
| `Radar/{Inc,Src}/radar_client.*` | 非阻塞客户端：握手/心跳/选区/事务超时/事件重组 | 厂商例程，未改动 |
| `Radar/{Inc,Src}/launch_mission.*` | 启动一次性任务状态机（选区→位姿→方格扫描→四段规划→STOP） | 厂商思路 + 本项目多段路线版 |
| `Radar/{Inc,Src}/radar_uart_port.*` | UART4 + DMA 板级适配（**唯一碰 HAL 的雷达代码**） | 新写 |
| `Radar/{Inc,Src}/radar_task.*` | 与整车流程的接口：初始化/轮询/起点方格/四段结果/OLED 摘要 | 新写 |
| `Radar/Inc/radar_config.h` | **雷达参数唯一配置处**：节点/区域/位姿/路线/起点方格/超时 | 新写 |

**串口与中断**：
- RX：`DMA1_Stream2 / CHANNEL_4`，循环模式，关半满中断。`.ioc` 里没有这段（本机也没装 CubeMX），
  由 `radar_uart_port.c` 在第一次 `StartReceive` 时自建；**如果以后在 CubeMX 里补了 UART4 的 DMA，
  那边会自动跳过自建**（判断 `huart4.hdmarx != NULL`）。
- TX：`HAL_UART_Transmit_IT` 中断发送（一帧最大 237B，115200 下约 21ms），不占第二个 DMA 流。
- `UART4_IRQHandler` / `DMA1_Stream2_IRQHandler` 定义在 `radar_uart_port.c`
  （照 `hwt101.c` 自持 `UART5_IRQHandler` 的做法，不进 `stm32f4xx_it.c`）。
- NVIC 优先级取 **6**，低于 TIM7/CAN/USART1(0)，与 UART5 同级 —— 避免雷达收发压住视觉与电机回帧
  （第 31 节那条丢帧教训）。
- `HAL_UART_TxCpltCallback` / `HAL_UART_ErrorCallback` 也定义在该文件里，里面只认 `huart4`；
  以后别的外设也要用这两个回调，就把那里改成先判断句柄再分发。

**CMakeLists**：`target_sources` 加 5 个 .c；`target_include_directories` 加 `Radar/Inc`（**放最后**，
避免与 `HARDWARE/Inc`、`UserCode/Inc` 里的同名头文件打架 —— 第 49 节就是这个坑）。

**未做**：雷达方格编号 → 车场地坐标的映射表还没定，所以四段结果**只存内存并显示，不驱车**。

### 51. 菜单加"雷达启停区"阶段（C6 改 / A8 确认）

**为什么**：雷达有**两个启停区（工作区域 zone 1/2）**，两区的位姿**独立保存**，
车这次停在哪个区只有现场知道 —— 得让操作员在启动时选，而不是把区域写死在代码里。

> ⚠ **本条第一版做错了**：一开始把它做成了"选起点方格 0~24"（把"启停区"与"出发点方格"
> 混为一谈）。这两件事不是一回事：
> - **启停区 = 雷达工作区域 zone**，决定用哪一套位姿，命令 `SELECT_ZONE(0x05)`；
> - **出发点方格 0~24** = `PLAN_PATH(0x14)` 的起点参数（5×5 方格图上车所在的位置），
>   雷达不会自己知道车停在哪，必须由我们给。
> 现在改成：**菜单选启停区**；出发点方格按"每个启停区一个固定值"放在
> `radar_config.h`（`RADAR_ZONE1_START_GRID` / `RADAR_ZONE2_START_GRID`），
> 跟着区域一起自动设好。

**改动**：`menu.c` 的 `Menu_Init()` 拆两阶段 —— `A8` 从"直接启动"改成"进入阶段2"；
阶段2 用 `C6` 在启停区 1↔2 之间切、`A8` 确认启动；新增 `Menu_DisplayZone()` 显示页。
开关 `RADAR_MENU_PICK_ZONE`（`menu.c` 顶部，默认 1）**改 0 可完全恢复旧行为**（两种取值都验过能编译）。

**行为变化**：⚠ **启动要多按一次 A8**（阶段1 选整车路线 → 阶段2 选雷达启停区 → 启动）。

**涉及文件**：`UserCode/Src/menu.c`、`Radar/Inc/radar_task.h`、`Radar/Src/radar_task.c`。

**由 `Radar_SetZone(zone)` 一次做完三件事**（`radar_task.c`）：
1. `RadarClient_RequestSelectZone(zone)` —— 未连接时客户端只登记，握手完成后自动发出；
2. `Launch_SetPose(x, y, heading_q6, zone)` —— 按该区取对应的一套位姿
   （两区位姿窗口不同：区域1 的 Y 1900~2600、区域2 的 Y -200~500，位姿必须跟着区域走）；
3. `Launch_SetStart(该区的出发点方格)`。
> 因此 `launch_mission` 本次加了一个运行时接口 `Launch_SetPose()`（与 `Launch_SetStart()`/
> `Launch_SetRoute()` 同一套规则：`Launch_Init()` 之后、规划开始之前有效）。

### 52. `AGV_Init()` 接入雷达任务（阻塞跑一次，之后整车不再用雷达）

**改动**：`task.c` 的 `AGV_Init()` 里，`HWT101_Init()` 之后加 `Radar_Init()`；
`Menu_Init()` 之后加 `Radar_RunOnce()`（阻塞约 2~10s，屏幕显示进度，结束后显示四段摘要）；
再 `TaskCode = Depart`。

**为什么放这两个位置**：启停区是菜单里选的 → 跑任务必须在菜单之后；
初始化本身不发帧 → 提前到菜单之前没有副作用（`Radar_Init()` 会先装默认区的一套值，
菜单里改成另一个区会覆盖它）。

**验证**：`cmake --build build/Debug --clean-first` → **0 错误 0 警告**。
雷达模块自身占用（Debug -O0，`arm-none-eabi-size`）：

| 目标文件 | text | bss(RAM) |
|---|---:|---:|
| radar_client.c.obj | 10064 | 3131 |
| launch_mission.c.obj | 2930 | 295 |
| radar_uart_port.c.obj | 2428 | 97 |
| link_protocol.c.obj | 1658 | 0 |
| radar_task.c.obj | 1027 | 5 |
| **合计** | **≈18.1KB** | **≈3.5KB** |

整机：RAM 4976 → **8528B**（6.51%），FLASH 56620 → **74888B**（14.28%）。

**未实车验证 / 待填**：
1. `Radar/Inc/radar_config.h` 里这些值是占位（注释标了"待填"）：
   **默认启停区的出发点方格、两个启停区各自的雷达位姿 X/Y/朝向**。
   填错不会损坏硬件，但客户端会本地拦下（一帧都不发），现象是"雷达任务刚开始就结束"、
   屏幕第 3 行 `f2`。取值：现场卷尺量，或在雷达配套上位机里读。
2. **接线未确认**：`PC10(TX)` 接雷达 RX、`PC11(RX)` 接雷达 TX、必须共地；
   雷达 TX 是开漏输出，"雷达 TX → 本机 PC11"这条线上要一个 **4.7kΩ 上拉到 3.3V**（不是 5V）。
3. 四段路线固定为 `起点→14→10→22→14`（`LAUNCH_ROUTE_GOALS`），要改就改那一行。
4. 屏幕摘要格式 `Lx 起点>终点 s状态 n节点数`；段数/`waypoints` 详情目前只能靠调试器看内存，
   没有串口日志（USART2 空闲但未接调试口，且 `demo_console` 没搬进来）。

### 53. 四段路径点存进全局数组 `Radar_Path[4]`（整车流程可直接取）

**为什么**：第 52 节里存结果的 `leg_results[]` 在 `launch_mission.c` 里是 **static** ——
文件外看不见，只能通过 `Launch_GetLeg()` / `Radar_GetLeg()` 按值拷一份，整车流程要用
四段路径点得反复调接口、自己开缓冲。改成雷达模块直接提供一个全局数组。

**改动**：
- `Radar/Inc/radar_task.h`：新增
  ```c
  typedef struct { uint8_t status, start, goal, count;
                   uint8_t points[24]; } radar_path_t;
  extern radar_path_t Radar_Path[4];      /* 四段路径点 */
  extern uint8_t Radar_PathCount;         /* 实际段数，正常 4 */
  #define Radar_Path1 Radar_Path[0].points   /* 四个数组的直接视图（不是拷贝）*/
  #define Radar_Path2 Radar_Path[1].points
  #define Radar_Path3 Radar_Path[2].points
  #define Radar_Path4 Radar_Path[3].points
  void Radar_SyncPathArrays(void);
  ```
- `Radar/Src/radar_task.c`：定义全局数组 + `Radar_SyncPathArrays()`；
  **`Radar_Service()` 里检测到"已完成段数变了"就同步一次** → 每规划完一段就能用，
  不必等四段全跑完；`Radar_RunOnce()` 末尾再同步一次兜底。
- 未跑到的段：`status/start/goal = 0xFF`、`count = 0`、`points[]` 全 `0xFF`
  （`RADAR_PATH_INVALID`），避免整车流程误用残值。

**占用与地址**（`arm-none-eabi-nm` 实测）：

| 符号 | 地址 | 大小 | 段 | 可见性 |
|---|---|---:|---|---|
| `Radar_Path[4]` | `0x20001A10` | 112B (4×28) | `.bss` | **全局**，`extern` 可见 |
| `Radar_PathCount` | `0x20001A80` | 1B | `.bss` | 全局 |
| `leg_results[7]`（内部） | `0x200018D4` | 210B (7×30) | `.bss` | static，只走接口 |
| `path_copy`（回调暂存） | `0x200018A8` | 30B | `.bss` | static |

整机：RAM 8536 → **8656B**（6.60%），FLASH 75104 → **75588B**（14.42%）。

**验证**：`cmake --build build/Debug` → 0 错误 0 警告。

**未做**：还没有任何地方消费这四个数组（不驱车）；"方格编号 → 场地坐标"映射表仍未定。

### 55. 雷达朝向角改成支持小数（配置宏从"整数度"改为 float）

**问题**：第 50 节把朝向配置写成了整数度（`RADAR_ZONEx_POSE_HEADING_DEG 0U`），只能填整度。
但雷达协议里**本来就允许小数**，只是用定点表示（说明书 §9）：

```text
heading_q6 = round(角度 × 64) mod 23040      角度(°) = heading_q6 / 64
```

线上字段 `<BhhH>` 的 `H` 是 uint16，一圈 23040 个格点 → 分辨率 **1/64° = 0.015625°**。
所以 12.5° 能精确表示（12.5×64 = 800），只是表达不了 0.001° 那种精度。
**"整数度"是配置写法的限制，不是协议的限制。**

**改动**：
- `Radar/Inc/radar_config.h`：两个区的朝向宏改成 float，可写 `12.5f`、`-37.25f`。
- `Radar/Src/radar_task.c`：新增 `Radar_HeadingDegToQ6(float deg)` —— 四舍五入到最近格点、
  负数取模回绕到 0~23039（`-90°` → `17280` 而不是负数）；`Radar_SetZone()` 用它替换整数乘法。

**验证**（把同一个函数体拿到 PC 上用 MSVC 编译运行，`/W4 /WX` 通过）：

| 输入(度) | q6 | 实际(度) |
|---|---:|---:|
| 12.5 | 800 | 12.5000 |
| 12.502 | 800 | 12.5000 |
| 12.508 | 801 | 12.5156 |
| 0.0078 | 0 | 0 |
| -0.01 | 23039 | 359.9844 |
| -90 | 17280 | 270.0000 |
| 360 | 0 | 0 |
| 720.5 | 32 | 0.5000 |

另加 -10000°~+10000° 共 2 万次扫描：结果恒 `< 23040`，不会越界。
工程构建：0 错误 0 警告，FLASH 75588 → **75752B**（+164B 就是换算函数）。

**说明**：现场填角度时，小数只在 0.015625° 的格点上精确，量化误差 ≤ 0.0078°；
写 `12.3456f` 会落到 `12.3438°`，对安装精度完全够用。宏里不加 `f` 也能编译
（隐式转 float），加 `f` 更干净（本工程 FPU 是单精度）。

**未做**：`launch_mission.h` 里自带的 `LAUNCH_POSE_HEADING_DEG`（整数度）没改 ——
本项目走 `Radar_SetZone()` 的运行时路径，那个默认值不生效；只有绕过 Radar 模块
直接用 launch_mission 时才需要它。

**另**：`radar_config.h` 里两个出发点方格已被填成 区1=**4** / 区2=**0**（本次保留未动）。

### 56. 新增 `TEST_MODE = 10`：雷达测试模式（一次方格扫描 + 四段规划，结果分页显示）

**为什么**：正式流程里雷达那一步夹在 `Menu_Init()` 和 `Depart` 之间，台架上要验雷达
必须把整机（相机、机械臂、陀螺仪）都接好、还得按菜单走一遍。单独一个测雷达的模式
以后，台架上只要 OLED + 雷达两个东西就能验。

**改动**（按 test.h 第 83-84 行那三步走）：
- `UserCode/Inc/test.h`：模式表加 **10 Test_Radar** 一段（写明流程、分页、按键、参数位置）。
- `UserCode/Src/test.c`：
  - 顶部加 `#include "radar_task.h"`；
  - 测试函数声明区加 `static void Test_Radar(void);`
  - `Test_Switch()` 的 switch 加 `case 10: Test_Radar(); break;`
  - 实现前加本文件独有的小工具：`RadarTestKey` + `RadarTest_KeyEdge()`（消抖按下沿，
    逻辑同 `menu.c` 的 `Key_Scan`，复用 `TEST_KEY_SCAN_MS`/`TEST_KEY_DEBOUNCE`）、
    `RadarTest_ShowOverview()`（页0）、`RadarTest_ShowLeg(page)`（页1~4）。

**行为**（一次 A8 之后不返回，符合本文件其他测试的惯例）：

```text
Radar_Init()    选默认启停区(RADAR_ZONE_DEFAULT) + 装该区的位姿与出发点方格（不发帧）
Radar_RunOnce() 握手 → 选区 → 设位姿 → 一次 14 圈方格扫描 → 四段路径规划 → STOP
                （进度页与四段摘要页由 Radar_RunOnce 内部显示）
分页显示         页0 = 四段概览  "Lx 起点>终点 s状态 n节点数"
                页1~4 = 每段的完整路径点（6x8 小字，每行 7 个，最多 24 个）
按键             C6 下一页 / C8 上一页 / A8 重跑一次
```

**一个必须注意的点**：`Launch_IsFinished()` 是**粘滞**的（跑完就一直是 true），
所以"重跑"不能直接再调 `Radar_RunOnce()`，必须先 `Radar_Init()` 复位 ——
`Test_Radar()` 的重跑循环就是这么写的（`for(;;){ Radar_Init(); Radar_RunOnce(); ... }`）。

**验证**：
- 默认 `TEST_MODE=4` 构建：**0 错误 0 警告**（注意 `#else` 分支会把所有测试函数都编进去，
  所以 `Test_Radar` 的代码本身就经过 `-Wall` 检查了）。RAM 8656B / FLASH **75688B**。
- 另用项目现有编译标志单独做了 `-DTEST_MODE=10` 的语法检查：0 错误 0 警告。
- 中途踩到并修掉一条自己引入的警告：`RadarTest_*` 里的 `char buf[20]` 装不下
  `"L4 24>24 s6 n24"` 的最坏情况，`-Wformat-overflow` 报错 → 改成 `buf[32]`。
- 想整版编 `TEST_MODE=10`（带链接）用他们自己的方式即可：
  `cmake ... -DCMAKE_C_FLAGS="-DTEST_MODE=10"`（我这边的独立 configure 因为项目
  toolchain 文件缺少 CXX 编译器定义而失败，属本地环境问题，不影响上面两条结论）。

**未做**：`Test_Radar` 用的是 `RADAR_ZONE_DEFAULT`，测试模式下不能像菜单那样按 C6 换区
（C6 被"下一页"占了）；要测另一个启停区就改 `radar_config.h` 的默认值重编。

### 57. 修 `.vscode`：F5/烧录报 "GDB executable ... was not found"（路径写死了上一台机器的用户名）

**现象**：按 F5（或点调试/烧录）时 cortex-debug 报

```text
GDB executable "C:\Users\Dawn\AppData\Local\stm32cube\bundles\gnu-gdb-for-stm32\14.3.1+st.2\bin\arm-none-eabi-gdb.exe" was not found.
```

**原因**：`.vscode` 里有 **5 处**写死了 `C:/Users/Dawn/...`（上一台机器的用户名），
本机根本没有 `C:\Users\Dawn`。而且不止报错那一处 —— 整条调试/烧录链路都断：

| 文件 | 原来 | 现在 |
|---|---|---|
| `launch.json` | `armToolchainPath: C:/Users/Dawn/.../gnu-gdb-for-stm32/14.3.1+st.2/bin` | `${env:CUBE_BUNDLE_PATH}/gnu-gdb-for-stm32/14.3.1+st.2/bin` |
| `launch.json` | `svdFile: C:/Users/Dawn/.../stm32f4xx_dfp/1.2.0/SVD/STM32F407.svd` | `${env:LOCALAPPDATA}/stm32cube/packs/STMicroelectronics/stm32f4xx_dfp/1.2.0/SVD/STM32F407.svd` |
| `launch.json` | 没有 `serverpath`（openocd 只能靠 settings） | 新增 `serverpath: ${env:LOCALAPPDATA}/xpack-openocd/xpack-openocd-0.12.0-7/bin/openocd.exe` |
| `settings.json` | `cortex-debug.openocdPath: C:/Users/Dawn/...` | **删掉**（settings 里不能写 `${env:...}`，改由 launch.json 的 `serverpath` 按配置提供） |
| `flash-retry.sh` | `OPENOCD` / `SCRIPTS` 写死 `C:/Users/Dawn/...` | 由 `$LOCALAPPDATA` 推导（可用 `OOCD_DIR=` 覆盖），并加了"找不到 openocd"的明确报错 |
| `tasks.json` | 烧录任务用裸 `bash`（本机 PATH 里没有 bash） | `${env:ProgramFiles}/Git/bin/bash.exe` |
| `tasks.json` | 默认构建任务（Ctrl+Shift+B）指向 `D:\Program Files\mingw64\bin\gcc.exe`（本机没有 mingw，且与 CMake 流程无关，是 VS Code 自动生成的残留） | 改成 `cmake --build build/Debug`，cmake 取自 `${env:CUBE_BUNDLE_PATH}` |

**为什么改用环境变量**：`CUBE_BUNDLE_PATH` 是 STM32 VS Code 扩展自己设的（`settings.json`
里 clangd 的 `--query-driver` 早就在用它），`LOCALAPPDATA` / `ProgramFiles` 是 Windows 标准变量 ——
以后再换机器/换用户名不用重改这一遍。

**验证**（都是实跑，不是看配置）：
- `arm-none-eabi-gdb --version` → `GNU gdb (GNU Tools for STM32 14.3.rel1.20251027-0700)` ✓
- `openocd --version` → `xPack Open On-Chip Debugger 0.12.0` ✓；按脚本那套
  `-s <scripts> -f interface/cmsis-dap.cfg -f target/stm32f4x.cfg` 能正常加载脚本 ✓
- `bash .vscode/flash-retry.sh`（`ATTEMPTS=1`，经 Git Bash 全路径）→ 一路走到连 DAPLink，
  报 `Error: CMSIS-DAP command CMD_INFO failed.`（**没接硬件时的正常报错**，说明工具链已通）✓
- 新的默认构建任务实跑：`ninja: no work to do.` ✓
- `launch.json` / `settings.json` / `tasks.json` 三个文件语法校验通过（带注释的 jsonc）✓

**注意**：`C:\Users\Dawn` 在本机不存在；`.vscode` 属于"每台机器各自的配置"，
本次已改成跟着环境变量走。改完 VS Code 里 `Reload Window` 一次让配置生效。

### 58. 修 F5 报 "GDB版本过低"：cortex-debug 退回了 PATH 上的 MinGW gdb 7.6.1

**现象**：第 57 节修完"找不到 GDB"之后，按 F5 改报 **GDB 版本过低**。

**根因**（从扩展源码里读出来的判定逻辑，不是猜）：
- cortex-debug 1.12.1 的 `dist/debugadapter.js` 硬性要求 **GDB 主版本 ≥ 9**：
  ```js
  if (gdbMajorVersion < 9) { isExiting = true;
      log("stderr", `ERROR: GDB major version should be >= 9, yours is ${gdbMajorVersion}`); ... }
  ```
  版本用 `/^GNU gdb.*\s(\d+)\.(\d+)/` 解析。
- 它的 GDB 查找顺序是：`gdbPath` → `armToolchainPath + /arm-none-eabi-gdb.exe` → **PATH 上找
  `arm-none-eabi-gdb` / `gdb`**（`getGdbPath()`：绝对路径不存在就报错，非绝对路径就 `which.sync()`）。
- 本机 PATH 上有 **`D:\MinGW\bin\gdb.exe` = GNU gdb 7.6.1（2013 年）** → 前面几条没生效时轮到它，
  主版本 7 < 9 → 直接报"版本过低"。
- 第 57 节我把 GDB 路径改成 `${env:CUBE_BUNDLE_PATH}/...` 的写法在本机**没能生效**：
  `${env:...}` 展开失败时会静默走 PATH 兜底，于是症状从"找不到"变成"版本过低"。

**实测对照（按 cortex-debug 的正则解析）**：

| GDB | `--version` 首行 | 解析主版本 | cortex-debug |
|---|---|---:|---|
| `…\bundles\gnu-tools-for-stm32\14.3.1+st.2\bin\arm-none-eabi-gdb.exe` | `GNU gdb (GNU Tools for STM32 14.3.rel1…) 15.2.90…` | **15** | 通过 |
| `D:\MinGW\bin\gdb.exe` | `GNU gdb (GDB) 7.6.1` | **7** | **报版本过低** |

**改动**：`.vscode` 里全部改成**绝对路径**（不再依赖变量展开）：

| 位置 | 现在的值 |
|---|---|
| `settings.json` → `cortex-debug.armToolchainPath` | `C:/Users/Fawziya/AppData/Local/stm32cube/bundles/gnu-tools-for-stm32/14.3.1+st.2/bin` |
| `settings.json` → `cortex-debug.gdbPath` | 同目录下 `arm-none-eabi-gdb.exe` |
| `settings.json` → `cortex-debug.openocdPath` | `…/xpack-openocd/xpack-openocd-0.12.0-7/bin/openocd.exe`（从 launch.json 的 `serverpath` 挪回来，只留一处） |
| `launch.json`（Wireless DAP 配置） | `armToolchainPath` + `gdbPath` 各指一次（双保险）；`svdFile` 改绝对路径；删掉 `serverpath` |

**为什么指 `gnu-tools-for-stm32` 而不是 `gnu-gdb-for-stm32`**：后者包里**只有 `arm-none-eabi-gdb.exe`**，
而 cortex-debug 加载符号要用 **objdump/nm**（它按 `armToolchainPath` 拼 `arm-none-eabi-objdump.exe`）——
`gnu-tools-for-stm32` 的 bin 里 gdb / objdump / nm **三样齐全**，gdb 同样是 15.2.90。

**验证**：配置引用的 6 个文件全部存在（gdb / objdump / nm / openocd / SVD / Git Bash）✓；
三个 json/jsonc 语法校验通过 ✓；两个 gdb 的版本解析如上表 ✓。

**遗留风险（要你定）**：`D:\MinGW\bin` 在 PATH 上，任何"找不到就退回 PATH"的工具都会拿到 2013 年的
gdb 7.6.1。MinGW 如果跟这个工程无关，建议从 PATH 里去一段；要留着的话，就得像现在这样每个配置显式指定 gdb。

### 59. `.vscode` 里两个本机配置文件加入 .gitignore（并撤销跟踪）

**为什么**：第 57/58 节把 `launch.json` / `settings.json` 里的 GDB / OpenOCD / SVD 改成了
**本机绝对路径**（`C:/Users/<用户名>/...`）。这类内容不能进版本库，否则又是"换台机器就坏"；
而且 `githooks/pre-commit` 的硬拦规则（`[Cc]:[\\/]+[Uu]sers[\\/]+...`）本来就会拦住它 ——
就算不管，提交也过不去。

**改动**：

1. `.gitignore` 追加两条（带说明注释，指向本节与第 57/58 节）：

   ```gitignore
   .vscode/launch.json
   .vscode/settings.json
   ```

   **其余 `.vscode` 文件仍纳入版本管理**（都是可移植写法，不动）：
   `tasks.json`（`${env:...}` / `${workspaceFolder}`）、`flash-retry.sh`（由 `$LOCALAPPDATA` 推导）、
   `c_cpp_properties.json`（只有 `${workspaceFolder}`）。

2. **从索引里摘掉，但保留磁盘文件**：

   ```bash
   git rm --cached .vscode/launch.json .vscode/settings.json
   ```

   `git status` 现在是 `D`（待提交的删除），VS Code 照常读这两份本地文件。

3. 顺手改掉两处**会触发 pre-commit 钩子**的注释（它们是我第 57/58 节写的）：
   - `flash-retry.sh` 注释里的 `C:/Users/Dawn/...` → 改成"上一台机器的用户目录"（命中**硬拦**规则）；
   - `tasks.json` 注释里的 mingw 盘符路径 → 改成文字描述（命中**软提醒**规则）。

**验证**：

- `git check-ignore -v` → 命中 `.gitignore:19` / `.gitignore:20` ✓
- 两个文件仍在磁盘上 ✓；`git ls-files .vscode` 只剩 3 个可移植文件 ✓
- **用钩子本身的三条正则**（`ERR_RE` / `WARN_RE` / `SKIP_DIR_RE` / `SKIP_EXT_RE`）对
  "当前全部改动 vs HEAD" 完整跑了一遍：**硬拦 0 个、软提醒 0 个** ✓ → 下次提交不会被拦下

**新机器上怎么恢复这两个文件**：克隆后它们**不存在**，需要按本机路径各写一份（GDB / OpenOCD / SVD
三处，照第 58 节那张表填）。需要的话可以再往版本库里放两份 `*.template.json` 当模板（本次没加）。

### 60. 澄清"每段只有 1~2 个路径点"：雷达只回拐点+终点，加 `Radar_ExpandLeg()` 展开成逐格

**现象（用户反馈）**：`TEST_MODE=10` 跑完，四段路径每段只显示 1~2 个路径点，怀疑丢数据。

**结论：不是 bug，是协议设计如此。** 说明书两处原文：

- 《STM32雷达函数使用说明》§7 路径结果：**"成功列表不包含起点，包含最终终点；直线路径只返回终点；
  起点等于终点时返回空列表。"**
- 《FreeRTOS雷达任务移植示例》§6：**"路径结果不包含起点，包含拐点和终点；起点等于终点时成功结果为空。"**

用现场填的（区1 出发点方格 = 4）逐段核对，1~2 个点**恰好是预期值**：

| 段 | 方格坐标（§9 几何） | 形状 | 雷达回的点数 |
|---|---|---|---|
| 4→14 | (r0,c4) → (r2,c4) **同列** | 直线 | **1**（只回 14） |
| 14→10 | (r2,c4) → (r2,c0) **同行** | 直线 | **1**（只回 10） |
| 10→22 | (r2,c0) → (r4,c2) | 1 个拐弯 | **2** |
| 22→14 | (r4,c2) → (r2,c4) | 1 个拐弯 | **2** |

**新增**（`Radar/Inc/radar_task.h` + `Radar/Src/radar_task.c`）：

```c
uint8_t Radar_GridRow(uint8_t grid);   /* 方格 → 行 0~4（说明书 §9：row = id/5） */
uint8_t Radar_GridCol(uint8_t grid);   /* 方格 → 列 0~4（奇数行反向：4 - id%5） */
uint8_t Radar_ExpandLeg(uint8_t leg, uint8_t *cells, uint8_t max_cells);
/* 把一段展开成逐格编号（不含起点、含终点），返回格数；
   0 = 没跑到 / status≠0 / 缓冲不够 / 折点既不共行也不共列（此时拒绝，不硬猜） */
```

依据：段落 = 起点 → 拐点 → … → 终点，**相邻两点必同行或同列**（4 邻接），沿行/列逐格走过去即可。
缓冲 24 字节就够（5×5 里除起点最多 24 格）。

**屏上也改了**（`test.c` 的 `RadarTest_ShowLeg`）：页1~4 现在显示**展开后的逐格**编号，
第 2 行左边是雷达原样回的拐点数、右边是展开后的格数。

**验证**（把同一份几何/展开逻辑拿到 PC 上用 MSVC `/W4 /WX` 编译运行）：

| 用例 | 雷达原始 | 展开结果 |
|---|---|---|
| L1 `4→14` | 1 点 `[14]` | `5 14`（2 格）✓ |
| L2 `14→10` | 1 点 `[10]` | `13 12 11 10`（4 格）✓ |
| L3 `10→22` | 2 点 `[20,22]` | `19 20 21 22`（4 格）✓ |
| L4 `22→14` | 2 点 `[24,14]` | `23 24 15 14`（4 格）✓ |
| 起点4 + 拐点12（不共线） | — | 返回 0（拒绝）✓ |
| status=4 / 起点=终点 | — | 返回 0 ✓ |
| 25 格满路径（起点0，1~24） | 24 点 | 24 格 ✓（缓冲刚好够） |

程序算出的 5×5 布局与说明书 §9 印刷版**逐格一致** ✓。
固件构建：**0 错误 0 警告**，FLASH 75688 → **77676B**（+1988B：几何+展开+显示改动）。

**用途提醒**：驱车其实**不需要**展开 —— 起点→拐点→终点每段都是直线，按段走即可；
展开主要用于"想看清走哪几格"和以后"方格 → 场地坐标"的映射（那还需要各格的物理尺寸/原点，
`chassis.h` 里那套坐标宏能对上）。

### 61. 雷达测试模式**先显示障碍方格**（方格扫描的直接结果）

**需求**：`TEST_MODE=10` 跑完后，先把"障碍物在哪几格"显示出来 —— 那是方格扫描的直接结果，
也是后面四段路径规划的输入，顺序上先看它更直观。

**改动**：

1. `Radar/Inc/radar_task.h` + `Radar/Src/radar_task.c`：新增障碍方格接口
   （`launch_mission` 里 `Launch_GetGrid*()` 的薄封装，整车流程和屏幕都不用直接碰 launch_mission）：

   ```c
   uint8_t Radar_GetObstacleCount(void);                        /* 障碍格数；0 = 有效空结果 */
   bool    Radar_GetObstacle(uint8_t index, uint8_t *grid_id);  /* 按序号取，值 0~24 */
   bool    Radar_GridIsObstacle(uint8_t grid);                  /* 画 5×5 图用 */
   ```

2. `UserCode/Src/test.c`：新增 `RadarTest_ShowObstacles()` 作为**页0**，并抽了 `RadarTest_ShowPage()`
   统一分发。页序：

   | 页 | 内容 |
   |---|---|
   | 0 | **障碍方格 5×5 图**：`XX` = 有障碍、数字 = 空闲；标题 `obs grid n=X`（本次有失败时附 `f?` 码） |
   | 1 | 四段概览 `Lx 起点>终点 s状态 n拐点数` |
   | 2~5 | 第 1~4 段的**逐格**路线（6x8 小字） |

   摆位与说明书 §9 那张图一致（行4 在上、行0 在下）；若现场 Y 轴方向相反，把
   `RadarTest_ShowObstacles()` 里的 `(4U - row)` 改成 `row` 即可。
   按键不变：`C6` 下一页 / `C8` 上一页 / `A8` 重跑；`RADAR_TEST_PAGES = 2 + 4 = 6`。

**验证**：

- 离线核对摆位（与屏上同一套 `x = 4 + col*20`、`y = 16 + (4-row)*8`）：
  0~24 共 25 格两两不重叠、全部落在 5×5 内；置障碍 `{7,12,23}` 后画出来是

  ```text
  20 21 22 XX 24
  19 18 17 16 15
  10 11 XX 13 14
  09 08 XX 06 05
  00 01 02 03 04
  ```

  与说明书 §9 的图**逐格一致** ✓（`09/08` 是两位补零，屏上同理，列对齐更好看）。
- 固件构建：**0 错误 0 警告**，FLASH 77676 → **78200B**（+524B）。

**说明**：`count = 0` 是**有效空结果**（没有障碍），不是失败 —— 说明书 §6/§7 明确写了这一点；
真失败时标题会带 `f?`（f3 方格扫描 / f5 雷达里没有有效方格 等），可与 `Radar_GetFailure()` 对照。

### 62. 修"扫出来的障碍方格位置和数量都不对"：本程序把上位机标定的位姿覆盖掉了

**现象**：在上位机里把启停区2 的朝向偏移设成 **−72.8°**、区1 设成 **107.2°** 后，上位机扫描准确；
但 `TEST_MODE=10` 扫出来的障碍方格**位置和数量都不对**。

**根因**：本程序上电时 `SELECT_ZONE` 载入该区 Flash 位姿后，**紧接着又发 `SET_POSE`
把它覆盖成 `radar_config.h` 里那套**（当时是 X/Y=150/2200、朝向=0°）。位姿一变，
整片方格坐标系跟着转 —— 障碍自然落到别的格子里，数量也跟着变（格进/格出 5×5 区域）。
两边朝向当时差了 107°（区1）／180° 上下（区2），所以怎么调都对不上。

**改动**：

1. `Radar/Inc/launch_mission.h` + `Radar/Src/launch_mission.c`：新增 `LAUNCH_USE_SAVED_POSE`
   （头文件里 `#ifndef` 默认 0，本工程在 `radar_config.h` 里置 **1**）。
   置 1 时状态机**跳过 `SET_POSE`/`SAVE_POSE` 整步**，直接用 `SELECT_ZONE` 载入的那份
   （= 上位机标定的）→ 直接进 `STEP_GRID_SCAN`。
2. `Radar/Inc/radar_task.h` + `Radar/Src/radar_task.c`：新增位姿对照接口 ——
   `Radar_GetRadarPose()`（HELLO 自报；选完区后就是该区 Flash 里那份）、
   `Radar_GetConfigPose()`（config 那套）、`Radar_IsUsingSavedPose()`；`on_hello()` 缓存完整位姿。
3. `UserCode/Src/test.c`：**页1 = 位姿对照**，页序变为
   0 障碍方格 / 1 位姿对照 / 2 四段概览 / 3~6 四段逐格：

   ```text
   pose z2 SAVED          ← SAVED = 不覆盖雷达那份；SET = 本机覆盖它
   radar z2 330 200       ← 雷达自报（= 上位机标定的）
         h287.20
   cfg   z2 330 200       ← 本机 radar_config.h 那套
         h107.50
   diff  h179.7           ← 两者朝向之差（±180° 归一）——先看这行
   ```

**验证**（换算逻辑拿到 PC 上用 MSVC `/W4 /WX` 跑，不是纸面推）：

| 输入 | q6 | 显示 |
|---|---:|---|
| 107.2° | 6861 | `107.20` |
| **−72.8°** | **18381** | **`287.20`**（= 107.2°+180°：上位机那个"偏移"落到 q6 上就是这个值） |
| 287.5° | 18400 | `287.50` |
| 359.98° | 23039 | `359.98` |

diff 三个用例：`radar 287.20 / cfg 107.50 → h179.7`；两边一致 → `h0.0`；
`179.90 vs 180.10 → h-0.1`（超 ±180° 正确回绕）。

**顺手修掉一个显示 bug**：diff 原本是 `d10/10` 截断 + 取绝对值，**|差值| < 1° 时会丢符号**
（−0.3° 显示成 0.3°）—— 现场正是按 0.1° 量级调角度，这种符号错误会把人带偏。
改成显式判符号，并四舍五入到 0.1°。

**顺带记两个坑（都是既有代码，本次未改）**：

- `UserCode/Inc/chassis.h:9-10` 有 `#define a 100` / `#define b 115` 两个**单字母宏**：
  任何把 `a`/`b` 当形参名或局部变量名的代码都会被替换成数字
  （本次 `RadarTest_HeadingDiff(a, b)` 就撞了，报 `expected ';', ',' or ')' before numeric constant`）。
  已在自己代码里改名规避（`q6_a`/`q6_b`）；建议以后把它们改成 `CHASSIS_A` / `CHASSIS_B`。
- `launch_mission.h:59` 已经 `#include "radar_config.h"`，所以 `LAUNCH_*` 覆盖**在所有 TU 里都生效**
  （本次特地用编译探针验证过，避免"某个 .c 看不到工程配置"这类静默问题）。

**构建**：0 错误 0 警告；FLASH 78200 → **78712B**，RAM 8656 → **8672B**。

**下一步（等你上电确认）**：看页1 的 `radar` 两行是否与上位机显示一致。
- 一致 → 页0 的障碍图应该就和上位机对得上了；
- `radar -- (no hello)` → 没收到 HELLO（握手问题，看进度页第 4 行）；
- 是别的值 → 说明上位机那份**没保存进雷达**（在工具里点保存；或改回
  `LAUNCH_USE_SAVED_POSE=0` 并把工具里的 X/Y/朝向抄进 `radar_config.h`）。

### 62-补. 澄清"上位机里只是试了值、没保存"这种情况（2026-10-14 用户反馈）

**用户反馈**：上位机里只是把启停区2 的朝向偏移试成 −72.8°、区1 试成 107.2°，扫得准；
**但好像并没有保存位姿**。

**这对第 62 节的结论有什么影响**：

- ~~上位机的"能扫准"是这样来的：工具每次连上会把它的设置**推进雷达的会话位姿**（RAM）~~
  —— **这条是推断，没有证据**（见下面的更正）。
- 会话位姿的两个死法（如果它真的存在）：**雷达断电**、**被 SELECT_ZONE 重新载入 Flash 位姿覆盖**。

> ### ⚠ 更正（2026-10-14，用户质询后）：不要把推断当结论
>
> 本补记第一版写了"三条同时成立 → MCU 跑出来的扫描结果与上位机一致 ✓"，**这是过度断言**。
> 当时把两件事当成了事实，其实都没验证过：① 上位机把"朝向偏移"写进了雷达的**会话位姿**；
> ② 那份会话位姿在"工具断开 + 不给雷达断电"期间保持有效。**雷达里此刻究竟存着什么位姿，
> 以及那个"偏移"到底有没有进雷达，全都是未知。**
>
> 更要紧的是还有**第二种可能**（一直没排除）：
>
> | 假设 | 含义 | 判别 |
> |---|---|---|
> | H1 | 上位机把偏移写进雷达（会话/Flash 位姿），雷达按它算方格 | 改偏移 → MCU 扫出来的方格**跟着变** |
> | H2 | **偏移只是上位机的显示变换**：雷达回传原始数据，PC 在自己界面里旋转后画图；雷达自己那份位姿是别的值（甚至 0） | 改偏移 → MCU 扫出来的方格**一点不变** |
>
> H2 与用户"偏移 ≠ 位姿角度"的判断正好吻合。**H2 成立时，MCU 侧无论怎么调位姿都追不上上位机屏幕上那张图**
> —— 因为那张图是 PC 端变换出来的，雷达内部压根不知道这个偏移。
>
> **验收标准只有一个（不依赖任何约定）**：把测试模式**页0 的障碍图**与上位机屏幕上的图**逐格比对**。
> 一致才算对上了；不一致就按下面的实验判别。

**已验证的部分（只到代码层，不涉及硬件行为）**：

```c
/* radar_client.c:465-495 —— 区域已经一致时不选区 */
} else if (zone_valid(desired_zone) && hello.pose.zone != desired_zone && !transaction.active) {
        state.link_state = RADAR_CLIENT_LINK_NEED_ZONE;
} else {
        startup_read_pending = true;
}
```

即 **HELLO 报的区域 == 我们想选的区 → 不发 SELECT_ZONE**；再叠加
`LAUNCH_USE_SAVED_POSE = 1`（不发 SET_POSE）→ **MCU 一个位姿/选区字节都不发**（这条是代码事实）。
但"不发"只保证**不破坏**雷达里的东西，**不保证雷达里那份是对的** —— 那是未知数。

**怎么判别（只用 MCU + 上位机，不需要知道任何约定）**：

| 实验 | 做法 | 读法 |
|---|---|---|
| **A 验收** | 按现状跑一次 `TEST_MODE=10`，把**页0 的障碍图**与上位机屏幕上的图逐格比 | 一致 → 位姿就是对的，收工；不一致 → 做 B |
| **B 判别 H1/H2** | 上位机把 zone2 偏移改成差很多的值（比如 `+90.0`），**MCU 代码一个字不改**，再跑一次，看页0 的图 | 图跟着变 → H1（偏移进了雷达）；图**完全不变** → H2（偏移只是 PC 显示变换） |
| **C 读数** | 页1 的 `radar` 行（两种角度写法都给） | 给出雷达里那份的**真实值**；结合 B 就能定出"偏移 ↔ heading"的关系 |

**根据结果的处置**：

| 结果 | 处置 |
|---|---|
| A 一致 | 结束。想长期稳定就在上位机点一次**保存位姿**（写进该区 Flash），再跑一次 A 确认 |
| A 不一致 + B 变化（H1） | 雷达里那份 ≠ 上位机屏幕上那套 → 要么在上位机**保存位姿**，要么用 C 的读数定出关系后用
`LAUNCH_USE_SAVED_POSE=0` 由 MCU 自己写 |
| A 不一致 + B 不变（H2） | **MCU 用"雷达的方格结果"永远追不上上位机那张图**。此时要么在上位机里把偏移真正写进雷达（保存位姿），
要么改成**不用雷达的方格结果**：走完整扫描（`SCAN_LOCKED 0x07`，带 x/y 坐标）自己算格子，
在 MCU 侧复现那个旋转 —— 这是另一条技术路线，要先确认 H2 再谈 |

**构建**：0 错误 0 警告；FLASH 78740 → **78776B**。

**这一节顺带改的小东西**：位姿页在没有有效位姿时，原来只显示 `radar -- (no hello)`，
容易被当成"没握手"。现在显示

```text
radar -- no pose
save in PC tool
```

（OLED 字库只有 ASCII，所以用英文）。它对应的正是"上位机设过但没保存 / 或雷达断过电"这种情形；
真没收到 HELLO 的话，任务会在连接步就失败（进度页第 4 行 `no hello`、失败码 f1）。

**构建**：0 错误 0 警告；FLASH 78740 → **78776B**。

**顺带一句**：`radar_config.h` 里那两组朝向/坐标现在**不参与扫描**
（`LAUNCH_USE_SAVED_POSE=1` 时不发出去），只作页1 对照用 —— 别再靠改它们试角度了。

### 63. 位姿页同时显示两种角度表示，并给出"朝向偏移 ↔ heading"的**一次性测定**方法

**背景（用户判断）**：上位机里的"朝向偏移"**不等于**协议的位姿角度。这个判断有结构上的支撑：

- 上位机 zone1 = 107.2°、zone2 = −72.8°，两者之差**正好 180.0°**；
- 两个启停区在场地两端（区1 Y 1900~2600、区2 Y −200~500），雷达各自朝场内 →
  机械朝向本来就差 180° ✓。**偏移之差恰好等于 180.0°，说明这个"偏移"确实像"方向"一样在动**。
- 但它若**恰好等于**协议 `heading_q6`，那两者之差应是 180°，实际也是 180° —— 所以
  **两个数之差无法区分**下面两种关系（因为 ±180 ≡ 180 (mod 360)）：
  ```text
  heading = 偏移 + K          （只差一个共同常数 K，两个区同一个 K）
  heading = K − 偏移          （符号反向 + 共同常数）
  ```
  → **必须有一个"绝对读数"才能定死**，光凭两个偏移推不出来。

**改动**：`UserCode/Src/test.c` 的 `RadarTest_FormatHeading()` 换成
`RadarTest_FormatHeadingPair()`，页1 每行同时给出 **0~360** 和 **−180~180** 两种写法：

```text
pose z2 SAVED
radar z2 330 200
      h287.20 -72.80        ← 若雷达里那份就是上位机的 -72.8，这里第二列会直接显示 -72.80
cfg   z2 330 200
      h107.50 107.50
diff  h179.7
```

**验证**（MSVC `/W4 /WX` 跑同一份实现）：

| 输入 | q6 | 0~360 | −180~180 |
|---|---:|---|---|
| 107.2° | 6861 | `107.20` | `107.20` |
| **−72.8°** | **18381** | `287.20` | **`-72.80`** ✓ 与工具里的数字直接对上 |
| 180.0° | 11520 | `180.00` | `-180.00` |
| 359.98° | 23039 | `359.98` | `-0.02` ✓ 折叠正确 |

构建：0 错误 0 警告；FLASH 78776 → **78976B**。

**怎么用它一次性测出关系（推荐做一次，以后就不靠猜）**：

1. 上位机里把 zone2 偏移设成 **−72.8°**（就是你扫得准的那个值），**不要**断电、不要保存也行；
2. 跑测试模式，看**页1** `radar` 行的第二列：
   - 显示 **`-72.80`** → **偏移 == heading**（K = 0、不反向）→ 那种情况下把
     `RADAR_ZONE1_POSE_HEADING_DEG 107.2f` / `RADAR_ZONE2_POSE_HEADING_DEG -72.8f`
     原样填进 `radar_config.h` + `LAUNCH_USE_SAVED_POSE=0` 就能用；
   - 显示**别的数** `h'` → 就有 `K = h' − (−72.8)`（若同向）或 `K = h' + (−72.8)`（若反向）；
3. 想连"同向还是反向"一起定死：把偏移改成 **−62.8°**（+10°）再读一次 ——
   读数跟着 **+10** 就是同向，跟着 **−10** 就是反向。两次读数即可完全确定该关系。

**注意**：之前试过的三组值里，`0°` 和 `偏移+180°`（287.5／107.5）都**不是**"原样照抄"
（107.2／−72.8）—— 也就是说 **K = 0 这个最简单的可能，其实一次都没试过**。
另外 X/Y 本次按用户要求不讨论，但它同样参与"格子对不上"的平移分量；页1 也把它们列着。

### 64. 应用户要求：**程序自己设位姿**，朝向用上位机里扫得准的那组

**用户要求**（原话）："我要求你在程序里设置正确的朝向偏移"。

**改动**（`Radar/Inc/radar_config.h`，两行值 + 一个开关）：

| 项 | 原值 | 现值 |
|---|---|---|
| `RADAR_ZONE1_POSE_HEADING_DEG` | `287.5f` | **`107.2f`** |
| `RADAR_ZONE2_POSE_HEADING_DEG` | `107.5f` | **`(-72.8f)`** |
| `LAUNCH_USE_SAVED_POSE` | `1`（不设位姿） | **`0`（程序发 SET_POSE）** |

即：每次上电 `SELECT_ZONE` → `SET_POSE(330, 2200, 107.2°, 区1)` 或 `SET_POSE(330, 200, −72.8°, 区2)`，
**只改会话位姿、不写雷达 Flash**（`LAUNCH_SAVE_POSE_TO_FLASH = 0`）。

**换算与范围校验**（从配置读出来实算，不是手抄）：

| 区 | X | Y | 朝向 | → `heading_q6` | 范围 |
|---|---:|---:|---|---:|---|
| 1 | 330 | 2200 | 107.2° | **6861** | x∈[-200,500] ✓ y∈[1900,2600] ✓ |
| 2 | 330 | 200 | −72.8° | **18381** | x∈[-200,500] ✓ y∈[-200,500] ✓ |

客户端 `pose_valid()`（`radar_client.c:146`）只校验 `heading_q6 < 23040` 与分区 X/Y 窗口，
上面两组都通过 → 帧会真的发出去，不会被本地 f2 拦下。

**这个设定的含义（重要）**：程序成为位姿的**唯一来源** ——
**雷达 Flash/会话里存着什么就不再影响扫描结果**，行为可复现（这正是"程序里设"相对于"用雷达里那份"的好处）。

**代价**：这几个数必须真的对，没有"用雷达里那份"兜底。所以验收分两步，**别跳**：

1. **先验"发下去了没有"**：跑 `TEST_MODE=10`，看**页1** —— `radar` 行应等于 `cfg` 行，
   `diff` 必须是 **h0.0**。不是 0.0 就说明雷达没接受/没生效（先查这一层，别看方格图）；
2. **再验"在场地里对不对"**：看**页0 的障碍图**，与上位机屏幕上的图**逐格比对**。

**若第 2 步仍不一致，那就是"上位机的偏移 ≠ 协议 heading"这一层确实存在**（第 63 节的分析），
此时按第 63 节的方法两次读数定出关系（`heading = 偏移 + K` 还是 `K − 偏移`），改 `radar_config.h`
那一行即可；或者反过来在上位机里保存位姿、把开关置回 1。

**构建**：`cmake --build build/Debug --clean-first` → **0 错误 0 警告**；
FLASH 78976 → **79564B**（含第 63 节的双角度显示）。

### 65. 朝向关系按用户结论改为"位姿 = 180° + 偏移"，并做成单旋钮

**用户结论**（2026-10-14）：**雷达位姿好像等于 180° + 偏移**。

**改动**（`Radar/Inc/radar_config.h`）：把"关系"和"偏移"拆成两层，以后换关系只动一行：

```c
#define RADAR_HEADING_BASE_DEG     180.0f   /* 关系里的常数项："180°+偏移" 里的 180° */
#define RADAR_ZONE1_OFFSET_DEG     107.2f   /* 上位机里显示的原样值，不在这里换算 */
#define RADAR_ZONE2_OFFSET_DEG     (-72.8f)
#define RADAR_ZONE1_POSE_HEADING_DEG   (RADAR_HEADING_BASE_DEG + RADAR_ZONE1_OFFSET_DEG)  /* 287.2f */
#define RADAR_ZONE2_POSE_HEADING_DEG   (RADAR_HEADING_BASE_DEG + RADAR_ZONE2_OFFSET_DEG)  /* 107.2f */
```

`LAUNCH_USE_SAVED_POSE` 保持 **0**（程序自己发 `SET_POSE`，只改会话位姿、不写 Flash）。

**宏展开实算**（不是手抄）：

| 区 | 偏移 | heading | `heading_q6` | 位姿页两种写法 | X/Y 范围 |
|---|---:|---:|---:|---|---|
| 1 | +107.2° | 287.2° | **18381** | `h287.20` / `-72.80` | 330/2200 ✓ |
| 2 | −72.8° | 107.2° | **6861** | `h107.20` / `107.20` | 330/200 ✓ |

当前 `RADAR_ZONE_DEFAULT = 2U` → 先跑的是**区2**那一行（q6 6861）。两区的 q6 与第 64 节那版**正好互换**，
这正是加 180° 的必然结果（287.2° ≡ −72.8°）。

**一个值得注意的巧合**：这组值（287.2／107.2）与用户当时试过的 **287.5／107.5 是同一个关系、只差 0.3°**
（0.3° 在 2 m 上约 10 mm，量化 1/64°=0.0156° 也远小于它）。所以那次若图仍不对，
剩下的解释只有 **X/Y 的平移分量**（或当时其它设置），不是朝向。

**一次跑就能判定关系对不对**（`RADAR_HEADING_BASE_DEG` 是可回退的单点）：

| 页0 与上位机屏幕对比 | 结论 | 处置 |
|---|---|---|
| **一致** | 关系正确 | 收工；要长期稳定可再在上位机保存位姿 |
| 正好是"上位机那张图绕雷达转 **180°**" | 关系其实是**恒等**（位姿 = 偏移） | 把 `RADAR_HEADING_BASE_DEG` 改成 `0.0f`（只动一行） |
| 其它方向的旋转/整体平移 | 关系里还有别的项，或 X/Y 不对 | 按第 63 节两次读数定关系；平移部分查 X/Y |

**构建**：0 错误 0 警告；FLASH **79564B**（与第 64 节同 —— 本次只改了宏的取值）。

### 65-补. 诚实记录：第 62→65 节绕了一圈，最终值≈用户最初那版

**用户质询**："这跟我最开始的程序不一样吗" —— 对，**基本一样**。对照：

| | 用户最初那版 | 第 65 节之后 |
|---|---|---|
| zone1 朝向 | `287.5f` | `180 + 107.2 = 287.2f`（差 **0.3°**） |
| zone2 朝向 | `107.5f` | `180 + (−72.8) = 107.2f`（差 **0.3°**） |
| 位姿发送 | 每次上电 `SET_POSE` | 每次上电 `SET_POSE`（相同） |
| X/Y、起点格、默认区 | 330/2200、330/200、4/0、区2 | 未改动 |

**两个 +0.3° 是同一个方向的系统性偏差**，说明用户当时**已经在用"180°+偏移"这个关系**了
（0.3° 在 2 m 上约 10 mm，格宽 480 mm，不可能改变格子归属）。

**结论（重要，避免下次再绕）**：

1. 既然朝向值与用户最初那版只差 0.3°、发送行为也相同，**那么"最初扫不对"的原因不在朝向值本身**
   —— 这一版大概率会复现同样的现象。**不要再在朝向数值上兜圈**。
2. 第 62 节"不发位姿"那一步是基于**未验证的推断**（假设上位机把位姿写进了雷达）做出的，
   属于我的判断失误；第 64/65 节按用户指令改回"程序自己发"，方向正确。
3. 这一轮真正产出的是**诊断能力**，不是数值：

   | 新增 | 用途 |
   |---|---|
   | 页0 障碍方格 5×5 图 | 与**物理现场**或上位机屏幕逐格比对 |
   | 页1 位姿对照（含 ±180° 归一的 diff） | 先证明"值发下去了没有"（diff 必须 0.0） |
   | 上位机偏移改动 → 看页0 是否跟着变 | 判别 H1（偏移进了雷达）/ H2（偏移只在 PC 侧） |

4. **下一步该做的两个实验**（按可信度排序）：

   | 实验 | 做法 | 能得到什么 |
   |---|---|---|
   | **物理基准**（最可信，只需要一把尺子） | 在场地上放一个障碍，记下它**实际的**位置/格子；跑测试模式看页0 报的是哪一格 | 报的格子 = 实际格子 ⇒ 位姿对；差 θ° 的旋转 ⇒ **朝向误差（在雷达自己的坐标系里量出来的，不依赖任何上位机约定）**；整体平移几格 ⇒ X/Y 平移分量 |
   | **H1/H2 判别** | 上位机把偏移改到差很多（如 +90°），MCU 代码不动再跑一次，看页0 | 图跟着变 ⇒ H1；**完全不变** ⇒ H2（那个偏移只在 PC 侧生效，MCU 用"雷达的方格结果"永远追不上上位机那张图，得改技术路线） |

5. 还有一个前置问题需要用户确认：**判断"上位机扫得准"，是拿工具屏幕上的图与现场实际位置对过，
   还是只是工具自己显示得像模像样？** 前者说明雷达内部位姿确实被工具设对了；后者可能只是 PC 侧显示变换。

### 66. 路线由 4 段更正为 **5 段**：起点(启停区) → 2 → 14 → 10 → 22 → 14

**用户更正**："共需要规划 5 段路径，启停区至2、2-14、14-10、10-22、22-14，相关代码全部修改"。

**改动清单（全量，不留写死的段数）**：

| 文件 | 改动 |
|---|---|
| `Radar/Inc/radar_config.h` | `LAUNCH_ROUTE_GOALS` = `{ 2U, 14U, 10U, 22U, 14U }`（5 个终点 → 5 段）；`RADAR_RUN_TMO_MS` 20000 → **30000**（方格扫描 8s + 5×1.5s，留余量） |
| `Radar/Inc/radar_task.h` | `RADAR_LEG_COUNT` 4 → **5**；新增 `Radar_Path5` 宏；注释"四段"→"五段" |
| `Radar/Src/radar_task.c` | 进度页 `leg %u/4` → `leg %u/%u`（用 `RADAR_LEG_COUNT`）；结束摘要循环 4 → `RADAR_LEG_COUNT`，且 **16px 字体→6x8 小字**（一屏只能放 4 行 16px，5 段放不下：y=0/8/16/24/32，失败码 y=48） |
| `UserCode/Src/test.c` | 概览页同样改成"标题 + 5 行 6x8"（标题 `legs n/5 f码`）；分页/循环全部按 `RADAR_LEG_COUNT`，段数变化自动跟着变；页号注释 `页3~7 第 1~5 段` |
| `UserCode/Inc/test.h` | 模式 10 说明改成 5 段 + 新页号 |
| `流程设计书.md` | 11 处"四段"→"五段"；路线写成 `{出发点, 2, 14, 10, 22, 14}`；页号、`Radar_Path[5]` 同步 |

**关键点：段数只在两个地方定义，其余代码全部按宏/路线长度循环**：

```c
/* radar_config.h */ #define LAUNCH_ROUTE_GOALS  { 2U, 14U, 10U, 22U, 14U }
/* radar_task.h   */ #define RADAR_LEG_COUNT     5U
```

以后再加/减一段，只改这两行 + 重新编译（`launch_mission` 的 `LAUNCH_MAX_LEGS=7` 是容量上限，
5 段在范围内 ✓；分页数 `RADAR_TEST_PAGES = 3 + RADAR_LEG_COUNT` 自动变）。

**校验（从配置实际读出来算，不是手抄）**：

```text
LAUNCH_ROUTE_GOALS = { 2U, 14U, 10U, 22U, 14U } -> 终点个数 = 5
RADAR_LEG_COUNT    = 5
段序列: 起点 -> 2 -> 14 -> 10 -> 22 -> 14
一致: ✓
```

第一段的起点仍跟着启停区走（`RADAR_ZONE1_START_GRID=4`、`RADAR_ZONE2_START_GRID=0`），
即区2 跑出来是 `0→2、2→14、14→10、10→22、22→14`；区1 是 `4→2、2→14、…`。

**构建**：`--clean-first` 全量 **0 错误 0 警告**；RAM 8968B（6.84%）、FLASH **79732B**（15.21%）。
（RAM 比 4 段时 +296B：多一段的 `leg_results`+`Radar_Path` 共约 58B，其余是第 66-补 的扫描缓存。）

**诊断接口已就绪（本次未接页面）**：`Radar_RunFullScan()` / `Radar_GetScanCount()` /
`Radar_GetScanObstacle()` —— 完整扫描（`SCAN_LOCKED 0x07`，**不写 Flash**）回传每个障碍的
**场地毫米坐标**，用来把"转了多少度/移了多少毫米"直接量出来（见 65-补 的实验）。
需要的话接一页即可（约 40 行）。

> 注：本文件此前各节里的"四段"均为**当时的**路线记录，不追改；自本节起以五段为准。

### 67. 按要求去掉"位姿对照"页（原页1）

**用户要求**："把页1去掉"。

**改动**（`UserCode/Src/test.c` + 注释/文档同步）：

1. 删除 `RadarTest_ShowPose()` 及它专用的两个辅助函数
   `RadarTest_FormatHeadingPair()`（q6→0~360 / −180~180 两种写法）、
   `RadarTest_HeadingDiff()`（朝向差归一到 ±180°）—— 留着会变成未引用的静态函数，`-Wall` 会报错。
2. 分页重排（页数由 `RADAR_TEST_PAGES = 2 + RADAR_LEG_COUNT` 自动算，当前 7 页）：

   | 旧 | 新 |
   |---|---|
   | 页0 障碍方格 | 页0 障碍方格 |
   | 页1 位姿对照 | **去掉** |
   | 页2 五段概览 | **页1** 五段概览 |
   | 页3~7 第 1~5 段逐格 | **页2~6** 第 1~5 段逐格 |

3. **保留** `radar_task` 里的位姿读取接口（`Radar_GetRadarPose()` / `Radar_GetConfigPose()` /
   `Radar_IsUsingSavedPose()`）—— 它们不是死代码，排查"位姿到底发没发下去"时在程序里读一下就够，
   不必占屏；以后要再看，接一页即可。

**构建**：0 错误 0 警告；**FLASH 79732 → 78460B**（−1272B，删掉的两个格式化函数 + 那一页），RAM 不变（8968B）。

> 提醒：本文件第 62/63/65 节提到"页1 位姿对照/diff"是**当时的**界面，现已没有这一页；
> 需要对照位姿时改用上面的接口。

### 68. 加第 6 段：走完 22→14 后**回到启停区**

**用户要求**："再加一段路径规划，第六段，从22回到启停区"。

**先说清我实现的是哪一段（有歧义，见下）**：第 5 段 `22→14` 结束在 **14**，所以第 6 段是
**`14 → 起点格`**（起点格 = 该启停区的出发点方格）。最终 6 段：

```text
区2（起点=0）：0→2、2→14、14→10、10→22、22→14、14→0
区1（起点=4）：4→2、2→14、14→10、10→22、22→14、14→4
```

> ⚠ 如果你要的是**从 22 直接回启停区**（即去掉/改写第 5 段 `22→14`），那是另一条路线：
> 把 `LAUNCH_ROUTE_GOALS` 改成 `{ 2U, 14U, 10U, 22U }` 即可 → 变成
> `起点→2→14→10→22→起点`（5 段）。一句话我就改。

**技术要点（为什么不能把回程终点写进配置文件）**：回程终点 = **起点格**，而起点格随启停区变
（区2 = 0、区1 = 4）且可被 `Radar_SetStartGrid()` 改。写死在 `LAUNCH_ROUTE_GOALS` 里，
换区或改起点后回程就会走到**旧格子**。因此改成**运行时拼路线**：

`radar_task.c` 新增 `Radar_ComposeRoute(start_grid)`：

```c
nodes = { 起点, 2, 14, 10, 22, 14, [起点] }   /* 最后一项由 RADAR_RETURN_TO_START 决定 */
→ Launch_SetRoute(nodes, n)                    /* n = 7，段数 6 ≤ LAUNCH_MAX_LEGS(7) ✓ */
```

调用点两处：`Radar_SetZone()`（选/换启停区时）与 `Radar_SetStartGrid()`（改起点时），
保证"起点 ↔ 回程终点"永远一致。

**配置**（`radar_config.h`）：

```c
#define LAUNCH_ROUTE_GOALS     { 2U, 14U, 10U, 22U, 14U }   /* 只列去程终点 */
#define RADAR_RETURN_TO_START  1    /* 1 = 末尾自动接一段回程；0 = 只跑 5 段（第 6 槽显示 "--"） */
```

`radar_task.h`：`RADAR_LEG_COUNT` 5 → **6**。其余全部自动跟随：
`Radar_Path[6]`（168 B）、概览/摘要各 6 行、分页数 `RADAR_TEST_PAGES = 2 + 6 = 8`（页2~7 = 第 1~6 段）。

**校验（照抄拼装逻辑离线算，不是手抄）**：

```text
区2(起点=0): nodes=[0, 2, 14, 10, 22, 14, 0]  段数=6: 0→2、2→14、14→10、10→22、22→14、14→0
区1(起点=4): nodes=[4, 2, 14, 10, 22, 14, 4]  段数=6: 4→2、2→14、14→10、10→22、22→14、14→4
RADAR_RETURN_TO_START = 1
```

**构建**：`--clean-first` 全量 **0 错误 0 警告**；RAM 8968 → **8992B**（+24B，第 6 段多一个 `radar_path_t`… 实际是 28B 里的对齐差），
FLASH 78460 → **78652B**（+192B：组路线逻辑 + 屏上多一行）。

### 69. 更正第 6 段：**保留 L5 `22→14`，L6 改成从 22 回启停区**（非链式路线）

**用户要求**："保留第五段从22-14，同时第六段规划从22回到原本的启停区"。

第 68 节把 L6 写成了 `14→起点`（因为 L5 结束在 14）。按要求改成 **`22→起点`**：

```text
区2（起点=0）：L1 0→2  L2 2→14  L3 14→10  L4 10→22  L5 22→14  L6 22→0
区1（起点=4）：L1 4→2  L2 2→14  L3 14→10  L4 10→22  L5 22→14  L6 22→4
```

**关键点：L6 不是接着 L5 的**（L5 结束在 14，L6 从 22 出发）—— 原来的 `launch_mission`
用"节点链" `{起点, 终点1, 终点2, …}` 表示路线，**表达不了"端点对不上"的段**。所以做了这些改动：

1. **`launch_mission` 路线模型：节点链 → 逐段显式**
   - 内部 `route_nodes[]` / `route_length` 换成 `leg_starts[]` / `leg_goals[]` / `leg_total`
     （各 `LAUNCH_MAX_LEGS` 个，RAM +14B）；
   - 规划循环改用 `leg_starts[i] → leg_goals[i]`；
   - 新增 `bool Launch_SetLegs(const uint8_t *starts, const uint8_t *goals, uint8_t leg_count)`：
     **段与段之间不必首尾相连**；
   - `Launch_SetRoute()`（链式）内部改成填逐段数组 → 旧调用方式仍然可用；
     `Launch_SetStart()` 只改第 1 段起点；
   - 删掉没人用的 `Launch_GetRouteLength()` / `Launch_GetRouteNode()`（链式语义在非链式路线下没意义），
     换成 `Launch_GetLegTotal()` / `Launch_GetLegEndpoints(leg, &start, &goal)`。
2. **`radar_task.c` 的 `Radar_ComposeRoute()`**：去程 5 段照旧（链式），
   回程段显式 `RADAR_RETURN_FROM_GRID(22) → start_grid`，用 `Launch_SetLegs()` 下发。
3. **`radar_config.h`**：新增 `RADAR_RETURN_FROM_GRID 22U`（第 6 段起点，改路线时一起改）。
   `RADAR_RETURN_TO_START=0` 时只跑 5 段。
   `RADAR_LEG_COUNT` 仍为 **6**（分段数与之前一致，`Radar_Path[6]` 不变）。

**校验**（照抄 `Radar_ComposeRoute` 拼法离线算）：

```text
区2(起点=0) 段数=6: L1 0→2  L2 2→14  L3 14→10  L4 10→22  L5 22→14  L6 22→0
区1(起点=4) 段数=6: L1 4→2  L2 2→14  L3 14→10  L4 10→22  L5 22→14  L6 22→4
RADAR_RETURN_TO_START=1  RADAR_RETURN_FROM_GRID=22
```

**构建**：`--clean-first` 全量 **0 错误 0 警告**；RAM 8992 → **9000B**，FLASH 78652 → **78736B**。

> ⚠ **要给驱车用的话注意**：L5 结束在 14、L6 从 22 出发，两者**不连续**。
> 若要把 6 段按顺序连续执行，得在 L5 和 L6 之间补一段 `14→22`（那就是 7 段了，或把 L5 改成 14→22）。
> 现在这样只是**规划结果**：6 条路径各自独立，车实际怎么走由上层决定。

### 70. `TEST_MODE=1`（Test_AGV）前面加上"雷达扫描一次 + 路径规划"，规划完直接开跑

**用户要求**："更改 Testmode = 1 时的 Test_AGV() 函数，在前面加上雷达扫描一次及路径规划的代码，
规划完成后直接开跑"。

**改动**（`UserCode/Src/test.c` 的 `Test_AGV()`，`test.h` 模式表同步）：

```c
#ifndef TEST_AGV_WITH_RADAR
#define TEST_AGV_WITH_RADAR  1      /* 0 = 跳过雷达那段（台架只验底盘时用） */
#endif

static void Test_AGV(void)
{
#if TEST_AGV_WITH_RADAR
    Radar_Init();                 /* 测试模式下 AGV_Init() 没被调用，雷达要自己初始化；
                                     这里只装选区请求 + 位姿 + 路线，不发帧 */
    (void)Radar_RunOnce();        /* 握手→选区→设位姿→一次 14 圈方格扫描→六段规划→STOP
                                     （内部 Dbg_Suspend/Resume，屏上显示进度与六段摘要） */
    HAL_Delay(1000);              /* 停 1s 看清摘要，然后**直接开跑**，不等按键 */
#endif
    HWT101_Init(&huart5);
    AGV_Position_Depart();        HAL_Delay(2000);
    AGV_Position_Qcode_to_Raw();  HAL_Delay(2000);
    AGV_Position_Raw_to_Rough();  HAL_Delay(2000);
    AGV_Position_Rough_to_Temp(); HAL_Delay(2000);
    AGV_Position_Temp_to_Raw();   HAL_Delay(2000);
}
```

完整顺序：`Test_HwInit()`（OLED/调试/CAN/DWT/航向PID）→ **等 A8** →
**雷达：握手→选区→位姿→方格扫描→六段规划** → 停 1s 显示摘要 → **直接开跑**检测路线 → 结束。

**两点说明（都写进了注释）**：
1. 开跑走的是**原有固定路线函数** `AGV_Position_xxx`，**不是**把雷达规划出的方格路径喂给底盘 ——
   那还需要"方格 → 场地坐标"映射表（尚未定，见第 60 节）。想用规划结果驱车，接在
   `Radar_RunOnce()` 之后调 `AGV_Position_Go(x, y, dir)` 即可。
2. 台架只验底盘时把 `TEST_AGV_WITH_RADAR` 置 0：否则会先等雷达连接超时（8s）或白跑一遍扫描。
   雷达失败也不会卡住后续跑车（`Radar_RunOnce()` 返回 false 只表示没规划成功，这里没拿它拦流程）。

**构建**：0 错误 0 警告；RAM 9000 → **9104B**，FLASH 78736 → **78144B**
（FLASH 变小是因为选 `TEST_MODE=1` 时模式 10 的整段测试代码被 gc-sections 回收）。

### 71. 雷达收放舵机（第 4 路 `SERVO_RADAR` = TIM4_CH1/PD12）；`Test_AGV()` 改成"伸出→扫描规划→收回→开跑"

**用户要求**："舵机转到 360° 时，雷达收入车内；舵机 0° 时，雷达伸出。在 Test_AGV() 中，
初始时先伸出雷达，扫描规划完后收入雷达，然后再开始跑"。

**硬件发现（省事的关键）**：`Core/Src/tim.c` 里 **`TIM4_CH1 = PD12`（`GPIO_AF2_TIM4`）的 PWM 复用
早就配好了**（`MX_TIM4_Init()` 也在 `main.c` 里被调用），但舵机驱动一直没用它 —— 正好给雷达收放舵机用，
**不需要改 CubeMX/.ioc**。

**改动**：

1. **`HARDWARE/Inc/servo.h` + `Src/servo.c`：加第 4 路舵机**
   - `SERVO_RADAR = 3`，`TIM4_CH1 = PD12`，量程 **0°~360°**（500~2500 µs），
     **上电初值 360°（收起）** —— 不会一上电雷达就弹出来；
   - 配置表 `servoCfg[3]→[4]`、`hServo[3]→[4]`；`Servo_TimInit()` 加 `TIM4` / `GPIOD` 时钟使能；
   - 新增 **`Servo_InitId(ServoId)`**：只初始化**一路**舵机（测试模式里不碰机械臂那三路，
     否则机械臂会突然被复位到上电初值）；
   - 三处 `id > SERVO_TURN` 上界改成 `SERVO_RADAR`；
   - 平滑参数 `SERVO_R_*`：1.5°/2 ms（360° 整程 ≈ 720 ms），到位裕量 500 ms。
2. **`Radar/Inc/radar_config.h`**：`RADAR_SERVO_OUT_DEG = 0.0f`（伸出）、
   `RADAR_SERVO_IN_DEG = 360.0f`（收起）、`RADAR_SERVO_STEP_DEG/STEP_MS/SETTLE_MS`。
3. **`Radar/Inc|Src/radar_task.*`**：新增收放接口
   ```c
   void Radar_SetDeployed(bool extended);   /* true=0°伸出 / false=360°收回，阻塞到到位 */
   bool Radar_IsDeployed(void);
   ```
   首次调用自己 `Servo_InitId(SERVO_RADAR)`（不碰机械臂）；内部
   `Servo_SetAngleSmooth()` + `HAL_Delay(RADAR_SERVO_SETTLE_MS)`，返回时雷达**确实到位**。
4. **`UserCode/Src/test.c` 的 `Test_AGV()`**：
   ```c
   Radar_SetDeployed(true);    /* ① 伸出雷达（0°） */
   Radar_Init();
   (void)Radar_RunOnce();      /* ② 握手→选区→位姿→方格扫描→六段规划→STOP */
   Radar_SetDeployed(false);   /* ③ 收入车内（360°） */
   HAL_Delay(500);             /* ④ 摘要再看 0.5s，然后直接开跑 */
   AGV_Position_Init(); HWT101_Init(&huart5); ...原有各段...
   ```
5. `test.h` 模式表第 1 项同步。

**验证**：全量构建 **0 错误 0 警告**；`servo.c` 与 `test.c`（TEST_MODE = 0 / 1 / 10）语法检查全过；
目标文件符号确认 `Servo_InitId` / `Radar_SetDeployed` / `Radar_IsDeployed` 都已编进去
（最终 ELF 里是否保留取决于 `TEST_MODE` 选的 case）。RAM **9176B**、FLASH **78916B**。

**注意事项（都写进注释了）**：
- 上电初值 360°（收起）。
- 若之后又调 `Servo_Init()`（`Pick_Init()` 内部会调），雷达舵机会被**复位到 360°(收起)**：
  生产流程里"伸出→扫描→收回"要排在 `Pick_Init()` **之后**，否则会被复位。
- **当前 `TEST_MODE = 10`**；要跑这套流程得把它改成 **1**。
- 收放是阻塞动作（伸出/收回各 ~1.2 s），别放在非阻塞轮询里频繁调用。

### 72. 保险起见：雷达"收起角"由 360° 改成 **180°**

**用户要求**："保险起见，先把收起度数改成 180°"。

**改动**（只改**收起位置**与**上电初值**，舵机**量程仍是 0°~360°**，没动量程）：

| 位置 | 原值 | 现值 |
|---|---|---|
| `radar_config.h` → `RADAR_SERVO_IN_DEG`（收起角） | `360.0f` | **`180.0f`** |
| `servo.c` → `SERVO_R_START_ANG`（上电初值 = 收起位置） | `360.0f` | **`180.0f`** |
| `SERVO_R_MAX_ANG`（量程上限） | `360.0f` | **不变**（硬件量程） |
| `RADAR_SERVO_OUT_DEG`（伸出角） | `0.0f` | **不变** |

同时把 `radar_config.h` / `radar_task.h` / `radar_task.c` / `servo.h` / `servo.c` /
`test.c` / `test.h` 里所有"360° = 收入车内""上电初值 360°"的注释改成 180°（量程相关的
"0°~360°"保持不变），并注明"2026-10-14 收起角先按用户要求从 360° 改成 180° 作保险"。

**实算（从宏读出来算，舵机实际收到的脉宽）**：

```text
舵机量程 0°~360°, 脉宽 500~2500us
上电初值 180° -> 1500 us   (= 收起位置，上电不会突然甩到端点)
伸出（扫描时） 0°   ->  500 us
收起（行驶时） 180° -> 1500 us
0°↔180° 行程：120 步 × 2ms = 240ms + 到位裕量 500ms ≈ 0.74s（单程）
```

**构建**：`--clean-first` 全量 **0 错误 0 警告**；RAM **9176B**、FLASH **78916B**（数值改动，占用不变）。

**注意**：
- 上电默认停在 **180°（收起）**，此时脉宽是 1500 µs（中位）—— 比原来的 2500 µs 更"居中"，
  万一机械限位有偏差也不容易顶到端点，这也是"保险"的实际效果。
- 伸出仍是 **0°（500 µs）**；如果现场发现 0° 这端顶得厉害，改 `RADAR_SERVO_OUT_DEG` 即可（如 10°），
  不用动代码别处。

### 73. 测试模式**上电即把雷达舵机复位到"收起"（180°）**

**用户问**："如果只跑测试程序，上电时雷达会自动收回吗"。

**答（改之前）：不会。** 原因链：

1. `main()` 里的 `MX_TIM4_Init()` 只是把 `TIM4_CH1 = PD12` 配置成 PWM 模式，
   **没有 `HAL_TIM_PWM_Start()`** → 上电后该引脚**没有 PWM 输出**；
2. 测试模式的启动链 `main → Test_Switch → Test_HwInit` 里**没有** `Servo_Init()`；
3. ⇒ 上电后雷达舵机**没有信号**（取决于舵机：松脱/无力，或保持机械位置不动），
   程序**没有**把它收到 180°。万一它停在"伸出"位置，车一开就撞。
4. 例外（改之前）：模式 2/3/4/5/9 会走 `Pick_Init()` → `Servo_Init()`（里面已含第 4 路），
   这些模式上电后**会**把雷达舵机复位到 180°；而模式 7（相机）/ 8（屏幕）/ 10（雷达）
   和正式流程的上电阶段都不会碰它。

**改动**（`UserCode/Src/test.c`）：

```c
#include "servo.h"     /* 新增 */

static void Test_HwInit(void)   /* 所有测试模式共用的初始化，在等 A8 之前跑 */
{
    ...原有：OLED / Dbg / CAN / DWT / 航向PID...

    /* 雷达收放舵机：上电先复位到 180°(收起)。
       MX_TIM4_Init() 只配置没启动 PWM，测试模式上电流程里也没有 Servo_Init()，
       不加这句上电后舵机没有信号、位置未知。只初始化雷达这一路，不碰机械臂三路。 */
    Servo_InitId(SERVO_RADAR);
}
```

`Servo_InitId()` → `Servo_TimInit()` 会把 OC 初值按 `SERVO_R_START_ANG = 180°` 算成 **1500 µs**
并 `HAL_TIM_PWM_Start()` → **一上电就锁在收起位，不会先甩到端点**。

**效果**：任何测试模式（1~10）上电后，雷达舵机立刻被初始化并锁在 **180°（收起）**；
从"等 A8"到按下的这段时间雷达一直是收起的；模式 1（Test_AGV）随后再按需伸出。

**验证**：`--clean-first` 全量 **0 错误 0 警告**；`TEST_MODE = 1 / 4 / 8 / 10` 语法检查全过；
RAM **9176B**、FLASH **78956B**。

**未覆盖**：正式流程（`TEST_MODE=0` 时 `AGV_Init()`）上电阶段仍不会动雷达舵机 ——
需要的话在 `AGV_Init()` 开头加同样一句 `Servo_InitId(SERVO_RADAR);`（说一声就加）。

### 74. 定稿：位姿全部交给上位机，程序**不做任何位姿修改**（`LAUNCH_USE_SAVED_POSE = 1`）

**用户要求**："不需要在软件中进行任何雷达位姿的修改，我已经在上位机中设置并写入雷达 flash"。

**改动**（`Radar/Inc/radar_config.h`，一个开关 + 注释同步）：

| 项 | 原值（第 65 节） | 现值 |
|---|---|---|
| `LAUNCH_USE_SAVED_POSE` | `0`（程序发 SET_POSE） | **`1`（不设位姿）** |
| `RADAR_ZONE1/2_POSE_*`（X/Y/朝向） | 会被下发 | **参考值，不再下发** |
| `RADAR_HEADING_BASE_DEG` / `RADAR_ZONE1/2_OFFSET_DEG` | 用于算下发值 | **仅参考**，注释已标"别指望改这里能影响扫描结果" |
| `LAUNCH_SAVE_POSE_TO_FLASH` | 0 | 0（开关=1 时本来就不生效） |

**行为变化**：

- 全程**不发送** `SET_POSE(0x06)` / `SAVE_POSE(0x11)`；
- 换区时由 `SELECT_ZONE(0x05)` 载入该区 **Flash 里那份**位姿；
- **区域已一致时不发 `SELECT_ZONE`**（`radar_client.c:477`）→ 位姿原样保留，连"重新载入"都不会发生；
- `radar_config.h` 里那两组 X/Y/朝向从此只作参考，**改它不再影响扫描结果**。

**验证（硬证据）**：

- 全量构建 **0 错误 0 警告**；FLASH 78956 → **78368B（−588B）**；
- `arm-none-eabi-nm` 确认 **`RadarClient_RequestSetPose` 与 `RadarClient_RequestSavePose`
  已从固件中消失**（无调用 → 被 gc-sections 回收）—— 即**任何代码路径都不可能再改雷达位姿**；
- `Launch_SetPose()` 保留为 API（只把值存起来），`launch_mission` 的 `STEP_SET_POSE`
  在 `#if LAUNCH_USE_SAVED_POSE` 下**直接跳到方格扫描**，不会执行位姿请求。

**前提 / 注意**：

1. 对应启停区的位姿必须已在上位机里**保存进雷达**；两区是**独立保存**的，换区前各自确认。
2. 若以后要改回"程序设位姿"，把开关改 0，并在 `radar_config.h` 填对 X/Y/朝向
   （关系推导与判定方法见第 63/65 节）。
3. 排查时用 `Radar_GetRadarPose()`（HELLO 自报）可读出雷达**实际生效**的位姿。

**文档同步**：`流程设计书.md` 7.5 / 7.6 已改成"位姿由上位机负责、程序不动"的定稿说法。

### 75. 雷达收放舵机：加"方向反向"和"上电初始化"两个开关（排查"上电转反了"）

**用户反馈**："上电时雷达舵机的初始化好像不太对，应该是转反了"。

**先把上电到底发了什么算清楚**（按 `servo.c` 当前雷达配置：量程 0~360°、脉宽 500~2500 µs）：
上电初值 180° → **1500 µs**。而 **1500 µs 是舵机行程的中点**，不是按机构算出来的"收起位"。

**"转反了"可能是两件完全不同的事，各给一个开关**：

| 开关 | 位置 | 默认 | 作用 |
|---|---|---|---|
| `SERVO_R_INVERT` | `servo.c` 雷达配置区 | `0`（正常） | `1` = 角度→脉宽**反向**（500 µs ↔ 2500 µs 对调），舵机/摇臂装反时用 |
| `SERVO_R_INIT_AT_BOOT` | `servo.h` | `1`（要） | `0` = **上电先不动舵机**（标定"收起角/方向"期间用），第一次 `Radar_SetDeployed()` 才初始化 |

**实现**：`ServoCfg` 加 `invert` 字段；新增 `Servo_AngleToPulse()` / `Servo_PulseToAngle()`，
`Servo_TimInit` 的初始脉宽、`Servo_SetAngle`、`Servo_GetAngle` 全部改走这两个函数
（另外三路 `invert = 0`，行为与原来完全一致）。

**实算两种方向下的脉宽**：

| 设置 | 上电(180°) | 伸出(0°) |
|---|---:|---:|
| `SERVO_R_INVERT = 0` | 1500 µs | **500 µs** |
| `SERVO_R_INVERT = 1` | 1500 µs | **2500 µs** |

**关键提醒（别白试）**：**180° 永远是行程中点，反向开关改变不了它的物理位置**。
- 若上电后它停在**伸出侧** → 不是方向问题，而是 **180° 这个角度不是收起位**：
  改 `radar_config.h` 的 `RADAR_SERVO_IN_DEG`（或先确认舵机真实行程）。
- 若**方向反了**（角度变大反而往伸出走）→ `SERVO_R_INVERT = 1`。
- 若舵机真实行程不是 360°（工程里另外两路是 270°/180°）→ 先改 `servo.c` 的 `SERVO_R_MAX_ANG`
  为真实行程，角度的物理含义才正确（例：270° 舵机时"180°"应发 1833 µs，而不是现在的 1500 µs）。

**验证**：全量构建 **0 错误 0 警告**。

**FLASH 变小说明**：78368 → **76132 B** 是因为用户把 `TEST_MODE` 从 **10** 改成了 **1**
（模式 10 那套分页显示代码被 gc-sections 回收），**与本次改动无关**。

**待用户确认（给一条就能定死）**：① 舵机型号/真实行程（180°/270°/360°）；
② 上电时它往哪边转、最后停在伸出还是收起；③ 或"收起"对应的角度/脉宽（示波器或上位机读到的值）。

### 76. 修"上电舵机转反"：上电先起在**接近角(170°)** 再平滑收到 180°

**用户确认的关键信息**：舵机是 **360°** 的；**180° 确实是收起位**（收回后停位正确）；
**收回动作是逆时针（轴上方看）**。

**根因**：数值没错（180° = 收起 ✓），错的是**上电那一下的方向**。原来上电直接给
1500 µs（= 180°）：如果上电时机构停在**伸出端（0°）**，那 0°→180° 正好是**一半行程**
（逆时针 180° 与顺时针 180° 一样远），**方向由舵机自己选** → 可能往伸出侧甩 = 用户看到的"转反了"。

**改法（servo.c）**：`Servo_TimInit()`（所有初始化路径共用）里加"接近角"：

```c
#define SERVO_R_APPROACH_ANG  (SERVO_R_START_ANG - 10.0f)   /* = 170° */

float bootAngle = c->startAngle;
if (c->approachAngle > c->minAngle && c->approachAngle < c->maxAngle)
    bootAngle = c->approachAngle;                 /* 先起在 170° */
oc.Pulse = Servo_AngleToPulse(c, bootAngle);      /* 1444 us */
... HAL_TIM_PWM_Start(...) ...
if (bootAngle != c->startAngle)
    Servo_SetAngleSmooth(id, c->startAngle, ...); /* 再平滑到 180° = 1500 us */
```

**为什么这样就一定朝收起方向转**（实算）：

```text
上电：先 170° = 1444 us，再平滑到 180° = 1500 us
从伸出端(0°)出发：到 170° 逆时针 170° < 顺时针 190°  → 必定逆时针（朝收起）✓
             （机构行程只有 0~180°，所以上电时无论停在 0~180 之间哪一点，
               到 170° 都是逆时针更近 → 方向确定）
从收起端(180°)出发：只是 10° 的小抖动，然后回到 180° ✓ 无害
伸出：0° = 500 us（从收起端出发是顺时针）✓
```

**顺带修**：`Radar_SetDeployed()` 改用新的 `Servo_IsReady()` 判断是否已初始化 ——
原来用自己的标志，上电 `Test_HwInit()` 已初始化过它还会再 init 一次（多绕一次动作）。
另外 `servo.h` 补了 `#include <stdbool.h>`（新增 `bool Servo_IsReady()` 要用）。

**验证**：全量构建 **0 错误 0 警告**；`TEST_MODE = 1 / 4 / 10` 语法检查全过；
实算脉宽如上；githooks 模拟 0 拦截。RAM 9176B、FLASH **76292B**。

**如果还不对**：把 `SERVO_R_APPROACH_ANG` 的差值从 10° 调大（如 30°，先到 150°）会更稳；
若舵机停在机构行程之外（不可能的话），则考虑 `SERVO_R_INVERT = 1` 或改行程配置。

### 77. 上电"往外伸一点点"：接近角默认**关闭**（上电已在收起位时完全不动）

**用户反馈**："上电往外伸了一点点"。

**根因**：就是第 76 节加的**接近角**。现场常态是"上电前雷达已经收着"（每次跑完都会收回），
此时先给 **170°（1444 µs）** 会让它**外摆 10°** 再回到 180° —— 那"一点点"就是这 10°。

**改动**（`HARDWARE/Src/servo.c`）：接近角默认关掉

```c
#define SERVO_R_APPROACH_ENABLE  0     /* 0 = 上电直接起在收起角（已在收起位就完全不动） */
#define SERVO_R_APPROACH_ANG     (SERVO_R_APPROACH_ENABLE ? (SERVO_R_START_ANG - 5.0f) : 0.0f)
```

`Servo_TimInit()` 里原本就判断 `approachAngle` 是否在有效范围，置 0 后自动跳过 →
**上电直接给 180° = 1500 µs**；若雷达已经在收起位，舵机**一点都不动**，只是上电锁住（有保持力）。

**代价（说清楚）**：只有当**上电前雷达不在收起位**时，0°↔180° 这一跳才会出现"方向 50/50"
（舵机自选方向）。那种情况把 `SERVO_R_APPROACH_ENABLE` 置 **1** 就能让方向确定
（接近角 = 收起角 − 5°，外摆更小）。
注意：**运行中的伸出/收回方向一直是确定的** —— `Servo_SetAngleSmooth()` 按 1.5°/步走，
舵机只能跟着命令路径走，不存在"选方向"问题；有方向不确定性的**只有上电那一次单跳**。

**验证**：全量构建 **0 错误 0 警告**；实算上电起 PWM = 180° = **1500 µs**
（已在收起位 → 完全不动 ✓）。RAM 9176B、FLASH 76292B。

**若上电仍然在动**：那就不是舵机命令的问题（命令没变、也没超过容差），
多半是**机构自重/回弹**——舵机没通电/刚上电时没有保持力。可以：
① 保持 `SERVO_R_INIT_AT_BOOT = 1`（上电就上电锁住，最快）；
② 若锁住后仍下垂，说明该位置机械上不自锁，需要改机构或换更大扭矩舵机。

### 78. 雷达收起角 180° → **300°**

**用户要求**："把收起时舵机角度改为 300°"。

**改动**（只改收起角，伸出角仍是 0°）：

| 位置 | 原值 | 现值 |
|---|---|---|
| `radar_config.h` → `RADAR_SERVO_IN_DEG`（收起角） | `180.0f` | **`300.0f`** |
| `servo.c` → `SERVO_R_START_ANG`（上电初值 = 收起位） | `180.0f` | **`300.0f`** |
| `SERVO_R_MAX_ANG`（舵机量程） | `360.0f` | 不变 |
| `RADAR_SERVO_OUT_DEG`（伸出角） | `0.0f` | 不变 |
| `SERVO_R_APPROACH_ENABLE`（上电接近角） | `0` | 不变（上电直接给 300° 对应脉宽） |

同步改了 7 个文件里"180° = 收入/收起""上电初值 180°"的注释（历史沿革写成
`360°→180°(保险)→300°(确认)`）。

**实算**：

```text
伸出 0°   ->  500 us
收起 300° -> 2167 us      (= 上电初值：已在收起位就完全不动 ✓)
单程 300° -> 200 步 × 2ms = 400ms + 到位裕量 500ms ≈ 0.9s
```

**构建**：`--clean-first` 全量 **0 错误 0 警告**；RAM 9176B、FLASH 76292B（只改数值/注释，占用不变）。

> ⚠⚠ **要确认的一件事（方向/路线）**：`Servo_SetAngleSmooth()` 是按角度**递增**分步的，
> 所以从 0° 到 300° 会**扫过 90°/180°/270°，走 300° 的长边**。
> - 如果机构本来就是从伸出端**继续逆时针转 300°** 才收到位 → 现在就是对的 ✓
> - 如果机构实际是**反向（顺时针）只转 60°**（300° ≡ −60°）就到收起位 →
>   现在的分步会走反方向扫 300°、**可能撞限位**，需要给平滑函数加"最短路径"选项
>   （按 360−300=60° 逆着走）。这个只能看机构实动才能定，已请用户确认。

### 79. 修三处逻辑问题：`AGV_Turn()` 方向类型、`Cruise` 的 tarDir、转弯目标角归一化

用户从上一轮代码审查里指定要修 **P0.1 / P1.4 / P1.9**。

#### ① P0.1 `AGV_Turn()`：`uint8_t turnDir` → **`int8_t`**（`yawPIDcontroller.c`）

```c
int8_t turnDir = (int8_t)(dir - AGV_Direction);   /* 原为 uint8_t */
if(turnDir == 3)turnDir = -1;        /* 3 ≡ -1(右转90°) */
else if (turnDir == -3)turnDir = 1;  /* -3 ≡ +1(左转90°) */
```

原来的 `uint8_t` 把负数截断：−1/−2/−3 → 255/254/253，后面 `== -1 / -2 / -3` 的判断
**永远不成立**。用主机 gcc 模拟 12 种场景：

| | 修正前 | 修正后 |
|---|---|---|
| 该转却没转 | **7 处** | **0 处** |
| 具体丢的 | 全部右转(4)、跨 0/3 的 90°(1)、部分 180°(2) | — |

#### ② P1.4 `AGV_Position_Cruise()`：`tarDir` 归一化 + X 轴朝向选择修正（`chassis.c`）

```c
void AGV_Position_Cruise(uint8_t RouteID, uint8_t tarDir)
{
    tarDir &= 3U;    /* ① 归一化：4 当 0，避免非法方向值一路传到 AGV_Turn() */
    ...
    if(AGV_Direction == 1 || AGV_Direction == 3)   /* 车头朝 ±Y，要改走 X */
    {
        /* ② 原写法 abs(tarDir-2) >= abs(tarDir-4) + AGV_Turn(4)：
              tarDir=0(要朝X+) 时条件为假 → 选成 X-(反着走)；且 4 不是合法方向 */
        if(abs((int)tarDir - 2) >= abs((int)tarDir - 0))AGV_Turn(0);
        else AGV_Turn(2);
    }
    ...
}
```

（用户上一轮已自行把 `4→0`、`tarDir-4→tarDir-0` 改过来了；本次补上 `tarDir &= 3U` 归一化和注释。
Y 轴那条分支原本就是对的，只补注释、逻辑不动。）

修正后选择表（车头朝 ±Y 时）：`tarDir=0→X+`、`1→X+`、`2→X−`、`3→X−`；`tarDir=4→(4&3=0)→X+`。

#### ③ P1.9 转弯目标角**双向**归一化（`yawPIDcontroller.c`）

```c
/* 新增：把任意角度归一到 (-180, 180] */
static float Yaw_Normalize180(float angle)
{
    while(angle > 180.0f)   angle -= 360.0f;
    while(angle <= -180.0f) angle += 360.0f;
    return angle;
}
```
用于 `AGV_TurnLeft/TurnRight/AGV_TurnBack` 的 `target`，并在 `AGV_SetYaw()` 入口也归一化一次。
原来只做**单向** `if`（Left/Back 只补 >180、TurnRight 只补 <−180），另一侧漏掉时
`target` 超出量程 → yawPID 按数值差算误差 → 车会朝**长边**转（看起来像转反/多转）。

实算：`200°→−160°`、`−200°→160°`、`370°→10°`、`−370°→−10°`、`180°→180°`、`−180°→180°` ✓

#### 验证

- `yawPIDcontroller.c` 单独 `-Wall -Wextra` 语法检查：**exit 0，0 警告**。
- `chassis.c` 编译：只剩 **6 处"缺第二个参数"的既有错误**（`AGV_Position_Cruise(0)` 等调用点），
  **没有本次改动引入的新错误**。
- 主机 gcc 模拟三项逻辑，结果如上表。

#### ⚠ 仍未解决（本次按用户指定范围只改了三项）

1. **工程现在仍编译不过**：`chassis.c` 里 6 处 `AGV_Position_Cruise(0/1/2/3/4/5)` 缺第 2 个参数。
   最省事的适配（不改语义）：传当前朝向 → `AGV_Position_Cruise(RouteID, AGV_Direction)`，
   这样末尾 `AGV_Turn(tarDir)` 等于不转，调用方现有的手动 `AGV_TurnLeft/Right` 继续生效。
2. P0.2 `count/status/越界` 检查、P0.3 `Points_X/Y` 缺 16 格、P1.5 `priDir` 写死、
   P1.6 cruise 末尾转身与调用方手动转重复、P1.7 `AGV_Turn` 参数校验、
   P1.8 转弯无超时（HWT101 掉线会永久卡在 `AGV_SetYaw` 的 while 里）。

### 80. 雷达收起角 300° → **340°**

**用户要求**："把雷达收回舵机角度改为 340°"。

| 位置 | 原值 | 现值 |
|---|---|---|
| `radar_config.h` → `RADAR_SERVO_IN_DEG` | `300.0f` | **`340.0f`** |
| `servo.c` → `SERVO_R_START_ANG`（上电初值 = 收起位） | `300.0f` | **`340.0f`** |
| 伸出角 / 量程 / 接近角开关 | — | 不变（0° / 360° / 关） |

**实算**：

```text
伸出 0°   ->  500 us
收起 340° -> 2389 us     (= 上电初值；已在收起位则完全不动 ✓)
单程 340° -> 227 步 × 2ms = 454ms + 到位裕量 500ms ≈ 0.95s
```

> ⚠ **340° 对应 2389us，离舵机量程端点 2500us 只剩 111us（≈20°）** —— 机械限位/堵转风险
> 比 300° 更高。若现场听到堵转声/发烫，说明该位置顶到限位了，应把角度往回收几度。

同步改了 7 个文件中"300°=收起/收入"的注释（沿革写成 `360°→180°(保险)→300°→340°(确认)`）。

**构建**：0 error（4 个 warning 是 `test.c` 里用户改 `Test_Switch` 后留下的
"声明了没定义/定义了没用"：`Test_Pick_Scale`/`Test_Func`/`Test_OLED`/`Test_HwInit`）。

### 81. 跑图逻辑复查（改完 P0.1/P1.4/P1.9 之后）

用户要求"再次检查跑图逻辑"。当前状态：`AGV_Position_Cruise` 的 6 处调用已补上
`tarDir`（`3,0,2,1,0,3`），调用方原来那些 `AGV_TurnLeft/Right` 已注释掉，
编译 **0 error**。用主机仿真按"当前 Points 表 + 6 段预期拐点"跑了一遍整条路线：

#### ✅ 已没问题的
- 编译通过；`AGV_Turn` 12 种场景 0 处漏转；`tarDir` 归一化生效；无重复转弯。

#### ❌ P0-1：第 5 段→第 6 段**不连续**（跑图最大问题）
第 5 段（22→14）结束时车在格 14 `(1200,300)`，而第 6 段是按**从 22 出发**规划的，
它的第一个拐点是格 20 `(2090,2150)`。仿真出的第一个动作：

```text
段6 第一动作: 从 (1200,300) 到 (2090,2150)  dx=+890 dy=+1850   ← 2055mm 斜穿，雷达没规划过
```

即车会从 14 直接斜向穿过场地到 22 一侧，**可能撞障碍**。这是第 69 节那条"L6 从 22 出发"
在**行驶**上的直接后果。解决只有三条路：
① 补一段 `14→22` 的规划+行驶（变 7 段）；② 把 L5 改成 `14→22`、L6 保持 `22→起点`；
③ L6 改回"从 14 出发"。

#### ❌ P0-2：`count == 0` / `status != 0` 没判 → 静默跳过整段
雷达没连上或某段规划失败时 `Radar_Path[i].count == 0` → for 循环不执行 → 车不动，
接着**直接开向下一段的拐点**（那条路径没规划过）。仿真已确认这个行为。

#### ❌ P0-3：`Points_X/Y[]` 只有 9 格，绕障时可能开到 (0,0)
初始化只有 `{0,2,4,10,12,14,20,22,24}`。无障碍时 6 段的拐点都落在这 9 格里（因为
起终点都在偶数格上，拐点必为偶数行×偶数列）✓；但**一旦有障碍、A* 绕行经过奇数格**
（如 19/13/23/15），`Points_X[19]==0` → 目标变成 **(0,0)**，车直接开到场外原点。

#### ⚠ 效率大问题：轴朝向用 `tarDir` 猜符号 → **62% 路程在倒车**
`if(abs(tarDir-2) >= abs(tarDir-0)) AGV_Turn(0)` 这类判断用 `tarDir` 猜"该朝哪边"，
但代码手里已经有 `dx/dy` 的符号，却没直接用 → `tarDir` 这组值与实际走向对不上时就倒着开。
仿真统计（10 次移动、含 Depart 去格0 与 GoBack 末尾那一下）：

| 方案 | 90°转 | 前进 | **倒车** | 横移 |
|---|---:|---:|---:|---:|
| A 现在这组 tarDir | 8 | 6480mm | **7330mm (6次)** | 1630mm |
| B 段尾=本段最后移动方向 | 7 | 6520 | 5540 (4) | 3380 |
| C 段尾不转 | 7 | 5620 | 6440 (5) | 3380 |
| **D 轴朝向按 dx/dy 符号 + 段尾自动** | 7 | 12060 | **0** | 3380 |

**D 的做法（推荐）**：
```c
/* 车头朝 ±Y、本段要改走 X：直接按 dx 符号朝 X+/X-（永远朝行进方向，不倒车） */
if(AGV_Direction == 1 || AGV_Direction == 3) AGV_Turn(dx >= 0 ? 0 : 2);
/* 车头朝 ±X、本段要改走 Y：按 dy 符号 */
if(AGV_Direction == 0 || AGV_Direction == 2) AGV_Turn(dy >= 0 ? 1 : 3);
/* 段尾不再要调用方给 tarDir：直接转向"本段最后一次移动的方向" */
```
这样 `tarDir` 参数可以彻底去掉（调用点改回 1 个参数）。

#### ⚠ 其它确认项
1. `AGV_Position_Init()` 写死起点 `(150,2250)`，只对**区2**成立；区1 出发点格 4 是
   `(360,300)` → 换区1 时全错。`AGV_Position_Depart()` 里先 `Go(Points_X[0], Points_Y[0])`
   能纠到格0，但区1 仍错（应该用 `Radar_GetStartGrid()` 取起点格）。
2. `AGV_Direction` 初值 = 3（Y−）：只有车头确实朝 Y− 时才成立；区1 起步方向不同就全歪。
3. `AGV_Position_GoBack()` 最后 `AGV_Position_Go(150, 150, 0)` —— 是笔误还是车要停到
   左下角？原来的起点是 `(150,2250)`、`Destination` 是 `(165,2285)`，都跟 `(150,150)` 差很远。
4. `AGV_Position_Go()` 对**0 距离的那个轴也会发一条位置命令**（轴对齐的移动每段都有 1 个 0），
   `Emm_V5_WaitArrive` 超时 **5000ms** 才会返回（正常到位帧不会来）→ 每段可能白等 5s。
   建议在 Go 里加 `if(dx) {...}` / `if(dy) {...}`。
5. `AGV_Position_Go()` 超时后仍 `AGV_Position_Set(x,y)` 锚定目标 → 一旦某次没走到位，
   后面全是错的；建议把 `Emm_V5_WaitArrive` 的返回值纳入判断（停车/重试）。

#### 结论
本次复查后**没有改动任何跑图代码**（用户只要求检查）。要修的话优先级：
**P0-1 段5/6 不连续 → P0-2 空段保护 → P0-3 坐标表补全 → 轴朝向按符号（消除倒车）→ 其它**。

---

## 2026-10-19 —— 机械臂两轴改绝对位置 + 新增模式 11 放置测试

> 本节所有改动 **未编译、未上实车**（本机没有 build 目录，硬件也不在手上）。
> 上电前务必保持老习惯：**高度(5)/半径(6)两轴先人工放在 0 位**。

### 82. 问题定位：`Pick_JumpTo` 为什么总卡在 Z 轴等回帧

现象：`Pick_JumpTo` 经常卡在 `Pick_MotorZ_MoveToMM` → `Pick_StepperMove` 的等到位，
大概率发生在"先升到安全高度"这一步；底盘四个步进同样协议却从不卡。

根因（叠加）：

1. **没有真实零点，误差会累积**：相对位置模式下每次"走多少"都按 MCU 自己的
   计数推算，而旧代码**发完命令就先把计数加上去**。一旦某次没走到
   （驱动器拒收/堵转/丢帧），MCU 以为到了、机械没到，下一趟继续按错的基准算，
   误差越滚越大，最后走到行程尽头顶住限位 → 驱动器堵转保护锁死 → 之后每次
   都回 `0xFD 0xE2`（条件不满足），永远等不到 `0xFD 0x9F`。
2. **锁死的堵转保护没人清**：`0xE2` 一旦锁存，不断电/不发 `0x0E` 就不会自己恢复，
   旧代码失败后既不解除也不重试，直接超时返回，看着就是"卡住"。
3. **安全高度正好在行程末端**：`PICK_SAFE_HEIGHT_MM` 是每次动作最先走的一段，
   误差累积到那里最容易顶限位，所以"总卡在安全高度"。
4. 底盘不卡是因为每段移动都**按目标重新算脉冲**、且任何一轮车轮回帧都满足等待，
   不存在"按上一趟的错基准继续加"的问题。

### 83. 两轴改为绝对位置（raF=1），删除相对位置实现

按用户要求，**函数名不变**，直接把绝对位置版本作为唯一的
`Pick_JumpTo` / `Pick_MoveTo`：

- `Pick_StepperIssue()`：统一发
  `Emm_V5_Pos_Control(addr, 0, vel, acc, target, 1, 0)`（raF=1）；
  绝对模式下方向由"目标 vs 当前位置"决定，`dir` 参数无关。
- `Pick_StepperMove()`：绝对目标 + 等到位；失败先 `0x0E` 解堵转 +
  重新使能，再**降速重试一次**（新宏 `PICK_MOTOR_*_RETRY_VEL/ACC`）。
- `Pick_MotorZ_MoveToMM()`：高度轴，绝对目标并等到位（地址 5 会回 `0x9F`）。
  失败后读回 `S_CPOS` **只用于诊断**；下一次绝对目标不依赖这次走了多少。
- `Pick_MotorR_MoveToMM_Issue()`：半径轴，**只发绝对目标、不等回执**
  （地址 6 硬件上不回到位帧，等就会每次白等超时）。
- `Pick_Traj_Move()` 去掉了 `absolute` 参数，两轴一律绝对位置；
  安全高度那一步失败时**中止本次动作**，不在未知高度继续转向/走半径。
- **删除**：相对模式的 `Pick_StepperMove_Issue()`、相对版
  `Pick_MotorZ_MoveToMM()`、相对版半径 Issue/阻塞版本、`PICK_POS_MODE`。
- 绝对目标天然幂等：丢一帧/超时一次只影响这一次，不会把后续"该走多少"算错。

### 84. 上电零点：人工 0 位（默认）/ 碰撞回零（可选）

`Pick_Axis_Init()` 在 `AGV_Can_Init()` 之后调用（`UserCode/Src/task.c`）：

```c
Emm_V5_En_Control(...);        /* 两轴重新使能 */
Emm_V5_Reset_Clog_Pro(...);    /* 两轴清堵转保护 */
#if PICK_AXIS_AUTO_HOME
    /* 0x4C 写参数 + 0x9A 模式2 = 多圈无限位碰撞回零，机械限位即 0mm */
#else
    Emm_V5_Reset_CurPos_To_Zero(...);   /* 0x0A：把人工 0 位写成绝对零点 */
#endif
```

- 默认 `PICK_AXIS_AUTO_HOME = 0`，沿用用户的操作习惯：**上电前两轴人工放 0 位**，
  发 `0x0A` 把该物理位置写成 0mm。每次 MCU 重启都会重新锚定，所以每次都要放回同一位置。
- 置 `1` 则改为参考开源工程的做法：`0x9A` 模式 2 多圈无限位碰撞回零。
  回零方向**由位置命令方向反推**，不是手填：
  `PICK_HOME_Z_DIR = 1 - PICK_MOTOR_Z_POS_DIR`（同理 R 轴）——即从大于 0 的一侧
  朝 0/机械限位走。填反会朝行程另一端顶。
- **回帧限制（硬件事实）**：只有底盘 `0x04` 和高度电机(5) 回 `0xFD 0x9F`；
  半径电机(6) 不回到位帧。所以半径轴任何设计都**不能加阻塞等到位**。

### 85. 全工程调用点统一（不再有 `_PLUS` 命名）

`Pick_JumpTo_PLUS` / `Pick_MoveTo_PLUS` 及 `Pick_Test_MotorZ_PLUS` /
`Pick_Test_MotorR_PLUS` **已全部删除**，调用点改回普通名字：

| 文件 | 内容 |
| --- | --- |
| `Core/Src/main.c` | `Pick_JumpTo POS_DEFAULT` |
| `UserCode/Src/task.c` | `Depart` 的 `POS_RUN`、`IDLE` 的 `POS_START` |
| `UserCode/Src/pick_task.c` | 所有 `Pick_JumpTo POS_*` / `Pick_MoveTo POS_*` |
| `UserCode/Inc/pick_task.h` | `MOVE_TO_RING` / `MOVE_TO_RING_HIGH` / `GRAB_AND_PLACE_TO_RING_SLOT` / `..._EX` / `GRAB_FROM_RING_AND_PLACE_SLOT` 五个宏 |
| `UserCode/Src/test.c` | 模式 4/5/11 及测试辅助函数 |
| `HARDWARE/Inc/pick.h` | 删除 PLUS 声明，说明并入两个基本动作的注释 |

测试入口合并：`Pick_Test_MotorZ()` 走绝对位置；`Pick_Test_MotorR()` 走
"绝对目标、只发不等"；`_PLUS` 两个重复测试删除。

### 86. 新增测试模式 11：`Test_Place_Ring`

用户指定的最简放置链路：**只验 `POS_CAR → POS_1/2/3`**，不扫码、不碰相机、
不做视觉修正；转盘固定在 A 槽，三次都从同一个 `POS_CAR` 取料。

```c
Pick_Init();
Pick_Gripper_Release();
for (ring = 1; ring <= 3; ring++) {
    Pick_JumpTo POS_CAR;
    Pick_Gripper_Grab();   HAL_Delay(300);
    Pick_JumpTo POS_1 / POS_2 / POS_3;   /* 按 ring 选 */
    Pick_Gripper_Release(); HAL_Delay(300);
}
Pick_JumpTo POS_RUN;
```

改动位置：

- `UserCode/Src/test.c`：新增 `Test_Place_Ring()` 实现 + 前置声明 +
  `Test_Switch()` 里 `case 11:`；模式选择暂时改成 `switch(11)`。
- `UserCode/Inc/test.h`：模式表补第 11 条说明。

**上机验证顺序建议**：

1. 两轴人工放 0 位 → 上电 → 确认 `Pick_Axis_Init()` 跑过；
2. 模式 9 先用 `Pick_Test_MotorZ()` 确认高度轴绝对 0↔30mm 能走、方向对；
3. 模式 11 跑一遍，观察每次 `POS_CAR` 是否都回到同一取料高度（绝对模式的核心收益）；
4. 若高度轴某次仍超时：看 `Pick_Diag_LastStatus`
   （2=`0xE2` 拒收，0=超时，3=读不回），并检查上电时是否不在 0 位
   导致绝对坐标整体偏移。

---

## 2026-11-01 —— 启动菜单简化为「单页选启停区」，每区一套小车初始位姿

> 本节承接当前文件末尾的 §86。文件里 2026-10-19 之后的内容（含漂移函数那几节）
> 在 2026-11-01 13:29 的工作区回滚中已不在；若从备份恢复，请重新编号。

### 87. 原来的两个毛病

1. **菜单第 1 页的"路线 `Route_id`"按了等于没按**：全工程只有 `menu.c` 在改它、
   `task.c` 定义了它，没有任何消费者 —— `AGV_Position_Depart()` / `AGV_Position_GoBack()`
   早就是按雷达规划的 `Cruise(leg)` 走的。
2. **选启停区只换了一半**：`Radar_SetZone()` 只换雷达那套（选区请求 + 位姿 + 出发点方格），
   而小车自己的初始坐标在 `AGV_Position_Init()` 里写死 `(150, 2250)`、`GoBack()`
   末点也写死 `(150, 2250)` —— 选 1 区照样按 2 区的起点算坐标。
   更要命的是 `AGV_Init()` 在 `Menu_Init()` **之后**又调了一次 `Radar_Init()`，
   它末尾固定 `Radar_SetZone(RADAR_ZONE_DEFAULT=2)`，把菜单里选的区**直接冲掉**。

### 88. 改法

| 文件 | 改动 |
|---|---|
| `UserCode/Src/menu.c`、`Inc/menu.h` | 删掉阶段 1（Route_id 页），只剩**一页**：C6 切启停区、A8 确认启动。屏上 4 行：标题 / `zone: n  cam OK\|ERR` / `X.. Y..` / 按键提示。`RADAR_MENU_PICK_ZONE` 宏删除（单页之后没有"退回旧行为"的意义）。 |
| `UserCode/Inc/chassis.h` | 新增 `AGV_ZONEn_ORIGIN_X/Y/DIR` + `AGV_ZONEn_DEPART_GRID`；`extern AGV_Position_X/Y`；声明 `AGV_Position_ApplyZone()`。 |
| `UserCode/Src/chassis.c` | 新增 `AGV_Position_ApplyZone(zone)`（装坐标 + 朝向 + `static AGV_Zone`）；`AGV_Position_Init()` 改调它（用 `RADAR_ZONE_DEFAULT`）；`Depart()` 首点按区取（区1 `Points[4]`、区2 `Points[0]`）；`GoBack()` 末点从写死 `(150,2250)` 改成按区取本区停车点。 |
| `UserCode/Src/task.c` | `AGV_Init()`：先存下菜单选的区 → `Radar_Init()` → `Radar_SetZone(zone)` 装回 → `AGV_Position_ApplyZone(最终区)`。 |
| `Radar/Inc/radar_task.h`、`radar_config.h` | 注释里"菜单阶段 2"改成"菜单里"。 |
| `流程设计书.md` | §1.1 / §1.2 / §1.4 / §2.1 / §2.5 + 状态表 + 文件表同步。 |

两区参数（`chassis.h`）：

| 启停区 | 停车坐标 | 车头 | 出发点格 |
|---|---|---|---|
| 1 | (150, 150) | Y-（3） | `Points[4]` = (310, 310) |
| 2（上电默认） | (150, 2250) | Y-（3） | `Points[0]` = (310, 2090) |

### 89. 编译验证

0 error；本次改到的四个文件 0 warning（`test.c` 那几条 unused-function 是原有的）。
FLASH **78052 B（14.89%）**、RAM **9296 B（7.09%）**。
⚠ 这个数字里还含着工作区未提交的 `chassis.c` 坐标改动（310/2090 那套），不是本次单独的量。

### 90. 装机时要确认

1. **区1 朝 Y-**：按用户 2026-11-01 给的值。若实际车头朝 Y+，只改 `chassis.h` 的
   `AGV_ZONE1_ORIGIN_DIR` 一个数。
2. `AGV_ZONEn_DEPART_GRID` 必须和 `radar_config.h` 的 `RADAR_ZONEn_START_GRID`
   指同一格（当前 1 区=4、2 区=0）—— 前者决定"先开到哪格"，后者决定"规划从哪格出发"。
   `RADAR_ZONE1_START_GRID` 目前仍标着「待填」。
3. **遗留未改**：菜单期间按 C8 仍会把 `s_paused` 翻成 1（TIM7 里扫 C8 不看 `s_suspended`），
   菜单退出后第一次 `Dbg_Service()` 就停车并卡在暂停画面，要再按一次 C8 才动。
   修法：ISR 里 `if(s_suspended) return;`，或 `Dbg_Resume()` 里清 `s_paused`。
4. `Route_id` 变量还留着（已无引用）；要清就一起删 `task.c:17` 与 `task.h:37`。

### 91. 顺带发现（未改，待确认）

`AGV_Position_Cruise()` 是 `Points_X[Radar_Path[].points[]]` —— 把雷达回来的**方格号**
直接当 `Points` 表的下标。但两套编号看起来不是一回事：

- `radar_config.h` 写的是 5×5 **蛇形**编号（`0 1 2 3 4` 在底行、`20` 在左上）；
- `chassis.c` 的 `Points` 表是按**列**填的（`0~4` 是 `X=310` 那一列，从上往下）。

按列读，区2 起点格 0 → `Points[0]` = (310, 2090) 正好是左上角停车位（与车上实际位置对得上）；
但按蛇形编号，格 0 应该是**左下角**。两套编号只有中心格 12 是一致的 —— 一旦对不上，
`Cruise` 就会开去错的格子（四个边中点会变成按旋转 90° 的顺序访问）。
要么统一成一套编号，要么加一张「雷达格号 → `Points` 下标」的映射表。

### 92. 测试流程也能选启停区（同日追加）

测试模式不走 `AGV_Init()`，也就没有 `Menu_Init()` —— 之前**测试全程固定在区2**，
想测区1 只能改代码重烧。现在把「选启停区」下沉成两边共用的一块。

| 文件 | 改动 |
|---|---|
| `UserCode/Src/menu.c`、`Inc/menu.h` | 新增 `uint8_t Menu_SwitchZone(void)`：切到另一个区、雷达（`Radar_SetZone`）+ 小车坐标/朝向（`AGV_Position_ApplyZone`）一起装好，返回最终区号；`Radar_SetZone()` 失败就不动小车坐标。`Menu_Init()` 的 C6 分支改成调它（行为不变）。`menu.h` 补 `#include <stdint.h>`（新声明用到 `uint8_t`）。 |
| `UserCode/Src/test.c` | ① `Test_WaitStartKey()` 入口页从 3 行变 4 行：`MODE n / zone: n / press A8 / to start`，**C6 切区**（调 `Menu_SwitchZone()` 并重画）；② 按键消抖的 `RadarTestKey`/`RadarTest_KeyEdge()` 从模式 10 那段搬到文件上方共用，并补 `armed`（必须先见过松开，避免上电就按着键被当成一次按下）；③ `Test_Switch()` 在入口页之前补一次 `Radar_Init()`（不发帧），否则 `Radar_SetZone()` 没有 launch 上下文；④ `Test_AGV()` / `Test_Radar()` 都在自己 `Radar_Init()` 前把入口页选的区存下来、之后再 `Radar_SetZone()` 装回；`Test_AGV()` 另在 `AGV_Position_Init()` 之后补 `AGV_Position_ApplyZone(Radar_GetZone())`（`Init()` 里那句是按默认区摆的）。 |
| `UserCode/Inc/test.h` | 模式表前言：等待页新增 `zone: k` 行、C6 可切区。 |

编译验证：0 error；本次改到的 `menu.c` / `test.c` 无新增警告（`test.c` 那几条
unused-function 是原有的未实现测试桩）。FLASH **78396 B（14.95%**，上一版 78052）、
RAM **9296 B（7.09%）**（+344B 就是入口页这行 + `Menu_SwitchZone`）。

试的时候注意：`switch(1)` 现在是写死的模式选择，入口页上的 `MODE n` 显示的是
`TEST_MODE`（编译开关），不是 `switch(1)` 里实际跑的那个 —— 两者不一致时别被屏幕误导。

## 2026-11-07 —— Place_ROUGH 第 1、2 块换槽提前到松爪之前

### 93. 换槽与松爪的顺序

需求：`PlaceToRing()` 里"选下一个槽"这一下，第 2、3 次放置不要等下一次调用开头再做，
而是**摆到圆环位置后、松爪前**就做掉 —— 这时臂已经离开车体，转盘可以转；转盘
`Pick_TurnTable_Set()` 内部那段停稳延时正好在松爪前走完，下一块回 `POS_CAR` 时
槽位已就位。

| 文件 | 改动 |
|---|---|
| `UserCode/Src/pick_task.c` | `PlaceToRing(slot, ring)` → `PlaceToRing(slot, ring, next_slot, has_next)`：`MOVE_TO_RING(ring)` 之后、`Pick_Gripper_Release()` 之前加 `if(has_next) Pick_TurnTable_Set(next_slot);`。`Place_ROUGH()` 循环里前两块传 `has_next=1` + 下一槽，最后一块传 0（放完直接松爪）。 |
| `流程设计书.md` | §2.3 `PlaceToRing` 的步骤块同步。 |

换槽顺序仍是 0→1→2，`next_slot` 用 `(i + 1) % 3` 算；第 3 块后面没有料，行为不变。

编译验证：0 error，`pick_task.c` 0 warning。FLASH 77888 B（14.86%）、RAM 9296 B（7.09%）。
**未上实车验证** —— 重点看转盘在臂位于圆环上方（尤其 `POS_2` 半径只有 18mm）时
转动会不会蹭到臂/已放料块。
