Fawziya25/AGV_Project/电控代码/HWT101协议.md

\# 寄存器表 | ADDR<br/>(Hex) | ADDR<br/>(Dec) |  REGISTER NAME   | FUNCTION |  SERIAL <br/>I/F   | Bit15 | Bit14 | Bit13 | Bit12 | Bit11 | Bit10 | Bit9 | Bit8 | Bit7 | Bit6 | Bit5 | Bit4 | Bit3 | Bit2 | Bit1 | Bit0 | | :---: | :---: | :---: | :---: | :---: | :---: | :---: | :---: | :---: | :---: | :---: | :---: | :---: | :---: | :---: | :---: | :---: | :---: | :---: | :---: | :---: | | 00 | 00 | SAVE | 保存/重启/恢复出厂 | R/W | SAVE[15:0] | | | | | | | | | | | | | | | | | 01 | 01 | CALSE | 手动获取零偏 | R/W |  |  |  |  |  |  |  |  |  |  |  |  |  | |  | CALSE | | 03 | 03 | RRATE | 输出速率 | R/W |  |  |  |  |  |  |  |  |  |  |  |  | RRATE[3:0] | | | | | 04 | 04 | BAUD | 串口波特率 | R/W |  |  |  |  |  |  |  |  |  |  |  |  | BAUD[3:0] | | | | | 1A | 26 | IICADDR | 设备地址 | R/W |  |  |  |  |  |  |  |  | IICADDR[7:0] | | | | | | | | | 1B | 27 | LEDOFF | 关闭LED灯 | R/W |  |  |  |  |  |  |  |  |  |  |  |  |  |  |  | LEDOFF | | 27 | 39 | READADDR | 读取寄存器 | R/W |  |  |  |  |  |  |  |  | READADDR[7:0] | | | | | | | | | 2E | 46 | VERSION | 版本号 | R | VERSION[15:0] | | | | | | | | | | | | | | | | | 30 | 48 | YYMM | 年月 | R/W | MOUTH[15:8] | | | | | | | | YEAR[7:0] | | 31 | 49 | DDHH | 日时 | R/W | HOUR[15:8] | | | | | | | | DAY[7:0] | | 32 | 50 | MMSS | 分秒 | R/W | SECONDS[15:8] | | | | | | | | MINUTE[7:0] | | 33 | 51 | MS | 毫秒 | R/W | MS[15:0] | | | | | | | | | | | | | | | | | 38 | 56 | GY | 角速度Y | R | GY[15:0] | | | | | | | | | | | | | | | | | 39 | 57 | GZ | 角速度Z | R | GZ[15:0] | | | | | | | | | | | | | | | | | 3F | 63 | Yaw | 航向角 | R | Yaw[15:0] | | | | | | | | | | | | | | | | | 41 | 65 | AUTOPTP | 自动获取零偏峰峰值 | R/W | AUTOPTP[15:0] | | | | | | | | | | | | | | | | | 43 | 67 | AUTOT | 自动获取零偏时间 | R/W | AUTOT[15:0] | | | | | | | | | | | | | | | | | 44 | 68 | AUTOTH | 自动获取零偏阈值 | R/W | AUTOTH[15:0] | | | | | | | | | | | | | | | | | 48 | 72 | WORKMODE | 工作模式 | R/W |  |  |  |  |  |  |  |  |  |  |  |  |  | WORKMODE[2:0] | | | | 4A | 74 | GYROPTP | Z轴静止峰峰值 | R/W | GYROPTP[15:0] | | | | | | | | | | | | | | | | | 4B | 75 | GPTPTIME | Z轴峰峰值获取时间 | R/W | GPTPTIME[15:0] | | | | | | | | | | | | | | | | | 4C | 76 | GYROBAIS | Z轴零偏值 | R/W | GYROBAIS[15:0] | | | | | | | | | | | | | | | | | 4D | 77 | GBAISTIME | Z轴零偏获取时间 | R/W | GYROBAIS[15:0] | | | | | | | | | | | | | | | | | 4E | 78 | GSTATICTHRE | Z轴静止阈值 | R/W | GSTATICTHRE[15:0] | | | | | | | | | | | | | | | | | 4F | 79 | GSTATICTIME | Z轴稳定时间 | R/W | GSTATICTIME[15:0] | | | | | | | | | | | | | | | | | 50 | 80 | PGSCALE | Z轴标定因素P | R/W | PGSCALE[15:0] | | | | | | | | | | | | | | | | | 52 | 82 | GSCALERANGE | Z轴校准角度 | R/W | GSCALERANGE[15:0] | | | | | | | | | | | | | | | | | 61 | 97 | GYROCALITHR | 静态检测阈值 | R/W | GYROCALITHR[15:0] | | | | | | | | | | | | | | | | | 63 | 99 | GYROCALTIME | 陀螺仪自动校准时间 | R/W | GYROCALTIME[15:0] | | | | | | | | | | | | | | | | | 69 | 105 | KEY | 解锁 | R/W | KEY[15:0] | | | | | | | | | | | | | | | | | 6A | 106 | WERROR | 陀螺仪变化值 | R/W | GYROPTP[15:0] | | | | | | | | | | | | | | | | | 6E | 110 | WZTIME | 角速度连续静止时间 | R/W | WZTIME[15:0] | | | | | | | | | | | | | | | | | 6F | 111 | WZSTATIC | 角速度积分阈值 | R/W | WZSTATIC[15:0] | | | | | | | | | | | | | | | | | 76 | 118 | CALIYAW | Z轴角度归零 | R/W | CALIYAW[15:0] | | | | | | | | | | | | | | | |  # AGV机器人推荐使用流程(版本号1003X.1.8开始的参考)： | AGV机器人工作情况 |  功能 |  指令 | 备注 | | --- | --- | --- | --- | | 当AGV机器人静止后 | 静止状态标志/开始"手动获取零偏" | <font style="color:#DF2A3F;">FF AA A6 01 00</font>   开始 | 该设置不需要解锁和保存<br/>该指令必须在机器人完全静止后，也就是检测到轮速为0时，才能下发，否则会获取到运动的数据作为零偏，导致数据出错 | | 当AGV机器人运动前 | 运动状态标志/结束"手动获取零偏" | <font style="color:#DF2A3F;">FF AA A6 04 00</font>   结束 | 该设置不需要解锁和保存<br/>该指令必须在机器人运动前，也就是系统逻辑控制电机转动前，才能下发，否则会获取到运动的数据作为零偏，导致数据出错 |  关于IMU零偏获取的控制说明详情可参考[姿态IMU零偏获取控制使用说明书](https://wit-motion.yuque.com/wumwnr/docs/rzdau1e6gxlew7zk) ## 读格式 + <font style="color:rgb(24, 24, 24);">数据是按照16进制方式发送的，不是ASCII码。</font> + <font style="color:rgb(24, 24, 24);">每个数据分低字节和高字节依次传送，二者组合成一个有符号的short类型的数据。例如数据DATA1，其中</font>DATA1L<font style="color:rgb(24, 24, 24);">为低字节，</font>DATA1H<font style="color:rgb(24, 24, 24);">为高字节。转换方法如下：假设DATA1为实际的数据，</font>DATA1H<font style="color:rgb(24, 24, 24);">为其高字节部分，</font>DATA1L<font style="color:rgb(24, 24, 24);">为其低字节部分，那么：DATA1=(short)((short)</font>DATA1H<font style="color:rgb(24, 24, 24);"><<8|</font>DATA1L<font style="color:rgb(24, 24, 24);">)。这里一定要注意</font>DATA1H<font style="color:rgb(24, 24, 24);">需要先强制转换为一个有符号的short类型的数据以后再移位，并且DATA1的数据类型也是有符号的short类型，这样才能表示出负数。</font> | 协议头 | 数据内容 | 数据低8位 | 数据高8位 | 数据低8位 | 数据高8位 | 数据低8位 | 数据高8位 | 数据低8位 | 数据高8位 | SUMCRC | | :---: | :---: | :---: | :---: | :---: | :---: | :---: | :---: | :---: | :---: | :---: | | 0x55 | TYPE【1】 | DATA1L[7:0] | DATA1H[15:8] | DATA2L[7:0] | DATA2H[15:8] | DATA3L[7:0] | DATA3H[15:8] | DATA4L[7:0] | DATA4H[15:8] | SUMCRC【2】 |  【1】TYPE(数据内容): | TYPE | 备注 | | :--- | :--- | | 0x52 | 角速度 | | 0x53 | 角度 |  【2】SUMCRC(数据和校验)： SUMCRC=0x55+TYPE+DATA1L+DATA1H+DATA2L+DATA2H+DATA3L+DATA3H+DATA4L+DATA4H SUMCRC为char型，取校验和的低8位 ### 角速度输出 | 0x55 | 0x52 | 0x00 | 0x00 | RWzL | RWzH | WzL | WzH | 0x00 | 0x00 | SUM | | :---: | :---: | :---: | :---: | :---: | :---: | :---: | :---: | :---: | :---: | :---: |  | 名称 | 描述 | 备注 | | :---: | :---: | :---: | | 0x00 | 无意义 |  | | 0x00 | 无意义 | | | RWzL | 原始角速度Z低8位 | <font style="color:rgb(24, 24, 24);">原始角速度Z=((RWzH<<8)|RWzL)/32768*2000°/s【1】</font> | | RWzH | 原始角速度Z高8位 | | | WzL | 角速度Z低8位 | <font style="color:rgb(24, 24, 24);">角速度Z=((WzH<<8)|WzL)/32768*2000°/s【2】</font> | | WzH | 角速度Z高8位 | | | 0x00 | 无意义 |  | | 0x00 | 无意义 | | | SUM | 校验和 | <font style="color:rgb(24, 24, 24);">SUM=0x55+0x52+</font>RWzL<font style="color:rgb(24, 24, 24);">+</font>RWzH<font style="color:rgb(24, 24, 24);">+WzL+WzH</font> |  【1】角速度Y的原始数据 【2】角速度Z的原始数据经过校准后得到的角速度Z ### 角度输出 | 0x55 | 0x53 | 0x00 | 0x00 | 0x00 | 0x00 | YawL | YawH | VL | VH | SUM | | :---: | :---: | :---: | :---: | :---: | :---: | :---: | :---: | :---: | :---: | :---: |  | 名称 | 描述 | 备注 | | :---: | :---: | :---: | | 0x00 | 无意义 |  | | 0x00 | 无意义 | | | 0x00 | 无意义 |  | | 0x00 | 无意义 | | | YawL | <font style="color:rgb(24, 24, 24);">偏航角</font>Z低8位 | <font style="color:rgb(24, 24, 24);">偏航角</font>Z<font style="color:rgb(24, 24, 24);">=((YawH<<8)|YawL)/32768*180(°)</font> | | YawH | <font style="color:rgb(24, 24, 24);">偏航角</font>Z高8位 | | | VL | 版本号低8位 | 版本号<font style="color:rgb(24, 24, 24);">计算公式：</font>版本号<font style="color:rgb(24, 24, 24);">=(</font>VH<font style="color:rgb(24, 24, 24);"><<8)|</font>VL | | VH | 版本号高8位 | | | SUM | 校验和 | <font style="color:rgb(24, 24, 24);">SUM=0x55+0x53+YawH+YawL+VL+VH</font> |  ## 写格式 | 协议头 | 协议头 | 寄存器 | 数据低8位 | 数据高8位 | | :---: | :---: | :---: | :---: | :---: | | 0xFF | 0xAA | ADDR | DATAL[7:0] | DATAH[15:8] |  + 以下数据，全部使用Hex码16进制 + <font style="color:rgb(24, 24, 24);">每个数据分低字节和高字节依次传送，二者组合成一个有符号的short类型的数据。例如数据DATA，其中</font>DATAL<font style="color:rgb(24, 24, 24);">为低字节，</font>DATAH<font style="color:rgb(24, 24, 24);">为高字节。转换方法如下：假设DATA为实际的数据，</font>DATAH<font style="color:rgb(24, 24, 24);">为其高字节部分，</font>DATAL<font style="color:rgb(24, 24, 24);">为其低字节部分，那么：DATA=(short)((short)</font>DATAH<font style="color:rgb(24, 24, 24);"><<8|</font>DATAL<font style="color:rgb(24, 24, 24);">)。这里一定要注意</font>DATAH<font style="color:rgb(24, 24, 24);">需要先强制转换为一个有符号的short类型的数据以后再移位，并且DATA的数据类型也是有符号的short类型，这样才能表示出负数。</font> **<font style="color:#DF2A3F;">注意</font>**<font style="color:#DF2A3F;">：</font> + <font style="color:rgb(24, 24, 24);">所有的设置，都需要先操作解锁寄存器(KEY) FF AA 69 88 B5  </font> + <font style="color:rgb(24, 24, 24);">所有的设置配置后都要保存（KEY）FF AA 00 00 00</font> + <font style="color:rgb(24, 24, 24);">所有的设置指令执行后要做延时处理</font> <font style="color:rgb(24, 24, 24);"></font> ### <font style="color:rgb(24, 24, 24);">CALIYAW（Z轴角度归零）</font> | 寄存器名称: <font style="color:rgb(24, 24, 24);">CALIYAW</font><br/>寄存器地址: 118(0x76)<br/>读写方向: R/W | | | | :--- | --- | --- | | Bit |  NAME   |  FUNCTION   | | <font style="color:rgb(24, 24, 24);">15:0</font> | <font style="color:rgb(24, 24, 24);">CALIYAW[15:0]</font> | 设置Z轴归零： <br/><font style="color:rgb(24, 24, 24);">0(0x00):Z轴归零</font> | | 示例：<br/>解锁：FF AA 69 88 B5<br/>延时200ms<br/>Z角度归零：FF AA 76 00 00<br/>延时500ms<br/>保存：FF AA 00 00 00<br/><br/>如果要给Z轴设置角度<br/>比如要设置10°，就10*32768/180=1820，1820转十六进制--071C<br/>解锁：FF AA 69 88 B5<br/>延时200MS<br/>设置Z轴角度为10°：FF AA 76 1C 07<br/>延时200MS<br/>FF AA 00 00 00 | | |  <font style="color:rgb(24, 24, 24);"></font> ### <font style="color:rgb(24, 24, 24);">CALIYAW（自动获取零偏）</font> | 寄存器名称: <font style="color:rgb(24, 24, 24);">CALI</font><br/>寄存器地址: 72(0x48)<br/>读写方向: R/W | | | | :--- | --- | --- | | Bit |  NAME   |  FUNCTION   | | <font style="color:rgb(24, 24, 24);">15:0</font> | <font style="color:rgb(24, 24, 24);">CALIYAW[15:0]</font> | 设置自动获取零偏： <br/><font style="color:rgb(24, 24, 24);">0(0x01):自动零偏获取</font> | | 示例：<br/>解锁：FF AA 69 88 B5<br/>延时200ms<br/>Z角度归零：FF AA 48 01 00<br/>延时500ms<br/>保存：FF AA 00 00 00<br/>延时20s<br/>读取48寄存器状态：FF AA 27 48 00<br/>返回数据状态：55 5F 00 00 00 00 AD 01 0A 00 6C （返回55 5F 00表示校准成功，后面几位字节是不固定，不用管） | | |   <font style="color:rgb(24, 24, 24);"></font> ### <font style="color:rgb(24, 24, 24);">KEY（解锁）</font> | 寄存器名称: <font style="color:rgb(24, 24, 24);">KEY</font><br/>寄存器地址: 105 (0x69)<br/>读写方向: R/W<br/>默认值: 0x0000 | | | | :--- | --- | --- | | Bit |  NAME   |  FUNCTION   | | <font style="color:rgb(24, 24, 24);">15:0</font> | <font style="color:rgb(24, 24, 24);">KEY[15:0]</font> | <font style="color:rgb(24, 24, 24);">解锁寄存器：进行写操作时，需要先设置该寄存器</font> | | 示例：解锁，往该寄存器写0xB588（其他值无效）<br/>FF AA 69 88 B5 | | |  ### SAVE（保存/重启/恢复出厂） | 寄存器名称: SAVE<br/>寄存器地址: 0 (0x00)<br/>读写方向: R/W<br/>默认值: 0x0000  | | | | :--- | --- | --- | | Bit |  NAME   |  FUNCTION   | | 15:0 | SAVE[15:0] | 保存: 0x0000<br/>重启: 0x00FF<br/>恢复出厂: 0x0001 | | 示例：FF AA 00 FF 00（重启） | | |  ###   ### RRATE（输出速率） | 寄存器名称: RRATE<br/>寄存器地址: 3 (0x03)<br/>读写方向: R/W<br/>默认值: 0x0006  | | | | :--- | --- | --- | | Bit |  NAME   |  FUNCTION   | | 15:4 |  |  | | 3:0 | RRATE[3:0] | 设置输出速率：<br/>0001(0x01): 0.2Hz<br/>0010(0x02): 0.5Hz<br/>0011(0x03): 1Hz<br/>0100(0x04): 2Hz<br/>0101(0x05): 5Hz<br/>0110(0x06): 10Hz<br/>0111(0x07): 20Hz<br/>1000(0x08): 50Hz<br/>1001(0x09): 100Hz<br/>1011(0x0B): 200Hz<br/>1011(0x0C): 500Hz<br/>1101(0x0D):1000HZ | | 示例：FF AA 03 03 00（设置1Hz输出） | | |  ### BAUD（串口波特率） | 寄存器名称: BAUD<br/>寄存器地址: 4 (0x04)<br/>读写方向: R/W<br/>默认值: 0x0002  | | | | :--- | --- | --- | | Bit |  NAME   |  FUNCTION   | | 15:4 |  |  | | 3:0 | BAUD[3:0] | 设置串口波特率： <br/>0001(0x01): 4800bps<br/>0010(0x02): 9600bps<br/>0011(0x03): 19200bps<br/>0100(0x04): 38400bps<br/>0101(0x05): 57600bps<br/>0110(0x06): 115200bps<br/>0111(0x07): 230400bps | | 示例：设置波特率为230400，下发指令步骤必须解锁后10s内完成，否则写入和保存不会生效<br/>解锁：FF AA 69 88 B5<br/>延时200ms<br/>设置波特率：FF AA 04 07 00<br/>延时100ms<br/>修改波特率为230400<br/>保存：FF AA 00 00 00 | | |  ### IICADDR（设备地址） | 寄存器名称: IICADDR<br/>寄存器地址: 26 (0x1A)<br/>读写方向: R/W<br/>默认值: 0x0050  | | | | :--- | --- | --- | | Bit |  NAME   |  FUNCTION   | | 15:8 |  |  | | 7:0 | IICADDR[7:0] | <font style="color:rgb(24, 24, 24);">设置设备地址，用于I2C使用</font><br/><font style="color:rgb(24, 24, 24);">0x01~0x7F</font> | | 示例：FF AA 1A 02 00（设置设备地址为0x02） | | |  ### LEDOFF（关闭LED灯） | 寄存器名称: LEDOFF<br/>寄存器地址: 27 (0x1B)<br/>读写方向: R/W<br/>默认值: 0x0000  | | | | :--- | --- | --- | | Bit |  NAME   |  FUNCTION   | | 15:1 |  |  | | 0 | LEDOFF | <font style="color:rgb(24, 24, 24);">1</font>: <font style="color:rgb(24, 24, 24);">关闭LED灯</font><br/><font style="color:rgb(24, 24, 24);">0</font>: <font style="color:rgb(24, 24, 24);">打开LED灯</font> | | 示例：FF AA 1B 01 00（关闭LED灯） | | |  ### READADDR（读取寄存器） | 寄存器名称: READADDR<br/>寄存器地址: 39 (0x27)<br/>读写方向: R/W<br/>默认值: 0x00FF  | | | | :--- | --- | --- | | Bit |  NAME   |  FUNCTION   | | 15:8 |  |  | | 7:0 | READADDR[7:0] | 读取寄存器范围： 请参考“寄存器表” | | 示例：<br/>发送：FF AA 27 34 00（读取加速度X轴0x34）<br/>返回：55 5F AXL AXH AYL AYH AZL AZH GXL GXH SUM<br/>具体请参考“读格式”章节的“读取寄存器返回值” | | |  ### VERSIONL~VERSIONH（版本号） | 寄存器名称: VERSIONL~VERSIONH<br/>寄存器地址: 46~47 (0x2E~0x2F)<br/>读写方向: R<br/>默认值: 无 | | | | :--- | --- | --- | | Bit |  NAME   |  FUNCTION   | | 15:0 | VERSIONL[15:0] |  | | 15:0 | VERSIONH[15:0] |  | | 示例：<br/>发送：FF AA 27 2E 00（读取版本号，0x27表示读取，0x2E是版本号寄存器）<br/>返回：55 5F VLL VLH VHL VHH XX XX XX XX SUM<br/>VERSION=(VHH<<24)|(VHL<<16)|(VLH<<8)|VLL<br/>例如：<br/>读取后返回：55 5F 01 41 EF 89 XX XX<br/>转成二进制：1<font style="color:#601BDE;">000 1001 1110 1111 01</font><font style="color:#117CEE;">00 0001</font> <font style="color:#DF2A3F;">0000 0001</font><br/>紫色部分为产品版本(17bit)：000 1001 1110 1111 01 = 10173<br/>蓝色部分为硬件版本(6bit)：00 0001 = 1<br/>红色部分为软件版本(8bit)：0000 0001 = 1<br/>最终版本号：10173.1.1 | | |  ### YYMM~MS（片上时间） | 寄存器名称: YYMM~MS<br/>寄存器地址: 48~51 (0x30~0x33)<br/>读写方向: R/W<br/>默认值: 0x0000  | | | | :--- | --- | --- | | Bit |  NAME   |  FUNCTION   | | 15:8 | YYMM[15:8] | 月 | | 7:0 | YYMM[7:0] | 年 | | 15:8 | DDHH[15:8] | 时 | | 7:0 | DDHH[7:0] | 日 | | 15:8 | MMSS[15:8] | 秒 | | 7:0 | MMSS[7:0] | 分 | | 15:0 | MS[15:0] | 毫秒 | | 示例：<br/>FF AA 30 16 03（设置年月22-03）<br/>FF AA 31 0C 09（设置日时12-09）<br/>FF AA 32 1E 3A（设置分秒30:58）<br/>FF AA 33 F4 01（设置毫秒500）<br/>示例：<br/>发送：FF AA 27 30 00（读取版本号，0x27表示读取，0x30是年月寄存器）<br/>返回：55 5F YYMM[7:0] YYMM[15:8] DDHH[7:0] DDHH[15:8] MMSS[7:0] MMSS[15:8] MS[7:0] MS[15:8] SUM | | |  ### GY~GZ（角速度） | 寄存器名称: GY~GZ<br/>寄存器地址: 56~57 (0x38~0x39)<br/>读写方向: R<br/>默认值: 0x0000  | | | | :--- | --- | --- | | Bit |  NAME   |  FUNCTION   | | 15:0 | GY[15:0] | 角速度Y=GY[15:0]/32768*2000°/s【1】 | | 15:0 | GZ[15:0] | 角速度Z=GZ[15:0]/32768*2000°/s【2】 |  【1】角速度Z的原始数据 【2】角速度Z的原始数据经过校准后得到的角速度Z ### Yaw（偏航角） | 寄存器名称: Yaw<br/>寄存器地址: 63 (0x3F)<br/>读写方向: R<br/>默认值: 0x0000  | | | | :--- | --- | --- | | Bit |  NAME   |  FUNCTION   | | 15:0 | Yaw[15:0] | 航向角Z=Yaw[15:0]/32768*180° |  ### WORKMODE（Z轴运行模式） | 寄存器名称: WORKMODE<br/>寄存器地址: 72 (0x48)<br/>读写方向: R/W<br/>默认值: 0x0000 | | | | :--- | --- | --- | | Bit |  NAME   |  FUNCTION   | | 15:4 |  |  | | 3:0 | WORKMODE[3:0] | 设置Z轴运行模式：<br/>0000(0x00): 正常数据模式<br/>0001(0x01): 求峰峰值模式<br/>0010(0x02): 求零偏模式<br/>0011(0x03):求标度因素模式 | | 示例：发送：FF AA  48 01 00（自动获取零偏） | | |  ### GYROPTP（Z轴静止峰峰值） | 寄存器名称: GYROPTP<br/>寄存器地址: 74 (0x4A)<br/>读写方向: R/W<br/>默认值: 0x0000 | | | | :--- | --- | --- | | Bit |  NAME   |  FUNCTION   | | 15:0 | GYROPTP[15:0] | 在计算零偏时使用的参数，为传感器自动获取无需设置 | | 在向"WORKMODE"寄存器写入0x01进入“求峰峰值模式”，在此模式下传感器自动计算"GPTPTIME"所设置的时间内Z轴角速度最大值与最小值并记录在"GYROPTP"中。在“求零偏模式”下会使用到此数据进行零偏的计算过滤。<br/>Z轴静止峰峰值=GYROPTP/1000（°/s）<br/>示例：<br/>发送：FF AA 27 4A 00（读取Z轴静止峰峰值）<br/>返回：55 5F 64 00 XX XX XX XX XX XX SUM<br/>0x0064=100，Z轴静止峰峰值 = 100/1000=0.1（°/s） | | |  ### GPTPTIME（Z轴峰峰值获取时间） | 寄存器名称: GPTPTIME<br/>寄存器地址: 75 (0x4B)<br/>读写方向: R/W<br/>默认值: 0x000A | | | | :--- | --- | --- | | Bit |  NAME   |  FUNCTION   | | 15:0 | GPTPTIME[15:0] | 计算峰峰峰值时间，默认10S | | 示例：发送：FF AA 4B 0A 00（设置Z轴峰峰值获取时间为10S）<br/>进入“求峰峰值模式”后，获取"GPTPTIME"时间内Z轴角速度最大值与最小值之差，存储在"GYROPTP"中，并且在“求零偏模式”下会使用到此数据进行零偏的计算过滤。 | | |  ### GYROBAIS（Z轴零偏值） | 寄存器名称: GYROBAIS<br/>寄存器地址: 76 (0x4C)<br/>读写方向: R/W<br/>默认值: 0x0000 | | | | :--- | --- | --- | | Bit |  NAME   |  FUNCTION   | | 15:0 | GYROBAIS[15:0] | 水平陀螺仪零偏值，可通过“求零偏模式”获取 | | Z轴水平陀螺仪在静止放置下有一定零偏值，可通过此零偏值消除静止时的角速度。零偏值可通过自动获取零偏自动计算得出。进入“求零偏模式”根据"GYROPTP"的峰峰值与"GBAISTIME"零偏获取时间自动计算零偏值。<br/>Z轴零偏值=GYROBAIS/1000（°/s）<br/>示例：<br/>发送：FF AA  27 4C 00（读取Z轴静止峰峰值）<br/>返回：55 5F 64 00 XX XX XX XX XX XX SUM<br/> 0x0064=100，Z轴静止峰峰值 = 100/1000=0.1（°/s） | | |  ### GBAISTIME（Z轴零偏获取时间） | 寄存器名称: GBAISTIME<br/>寄存器地址: 77 (0x4D)<br/>读写方向: R/W<br/>默认值: 0x000A | | | | :--- | --- | --- | | Bit |  NAME   |  FUNCTION   | | 15:0 | GBAISTIME[15:0] | 水平陀螺仪零偏值计算所需时间 | | 示例：发送：FF AA 4D 0A 00（设置Z轴零偏获取时间为10S）<br/>获取Z轴零偏所需时间，在获取零偏时根据此时间进行零偏值获取。 | | |  ### GSTATICTHRE（Z轴静止阈值） | 寄存器名称: GSTATICTHRE<br/>寄存器地址: 78 (0x4E)<br/>读写方向: R/W<br/>默认值: 0x0032 | | | | :--- | --- | --- | | Bit |  NAME   |  FUNCTION   | | 15:0 | GSTATICTHRE[15:0] | GSTATICTHRE[15:0]越大，抗震性能增强，误差增大<br/>GSTATICTHRE[15:0]越小，抗震性能减弱，误差减小<br/>默认值50 | | Z轴水平陀螺仪在静止放置下有轻微数据抖动，此参数可以将这些轻微抖动滤除。在角速度小于"GSTATICTHRE"设置值并且持续"GSTATICTIME"设置的时间时视为静止，Z轴角速度为零。在用于有抖动的场景抖动引起Z轴累加时可适当将此参数调大，在用于非常缓慢匀速转动的场景可适当将此参数调小。<br/>Z轴零偏值=GSTATICTHRE/1000（°/s）<br/>示例：<br/>发送：FF AA 4E 64 00（（设置Z轴静止阈值0.1°/s）,0x0064=100，100/1000=0.1（°/s）） | | |  ### GSTATICTIME（Z轴稳定时间） | 寄存器名称: GSTATICTIME<br/>寄存器地址: 79 (0x4F)<br/>读写方向: R/W<br/>默认值: 0x0064 | | | | :--- | --- | --- | | Bit |  NAME   |  FUNCTION   | | 15:0 | GSTATICTIME[15:0] | Z轴判断静止时间 | | Z轴静止判断时间阈值。在角速度小于"GSTATICTHRE"设置值并且持续"GSTATICTIME"设置的时间时视为静止。如对稳定时间要求较高可适当调小此参数。调小此参数可加快稳定时间但同时也可能会增加误差。<br/>Z轴稳定时间=GSTATICTIME/1000（s）<br/>示例：<br/>发送：FF AA 4F 32 00 （（设置Z轴稳定时间0.05s）,0x0032=50，50/1000=0.05(°)） | | |  ### PGSCALE（Z轴标定因素P） | 寄存器名称: PGSCALE<br/>寄存器地址: 80 (0x50)<br/>读写方向: R/W<br/>默认值: 0x2710 | | | | :--- | --- | --- | | Bit |  NAME   |  FUNCTION   | | 15:0 | PGSCALE[15:0] | 范围：0~20000<br/>此参数为出厂使用高精度转台写入，请勿修改 | | Z轴陀螺仪测量时存在误差，出厂时会使用高精度转台测量此误差，并将此参数写入传感器中。非必要情况下请勿修改此参数。此参数可在“求标度因素模式”中自动计算，在进入“求标度因素模式”后将传感器旋转"GSCALERANGE"设置的角度即可计算出标定因素。<br/>Z轴标定因素P=PGSCALE/10000.0<br/>示例：<br/>发送：FF AA 27 50 00（读取Z轴标定因素P）<br/>返回：55 5F 74 27 XX XX XX XX XX XX SUM<br/>0x2747 = 10100，读取Z轴标定因素P = 10100/10000=1.01 | | |  ### GSCALERANGE（Z轴角度标定量程） | 寄存器名称: GSCALERANGE<br/>寄存器地址: 82 (0x52)<br/>读写方向: R/W<br/>默认值: 0x02D0 | | | | :--- | --- | --- | | Bit |  NAME   |  FUNCTION   | | 15:0 | GSCALERANGE[15:0] | 在标定因素时需要根据此参数标定 | | 示例：<br/>发送：FF AA 52 68 01（（设置Z轴校准角度360），0x0168=360）<br/>Z轴“求标度因素模式”下所需要旋转的角度，一般设置为360°的整数倍。 | | |  ### GYROCALITHR（陀螺仪静止阈值） | 寄存器名称: GYROCALITHR<br/>寄存器地址: 97 (0x61)<br/>读写方向: R/W<br/>默认值: 0x0000 | | | | --- | --- | --- | | Bit |  NAME   |  FUNCTION   | | 15:0 | GYROCALITHR[15:0] | 设置陀螺仪静止阈值：<br/>陀螺陀螺仪静止阈值=GYROCALITHR[15:0]/1000(°/s) | | 示例：<br/>FF AA  61 32 00（设置陀螺仪静止阈值为0.05°/s，0x0032=50，50/1000=0.05(°/s)）<br/>当角速度变化小于0.05°/s时，且持续"GYROCALTIME"的时间，传感器识别为静止，自动把小于0.05°/s的角速度归零<br/>陀螺仪静止阈值的大小设置规律，可通过读取"WERROR"寄存器的值来确定，一般设置的规律是：GYROCALITHR=WERROR*1.2，单位：°/s<br/>该寄存器需要需要结合GYROCALTIME寄存器使用 | | |  ### GYROCALTIME（陀螺仪自动校准时间） | 寄存器名称: GYROCALTIME<br/>寄存器地址: 99 (0x63)<br/>读写方向: R/W<br/>默认值: 0x03E8 | | | | :--- | --- | --- | | Bit |  NAME   |  FUNCTION   | | 15:0 | GYROCALTIME[15:0] | 设置陀螺仪自动校准时间 | | 示例：设置陀螺仪自动校准时间500ms<br/>FF AA 63 F4 01<br/>当角速度变化小于"GYROCALITHR"时，且持续500ms的时间，传感器识别为静止，自动把小于0.05°/s的角速度归零<br/>该寄存器需要需要结合GYROCALITHR寄存器使用 | | |  ### WERROR（陀螺仪变化值） | 寄存器名称: WERROR<br/>寄存器地址: 106 (0x6A)<br/>读写方向: R<br/>默认值: 0x0000 | | | | :--- | --- | --- | | Bit |  NAME   |  FUNCTION   | | 15:0 | WERROR[15:0] | 陀螺仪变化值=WERROR[15:0]/1000*180/3.1415926(°/s)<br/>在传感器静止放置时，可通过该寄存器的变化，来设定"GYROCALITHR"寄存器 |  ### WZTIME（角速度连续静止时间） | 寄存器名称: WZTIME<br/>寄存器地址: 110 (0x6E)<br/>读写方向: R/W<br/>默认值: 0x01F4 | | | | :--- | --- | --- | | Bit |  NAME   |  FUNCTION   | | 15:0 | WZTIME[15:0] | 角速度连续静止时间 | | 示例：设置角速度连续静止时间500ms<br/>FF AA 6E F4 01<br/>当角速度小于"WZSTATIC"时，且持续500ms，则角速度输出为0，且Z轴航向角不积分<br/>该寄存器需要需要结合"WZSTATIC"寄存器使用 | | |  ### WZSTATIC（角速度积分阈值） | 寄存器名称: WZSTATIC<br/>寄存器地址: 111 (0x6F)<br/>读写方向: R/W<br/>默认值: 0x012C | | | | :--- | --- | --- | | Bit |  NAME   |  FUNCTION   | | 15:0 | WZSTATIC[15:0] | 角速度积分阈值=WZSTATIC[15:0]/1000(°/s) | | 示例：设置角速度积分阈值为0.5°/s<br/>FF AA 6F F4 01<br/>当角速度大于0.5°/s时，Z轴航向角开始对加速度进行积分<br/>当角速度小于0.5°/s时，且持续寄存器"WZTIME"所设置的时长时，角速度输出为0，且Z轴航向角不积分<br/>该寄存器需要需要结合"WZTIME"寄存器使用 | | |  ###  ### MANUALCALI（手动获取零偏） | 寄存器名称: MANUALCALI<br/>寄存器地址: 1 (0xA6)<br/>读写方向: R/W<br/>默认值: 0x0000  | | | | :--- | --- | --- | | Bit |  NAME   |  FUNCTION   | | 15:1 |  | 无效 | | 0 | CALSW | 1：进入获取零偏<br/>4：退出获取零偏 | | 示例：<br/>FF AA A6 01 00   进入获取零偏，务必保持静止，否则会导致数据错误<br/>等待，具体时长由用户决定<br/>FF AA A6 04 00   退出获取零偏<br/>注：机器人静止后，发送进入获取零偏，等机器人要启动之前，发送退出获取零偏 | | |  ### NOAUTOCALI（陀螺仪自动校准零偏） | 寄存器名称: NOAUTOCALI<br/>寄存器地址: 1 (0xA7)<br/>读写方向: R/W<br/>默认值: 0x0000  | | | | :--- | --- | --- | | Bit |  NAME   |  FUNCTION   | | 15:1 |  | 无效 | | 0 | NOAUTOCALI | 0：打开<br/>1：关闭 | | 示例：<br/>FF AA A7 01 00   关闭陀螺仪自动校准，程序关闭自动获取零偏，配合0xA6寄存器"MANUALCALI"使用<br/>FF AA A7 00 00   打开陀螺仪自动校准，程序会自动获取零偏，但容易获取错误零偏，导致角度出错<br/>注：如果机器人能知道自己是否处于静止，则建议关闭陀螺仪自动校准功能 | | |
