Fawziya25/AGV_Project/机械建模/定制件/环氧板-上层.SLDPRT

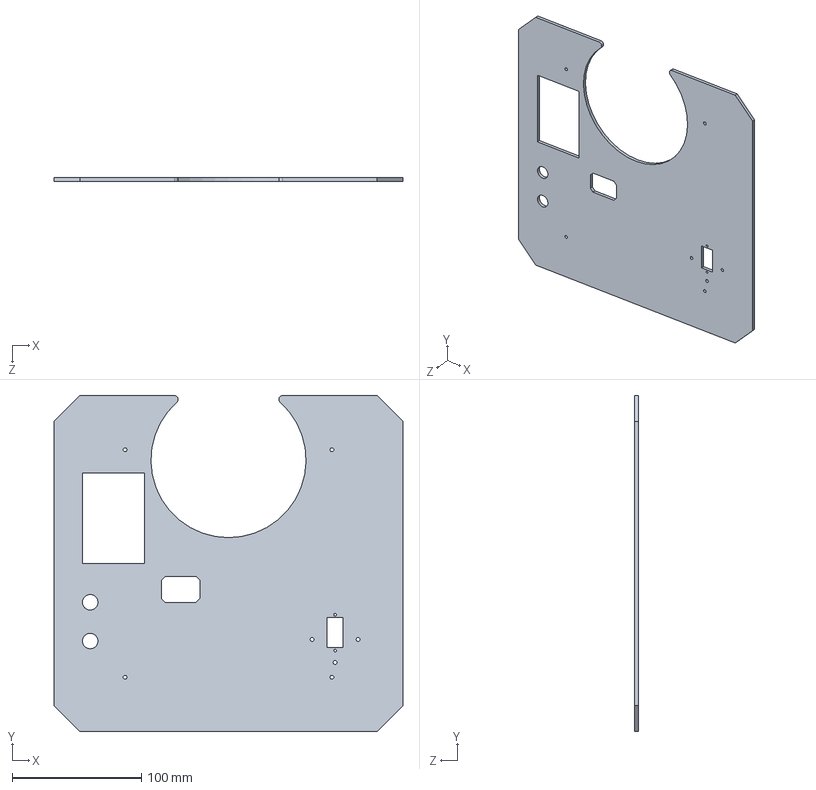
[picture p1: CAD file, 2026-10-14]
机械建模/定制件/环氧板-上层.SLDPRT
270.0 x 260.0 x 3.00 mm
