Fawziya25/AGV_Project/机械建模/打印件/左物料夹爪.SLDPRT

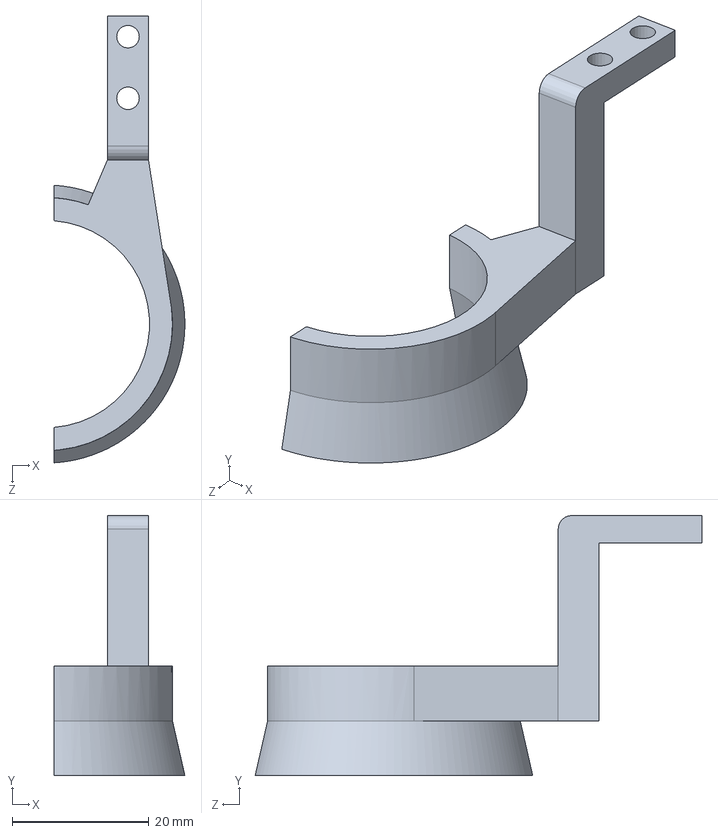
[picture p2: CAD file, 2026-10-14]
机械建模/打印件/左物料夹爪.SLDPRT
19.1 x 38.0 x 65.3 mm
