Fawziya25/AGV_Project/机械建模/标准件/滑轨-MGN7C.SLDPRT

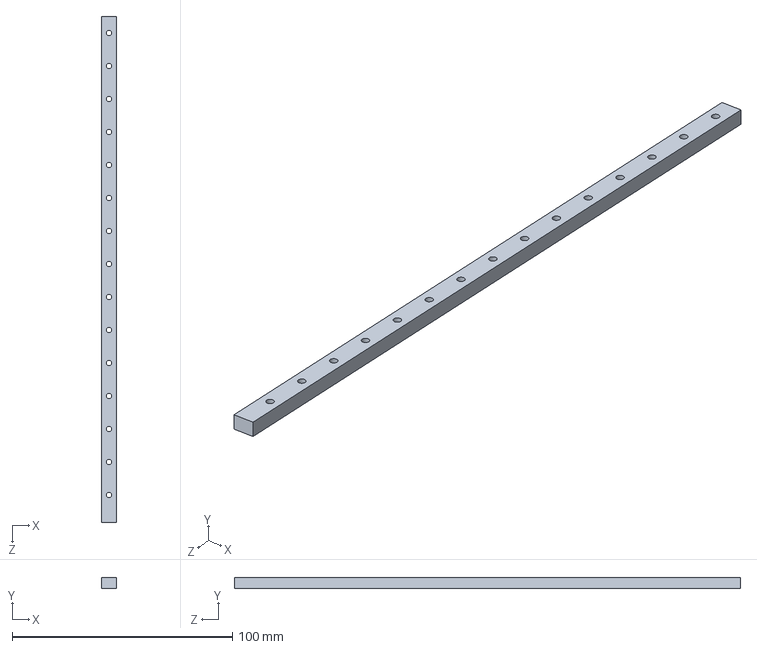
[picture p3: CAD file, 2026-10-14]
机械建模/标准件/滑轨-MGN7C.SLDPRT
7.00 x 4.80 x 230.0 mm
