Fawziya25/AGV_Project/机械建模/电子/舵机.SLDPRT

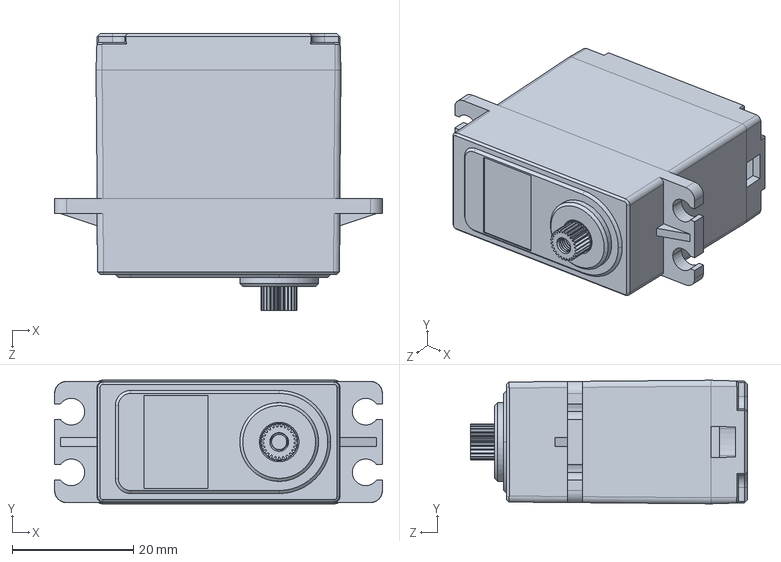
[picture p4: CAD file, 2026-10-14]
机械建模/电子/舵机.SLDPRT
54.1 x 20.4 x 45.7 mm
