Fawziya25/AGV_Project/机械建模/打印件/同步带连接板.SLDPRT

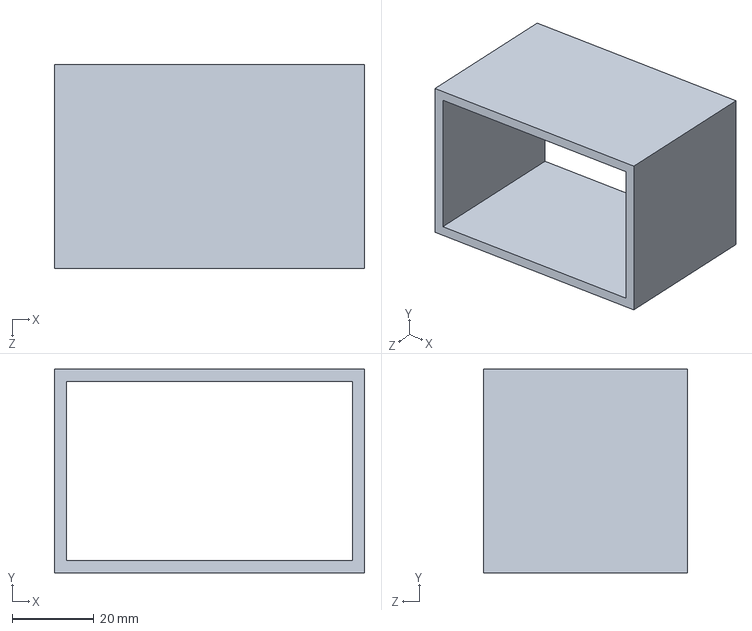
[picture p5: CAD file, 2026-10-14]
机械建模/打印件/同步带连接板.SLDPRT
76.0 x 50.0 x 50.0 mm
