Fawziya25/AGV_Project/机械建模/标准件/推力球轴承.SLDPRT

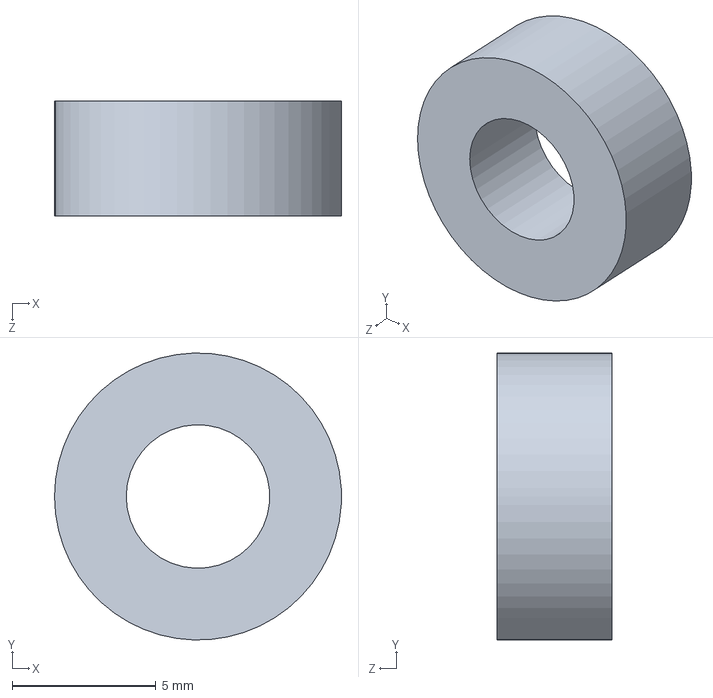
[picture p6: CAD file, 2026-10-14]
机械建模/标准件/推力球轴承.SLDPRT
10.0 x 10.00 x 4.00 mm
