Fawziya25/AGV_Project/机械建模/电子/42步进电机支架.STEP

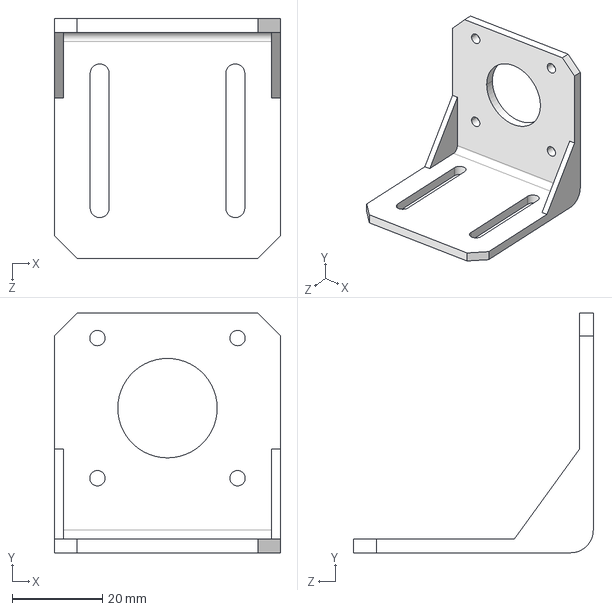
[picture p7: CAD file, 2026-10-14]
机械建模/电子/42步进电机支架.STEP
50.0 x 53.0 x 53.0 mm
