Fawziya25/AGV_Project/机械建模/打印件/物料盘轴承座.SLDPRT

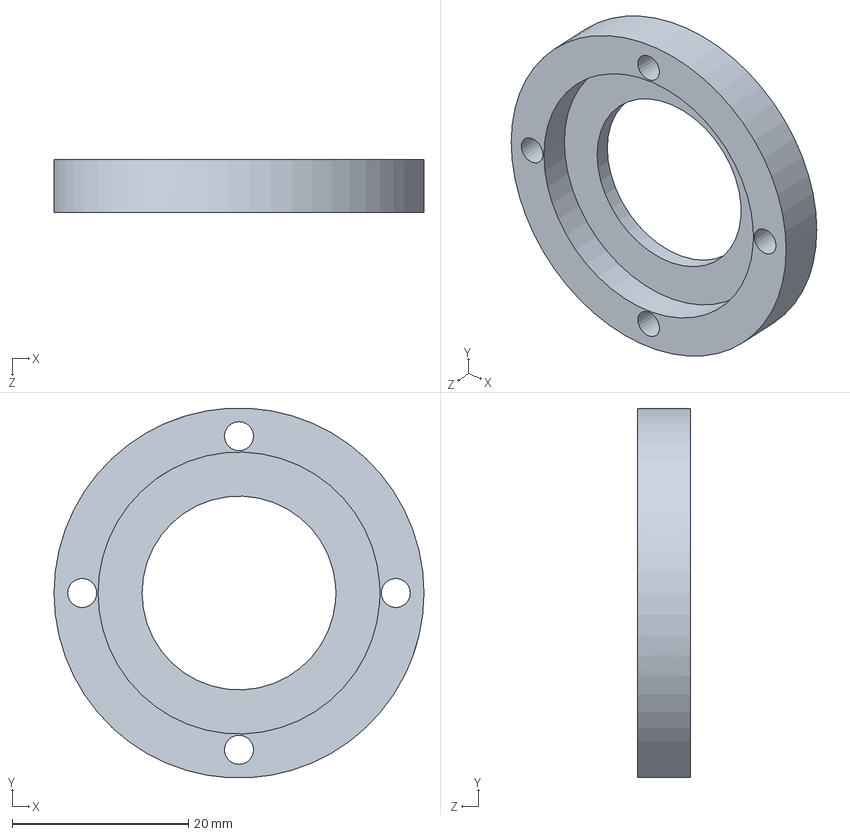
[picture p8: CAD file, 2026-10-14]
机械建模/打印件/物料盘轴承座.SLDPRT
42.0 x 41.9 x 6.00 mm
