Fawziya25/AGV_Project/机械建模/标准件/同步带-S3M.SLDPRT

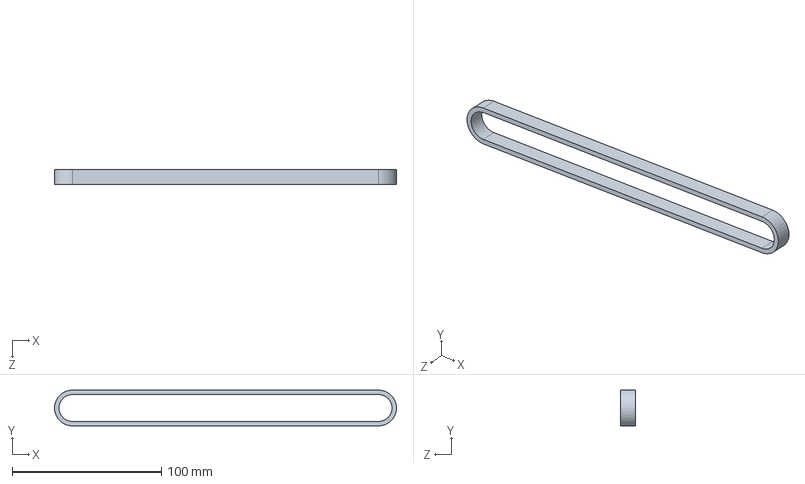
[picture p9: CAD file, 2026-10-14]
机械建模/标准件/同步带-S3M.SLDPRT
229.0 x 24.0 x 10.0 mm
