Fawziya25/AGV_Project/机械建模/电子/激光雷达.STEP

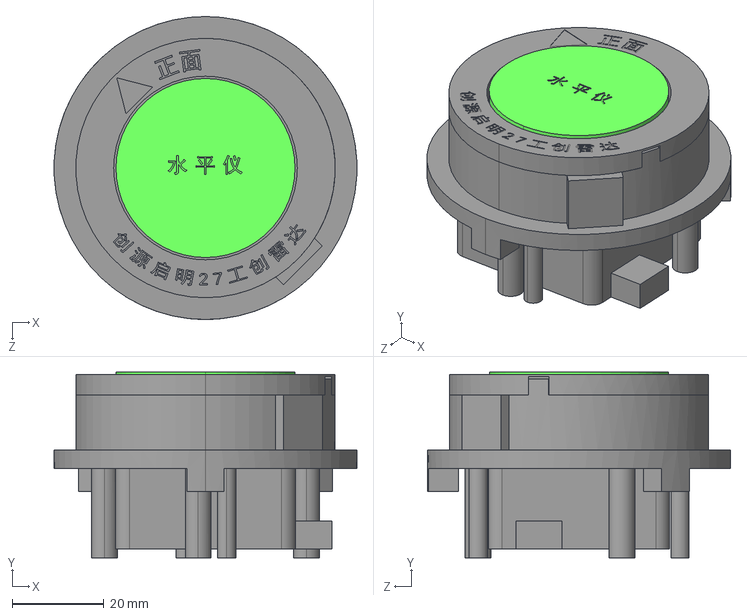
[picture p10: CAD file, 2026-10-14]
机械建模/电子/激光雷达.STEP
65.9 x 40.5 x 66.0 mm
