Fawziya25/AGV_Project/机械建模/打印件/齿条-模数0.8长度260.SLDPRT

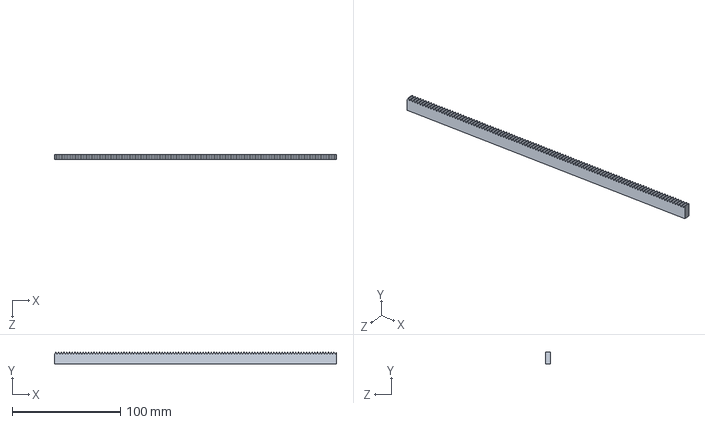
[picture p11: CAD file, 2026-10-14]
机械建模/打印件/齿条-模数0.8长度260.SLDPRT
260.0 x 10.8 x 5.00 mm
