Fawziya25/AGV_Project/机械建模/标准件/滑轨-MGN9C.SLDPRT

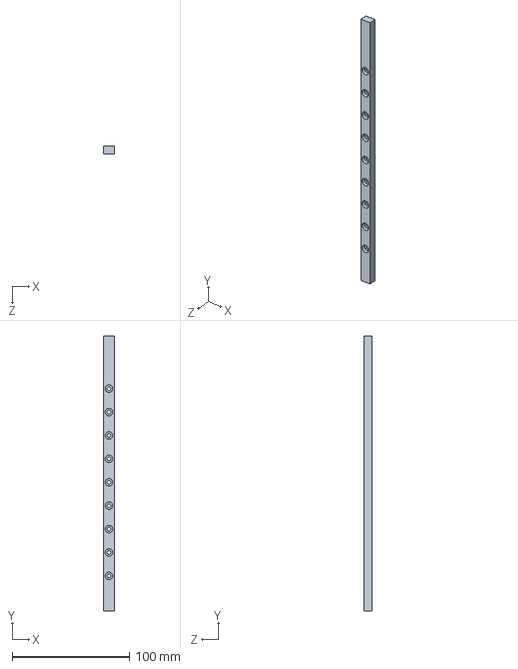
[picture p12: CAD file, 2026-10-14]
机械建模/标准件/滑轨-MGN9C.SLDPRT
9.00 x 235.0 x 6.50 mm
