Fawziya25/AGV_Project/机械建模/电子/扫码模块-CY-SCAN01.SLDPRT

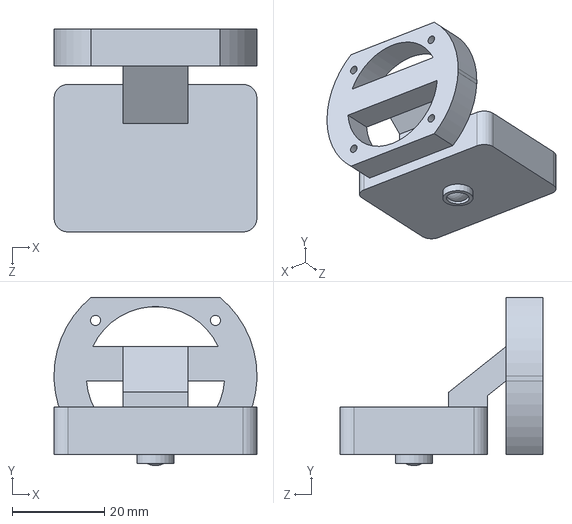
[picture p13: CAD file, 2026-10-14]
机械建模/电子/扫码模块-CY-SCAN01.SLDPRT
44.0 x 36.5 x 44.0 mm
