Fawziya25/AGV_Project/机械建模/标准件/法兰轴承.SLDPRT

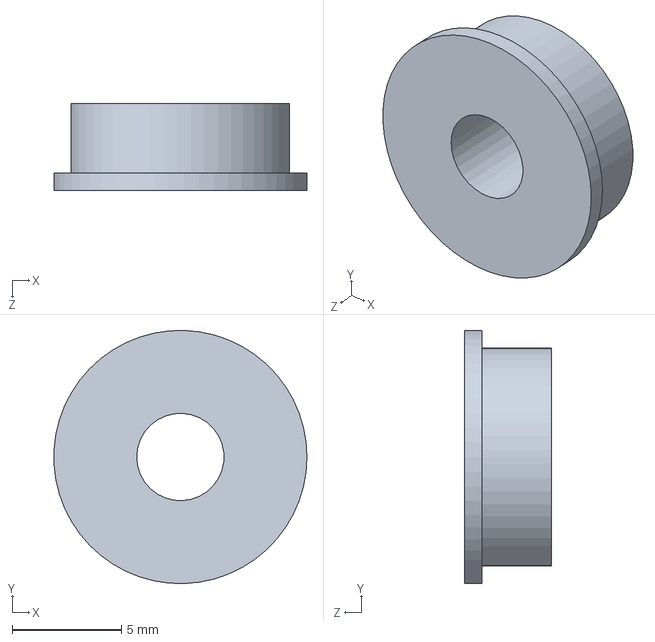
[picture p14: CAD file, 2026-10-14]
机械建模/标准件/法兰轴承.SLDPRT
11.6 x 11.6 x 4.00 mm
