Fawziya25/AGV_Project/机械建模/电子/夹爪舵机-mg90.SLDPRT

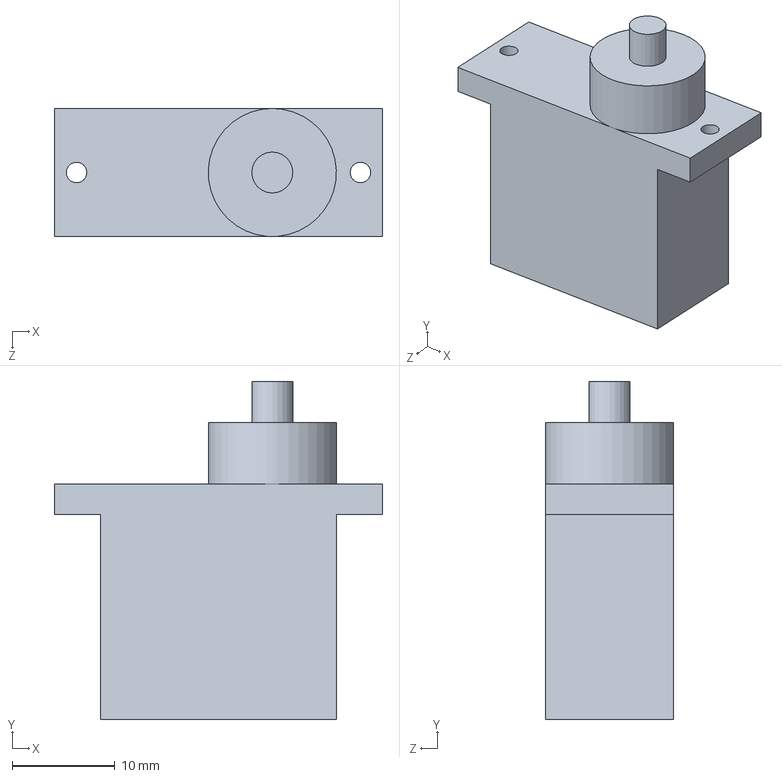
[picture p15: CAD file, 2026-10-14]
机械建模/电子/夹爪舵机-mg90.SLDPRT
32.0 x 33.0 x 12.5 mm
