Fawziya25/AGV_Project/机械建模/打印件/激光雷达固定板.SLDPRT

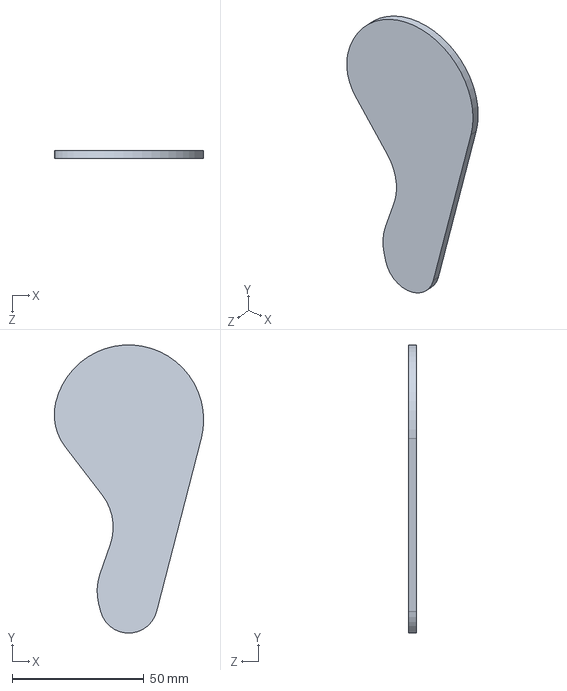
[picture p16: CAD file, 2026-10-14]
机械建模/打印件/激光雷达固定板.SLDPRT
56.7 x 109.4 x 3.00 mm
