Fawziya25/AGV_Project/机械建模/标准件/轴承-6705.SLDPRT

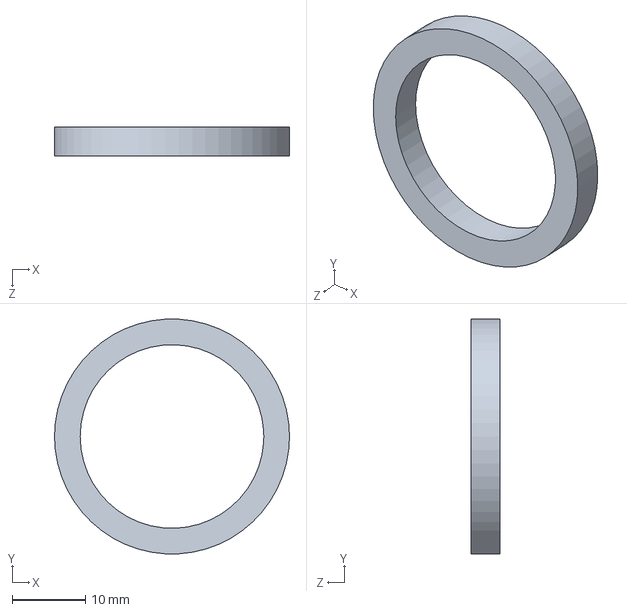
[picture p17: CAD file, 2026-10-14]
机械建模/标准件/轴承-6705.SLDPRT
32.0 x 31.9 x 4.00 mm
