Fawziya25/AGV_Project/机械建模/电子/28步进电机-28mm.SLDPRT

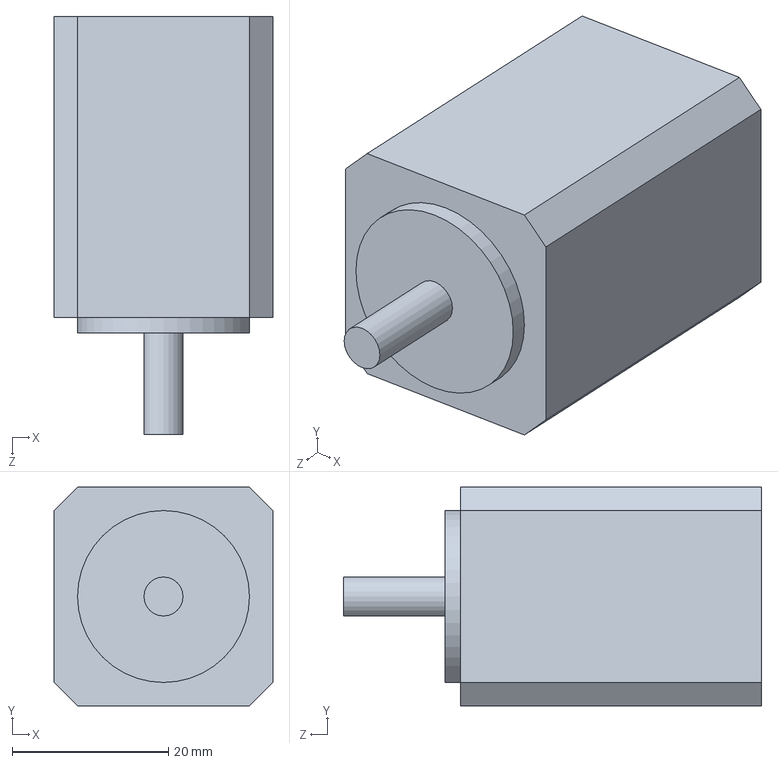
[picture p18: CAD file, 2026-10-14]
机械建模/电子/28步进电机-28mm.SLDPRT
28.0 x 28.0 x 53.5 mm
