Fawziya25/AGV_Project/机械建模/打印件/夹爪连接板改.SLDPRT

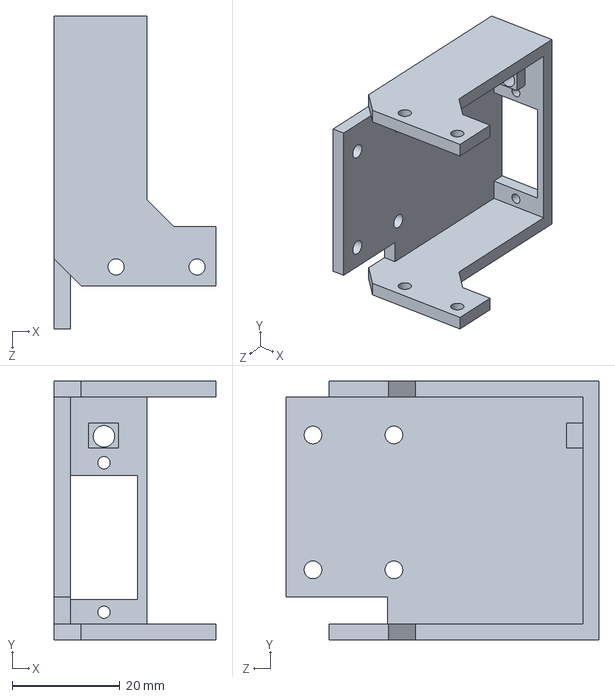
[picture p19: CAD file, 2026-10-14]
机械建模/打印件/夹爪连接板改.SLDPRT
30.0 x 48.0 x 58.0 mm
