Fawziya25/AGV_Project/机械建模/标准件/角铝-3030.SLDPRT

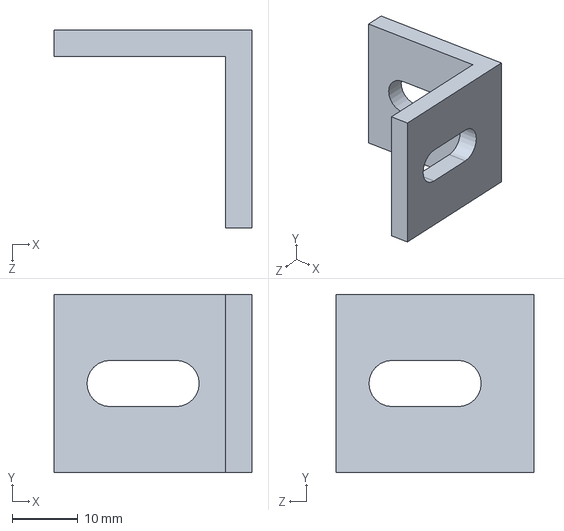
[picture p20: CAD file, 2026-10-14]
机械建模/标准件/角铝-3030.SLDPRT
30.0 x 27.0 x 30.0 mm
