Fawziya25/AGV_Project/机械建模/电子/42步进电机及驱动.STEP

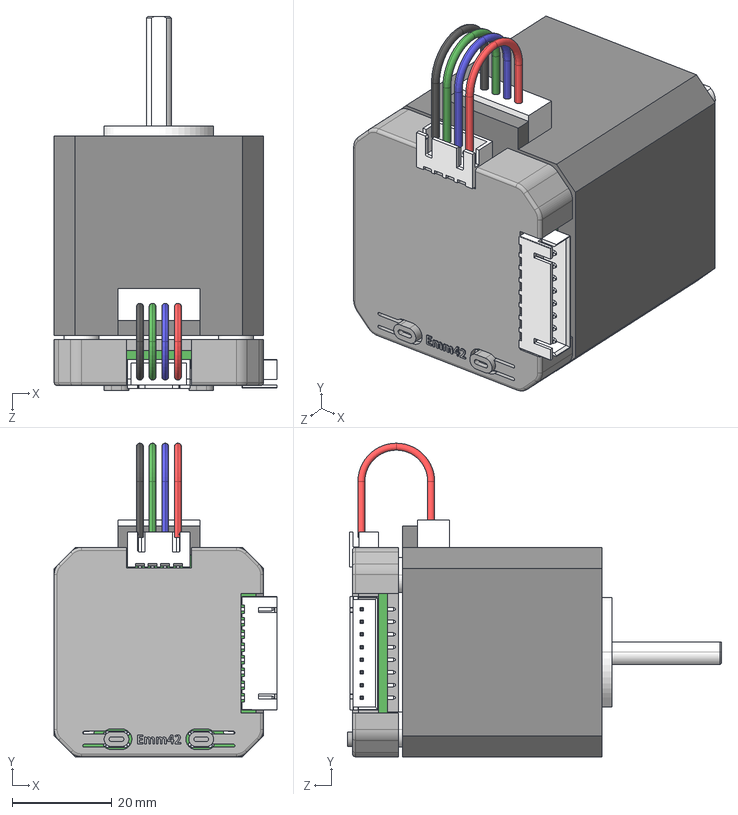
[picture p21: CAD file, 2026-10-14]
机械建模/电子/42步进电机及驱动.STEP
44.7 x 62.9 x 75.0 mm
42_STEPPER_MOTOR
SHIM_3x7x3 x 4
ts-1145a-b-a_White.step x 2
User_Library-XH2_54-4P-AW.step
XH2.54-8P_H-0.step
Extruded.step
Extruded-1.step
M3x6mm_Phillips x 4
ZDT_X42_V1.2
WIRE_2.54
