Fawziya25/AGV_Project/机械建模/打印件/相机固定板.SLDPRT

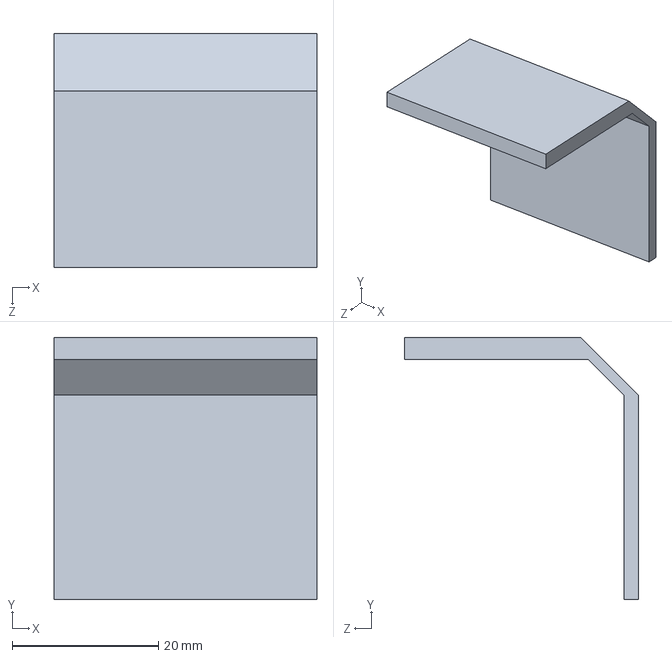
[picture p22: CAD file, 2026-10-14]
机械建模/打印件/相机固定板.SLDPRT
36.0 x 35.9 x 32.0 mm
