Fawziya25/AGV_Project/机械建模/标准件/导向光轴-240mm.SLDPRT

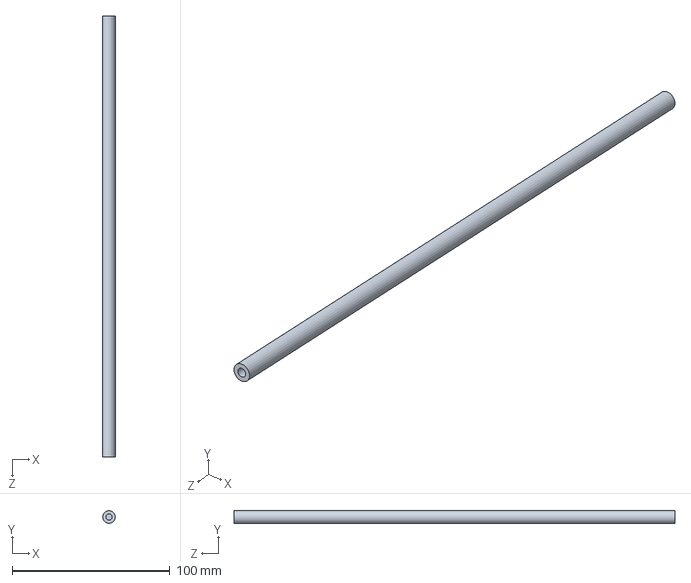
[picture p23: CAD file, 2026-10-14]
机械建模/标准件/导向光轴-240mm.SLDPRT
8.00 x 7.94 x 280.0 mm
