Fawziya25/AGV_Project/机械建模/电子/主控板.SLDPRT

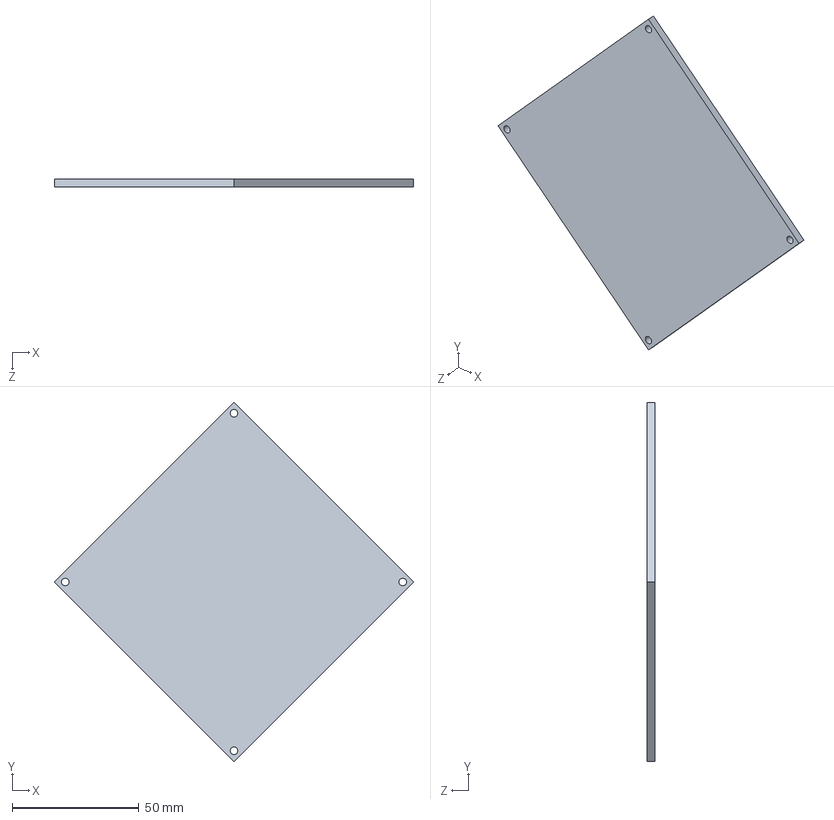
[picture p24: CAD file, 2026-10-14]
机械建模/电子/主控板.SLDPRT
141.4 x 141.4 x 3.00 mm
