Fawziya25/AGV_Project/机械建模/标准件/同步带轮-S3M20齿A型.SLDPRT

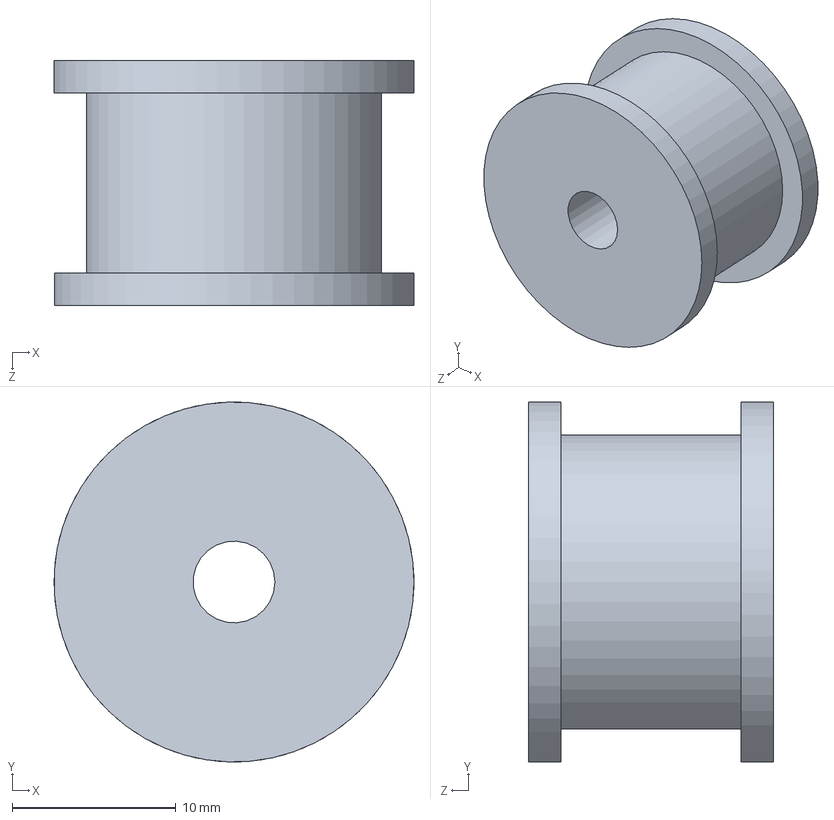
[picture p25: CAD file, 2026-10-14]
机械建模/标准件/同步带轮-S3M20齿A型.SLDPRT
22.0 x 22.0 x 15.0 mm
