Fawziya25/AGV_Project/机械建模/打印件/云台舵机垫板.SLDPRT

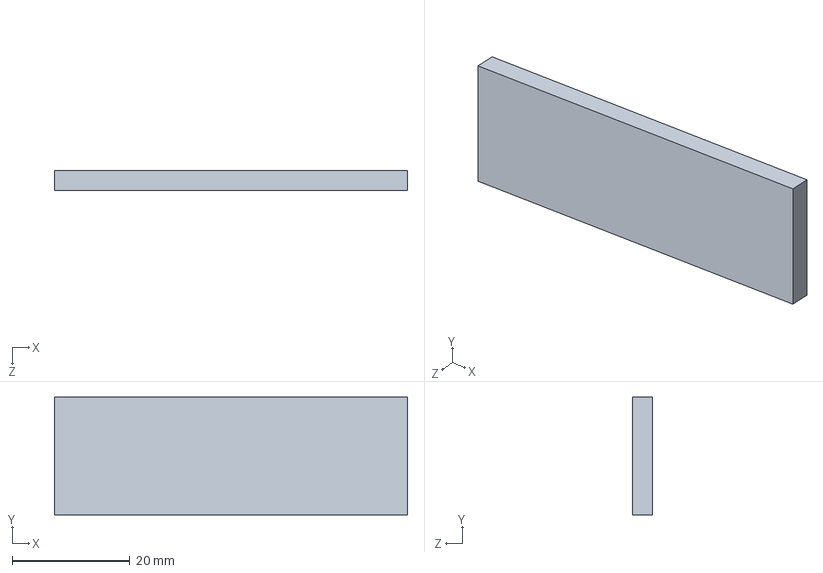
[picture p26: CAD file, 2026-10-14]
机械建模/打印件/云台舵机垫板.SLDPRT
60.0 x 20.0 x 3.45 mm
