Fawziya25/AGV_Project/机械建模/标准件/导向轴支座-STHWSB8.SLDPRT

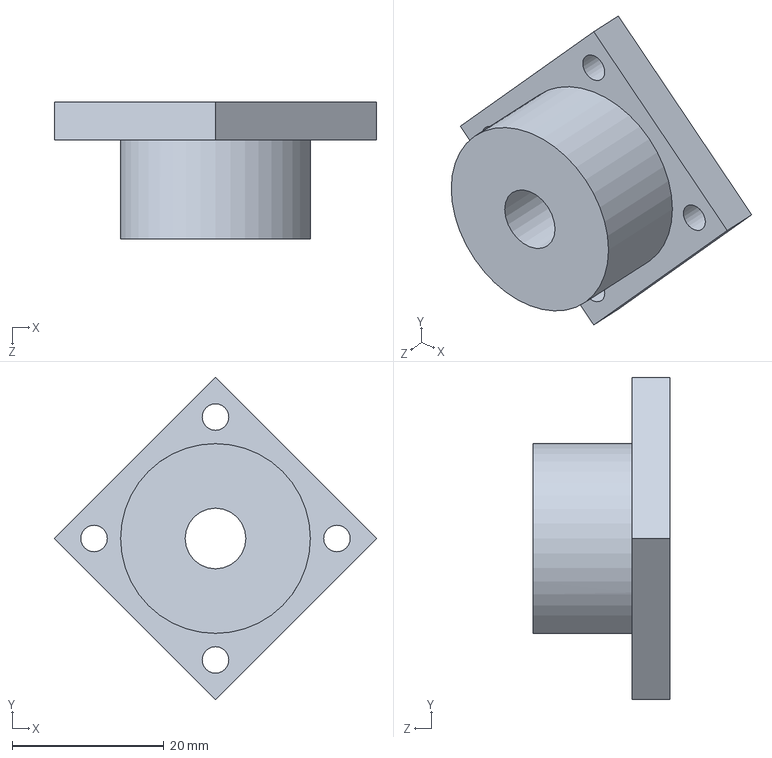
[picture p27: CAD file, 2026-10-14]
机械建模/标准件/导向轴支座-STHWSB8.SLDPRT
42.4 x 42.4 x 18.0 mm
