Fawziya25/AGV_Project/机械建模/打印件/齿条-模数0.8长度220.SLDPRT

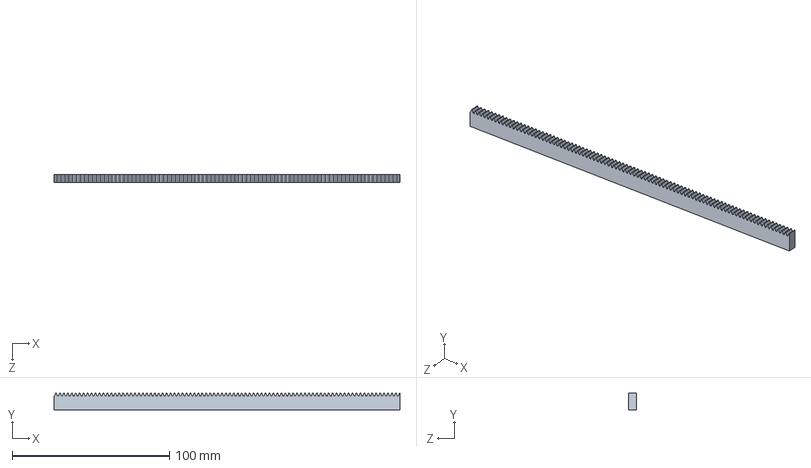
[picture p28: CAD file, 2026-10-14]
机械建模/打印件/齿条-模数0.8长度220.SLDPRT
220.0 x 10.8 x 5.00 mm
