Fawziya25/AGV_Project/机械建模/打印件/滑块固定板.SLDPRT

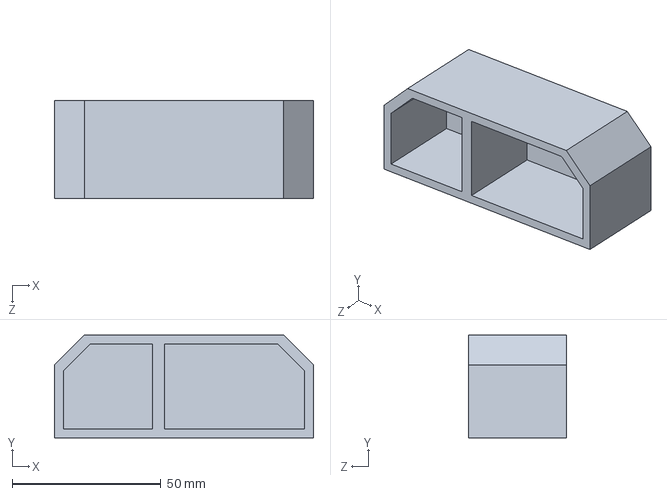
[picture p29: CAD file, 2026-10-14]
机械建模/打印件/滑块固定板.SLDPRT
87.0 x 34.5 x 33.0 mm
