Fawziya25/AGV_Project/机械建模/打印件/升降机构顶板.SLDPRT

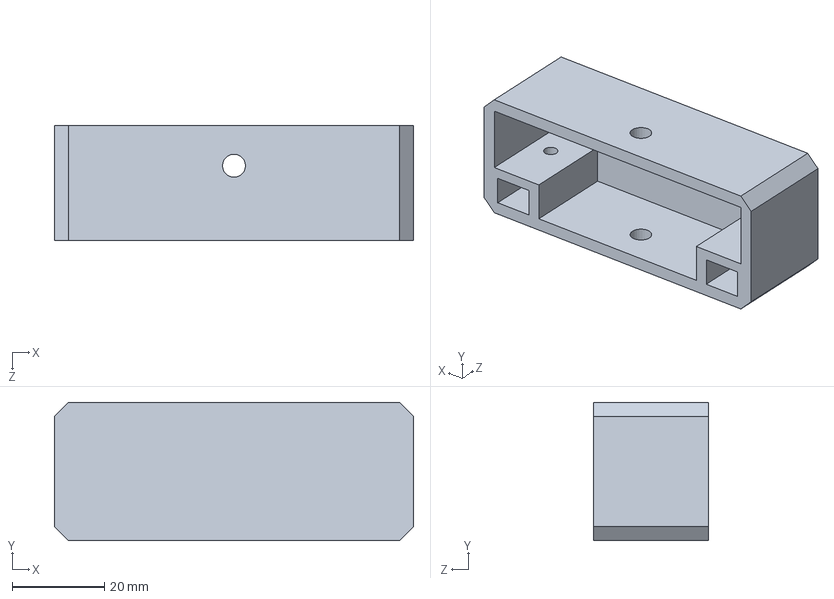
[picture p30: CAD file, 2026-10-14]
机械建模/打印件/升降机构顶板.SLDPRT
78.0 x 30.0 x 25.0 mm
