Fawziya25/AGV_Project/机械建模/打印件/同步带连接板1.SLDPRT

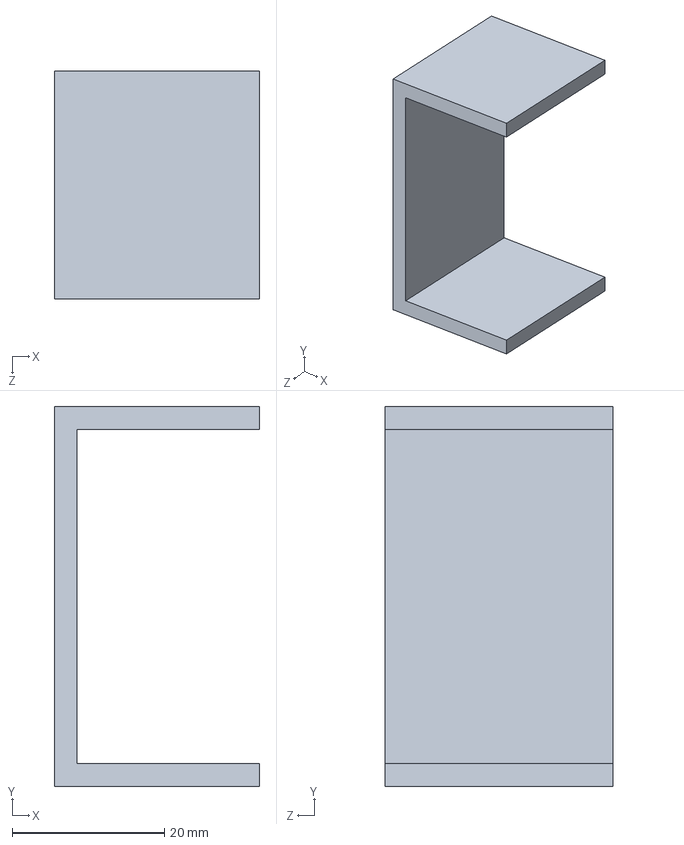
[picture p31: CAD file, 2026-10-14]
机械建模/打印件/同步带连接板1.SLDPRT
27.0 x 50.0 x 30.0 mm
