Fawziya25/AGV_Project/机械建模/打印件/左夹爪 .SLDPRT

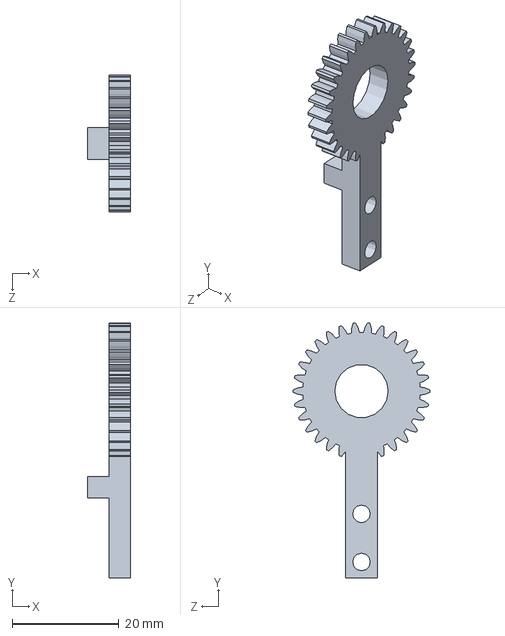
[picture p32: CAD file, 2026-10-14]
机械建模/打印件/左夹爪 .SLDPRT
8.00 x 47.8 x 25.6 mm
