Fawziya25/AGV_Project/机械建模/打印件/轴承座-下.SLDPRT

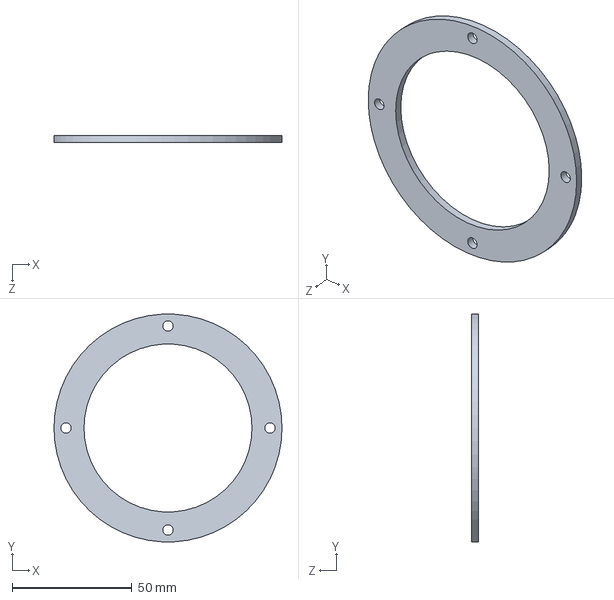
[picture p33: CAD file, 2026-10-14]
机械建模/打印件/轴承座-下.SLDPRT
95.0 x 94.8 x 3.00 mm
