Fawziya25/AGV_Project/机械建模/打印件/大垫圈.SLDPRT

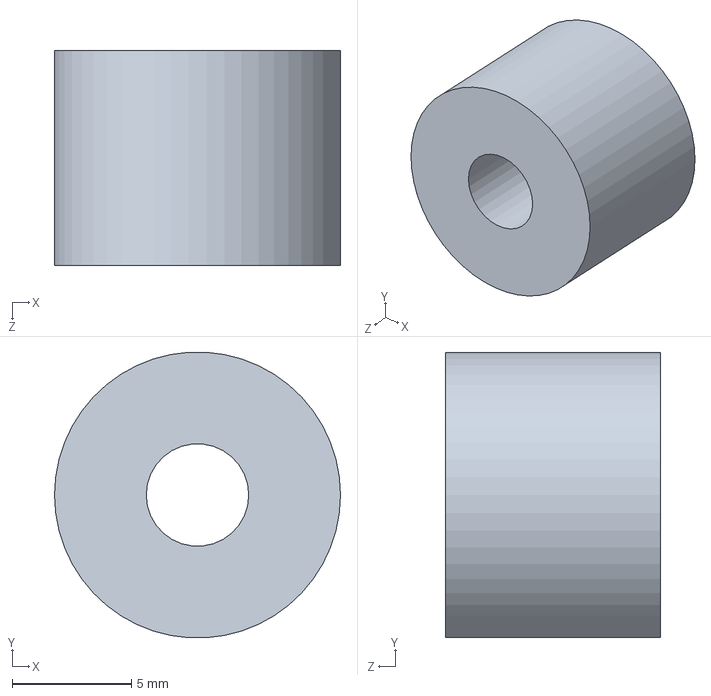
[picture p34: CAD file, 2026-10-14]
机械建模/打印件/大垫圈.SLDPRT
12.0 x 12.0 x 9.00 mm
