Fawziya25/AGV_Project/机械建模/打印件/轴承内盘.SLDPRT

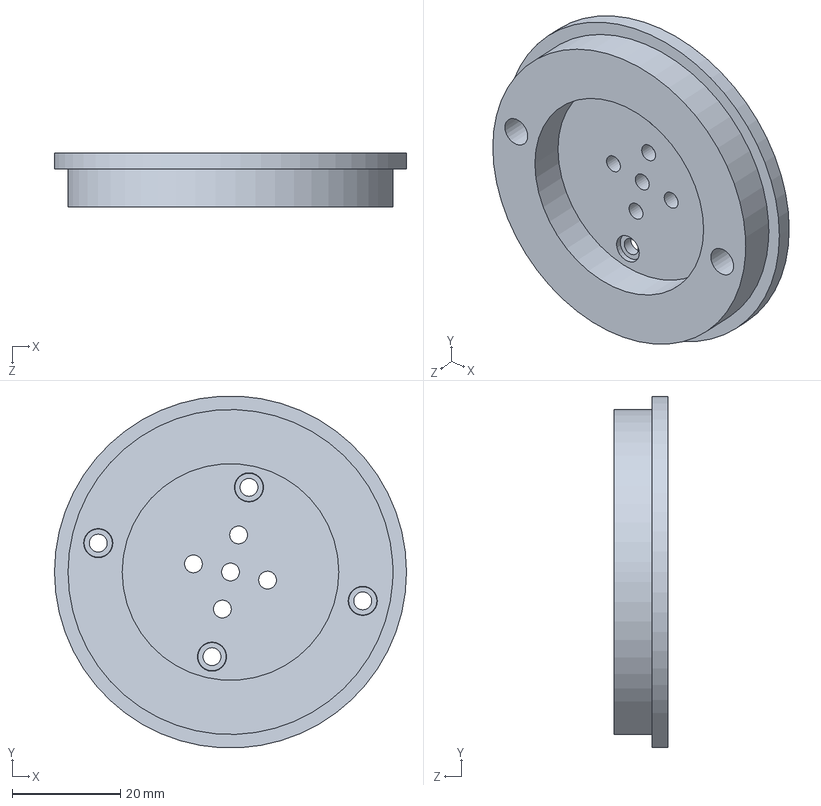
[picture p35: CAD file, 2026-10-14]
机械建模/打印件/轴承内盘.SLDPRT
65.0 x 64.9 x 10.0 mm
