Fawziya25/AGV_Project/机械建模/打印件/右夹爪.SLDPRT

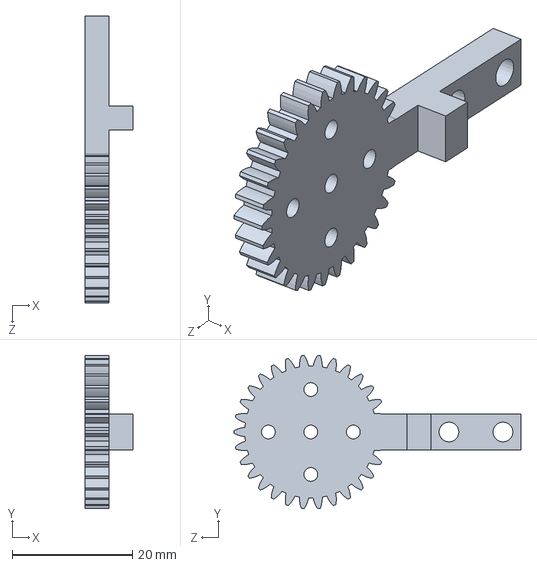
[picture p36: CAD file, 2026-10-14]
机械建模/打印件/右夹爪.SLDPRT
8.00 x 25.5 x 47.8 mm
