Fawziya25/AGV_Project/机械建模/打印件/雷达伸缩齿条.SLDPRT

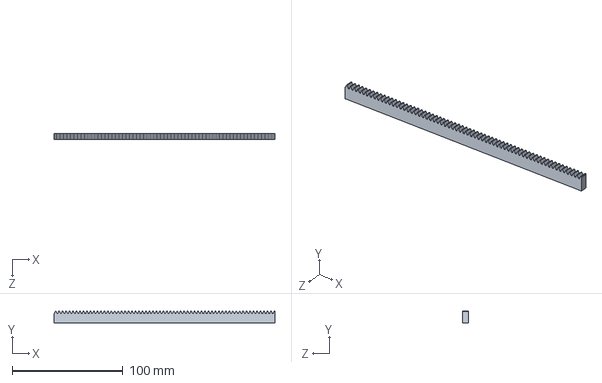
[picture p37: CAD file, 2026-10-14]
机械建模/打印件/雷达伸缩齿条.SLDPRT
200.0 x 11.0 x 5.00 mm
