Fawziya25/AGV_Project/机械建模/装配体/总装.SLDASM

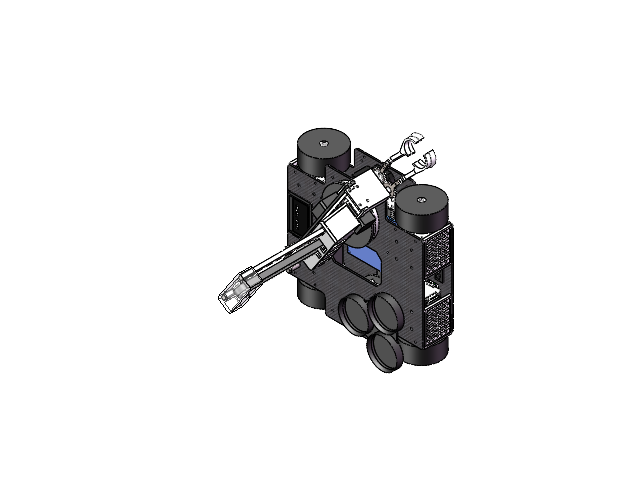
[picture p38: CAD file, 2026-10-14]
机械建模/装配体/总装.SLDASM
环氧板-下层
环氧板-中层
麦轮-75mm x 4
42步进电机支架.step x 4
ts-1145a-b-a_White.step.STEP x 8
User_Library-XH2_54-4P-AW.step.STEP x 4
XH2.54-8P_H-0.step.STEP x 4
Extruded.step.STEP x 4
Extruded-1.step.STEP x 4
42_STEPPER_MOTOR.STEP x 4
SHIM_3x7x3.STEP x 16
M3x6mm_Phillips.STEP x 16
ZDT_X42_V1.2.STEP x 4
WIRE_2.54.STEP x 4
麦轮联轴器 x 4
云台轴承-60x75x7
轴承座-中
轴承座-下
轴承内盘
法兰盘-5mm
滑轨-MGN7C
滑块-MGN7C x 3
同步带轮-S3M20齿A型 x 2
滑轨-MGN9C x 2
滑块-MGN9C x 2
35步进电机-28mm
同步带压板
齿轮-模数0.8齿数40
28步进电机-28mm
齿条-模数0.8长度260
电机固定板
垂直转接板
升降封装板1
升降机构底板
铝柱-M2.5X20 x 2
夹爪连接板改
夹爪舵机-mg90 x 2
升降装置封装板2
右夹爪
舵盘-mg90 x 2
左夹爪
法兰轴承
推力球轴承 x 2
升降机构顶板
同步带-S3M
物料转盘-舵臂
物料盘轴承座
激光雷达.step
舵机 x 2
舵盘-25T x 2
云台舵机垫板
轴承-6705
主控板
航模电池-4000mah
扫码模块-CY-SCAN01
OLED屏幕
按钮 x 2
电机防尘罩 x 4
导轨-MGN7C-200mm
雷达伸缩齿条-200mm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
