Fawziya25/AGV_Project/(list of files, cad)

Other CAD files:
机械建模/打印件/右物料夹爪.SLDPRT
机械建模/打印件/夹爪连接板.SLDPRT
