Fawziya25/AGV_Project/电控代码/Core/Src/main.c

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
/* Includes ------------------------------------------------------------------*/
#include "main.h"
#include "can.h"
#include "dma.h"
#include "tim.h"
#include "usart.h"
#include "gpio.h"

/* USER CODE BEGIN Includes */
#include "task.h"
#include "test.h"
#include "QRcode.h"
/* USER CODE END Includes */


void SystemClock_Config(void);
/**
  * @brief  The application entry point.
  * @retval int
  */
int main(void)
{

  /* MCU Configuration--------------------------------------------------------*/

  /* Reset of all peripherals, Initializes the Flash interface and the Systick. */
  HAL_Init();

  /* Configure the system clock */
  SystemClock_Config();

  /* Initialize all configured peripherals */
  MX_GPIO_Init();
  MX_DMA_Init();
  MX_CAN1_Init();
  MX_TIM7_Init();
  MX_UART5_Init();
  MX_USART1_UART_Init();
  MX_USART2_UART_Init();
  MX_TIM1_Init();
  MX_TIM2_Init();
  MX_TIM3_Init();
  MX_TIM4_Init();
  MX_UART4_Init();
  MX_USART3_UART_Init();
  /* USER CODE BEGIN 2 */
  AGV_QRcode_Init();  /* 扫码模块一直开着：开机就开中断收码，
                         免得码在 QRcode_Task() 之前发完被丢掉 */
  Test_Switch();/* 桌面测试：TEST_MODE=0 时立刻返回；!=0 则跑对应测试并停住，
                   程序不会走到下一行的 AGV_Init()（模式表见 test.h） */
  AGV_Init();   /* 末尾阻塞在 menu_Init() 等A8启动，期间C6/C8切换路线 */

  /* USER CODE END 2 */

  /* Infinite loop */
  /* USER CODE BEGIN WHILE */

  while (1)
  {
    TaskProc();/*进行全部任务*/
    /* USER CODE END WHILE */

    /* USER CODE BEGIN 3 */
  }

  /* USER CODE END 3 */
}

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
