Fawziya25/AGV_Project/电控代码/HARDWARE/Inc/pick.h

#ifndef __PICK_H
#define __PICK_H

//====================== 角度z     高度z    半径r =====================
#define POS_START              ( 0.0f,  5.0f,    0.0f )   // 车运行前的位置
#define POS_RUN                ( 90.0f,  60.0f,   10.0f )   // 车移动时候位置

//====================== 车上放置位置 =====================
#define POS_CAR                ( 57.0f,  51.0f,   30.0f )   // 车上放置位置(Pick_RAW 三次抓取都放这一点)
#define PICK_TURN_ANG_A         30.0f
#define PICK_TURN_ANG_B        150.0f
#define PICK_TURN_ANG_C        270.0f

//====================== 原料区位置 =====================
#define POS_RAW_A              (195.0f, 80.0f,  160.0f )   // 原料区抓取位置左前
#define POS_RAW_B              (180.0f, 80.0f,    1.0f )   // 原料区抓取位置下
#define POS_RAW_C              (164.0f, 77.0f,  155.0f )   // 原料区抓取位置右前
#define POS_OBSERVE_RAW_A      (180.0f,  25.0f,    2.0f )   // 原料区抓取位置下 之抓取A位置
#define POS_OBSERVE_RAW_CENTER (180.0f,  5.0f,   95.0f )   // pick_plus时候的观察位置

//====================== 圆环放置位置 =====================
#define POS_1                  (POS_OBSERVE_RING_ANGLE + 40.5f, 160.0f,   68.0f )   // 圆环左边
#define POS_2                  (POS_OBSERVE_RING_ANGLE        , 160.0f,   22.0f )   // 圆环中间
#define POS_3                  (POS_OBSERVE_RING_ANGLE - 39.1f, 160.0f,   89.0f )   // 圆环右边
#define POS_1_HIGE             (POS_OBSERVE_RING_ANGLE + 40.5f, 160.0f,   75.8f )   // 圆环物块左边
#define POS_2_HIGE             (POS_OBSERVE_RING_ANGLE        , 160.0f,   25.0f )   // 圆环物块中间
#define POS_3_HIGE             (POS_OBSERVE_RING_ANGLE - 39.1f, 160.0f,   88.5f )   // 圆环物块右边
#define POS_OBSERVE_RING_LOW   (POS_OBSERVE_RING_ANGLE        , 140.0f,   18.0f )   // 观察圆环位置 细修正时候
#define POS_OBSERVE_RING_MIDDLE (POS_OBSERVE_RING_ANGLE       ,  80.0f,   18.0f )   // 观察暂存区上 料块位置
#define POS_OBSERVE_RING_HIGH  (POS_OBSERVE_RING_ANGLE        ,  55.0f,   18.0f )   // 观察三个圆环 粗修正的时候对角度修正的时候使用

//====================== 夹爪舵机角度 =====================
#define PICK_OBSERVE            10.0f   /* 张开观察 */
#define PICK_GRAB              110.0f   /* 抓住物料 */
#define PICK_RELEASE            70.0f   /* 放开物料 */

//====================== 细修正时观测角度 =====================
#define POS_OBSERVE_RING_ANGLE 181.5f

// 基础值修正
#define SERVO_Z_BASE_OFFSET      6.0f   /* Z轴旋转舵机基础修正(°) */
#define SERVO_GRIP_BASE_OFFSET   0.0f   /* 夹爪舵机基础修正(°) */


#include <stdint.h>
#include "positionPIDcontroller.h"
#include "camera.h"
#include "QRcode.h"
#include "chassis.h"
#include "usart.h"
#include "main.h"
#include <stdio.h>
#include <stdlib.h>



/**********************************************************
 * 物料抓取模块（pick）
 * 当前版本：控制 3 舵机(Z轴旋转 / 夹爪 / 车上转盘) + 2 步进电机完成取放动作。
 * 依赖：servo（PWM 舵机）、Emm_V5（CAN 步进电机，与四轮同协议）
 **********************************************************/

/* 模块初始化（在 AGV_Init 中调用一次） */
void Pick_Init(void);

/* 非阻塞选槽：把转动命令交给舵机状态机后**立刻返回**，转盘在后台转。
   slot 0=A(30°) / 1=B(150°) / 2=C(270°)，越界按 A 处理。
   正常流程**不需要等**：紧跟着的 Pick_JumpTo POS_CAR 是 Π 形抬升，耗时数秒，
   远长于一个槽 120° 约 1s 的行程；转盘转动的整个过程臂都不在车体上方。
   Pick_TurnTable_IsBusy() 仍可查询，Pick_TurnTable_Wait() 只在测试/特殊场合
   需要强制同步时才调，正式流程里没有它。 */
void Pick_TurnTable_Set(uint8_t slot);
uint8_t Pick_TurnTable_IsBusy(void);
void Pick_TurnTable_Wait(void);

/* 基本动作（两版，按"路上有没有障碍"选）。**两轴都走绝对位置模式(raF=1)**：

   Pick_JumpTo —— 门字形(Π形)：先升到 PICK_SAFE_HEIGHT_MM 再转向+走半径，最后降高度。
                  慢，但臂是抬起来跨过去的，路上有料台/已放物料也能安全通过。默认用这个。

   Pick_MoveTo —— 直接到位：不抬升，贴着当前高度直接转向+走半径，最后改高度。
                  快，但中间有东西就会蹭到。只用在起终点之间确实空的情况。

   servoZ: Z舵机 0~270°(2026-10-14 由 360° 改，换舵机了); motorZ_mm/motorR_mm:
           高度/半径(mm)，越界自动钳位。
   ⚠ 量程一改，**下面 POS_* 那批宏的第一个值(角度z)全都指向了新的物理位置**：
     数值没变，但同样的命令角现在物理转得更远（5.56 → 7.41us/°）。正式跑之前
     每个姿态都要重新对一遍位。
   两版都不控制夹爪，由调用方按需开合。

   绝对位置的使用前提：上电前把高度/半径两轴人工放在 0 位；Pick_Axis_Init() 会把
   该位置写成驱动器绝对零点（入口第一次动作时会自动补调）。
     - 绝对目标幂等：丢一帧/超时一次不会让后续"该走多少"算错；
     - 高度轴失败时先清堵转保护(0x0E)并重新使能，再降速重试一次，不会一直卡在限位；
     - 半径轴不回到位帧，只发绝对目标不等回执，下一趟重发同一目标自动纠回；
     - 安全高度那一步失败会中止本次动作，不在未知高度继续转向/走半径。
   ⚠ 若上电时臂不在 0 位，绝对坐标会整体偏移 —— 这是唯一约束。 */
void Pick_JumpTo(float servoZ, float motorZ_mm, float motorR_mm);
void Pick_MoveTo(float servoZ, float motorZ_mm, float motorR_mm);

/* 步进电机两轴驱动器初始化：建立 Z/R 绝对零点，清堵转保护，重新使能。
   **必须在 AGV_Can_Init() 之后调用**（内部要发 CAN 命令）。
   零点来源见 pick.c 的 PICK_AXIS_AUTO_HOME：
     0(默认) = 上电前人工放 0 位，发 0x0A 把该位置设为 0mm；
     1       = 两轴分别做多圈无限位碰撞回零(0x9A 模式2)，机械限位即 0mm。
   正常流程里 Pick_* 第一次动作会自动补调一次；task.c 里显式调用是为了把时序写明。 */
void Pick_Axis_Init(void);

/* 诊断计数：调试器 watch / OLED 用，不参与控制。只在 Z 轴动作后更新。
   判读：LastStatus=1 正常；=2 驱动器 0xE2 拒收；=0 等到位超时；=3 位置未知（读不回）。 */
extern volatile uint32_t Pick_Diag_TimeoutCnt;   /* 超时次数 */
extern volatile uint32_t Pick_Diag_RejectCnt;    /* 0xFD 0xE2 次数 */
extern volatile uint8_t  Pick_Diag_LastStatus;   /* 最近一次 Z 动作结果 */
extern volatile int32_t  Pick_Diag_LastCpos;     /* 最近一次读回的 Z 位置(脉冲) */



void Pick_Test_Transfer(void);



/* 夹爪控制 —— 每种动作两版，按需选用：
   Pick_Gripper_*       : 平滑分步转动（慢，起步/收尾加减速，冲击小）
   Pick_Gripper_Quick_* : 直接设角一步到位（快，起步即全速）
   两版都不额外等待；需要停顿由调用方自己加。 */
void Pick_Gripper_Grab(void);
void Pick_Gripper_Release(void);
void Pick_Gripper_Observe(void);

void Pick_Gripper_Quick_Grab(void);
void Pick_Gripper_Quick_Release(void);
void Pick_Gripper_Quick_Observe(void);

/* 逐个模块测试（桌面调试，均为死循环） */
void Pick_Test_ZServo(void);    /* Z舵机: 0°/100°/50° 循环，每处停 3s（纯舵机，不走 CAN）*/
void Pick_Test_Gripper(void);   /* 夹爪: 观察/抓紧/放开 走 3 轮，停在抓紧（纯舵机，不走 CAN；
                                   三个角度见上面 PICK_OBSERVE/GRAB/RELEASE，别抄死数）*/
void Pick_Test_MotorZ(void);    /* 高度电机: 0 <-> 30mm 往返，每处停 3s（测方向和比例用）*/
void Pick_Test_MotorR(void);    /* 半径电机: 0 <-> 30mm 往返，每处停 3s（只发不等）*/
void Pick_Test_TurnTable(void); /* 转盘舵机: A(30°)/B(150°)/C(270°) 循环，每处停 3s（纯舵机，不走 CAN）*/

/* 老的桌面调试入口：一段写死的取放动作(POS_RAW_A → POS_1 → POS_3)，
   **全工程没人调用**，--gc-sections 会连函数带符号一起收掉。
   （原来的注释写"当前指向 Pick_Test_ZServo"，其实它没调任何测试函数，是错的。）
   留着的唯一用处是当写死的动作序列参考；真要桌面调参请用上面那批 Pick_Test_*。 */
void Pick_DebugTest(void);

#endif
