Fawziya25/AGV_Project/电控代码/UserCode/Src/chassis.c

#include "chassis.h"
#include "Emm_V5.h"
#include "delay.h"
#include "radar_config.h"   /* RADAR_ZONE_DEFAULT：上电先按哪个启停区摆 */
#include "radar_task.h"
#include "stm32f4xx_hal.h"
#include "yawPIDcontroller.h"
#include <stdint.h>
#include <stdlib.h>

/* 小车当前坐标(mm)，上电记作原点；每次 AGV_Position_Go() 走完自动锚定到目标点 */
uint16_t AGV_Position_X;
uint16_t AGV_Position_Y;

/* 当前启停区 1/2：AGV_Position_ApplyZone() 更新，AGV_Position_Depart() 用它选首点 */
static uint8_t AGV_Zone = 2U;

uint16_t Points_X[25];
uint16_t Points_Y[25];

/**
 * @brief 按启停区设定小车初始坐标与车头朝向
 * @param zone 启停区 1/2；其它值一律按区2（与 RADAR_ZONE_DEFAULT 一致）
 * @note  只动"车在哪、朝哪"，雷达那边的选区/位姿由 Radar_SetZone() 管；
 *        两区各自的坐标/朝向宏在 chassis.h 的 AGV_ZONEn_ORIGIN_*。
 */
void AGV_Position_ApplyZone(uint8_t zone)
{
	if(zone == 1U)
	{
		AGV_Zone       = 1U;
		AGV_Position_X = AGV_ZONE1_ORIGIN_X;
		AGV_Position_Y = AGV_ZONE1_ORIGIN_Y;
		AGV_Direction  = (uint8_t)(AGV_ZONE1_ORIGIN_DIR & 3U);
	}
	else
	{
		AGV_Zone       = 2U;
		AGV_Position_X = AGV_ZONE2_ORIGIN_X;
		AGV_Position_Y = AGV_ZONE2_ORIGIN_Y;
		AGV_Direction  = (uint8_t)(AGV_ZONE2_ORIGIN_DIR & 3U);
	}
}

void AGV_Position_Init(void)
{
	// 所有拐点坐标(mm)
	Points_X[0] = 310;
	Points_Y[0] = 2090;
	// 2: QRCode
	Points_X[2] = 310;
	Points_Y[2] = 1200;
	Points_X[4] = 310;
	Points_Y[4] = 310;
	// 10: Rough
	Points_X[10] = 1200;
	Points_Y[10] = 2090;
	Points_X[12] = 1200;
	Points_Y[12] = 1200;
	// 14：Raw
	Points_X[14] = 1200;
	Points_Y[14] = 310;
	Points_X[20] = 2090;
	Points_Y[20] = 2090;
	// 22: Temp
	Points_X[22] = 2090;
	Points_Y[22] = 1200;
	Points_X[24] = 2090;
	Points_Y[24] = 310;

	/* 小车初始坐标/朝向跟着启停区走，两区各有一套（chassis.h 的 AGV_ZONEn_ORIGIN_*）。
	   这里先按默认区摆好；菜单里选了别的区会再由 AGV_Position_ApplyZone() 覆盖。 */
	AGV_Position_ApplyZone((uint8_t)RADAR_ZONE_DEFAULT);
}

/**
 * @brief 直行
 * 
 * @param distance 距离
 * @param vel 速度
 * @param dir 方向
 * 0：向后移动
 * 1：向前移动
 */
void AGV_Position_GoStraight(uint32_t distance, uint16_t vel, uint8_t dir)
{
	float n = distance/235.62;  // 轮子周长
	uint32_t p = (uint32_t)(n*3200);
	dir^=1;
	Emm_V5_ClearRxFrame();						// 清历史回帧：后面等的是本次动作新到的到位帧
	Emm_V5_Pos_Control(1, Wheel1PositiveDir^dir, vel, AGV_ACC_POS, p, 2, 1); // 多机同步标志位置1
		HAL_Delay(1);																 // 每条命令后面延时10毫秒，防止粘包，CAN通讯速率调到1MHz，可以缩短至几十微秒即可

	Emm_V5_Pos_Control(2, Wheel2PositiveDir^dir, vel, AGV_ACC_POS, p, 2, 1); // 多机同步标志位置1
		HAL_Delay(1);																 // 每条命令后面延时10毫秒，防止粘包，CAN通讯速率调到1MHz，可以缩短至几十微秒即可

	Emm_V5_Pos_Control(3, Wheel3PositiveDir^dir, vel, AGV_ACC_POS, p, 2, 1); // 多机同步标志位置1
		HAL_Delay(1);																 // 每条命令后面延时10毫秒，防止粘包，CAN通讯速率调到1MHz，可以缩短至几十微秒即可

	Emm_V5_Pos_Control(4, Wheel4PositiveDir^dir, vel, AGV_ACC_POS, p, 2, 1); // 多机同步标志位置1
		HAL_Delay(1);																 // 每条命令后面延时10毫秒，防止粘包，CAN通讯速率调到1MHz，可以缩短至几十微秒即可

	Emm_V5_Synchronous_motion(0); 								 // 广播地址0触发
	HAL_Delay(1);																 // 每条命令后面延时10毫秒，防止粘包，CAN通讯速率调到1MHz，可以缩短至几十微秒即可

	Emm_V5_WaitArrive(EMM_V5_ARRIVE_TMO_MS);		// 等电机到位回帧(0xFD 0x9F)，超时兜底不卡死

	HAL_Delay(200);
}

/**
 * @brief 平移移动
 * 
 * @param distance 距离
 * @param vel 速度
 * @param dir 方向
 * 0：向右移动
 * 1：向左移动
 */
void AGV_Position_Translate(uint32_t distance, uint16_t vel, uint8_t dir)
{
	float n = distance/235.62;  // 轮子周长
	uint32_t p = (uint32_t)(n*3200);

	Emm_V5_ClearRxFrame();						// 清历史回帧：后面等的是本次动作新到的到位帧
	Emm_V5_Pos_Control(1, Wheel1PositiveDir^dir, vel, AGV_ACC_POS, p, 2, 1); // 多机同步标志位置1
		HAL_Delay(1);																 // 每条命令后面延时10毫秒，防止粘包，CAN通讯速率调到1MHz，可以缩短至几十微秒即可

	Emm_V5_Pos_Control(4, Wheel2PositiveDir^dir, vel, AGV_ACC_POS, p, 2, 1); // 多机同步标志位置1
		HAL_Delay(1);																 // 每条命令后面延时10毫秒，防止粘包，CAN通讯速率调到1MHz，可以缩短至几十微秒即可

	Emm_V5_Pos_Control(2, Wheel3PositiveDir^dir^1, vel, AGV_ACC_POS, p, 2, 1); // 多机同步标志位置1
		HAL_Delay(1);																 // 每条命令后面延时10毫秒，防止粘包，CAN通讯速率调到1MHz，可以缩短至几十微秒即可

	Emm_V5_Pos_Control(3, Wheel4PositiveDir^dir^1, vel, AGV_ACC_POS, p, 2, 1); // 多机同步标志位置1
		HAL_Delay(1);																 // 每条命令后面延时10毫秒，防止粘包，CAN通讯速率调到1MHz，可以缩短至几十微秒即可

	Emm_V5_Synchronous_motion(0); 								 // 广播地址0触发
	HAL_Delay(1);																 // 每条命令后面延时10毫秒，防止粘包，CAN通讯速率调到1MHz，可以缩短至几十微秒即可

	Emm_V5_WaitArrive(EMM_V5_ARRIVE_TMO_MS);		// 等电机到位回帧(0xFD 0x9F)，超时兜底不卡死

	HAL_Delay(200);
}

/**
 * @brief 重新锚定小车位置
 *
 * @param x X坐标
 * @param y Y坐标
 */
void AGV_Position_Set(uint16_t x, uint16_t y)
{
	AGV_Position_X = x;
	AGV_Position_Y = y;
}

/**
 * @brief 移动到目标位置
 *
 * @param x 目标X坐标
 * @param y 目标Y坐标
 * @param priDir 优先方向 0:X, 1:Y
 */
void AGV_Position_Go(uint16_t x, uint16_t y, uint8_t priDir)
{
	int32_t sdx = (int32_t)x - (int32_t)AGV_Position_X;
	int32_t sdy = (int32_t)y - (int32_t)AGV_Position_Y;
	uint16_t dx = (sdx < 0) ? (uint16_t)(-sdx) : (uint16_t)sdx;
	uint16_t dy = (sdy < 0) ? (uint16_t)(-sdy) : (uint16_t)sdy;
	uint8_t x_flag = (sdx >= 0) ? 1 : 0;
	uint8_t y_flag = (sdy >= 0) ? 1 : 0;
	Yaw_MovingOffsetStart();
	// X方向先行
	if(priDir == 0)
	{
		if(AGV_Direction == 0)
		{
			AGV_Position_GoStraight(dx, Vel, x_flag);
			AGV_Position_Translate(dy, Vel, y_flag);
		}
		else if(AGV_Direction == 1)
		{
			AGV_Position_Translate(dx, Vel, x_flag^1);
			AGV_Position_GoStraight(dy, Vel, y_flag);
		}
		else if (AGV_Direction == 2)
		{
			AGV_Position_GoStraight(dx, Vel, x_flag^1);
			AGV_Position_Translate(dy, Vel, y_flag^1);
		}
		else if (AGV_Direction == 3)
		{
			AGV_Position_Translate(dx, Vel, x_flag);
			AGV_Position_GoStraight(dy, Vel, y_flag^1);
		}
	}
	// Y方向先行
	else if(priDir == 1)
	{
		if(AGV_Direction == 0)
		{
			AGV_Position_Translate(dy, Vel, y_flag);
			AGV_Position_GoStraight(dx, Vel, x_flag);
		}
		else if(AGV_Direction == 1)
		{
			AGV_Position_GoStraight(dy, Vel, y_flag);
			AGV_Position_Translate(dx, Vel, x_flag^1);
		}
		else if (AGV_Direction == 2)
		{
			AGV_Position_Translate(dy, Vel, y_flag^1);
			AGV_Position_GoStraight(dx, Vel, x_flag^1);
		}
		else if (AGV_Direction == 3)
		{
			AGV_Position_GoStraight(dy, Vel, y_flag^1);
			AGV_Position_Translate(dx, Vel, x_flag);
		}
	}
	Yaw_MovingOffsetEnd();
	// 重新锚定小车位置
	AGV_Position_Set(x, y);
}

void AGV_Position_Rotate(uint8_t dir)
{
	if(dir == 0)
	{
		Emm_V5_Vel_Control(1, 0, 40, AGV_ACC_VEL, 1);
		HAL_Delay(10);
		Emm_V5_Vel_Control(2, 0, 40, AGV_ACC_VEL, 1);
		HAL_Delay(10);
		Emm_V5_Vel_Control(3, 0, 40, AGV_ACC_VEL, 1);
		HAL_Delay(10);
		Emm_V5_Vel_Control(4, 0, 40, AGV_ACC_VEL, 1);
		HAL_Delay(10);
	}
	else if(dir == 1)
	{
		Emm_V5_Vel_Control(1, 1, 40, AGV_ACC_VEL, 1);
		delay_us(250);
		Emm_V5_Vel_Control(2, 1, 40, AGV_ACC_VEL, 1);
		delay_us(250);
		Emm_V5_Vel_Control(3, 1, 40, AGV_ACC_VEL, 1);
		delay_us(250);
		Emm_V5_Vel_Control(4, 1, 40, AGV_ACC_VEL, 1);
		delay_us(250);
	}
	
	Emm_V5_Synchronous_motion(0); 								 // 广播地址0触发
	delay_us(250);		
	
	Emm_V5_WaitRxFrame(EMM_V5_ACK_TMO_MS);		// 等命令回帧(原为死等，加超时防卡死)
	
	HAL_Delay(1910);
	
	Emm_V5_Stop_Now(1, 1);
	delay_us(250);
	Emm_V5_Stop_Now(2, 1);
	delay_us(250);
	Emm_V5_Stop_Now(3, 1);
	delay_us(250);
	Emm_V5_Stop_Now(4, 1);
	delay_us(250);
	
	Emm_V5_Synchronous_motion(0); 								 // 广播地址0触发
	delay_us(250);	
	
	Emm_V5_WaitRxFrame(EMM_V5_ACK_TMO_MS);   /* 等命令回帧(原为死等，加超时防卡死) */
}

void AGV_Position_Cruise(uint8_t RouteID, uint8_t tarDir)
{
	/* tarDir = 该段走完后的绝对朝向：0:X+ 1:Y+ 2:X- 3:Y-。
	   先归一化（4 当 0）：旧写法传 4 会一路传到 AGV_Turn()，而它只认 0~3，
	   非法值在那里会落到"没有任何分支命中" → 该转的时候不转。 */
	tarDir &= 3U;

	for(uint8_t i = 0; i < Radar_Path[RouteID].count; i++)
	{
		uint16_t tarX = Points_X[Radar_Path[RouteID].points[i]];
		uint16_t tarY = Points_Y[Radar_Path[RouteID].points[i]];
		if(abs(tarX - AGV_Position_X) >= abs(tarY - AGV_Position_Y))
		{
			if(AGV_Direction == 1 || AGV_Direction == 3)
			{
				/* 车头朝 ±Y、本段要改走 X：在 X+/X- 里选【离最终朝向 tarDir 更近】的那个。
				   原写法 abs(tarDir-2) >= abs(tarDir-4) + AGV_Turn(4) 有两个错：
				   ① tarDir=0（要朝 X+）时条件为假 → 选成 X-(反着走)；
				   ② 4 不是合法方向值（AGV_Turn 只认 0~3）。现已改成 0。 */
				if(abs((int)tarDir - 2) >= abs((int)tarDir - 0))AGV_Turn(0);
				else AGV_Turn(2);
			}
		}
		else 
		{
			if(AGV_Direction == 0 || AGV_Direction == 2)
			{
				/* 同理：车头朝 ±X、要改走 Y 时，在 Y+/Y- 里选离 tarDir 更近的。
				   这条原本就是对的，只补注释/显式 int 转换，逻辑不动。 */
				if(abs((int)tarDir - 1) >= abs((int)tarDir - 3))AGV_Turn(3);
				else AGV_Turn(1);
			}
		}
		AGV_Position_Go(tarX, tarY, 0);
	}
	if(RouteID != 5) AGV_Turn(tarDir);
}

/**
 * @brief 出发：先对齐到本启停区的停车位格，再交给雷达规划的第一段
 * @note  首点按启停区取（区1 = Points[4] 左下角、区2 = Points[0] 左上角，见
 *        chassis.h 的 AGV_ZONEn_DEPART_GRID）；它必须和 radar_config.h 里该区的
 *        RADAR_ZONEn_START_GRID 是同一格，否则"先开到出发点"和"规划从哪格出发"会打架。
 */
void AGV_Position_Depart()
{
	uint8_t g = (AGV_Zone == 1U) ? (uint8_t)AGV_ZONE1_DEPART_GRID
	                             : (uint8_t)AGV_ZONE2_DEPART_GRID;

	AGV_Position_Go(Points_X[g], Points_Y[g], 0);
	AGV_Position_Cruise(0, 3);
}

void AGV_Position_Qcode_to_Raw()
{
	// AGV_Position_Go(Waypoint_LB, 0);
	// AGV_TurnLeft();
	// AGV_Position_Go(Raw, 0);
	AGV_Position_Cruise(1, 0);
	AGV_Position_Translate(50, Vel, 0);
}

void AGV_Position_Raw_to_Rough()
{
	AGV_Position_Translate(50, Vel, 1);
	// AGV_Position_Go(Raw_Depart, 0);
	// AGV_TurnRight();
	// AGV_Position_Go(Rough, 0);
	// AGV_TurnRight();
	AGV_Position_Cruise(2, 2);
	AGV_Position_Translate(20, Vel, 0);
}

void AGV_Position_Rough_to_Temp()
{
	AGV_Position_Translate(50, Vel, 1);
	// AGV_Position_Go(Waypoint_RF, 0);
    // AGV_TurnRight();
	// AGV_Position_Go(Temp, 0);
	AGV_Position_Cruise(3, 1);
	AGV_Position_Translate(20, Vel, 0);
}

void AGV_Position_Temp_to_Raw()
{
	AGV_Position_Translate(50, Vel, 1);
	// AGV_Position_Go(Waypoint_RB, 0);
    // AGV_TurnRight();
	// AGV_Position_Go(Raw, 0);
	AGV_Position_Cruise(4, 0);
	AGV_Position_Translate(50, Vel, 0);
}

/**
 * @brief 回到原点：走完雷达第 6 段后，再收回到**本启停区**的停车点
 * @note  末点原来写死 (150, 2250)（区2 的停车位），区1 会被拉回区2 的位置；
 *        现按 AGV_Zone 取本区停车坐标（chassis.h 的 AGV_ZONEn_ORIGIN_*）。
 */
void AGV_Position_GoBack()
{
	uint16_t ox = (AGV_Zone == 1U) ? (uint16_t)AGV_ZONE1_ORIGIN_X : (uint16_t)AGV_ZONE2_ORIGIN_X;
	uint16_t oy = (AGV_Zone == 1U) ? (uint16_t)AGV_ZONE1_ORIGIN_Y : (uint16_t)AGV_ZONE2_ORIGIN_Y;

	AGV_Position_Translate(50, Vel, 1);
	// AGV_Position_Go(Waypoint_RF, 0);
	// AGV_TurnRight();
	// AGV_Position_Go(Destination, 0);
	AGV_Position_Cruise(5, 3);
	AGV_Position_Go(ox, oy, 0);
}
