Fawziya25/AGV_Project/电控代码/UserCode/Inc/pick_task.h

/**
 * @file pick_task.h
 * @brief 物料取放任务阶段：视觉闭环修正 + 各阶段取放动作
 * @note  颜色数组定义在 QRcode.c；RerunFlag 定义在 task.c
 */

#ifndef __PICK_TASK_H
#define __PICK_TASK_H

#include <stdint.h>
#include <stdio.h>
#include <stdlib.h>
#include "main.h"
#include "pick.h"
#include "camera.h"

/* ========================== 辅助宏定义 ========================== */

/* 视觉交互统一由 camera.h 的 Cam_SwitchTo(mode) 承担 —— 一条命令一个模式号，
   没有出参，结果读全局量 dx/dy、box_color[]、cam_flag。不再用宏。
   mode 直接写命令码的八进制字面量：01 任务码 / 02 最近物块 / 03 三框颜色 /
   04 圆环 / 05 指定颜色。 */

/* 下面这些宏一律用 Pick_JumpTo（两轴绝对位置）。前提：上电前高度/半径
   两轴人工放在 0 位，Pick_Axis_Init() 会把该位置写成驱动器绝对零点。
   pick.c 里已没有相对位置版本，所有动作都依赖这个零点。 */

/** 移动到普通圆环位置 */
#define MOVE_TO_RING(ring) \
    do { \
        if ((ring) == 1) Pick_JumpTo POS_1; \
        else if ((ring) == 2) Pick_JumpTo POS_2; \
        else if ((ring) == 3) Pick_JumpTo POS_3; \
    } while(0)

/** 移动到高位圆环位置 */
#define MOVE_TO_RING_HIGH(ring) \
    do { \
        if ((ring) == 1) Pick_JumpTo POS_1_HIGE; \
        else if ((ring) == 2) Pick_JumpTo POS_2_HIGE; \
        else if ((ring) == 3) Pick_JumpTo POS_3_HIGE; \
    } while(0)

/* 槽位约定：车上是「同一个臂位姿 POS_CAR + 转盘转角」，不是三个臂位姿。
   slot 0/1/2 = A/B/C 槽 = 转盘 30°/150°/270°，由 Pick_TurnTable_Set(slot) 选。
   Set 是**非阻塞**的：发完转动命令立刻返回，转盘在后台转，流程不等它。
   下面的宏也都不等待；靠随后的 Pick_JumpTo POS_CAR（Π 形抬升，耗时数秒）
   覆盖 120° 约 1s 的换槽行程。真要强制同步时再单独调 Pick_TurnTable_Wait()。 */

/** 从车上 slot 槽抓取并放置到圆环 */
#define GRAB_AND_PLACE_TO_RING_SLOT(slot, ring) \
    do { \
        Pick_TurnTable_Set(slot); \
        Pick_JumpTo POS_CAR; \
        Pick_Gripper_Grab(); \
        MOVE_TO_RING(ring); \
        Pick_Gripper_Release(); \
    } while(0)

/** 从车上 slot 槽抓取并放置到圆环（支持高位） */
#define GRAB_AND_PLACE_TO_RING_SLOT_EX(slot, ring, is_high) \
    do { \
        Pick_TurnTable_Set(slot); \
        Pick_JumpTo POS_CAR; \
        Pick_Gripper_Grab(); \
        if (is_high) { MOVE_TO_RING_HIGH(ring); } \
        else { MOVE_TO_RING(ring); } \
        Pick_Gripper_Release(); \
    } while(0)

/** 从圆环抓取并放置到车上 slot 槽 */
#define GRAB_FROM_RING_AND_PLACE_SLOT(ring, slot) \
    do { \
        MOVE_TO_RING(ring); \
        Pick_Gripper_Grab(); \
        Pick_TurnTable_Set(slot); \
        Pick_JumpTo POS_CAR; \
        Pick_Gripper_Release(); \
    } while(0)

/* ========================== 函数声明 ========================== */

/* 槽位约定(slot)：0=A 槽, 1=B 槽, 2=C 槽，与 Place_Color[]/Pick_Color[] 下标一致
   圆环约定(ring)：1/2/3                                             */

/* 原料区取料前的视觉对正：摆 POS_RAW_B → 开爪 → 0x02 拿偏差 → AGV_Correct(5000) → 收爪。
   拿不到偏差就不修正（免得用旧 dx/dy 把车带偏）。由 task.c 的 case Pick1 在
   Pick_RAW / Pick_RAW_PLUS 之前调用一次，那两个函数自己不再做这一步。 */
void Pick_Correct(void);

/* 原料区取料（当前路线）：摆 POS_RAW_B、开爪，反复发 0x02 直到相机报回来的颜色号
   等于任务码当前要抓的那一色（flag 即颜色号 1~6），才下手抓到车上对应槽。
   严格按任务码顺序 i=0/1/2，不匹配就一直等（无超时）。 */
void Pick_RAW(void);

/* 原料区三个抓取位各自的完整取料动作：抓一块 → 放到车上第 slot 槽。
   A/C 位比 B 位远，函数内部会先沿车头方向挪底盘 3cm 再抓、放完再挪回来；
   B 位底盘不动。拆成三个是因为三处以后可能各自加不同动作（现在 C 是 A 的镜像）。 */
void Pick_RAW_A(uint8_t slot);
void Pick_RAW_B(uint8_t slot);
void Pick_RAW_C(uint8_t slot);

/* 六种抓取顺序中，相邻两次 Raw_PickAt 的目标起始间隔（毫秒）。 */
#define PICK_RAW_PLUS_GRAB_INTERVAL_MS 7200U

/* Fast 分派开关（编译期）：
     0 = Pick_RAW_PLUS 走普通六种（每两块之间都按上面的间隔等）
     1 = Pick_RAW_PLUS 走 Fast 六种（第 2→3 块之间不等，第 3 块换框）
   Fast 版第 1→2 块的间隔同样沿用 PICK_RAW_PLUS_GRAB_INTERVAL_MS，没有独立宏。 */
#define PICK_RAW_PLUS_USE_FAST 0

/* 原料区取料（备用路线）：摆 POS_OBSERVE_RAW_CENTER 读一次三框颜色(0x03)，
   记下任务码第 0/1/2 色开局各落在哪个框，再按这个排列查表分派给下面六个函数。
   六种路线均使用 PICK_RAW_PLUS_GRAB_INTERVAL_MS；修改上面的宏即可统一调整。
   切换方法见 pick_task.c 里它的注释。 */
void Pick_RAW_PLUS(void);

/* 六种固定抓取路线。⚠ **名称 = 开局观测到的初始排列**（任务码第 0/1/2 色分别
   落在 A/B/C 哪一格），不是三次抓取实际去的框；三个槽固定按 0→1→2 依次放。
   抓取过程中**底盘完全不动**，每条只调三次臂 + 转盘动作。
   实际抓哪个框由转盘每抓一块挪一格（索引 −1）推出来：
     观测 ABC → 抓 A A A      观测 ACB → 抓 A B C      观测 BAC → 抓 B C A
     观测 BCA → 抓 B B B      观测 CAB → 抓 C C C      观测 CBA → 抓 C A B
   相邻两次 Raw_PickAt 的开始时间按宏值控制；若前次动作耗时已超过该值，
   下一次会在前次完成后立即开始。一般由 Pick_RAW_PLUS 分派，不用直接调。 */
void Pick_RAW_ABC(void);
void Pick_RAW_ACB(void);
void Pick_RAW_BAC(void);
void Pick_RAW_BCA(void);
void Pick_RAW_CAB(void);
void Pick_RAW_CBA(void);

/* 六种快速抓取路线（Fast 版）。**名称同样 = 开局观测到的初始排列**，与上面六个
   一一对应；差别只有两点：
     1) 第 3 块去哪个框不同（第 1、2 块与普通版相同）：
          观测 ABC → 抓 A A B      观测 ACB → 抓 A B A      观测 BAC → 抓 B C B
          观测 BCA → 抓 B B C      观测 CAB → 抓 C C A      观测 CBA → 抓 C A C
     2) **第 2 块与第 3 块之间不等待**，第 2 块动作一结束立刻抓第 3 块。
   第 1 块与第 2 块之间仍按 PICK_RAW_PLUS_GRAB_INTERVAL_MS 固定间隔走，口径与普通版
   一致（从第 1 块**开始**时刻算起，不足就补足差额）。
   由 Pick_RAW_PLUS 按 PICK_RAW_PLUS_USE_FAST 开关分派。 */
void Pick_RAW_ABC_Fast(void);
void Pick_RAW_ACB_Fast(void);
void Pick_RAW_BAC_Fast(void);
void Pick_RAW_BCA_Fast(void);
void Pick_RAW_CAB_Fast(void);
void Pick_RAW_CBA_Fast(void);

/* 粗加工区放置前的视觉对正，拆成三步，固定顺序 High → Angle → Low → Place_ROUGH()：

   Place_Correct_High()  摆高位观察位 POS_OBSERVE_RING_HIGH → 开爪 → 0x04 圆环2
                         粗修正(1s)。**不收爪**，留给后面的角度步继续用同一个位姿。
   Place_Correct_Angle() 沿车头方向挪 7cm（三个圆环在视野里排得更开，角度更准）
                         → 0x06 角度闭环（反复读数 + SetYaw，进死区为止）
                         → 记基准航向 a1 → 退回原位 → 航向复位 a1。
   Place_Correct_Low()   摆低位观察位 POS_OBSERVE_RING_LOW → 开爪 → 0x04 细修正(30s)
                         → 收爪。

   拿不到视觉结果就跳过对应那一段（免得用旧 dx/dy/cam_angle 把车带偏）。
   Place_ROUGH 自己不做这一步。Place_Correct_Low 也可以单独调（第二轮暂存区那条路）。
   角度符号(`PLACE_CORRECT_ANGLE_SGN`)与相机约定有关，实车越修越歪就取反。 */
void Place_Correct_High(void);
void Place_Correct_Angle(void);
void Place_Correct_Low(void);

/* 粗加工区放置（不含视觉修正，那一步在 Place_Correct_* 里）：把车上三个槽
   依次放到二维码给的圆环上。 */
void Place_ROUGH(void);
void Pick_ROUGH(void);
void Place_TEMP(void);
/* 暂存区放置前的视觉对正【第二轮】：摆 POS_OBSERVE_RING_MIDDLE → 开爪 → 0x05 指定颜色 → AGV_Correct(5000) → 收爪。
   第一轮别调它 —— 第一轮的观察位和粗加工区同一处，复用 Place_Correct_Low()。
   task.c 的 case Place2 按 RerunFlag 二选一。 */
void Place_TEMP_Correct(void);

#endif /* __PICK_TASK_H */
