Fawziya25/AGV_Project/(commit log)

2026-09-13 电控代码上传
2026-09-13 补全项目结构
2026-09-13 代码更新
2026-10-14 机械建模上传
2026-10-14 建模更新
2026-10-14 更新电控代码
2026-10-14 新增雷达驱动代码
2026-10-16 更改雷达初始参数
2026-10-16 新增雷达测试程序
    testmode = 10时测试雷达扫描功能
2026-10-16 修改了原料区的抓取
2026-10-16 完善几个测试函数，test.c/h简化
2026-10-17 Qcode更新
2026-10-17 位置修正pid和原料区抓取
2026-10-17 新增避障功能
    新增雷达扫描避障功能及带避障的路径测试
2026-10-18 抓取和放置任务
2026-10-18 更新路径逻辑
    每段路径尽量避免横移
2026-10-19 修JumpTo函数卡死bug(未实测)
    从计算发送相对位置 改为直接给绝对位置，参考开源代码设计
    同时增加了上电后步进电机可以自己归0位置(开关未打开)
2026-10-19 改动记录补一下
2026-10-20 jumpto小修改
    超时上限减少让动作连续，超时后会继续完成全部动作
2026-10-22 新增place_correct_PLUS 位置预修正，和视觉角度修正
    pickplus增加了底盘往前移动
    place_correct_PLUS 位置预修正，和视觉角度修正
2026-10-26 Pick_raw_plus优化
2026-10-27 放置修正和抓取优化
2026-10-30 两个舵机设置初始偏差参数
2026-11-01 增加启停区选择
2026-11-08 更新夹取位置参数
2026-11-08 11.8参数更新
2026-11-10 Update & Debug
    1.增加圆盘抓物料时的固定时间间隔
    2.物料转盘改为非阻塞式
    3.提速
2026-11-11 11.11参数更新
    旋转加快，减小延时，半径加快
2026-11-11 圆盘后两个物料连续抓取
2026-11-12 增加不避障模式&参数更新
2026-11-14 参数更新
